Aerothon-2020/Reg2015Aircraft_Aerocats/Documents/Project Management/Design Requirements and Standards.docx

Operational Requirements

1. Take off time limit
  a. 180 seconds (3 min) to accomplish successful take off
  b. Multiple attempts allowed within time limit but aircraft must not become airborne during aborted attempt
2. Take off Zone
  a. Take off into wind
  b. Aircraft must remain on runway during takeoff roll
  c. Must become airborne within 200 ft
3. Competition circuit
  a. Aircraft must complete one 360 deg circuit of field
  b. Stay out of no-fly zones
  c. Fly past departure end of takeoff zone before turning 180 deg
  d. Fly past approach end of takeoff zone before turning 180 deg to begin landing
4. Landing
  a. Controlled return to ground inside landing zone
    i. Controlled rollout allowed
    ii. Controlled runoff allowed
  b. Must land and stop within 400ft

Design Requirements

1. No lighter than air or rotary wing aircraft
  a. Limited to fixed wing
  b. No lighter than air or rotary wing (helicopter/autogyro)
2. Aircraft Dimension Requirement
  a. In takeoff configuration, L+W+H ≤ 175
    i. Length – maximum distance from front to the aft of aircraft
    ii. Width – span or max distance from wingtip to wingtip
    iii. Height – max distance perpendicular to ground to highest part of aircraft (propeller not included)
  b. Gross weight ≤ 55 lbs with payload and fuel
3. Material restriction
  a. Use of fiber-reinforced plastic prohibited
  b. Use of lead is prohibited

System Requirements

1. Electric motor requirements
  a. No restrictions on make or model
  b. Only single motor configuration allowed (no multiple motors)
2. Gear boxes, drives, and shafts
  a. Allowed as long as propeller RPM:engine RPM = 1:1
  b. Prop must rotate at motor RPM
3. Aircraft batteries
  a. Must be commercially available LiPo
  b. Homemade battery not allowed
  c. 6 cell (22.2 volt) LiPo
  d. Must be at least 3000 mah
  e. Must be at least 25C
4. Power limiter
  a. Must use new 2015 1000 watt power limiter
5. Gyroscopic assist prohibited
6. Red arming plug
  a. Use red arming plug to arm and disarm system
  b. Must be in circuit between battery and ESC
  c. Must be physically located 40-60% of A/C length from propeller
  d. Must be located on top of fuselage
  e. Must be external of the A/C surface
7. Payload requirements
  a. Must consist of support assembly and payload plates
  b. All payload must be carried within payload bay
  c. Payload must be carried as homogeneous mass
  d. Payload must be secured to airframe
  e. Total payload consists of plates plus support assembly
  f. Payload bay must be a “closed” payload bay
    i. 4 sides, bottom, and top
    ii. Top can be hatch or wing once installed on A/C
  g. Bay must be fully enclosed within the fuselage
  h. A/C must be structurally airworthy with and without payload bay installed
  i. Payload bay must be removable
  j. “Closed” payload bay dimensions must be 4x4x10 in +1/8, -0
  k. Team must be able to load and secure payload in ≤ 1 min
  l. Team must be able to unload payload in ≤ 1 min
  m. Payload must not contribute to the structural integrity of airframe
  n. Bay must be secured to airframe within cargo bay to avoid shifting in flight
8. Ballast
  a. Ballast must not be located in payload bay
  b. Must be indicated on 2D drawings
  c. Ballast must be secured to avoid shifting in flight
9. General requirements
  a. Radio must be 2.4 GHz
  b. All aircraft must utilize either spinner or rounded safety nut (for prop)
  c. A/C control surfaces must not feature excessive slop
10. Servo sizing
  a. Analysis and/or testing of servos must be described in design report that demonstrates servos selected are adequately sized to handle expected aerodynamic loads during flight

Regular Class Scoring

FFS T Rn Bn Pp Pa | = = = = = = | Final Regular Class Flight Score Penalty Points Round Flight Score (Payload weight – lbs) Payload prediction bonus Payload prediction Actual payload carried

B_n =20-(P_p -P_a )^2

FFS=∑_1^n R_n -∑ T+B_(n (max))

Design Report Requirements

1. Must not exceed 30 pages
  a. Double-spaced
  b. Including appendices, cover page, table of contents, and payload prediction graph
  c. Does not include statement of compliance and 2D CAD drawings
2. Report Format
  a. Must be submitted electronically
  b. Font must be 12 pt proportional or a 10 character per inch non-proportional
  c. Margins must be 1” left, 0.5” right, top, and bottom
  d. All pages must be ANSI A (8.5”x11”) page format
  e. Design report must have cover page with team name, school, and team number (will be counted against 30 page limit)
  f. File must be in PDF format
3. Design Plans requirements (CAD)
  a. Must be ANSI B size (11”x17”)
  b. Must be PDF format
  c. Must be on one page
  d. Must have US-standard 3-view or 3rd order projection
    i. Right side view in lower left with nose pointing right
    ii. Top view above the right side view also with nose pointing right
    iii. Front view in lower right
  e. All A/C must have the required dimensions clearly marked and dimensioned on drawing
    i. Length
    ii. Width
    iii. Height
    iv. CG location
    v. Main wheel diameter
  f. All dimensions must be in inches and decimal inches to an appropriate level of precision (4 decimal places is too many)
  g. Plans must also include table with summary of pertinent A/C data
    i. Wingspan
    ii. Empty weight
    iii. Motor/engine make and model
  h. Plans must also include weight and balance table with a summary of pertinent A/C data
    i. Motor/engine
    ii. Battery
    iii. Payload
    iv. Ballast
    v. Location from datum in inches
    vi. Moment arm
    vii. Resultant moment of CG
  i. Must be marked on drawing
    i. A/C datum
    ii. Forward CG limit
    iii. Aft CG limit
    iv. Empty weight CG (weight and balance worksheet should correspond with static margins on 2D drawings)
  j. Plans must be marked with team name, school name, and team number
4. Payload prediction curve requirements
  a. Must be included with design report (counts against 30 page limit)
  b. One electronic copy of the payload prediction “EQUATION ONLY” must be provided on face of 2D drawing
  c. Page must be 8.5”x11” ANSI A in PDF format
  d. Must be marked with team name and school across top of the graph with team number marked in the bottom right corner
  e. Graph must include formula used to calculate the curve
  f. The curve must present the payload capacity of the A/C in pounds as a function of density altitude in feet

Technical Presentation

1. Each team must give 10 minute technical presentation of design (exceed 15 min = -5 points)
2. The presentation must be the same information provided in the design report in oral form
3. Must give detailed explanation of why A/C is best and how that conclusion was made
4. A/C must be present at the oral presentation
5. Must demonstrate capabilities to quickly load/secure and unload payload
6. Teams must provide a single sheet (8.5”x11”) marketing/promotion piece to further detail A/C feature, capabilities, and unique design attributes
