Aerothon-2020/Reg2015Aircraft_Aerocats/Controls/SnC_10-14-14.pptx

## Stability and Controls

10-14-14

## Aircraft Changes

- Wing moved back
- Htail NACA0012
- With S increased by 50 in²
  - Payload = 32 lbs
  - Ground roll < 200 ft
- CG within static margin

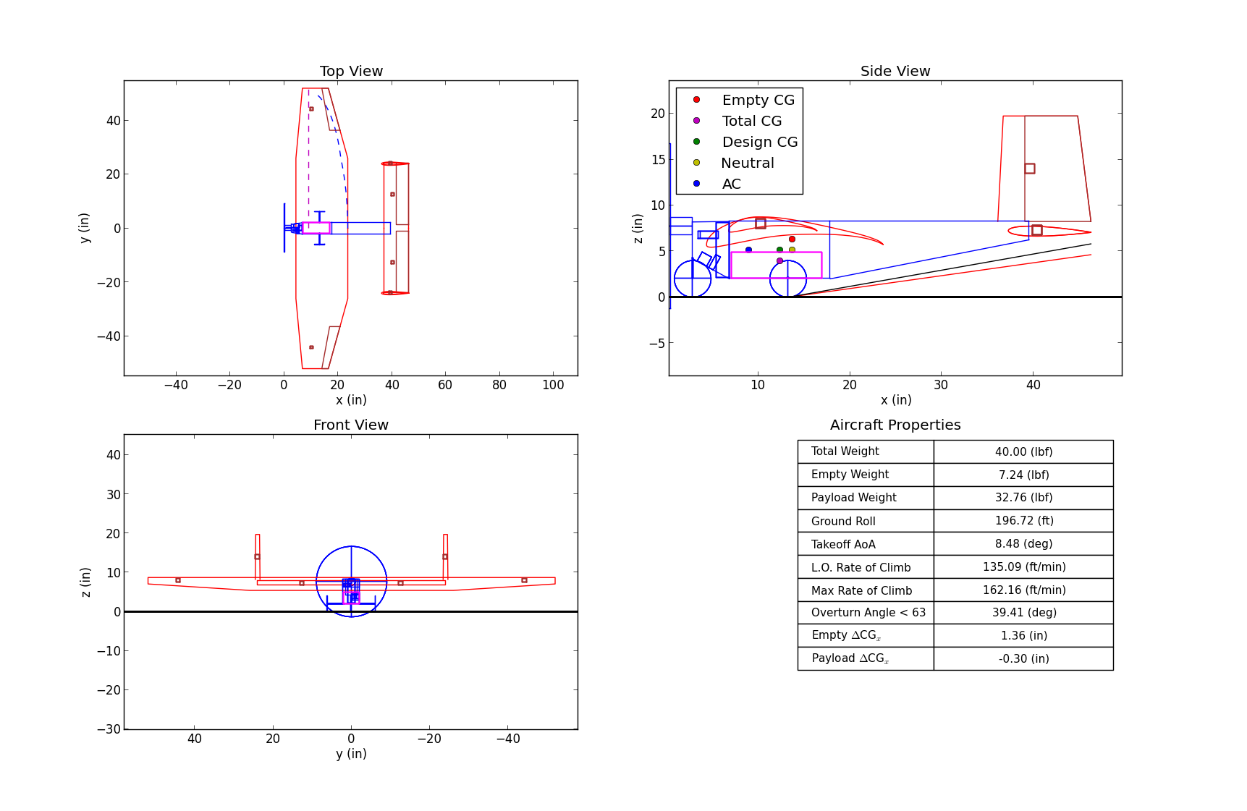
[picture p3: figure]

## Dynamic Derivatives

- All aerodynamic derivatives stable
- Except spiral mode
  - Calculated with 0 dihedral
  - Previous years estimated that there would be enough dihedral on wing to stabilize the spiral mode
- Reduced overall pitching moment

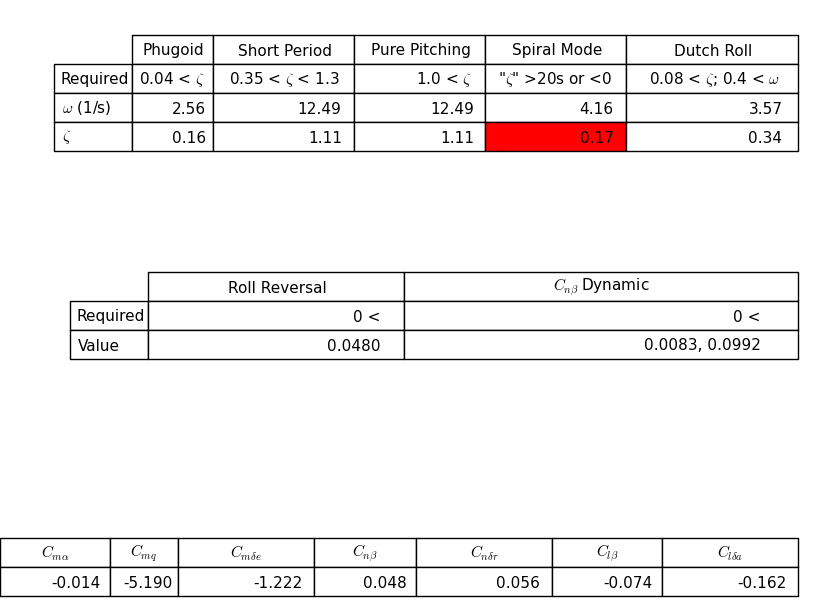
[picture p4: figure]

## Aileron and Rudder

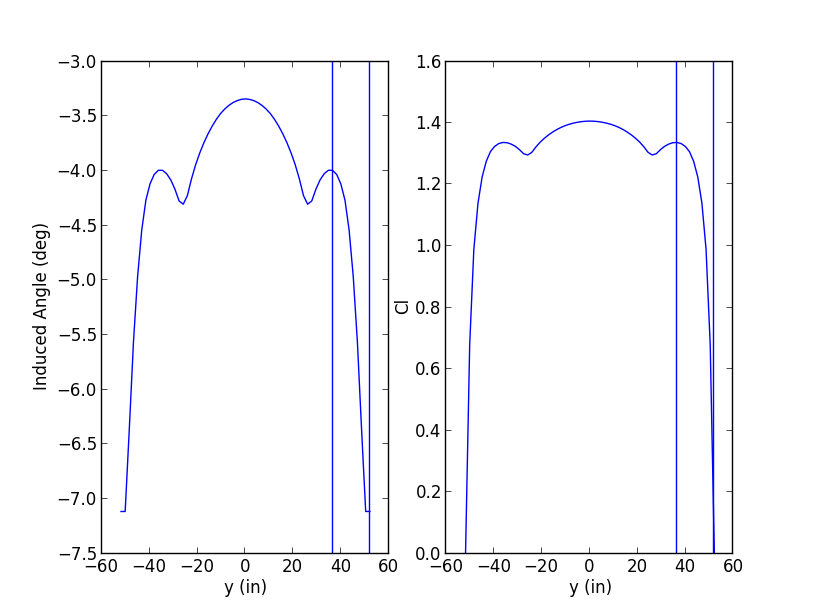
[picture p5: figure]
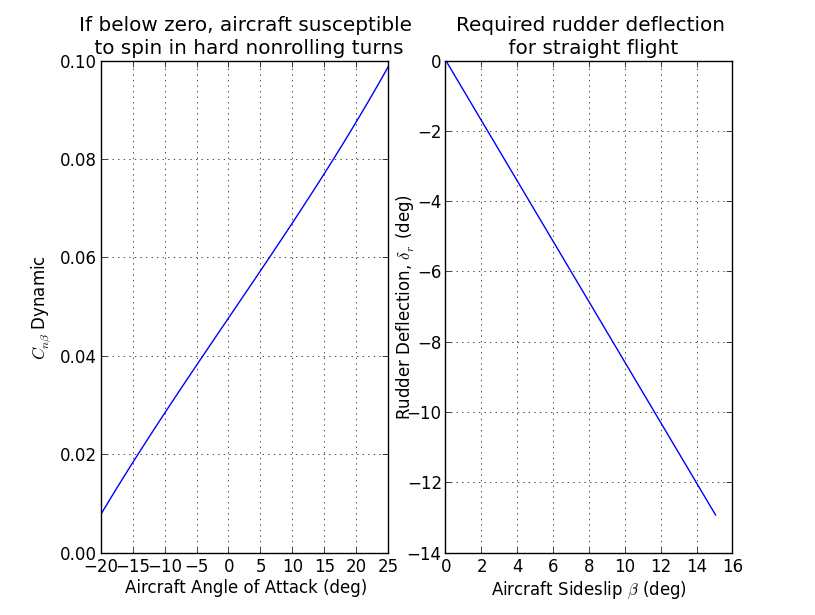
[picture p6: figure]

## Marshall Says…

- There is a way to change the main gear shape to a bent shape
  - MainGear.Theta
- Add height to the fuselage possibly instead of adding height with the gear
  - Might be more stable and the straight gear is easier to manufacture
