Aerothon-2020/Reg2015Aircraft_Aerocats/Controls/Stability_and_Controls_10-2-14.pptx

## Stability and Controls and Other Stuff

## Potential Changes to Aircraft

- Lower motor mount height
- Raise aircraft ground roll height
- Increase horizontal tail chord
- Increase elevator chord
- Lower wing into fuselage
- Move wing aft to move static margin
- Decrease static margin to 10% (to start)

## Slide 3

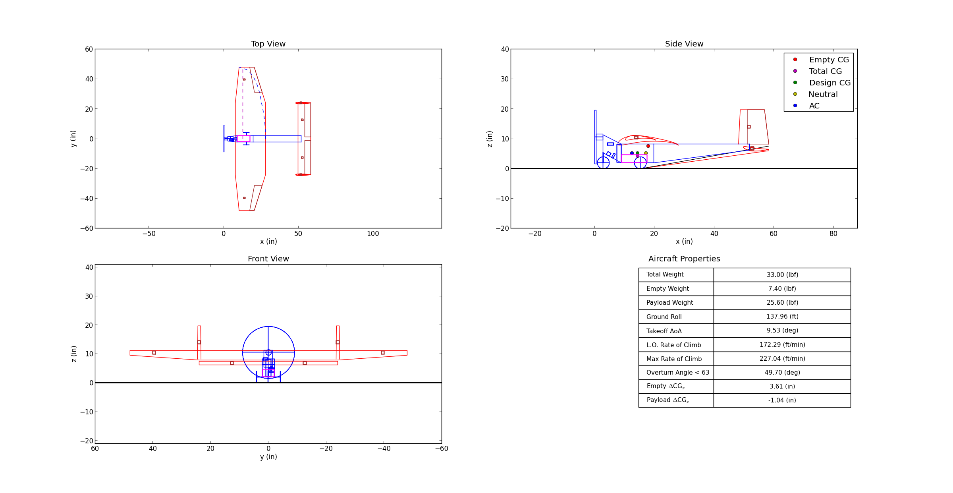
[picture p7: figure]
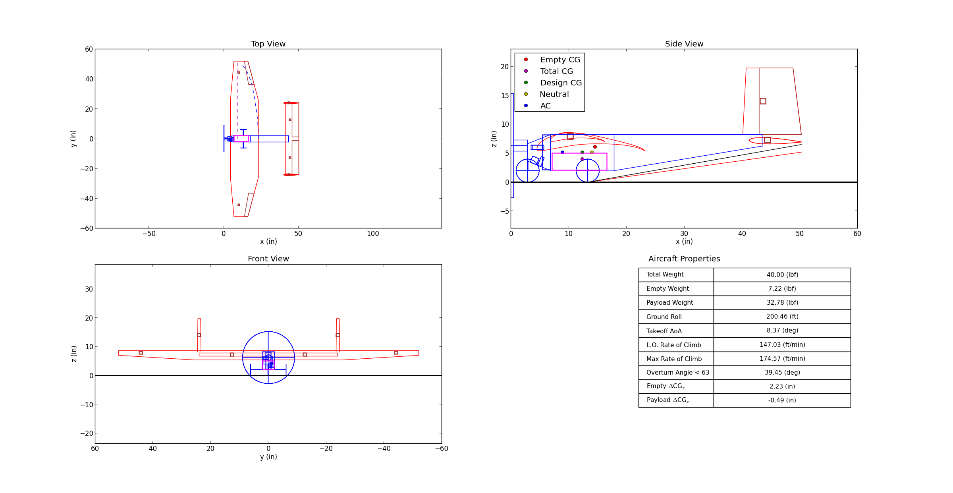
[picture p8: figure]

## Slide 4

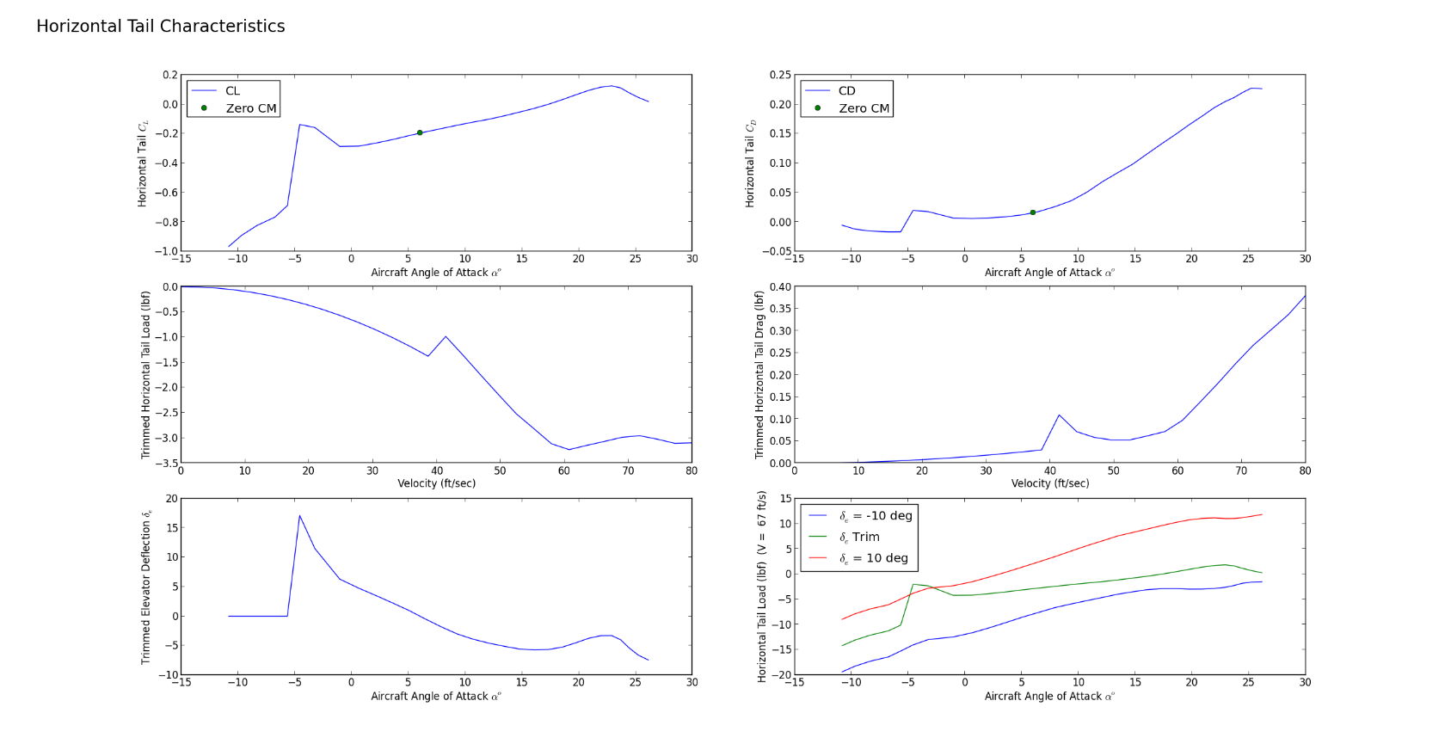
[picture p9: figure]
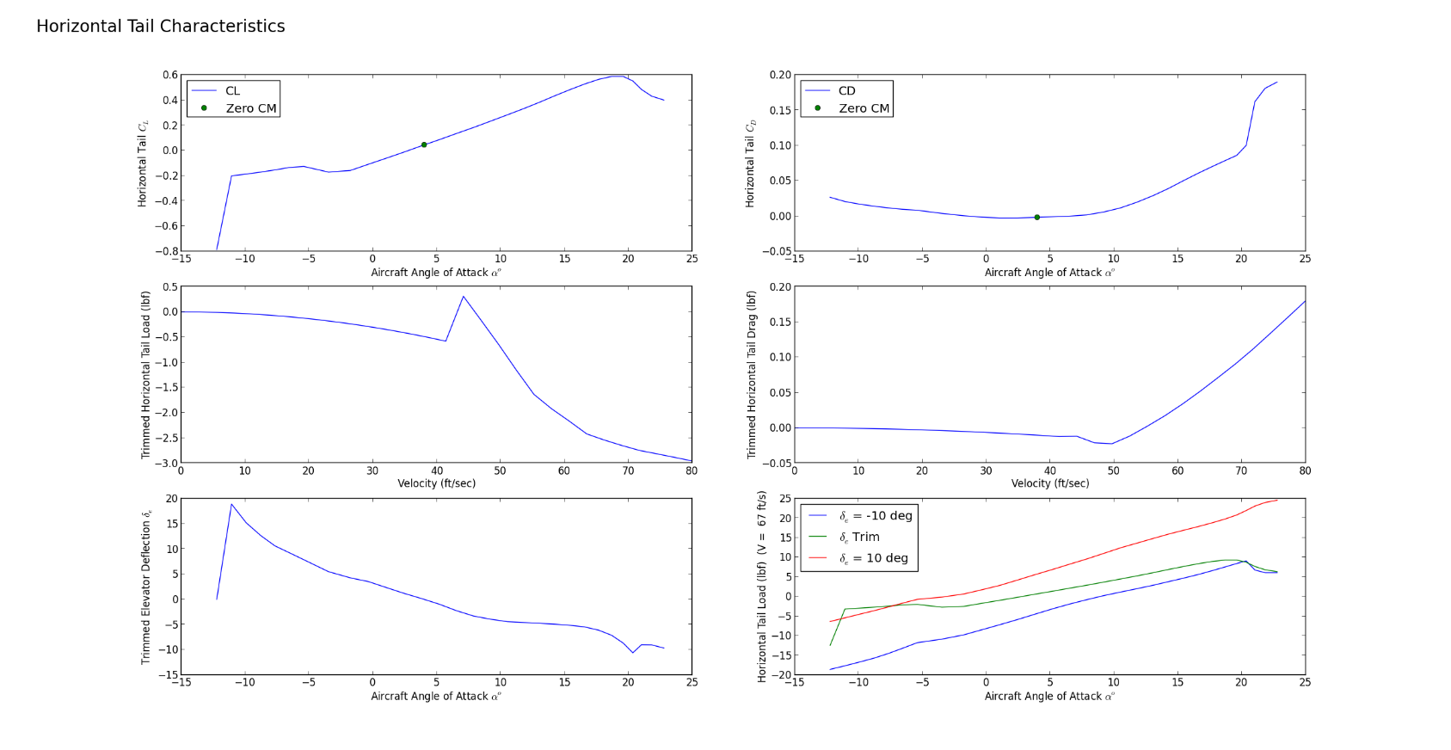
[picture p10: figure]

## Aerodynamic Derivatives

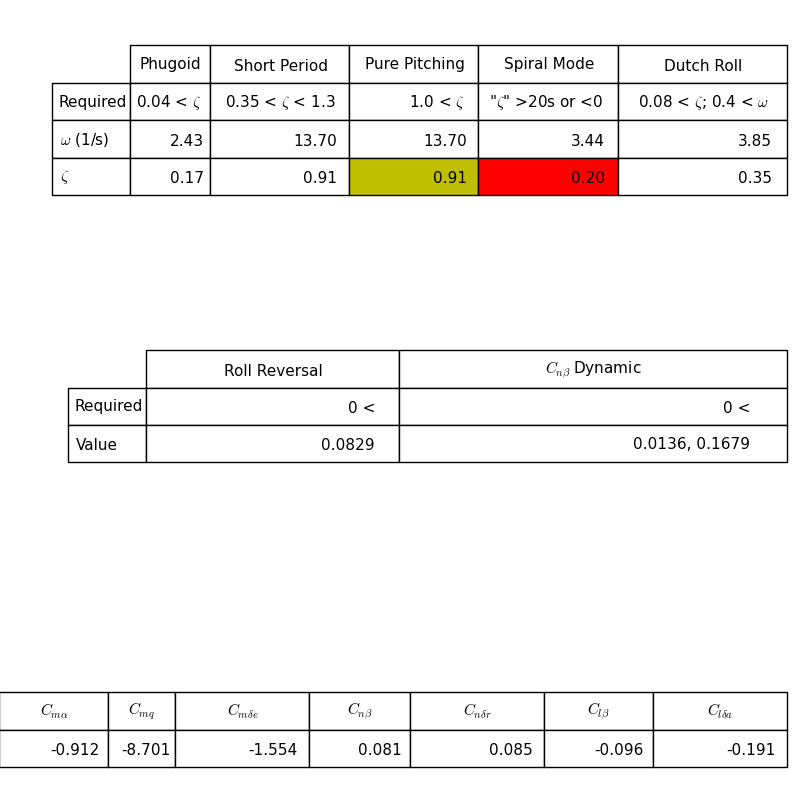
[picture p11: figure]
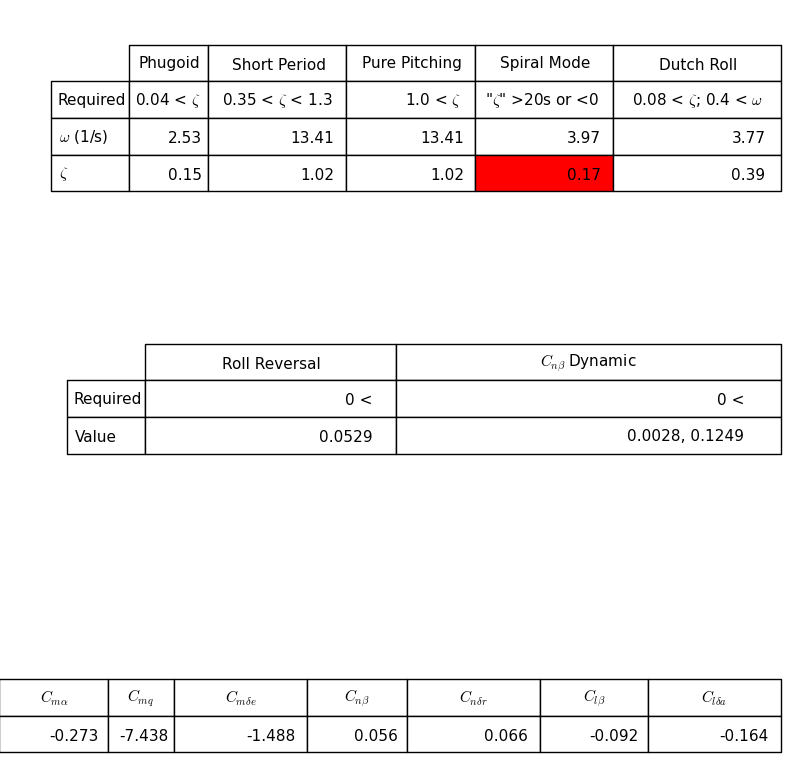
[picture p12: figure]

## What these changes require

- Structures and CAD groups incorporating into overall aircraft design
  - Spar through fuselage?
  - Landing gear raised?
- Aerodynamics group incorporating into wing design
  - Taper
  - Effect on CG
  - Main gear axle placement

## Next

- Control surface sizing
- Control surface placement
- Servo Sizing
