Aerothon-2020/Reg2015Aircraft_Aerocats/Propulsion/MotorComparison_w_Props/MotorComparison_18x8E_Prop.pptx

## Motor Comparison

APC 18 x 8E

## Slide 2

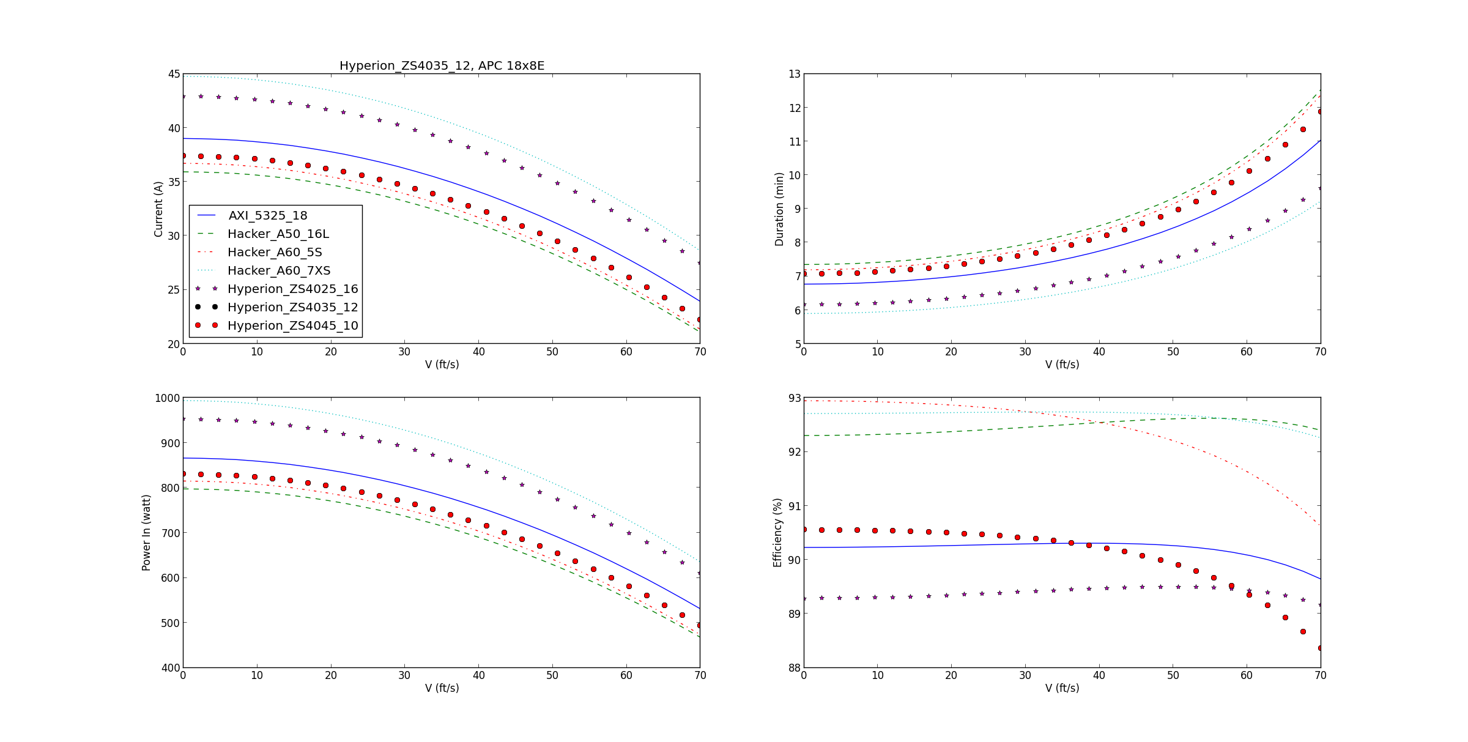
[picture p13: figure]

Engine Power Draw

4 min minimum requirement

Acceptable

Ideal Power Draw

Typical VLO Range

Notes: Where did the 4 minute minimum requirement come from? Past data? Santiago?

## Slide 3

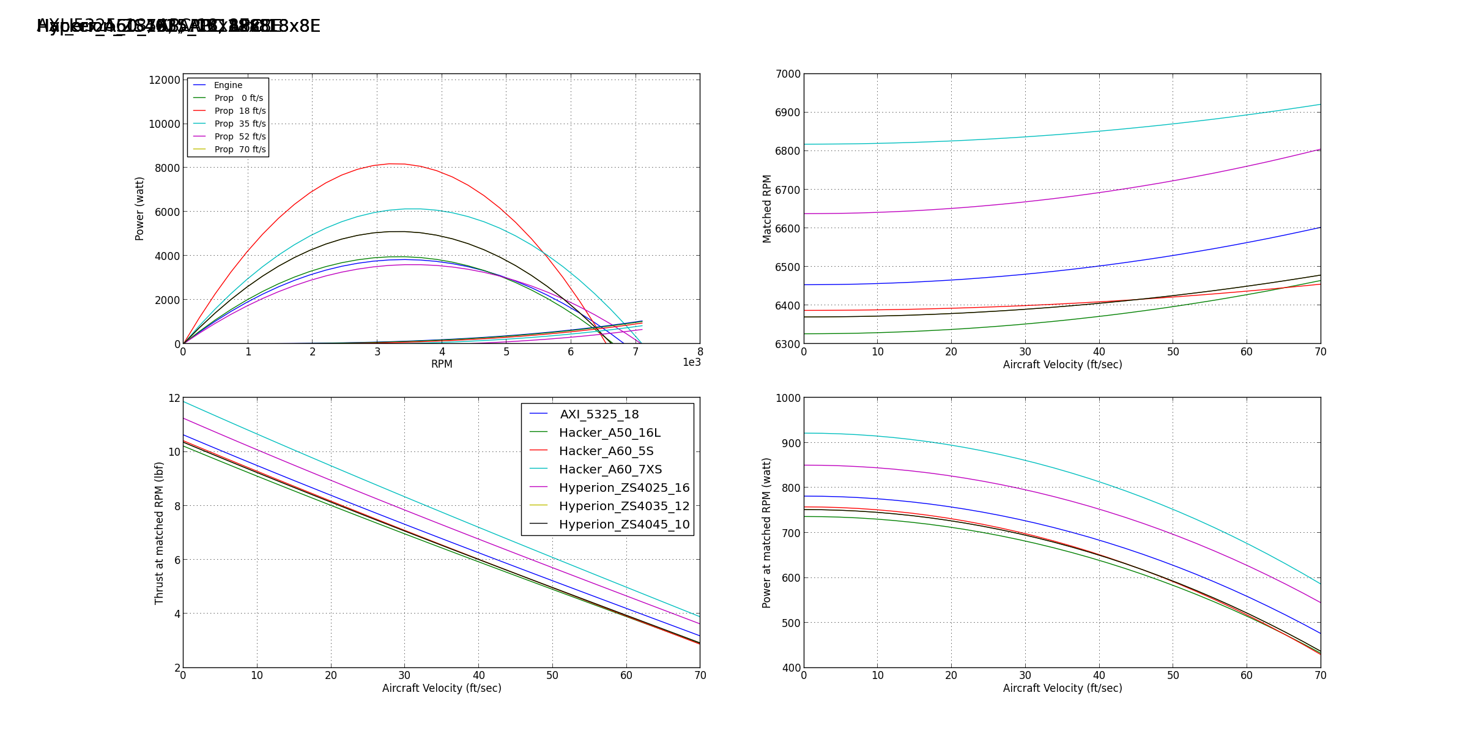
[picture p14: figure]

Relatively large split in thrust value between 7XS and 5S

Engine Thrust

Notes: How does this Hacker A60_7XS compare to last year’s selected motor and prop combination?

## Slide 4

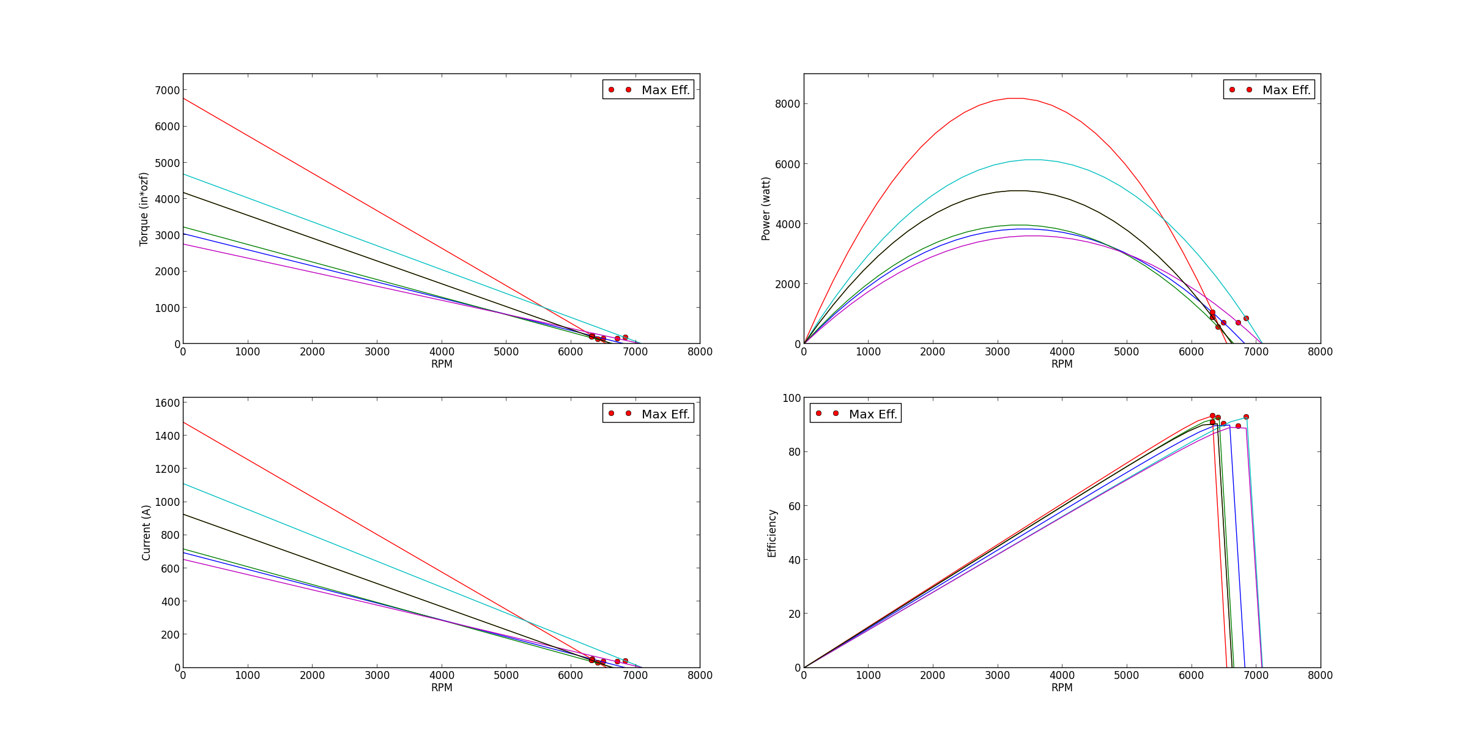
[picture p15: figure]

Torque and Efficiency

Hacker A60 5S

Hacker A60 7XS

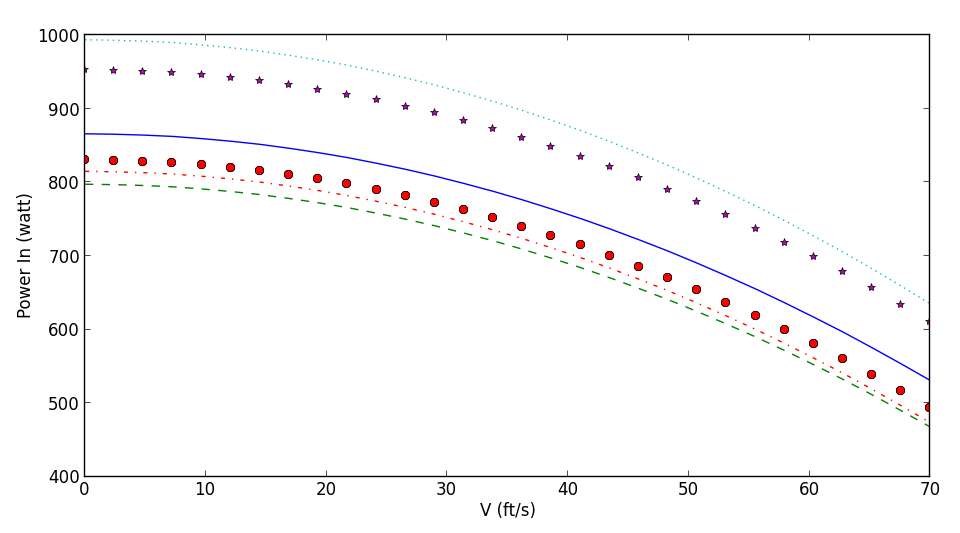
[picture p16: figure]

Hacker A60 5S

Hacker A60 7XS …..

From Slide 1

## Slide 5

- Hacker A60 7XS
  - Highest Thrust – 12 lbf
  - Lower Torque – 4700 in*ozf
  - Power draw near 1000 W
  - 480 grams
- Hacker A60 5S
  - Lower Thrust – 10 lbf
  - Higher Torque – 6900 in*ozf
  - Power draw near 825 W
  - 595 grams

18x8E Summary
