Aerothon-2020/Reg2015Aircraft_Aerocats/Aerodynamics/Presentations/AClemens_9_30_14.pptx

## Aerodynamics Trade Study Sweep, Taper Ratios, and Fb

Andrew Clemens
9/30/14

## Purpose

- Investigate effects of altering taper ratio, wing sweep, and the location where taper ratio begins.

## Slide 3

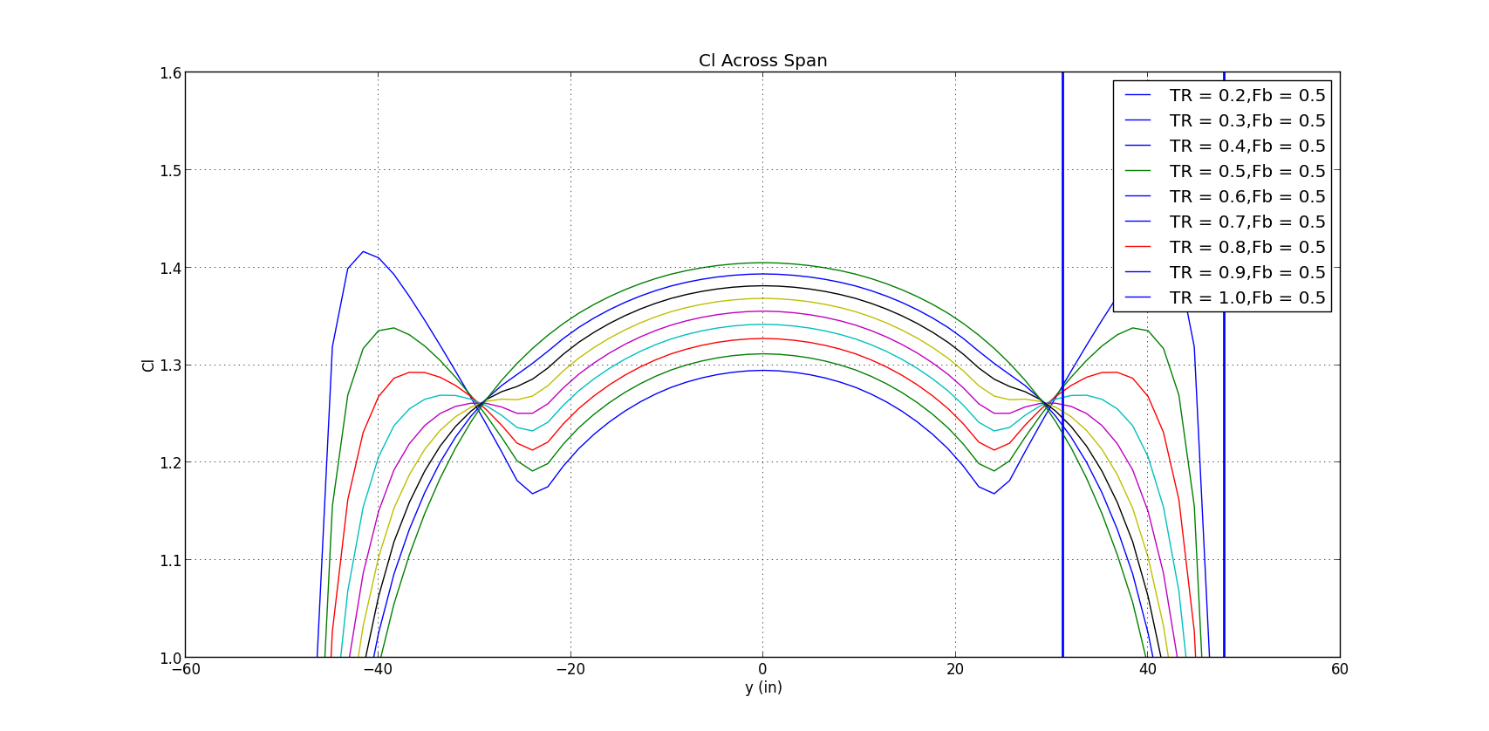
[picture p30: figure]

Taper Ratio Sweep
0.2 → 1.0 step size = 0.1
Outside peaks closest to center peak when taper ratio is 0.385

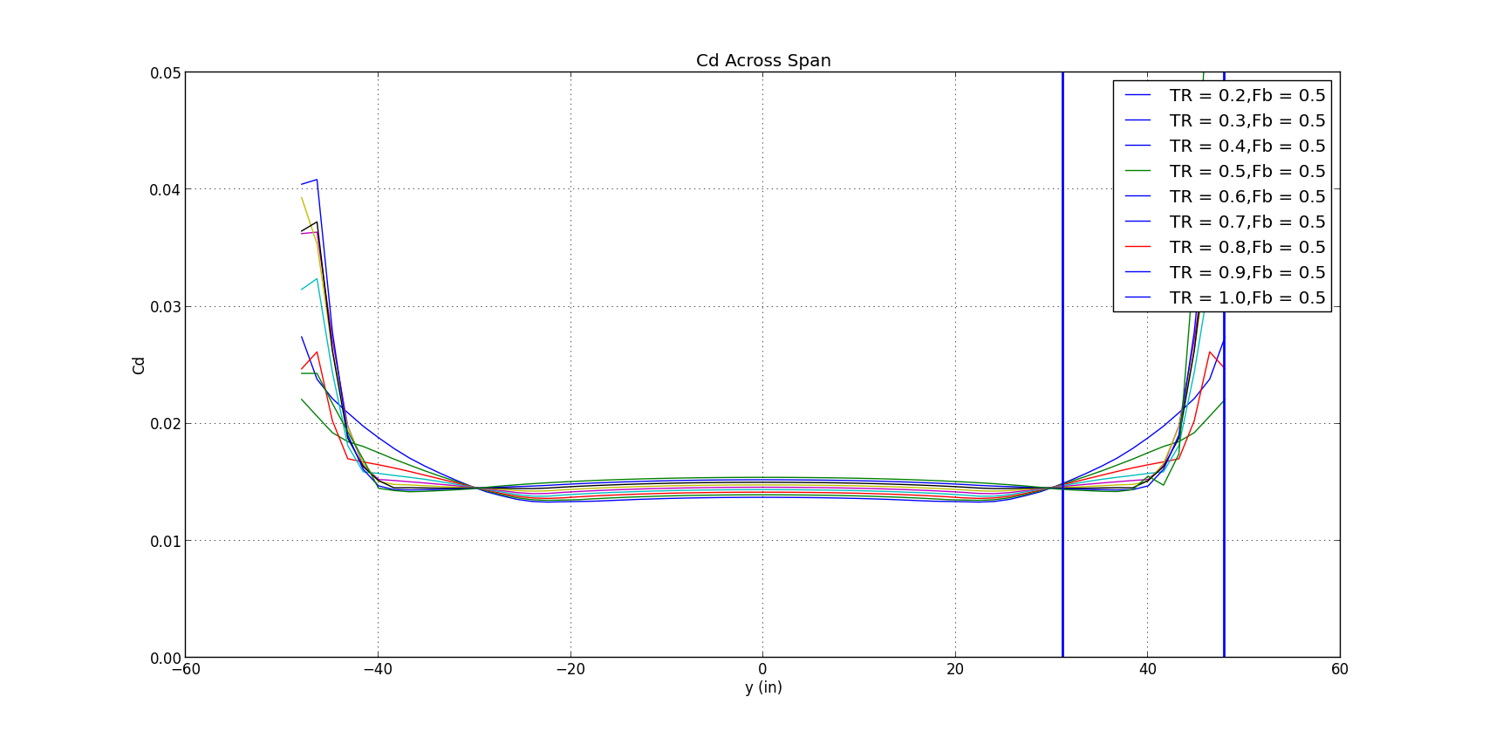
[picture p31: figure]

“Pinch” – due to change of rectangular to tapered

## Slide 4

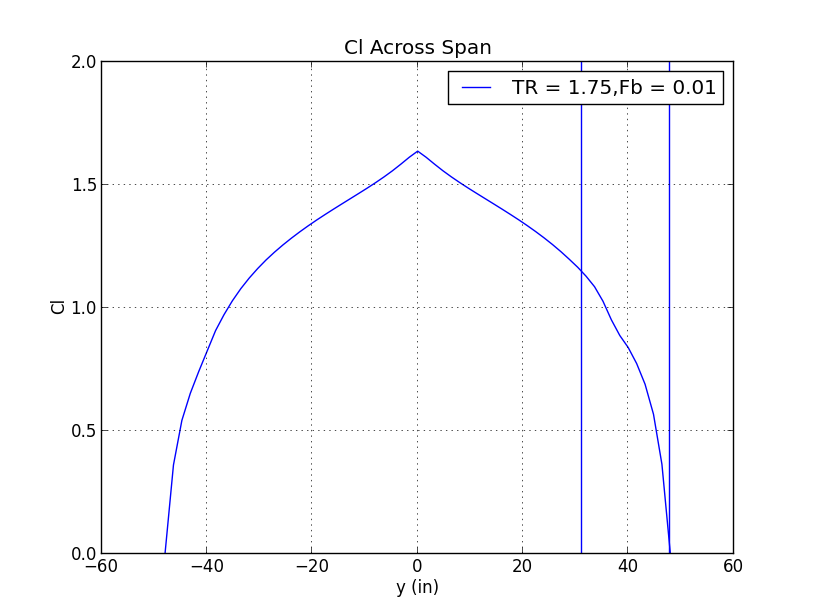
[picture p32: figure]

Not recommended

## Slide 5

Taper Ratio Starting Location Sweep
0.2 → 0.8 step size = 0.1
Outside peaks closest to center peak when taper ratio is 0.385

Obtain balance between wingtip and root lift

## Slide 6

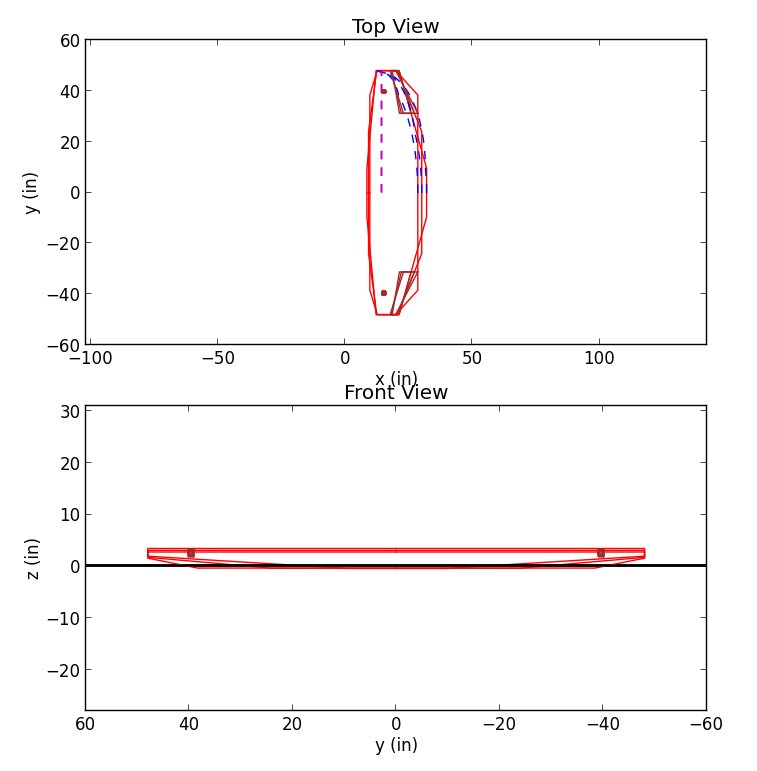
[picture p33: figure]

Code accounts for TR in X, Y, & Z

Taper Ratio Starting Location Sweep

## Slide 7

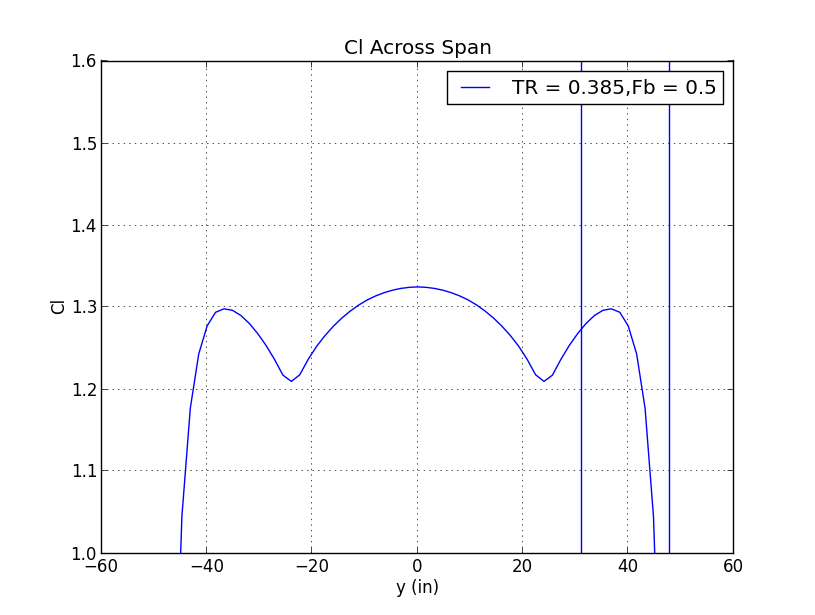
[picture p34: figure]

-15°, 0°, 15° Wing Sweep

Sweep does not affect Cl

## Slide 8

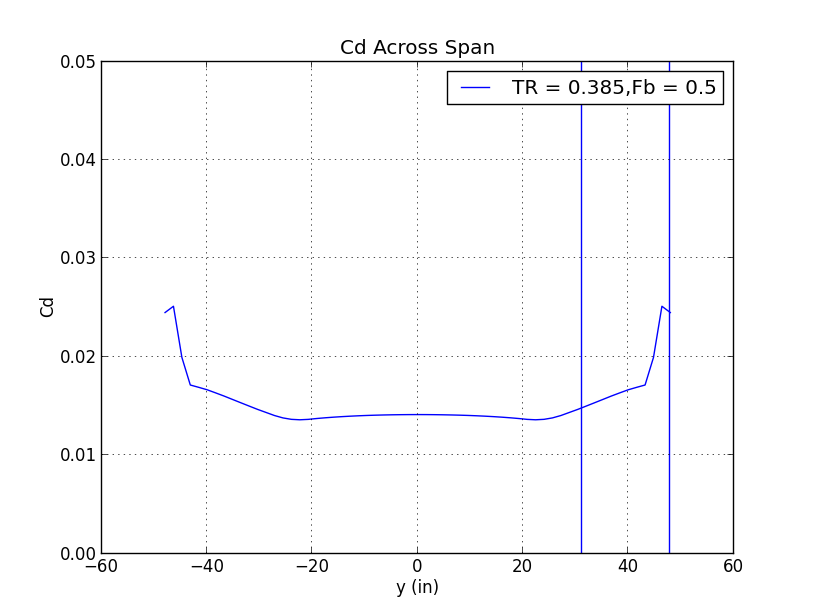
[picture p35: figure]

-15°, 0°, 15° Wing Sweep

Sweep does not affect Cd
