Aerothon-2020/Reg2015Aircraft_Aerocats/Aerodynamics/Presentations/AClemens_JKeller_9_30_14.pptx

## Design Approach for Aerodynamics and Overall Impact

Jacob Keller
9/30/14

## Purpose

- Develop design approach that estimates critical performance parameters that have been dictated by various requirements, such as, maximum weight, overall dimensions, available power, and ground roll.
  - Provides a starting point from which aerodynamics (and others) can begin a detailed analysis (optimization).
  - Big picture approach where the impact of design changes (estimates) can be investigated/examined.
- Design approach compliments the conceptual design phase, where aerodynamics, propulsion, and performance are the major drivers.

## Design Approach

1. Requirements

2. First Weight Estimate

3. Critical Performance Parameters
a. Maximum Lift Coefficient
b. Lift-to-Drag Ratio
c. Wing Loading
d. Thrust-to-Weight Ratio

4. Configuration Layout (overall shape)

Iterate

5. Better Weight Estimate

6. Performance Analysis
Does the design meet or exceed requirements?

7. Optimization – Achieve Best Design

No

Yes

## 1. Requirements

1. Maximum Weight ≤ 55 lbs
2. L+W+H ≤ 175 inches
3. Ground Roll ≤ 200 feet
4. Maximum Power ≤ 1000 W

## 2. First Weight Estimate

- Crude Estimate of GTOW:
  - W_0 =(W_(payload))/(1 − (W_(fuel))/(W_0) − (W_(empty))/(W_0))
- Plot (W_(fuel))/(W_0) and (W_(empty))/(W_0) vs W_(payload) or W_0 for past aircraft models to obtain reasonable estimate
  - What is our goal for W_(payload) ?

## Slide 6

- Initial Airfoil Shape: S1223
  - Used on high lift model airplanes
  - Will be optimized later, however, initially we will make an estimate for the maximum lift coefficient based on the unmodified S1223 airfoil
- First Approximation of ( C_L )_(max) :
  - ( C_L )_(max) = [((C_l )_(tip) +(C_l )_(root))/2+∆(C_l )_(flap) ]×F_(3D)
    - (C_l )_(tip) is two-dimensional lift coefficient at the wing tip
    - (C_l )_(root) is two-dimensional lift coefficient at the wring root
    - ∆(C_l )_(flap) is change in maximum lift coefficient due to flap deflection
    - F_(3D) is conversion from the two-dimensional lift coefficient to the three dimensional lift coefficient (between 0.9 and 1.0).
  - Note: It is advantageous to have the airfoil thickness at the tip be smaller than at the root to encourage root stall before tip stall (aileron control). Additionally, washout should be investigated for the same purpose ( α_(tip) >α_(root) ) .

## Slide 7

- Wing loading is usually determined by the stalling velocity, which we can approximate based on past aircraft models.
- First Approximation for Wing Loading:
  - W/S= 1/2ρ_(∞) (V_(stall) )^2 (C_L )_(max)
  - V_(stall) ≈ (V_(lift off))/1.1
- Plot V_(lift off) vs wing loading or GTOW for past aircraft models
  - Get an approximation for V_(lift off)
- Calculate the Planform Area, S:
  - S= W_0 (W/S)^(−1)

## Slide 8

- Thrust-to-Weight Ratio determines the take-off distance, rate of climb, and maximum velocity. Since we are restricted by the take-off distance, we can approximate the required Thrust-to-Weight Ratio by:
  - (T/W)_(0.7V_(lift off)) = (1.21(W/S))/(gρ_(∞) (C_L )_(max) (S_g ))
  - Note: This T/W is that at which the free-stream velocity is approximately equal to 0.7 ×V_(lift off) , as indicated in the equation above (thrust varies with velocity)
- Note: There are some assumptions built into this equation, more specifically, that the T is much larger than D+ μ_r (W−L) . The next slide ignores this assumption.

## Slide 9

- As mentioned on the previous slide, T/W determines the take-off distance, which the can be found with no assumptions by:
  - S_g = 1/(2gK_A)ln[1+(K_A)/(K_T)(V_(lift off) )^2 ]+NV_(lift off) where K_T and K_A are defined as follows:
  - K_T = T/W − μ_r
  - K_A =−(ρ_(∞))/(2(W/S))[C_(D,0) +∆C_(D,0) +(k_1 +G/(πeAR))(C_L )^2 −μ_r C_L ] where G is defined as follows:
    - G= (C_(Di) (in−ground effect))/(C_(Di) (out−of−ground effect))= ((16h/b)^2)/(1+(16h/b)^2)
    - k_1 is a proportionality constant associated with the increment in parasitic drag due to lift
    - C_(D,0) is the zero-lift drag coefficient ( ∆C_(D,0) is associated with extended landing gear: Assume C_(D,0) is one value)
    - μ_r is coefficient of rolling friction
    - N = 1 for small aircraft (model aircraft) (N V_(lift off) is associated with ground covered during rotation phase, i.e., this may be neglected)
- This forms a system of equations that can be solved for two important parameters, namely, the wing span and the T/W.
  - Different Aspect Ratios will provide different values for T/W (assuming all other parameters are constant)
  - This assumption may be valid for large aspect ratios (AR > 6), where the change in induced drag coefficient due to increasing AR may be considered negligible

## Slide 10

- The zero-lift drag coefficient can be estimated in XFLR5, however, that requires a geometric shape, which we have not developed yet. Thus, the following equation provides an estimate for the zero-lift drag coefficient (this will probably be an iterative process since the power required to take-off is not yet known):
  - C_(D,0) =C_D −C_(D,i) where C_D and C_(D,i) can be approximated by:
  - C_D = (550η(P))/(1/2ρ_0 [σS(1.47×V_(∞) )^3 ])
  - C_(D,i) = ((C_L )^2)/(πeAR)

## 4. Configuration Layout (Aerodynamics)

1. Wing:
  i. Geometric twist
  ii. Taper ratio
  iii. Variation in airfoil thickness
  iv. High-wing, mid-wing, low-wing
2. Fuselage:
  i. Smooth changes in cross-sectional areas

## 4. Configuration Layout (General)

1. Stability and Control:
  - Iterative process with aerodynamics group in determining if enough length is available for stability.
2. Structures:
  - Are the suggestions by aerodynamics achievable (structurally safe, possible to build, etc.)?

## 5. Better Weight Estimate

- Use all the above information to calculate the approximate GTOW (estimate weight of wings, motor, fuselage, landing gear, etc.)
- Use all the above information to estimate the center of gravity

## 6. Performance Analysis

- We’ve already insured two requirements were met, i.e., the maximum ground roll and L+W+H (dimensional limitations).
- Next is determining if we have the power available to take-off, which is given by:
  - P_(req) = (P_(take−off))/(η_(pr))= 1/(η_(pr))T/WW_0 V_(∞) ≤(1000 Watts)×P_(S.F.) where V_(∞) is:
  - V_(∞) ≈(0.7)(V_(lift off) )≈(0.7)(1.1)(V_(stall) )
  - P_(S.F.) is a safety factor to ensure that 1000 Watts is never reached
- If P_(req) is too low or too high, adjustments can be made to the following parameters:
  - Payload
  - (C_L )_(max)
  - Wing loading
  - η_(pr)

## 7. Optimization (Aerodynamics)

- Optimize Aerodynamics Performance
  - Wing, airfoil, and fuselage

## Aerodynamics Trade Study Sweep, Taper Ratios, and Fb

Andrew Clemens
9/30/14

## Purpose

- Investigate effects of altering taper ratio, wing sweep, and the location where taper ratio begins.

## Slide 18


Taper Ratio Sweep
0.2 → 1.0 step size = 0.1
Outside peaks closest to center peak when taper ratio is 0.385


“Pinch” – due to change of rectangular to tapered

## Slide 19


Not recommended

## Slide 20

Taper Ratio Starting Location Sweep
0.2 → 0.8 step size = 0.1
Outside peaks closest to center peak when taper ratio is 0.385

Obtain balance between wingtip and root lift

## Slide 21


Code accounts for TR in X, Y, & Z

Taper Ratio Starting Location Sweep

## Slide 22


-15°, 0°, 15° Wing Sweep

Sweep does not affect Cl

## Slide 23


-15°, 0°, 15° Wing Sweep

Sweep does not affect Cd

## Airfoil Selection

## Airfoil Requirements

- High lift (CL > 2)
- Intended for low Reynolds numbers
  - Competition Re ~405000

## Airfoil Comparison

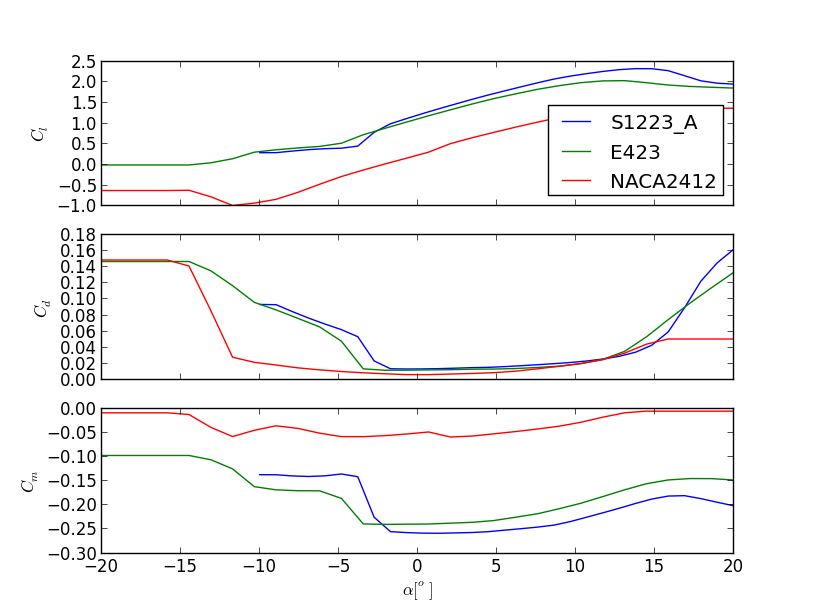
[picture p36: figure]
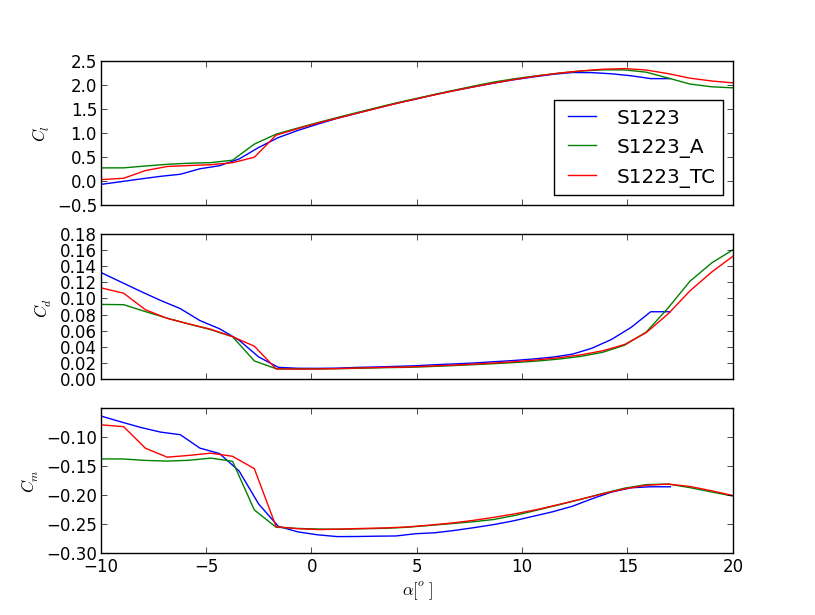
[picture p37: figure]

## Attemped Reoptimization

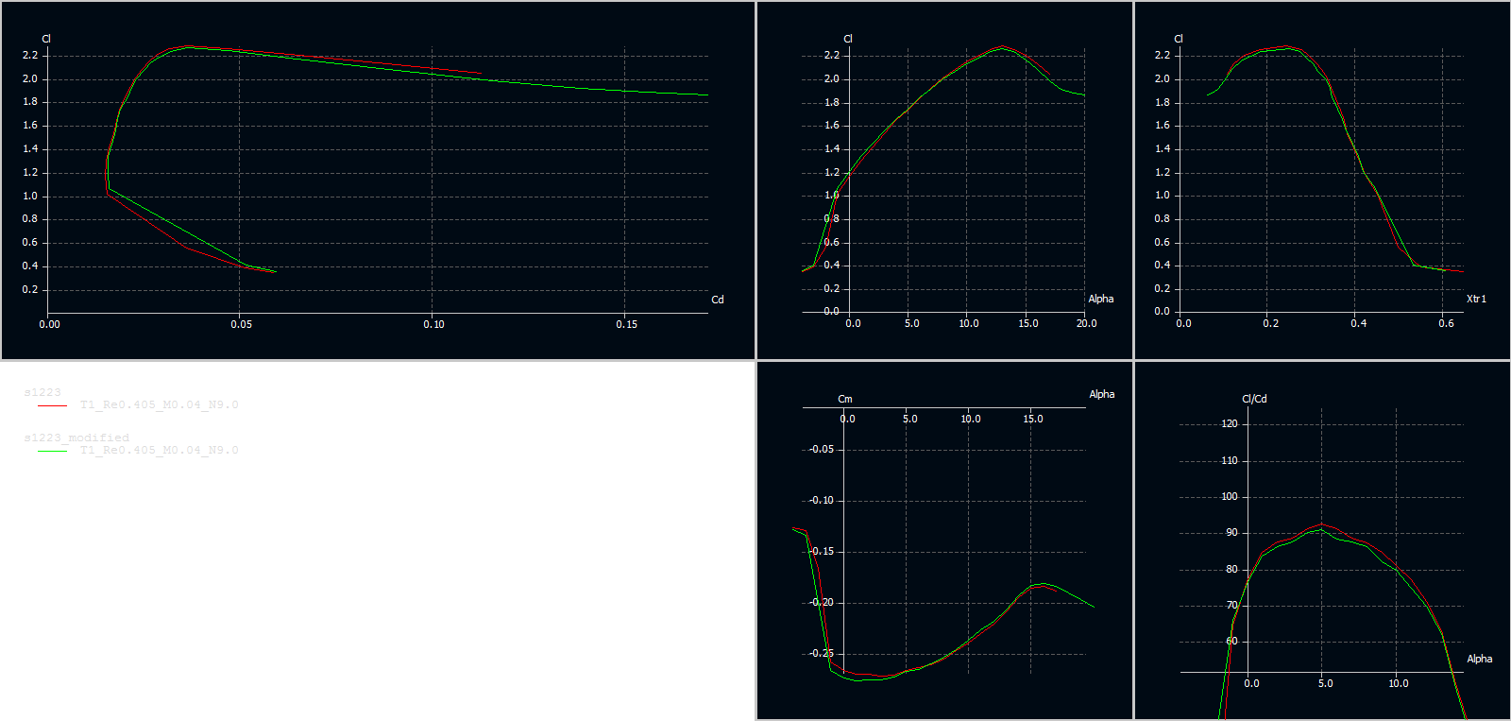
[picture p38: figure]

## Polars for Aircraft Redesign

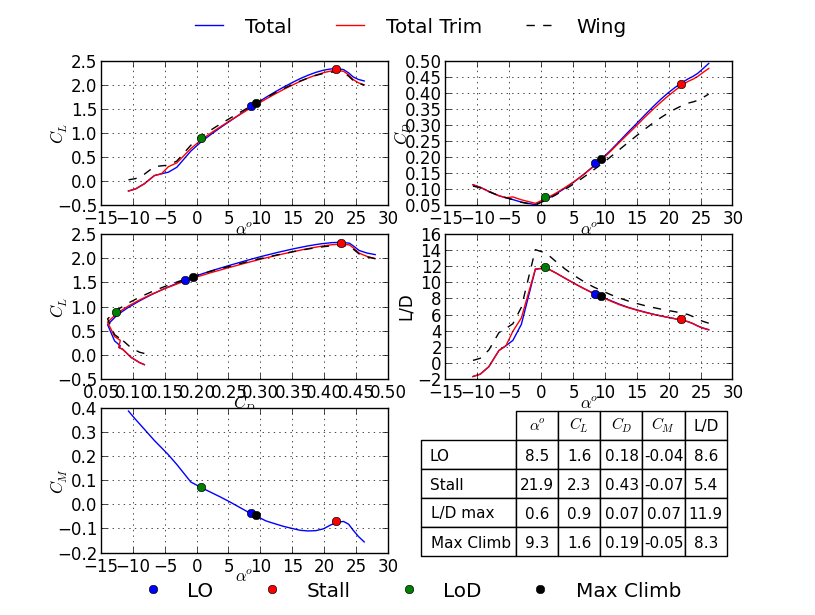
[picture p39: figure]
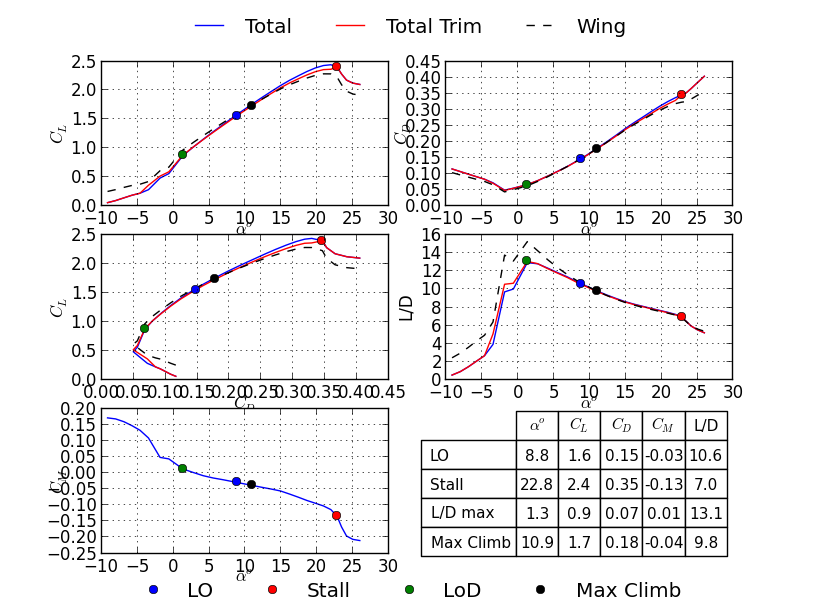
[picture p40: figure]
