Aerothon-2020/Reg2015Aircraft_Aerocats/Documents/Project Management/Design Project Plan.xlsx

AeroCats Design Schedule
 |  |  |  |  |  |  | Week Highlight: |  |  |  |  | 5 |  |  |  | Plan |  |  | Actual |  |  |  | % Complete |  |  |  |  | Actual (beyond plan) |  |  |  |  |  |  |  | % Complete (beyond plan)
 | PLAN | PLAN | ACTUAL | ACTUAL | PERCENT |  |  | Sept |  |  |  | Oct |  |  |  |  | Nov |  |  |  | Dec |  |  |  | Jan |  |  |  |  | Feb |  |  |  | Mar
ACTIVITY | START | DURATION | START | DURATION | COMPLETE
 |  |  |  |  |  | WEEK | 1 | 2 | 3 | 4 | 5 | 6 | 7 | 8 | 9 | 10 | 11 | 12 | 13 | 14 | 15 | 16 | 17 | 18 | 19 | 20 | 21 | 22 | 23 | 24 | 25 | 26 | 27 | 28 | 29 | 30 | 31 | 32
Division of Labor | 2 | 2 | 3 | 2 | 100%
Project Team Formation | 3 | 1 | 3 | 2 | 100%
Basic Design Overview | 3 | 2 | 3 | 1 | 75%
Init. Planning/Organization | 4 | 2 | 4 | 2 | 75%
Propulsion: Motor/Prop Modeling | 3 | 2 | 4 | 3 | 50%
Aerodynamics: Airfoil Selection | 4 | 2 | 5 | 2 | 10%
Aerodynamics: Wing Design | 4 | 3 | 5 | 3 | 10%
Aerodynamics: Tail Design | 5 | 2 | 5 | 2 | 10%
Performance: Wing Size Trade Study | 5 | 3 | 6 | 3 | 0%
Performance: Ground Roll Trade Study | 5 | 3 | 6 | 3 | 0%
Stab/Controls: Control Surface Design | 5 | 2 | 6 | 2 | 0%
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
