Aerothon-2020/Reg2015Aircraft_Aerocats/Report_PostSubmission/Payload_Prediction_FINAL_PostSubmission.pdf

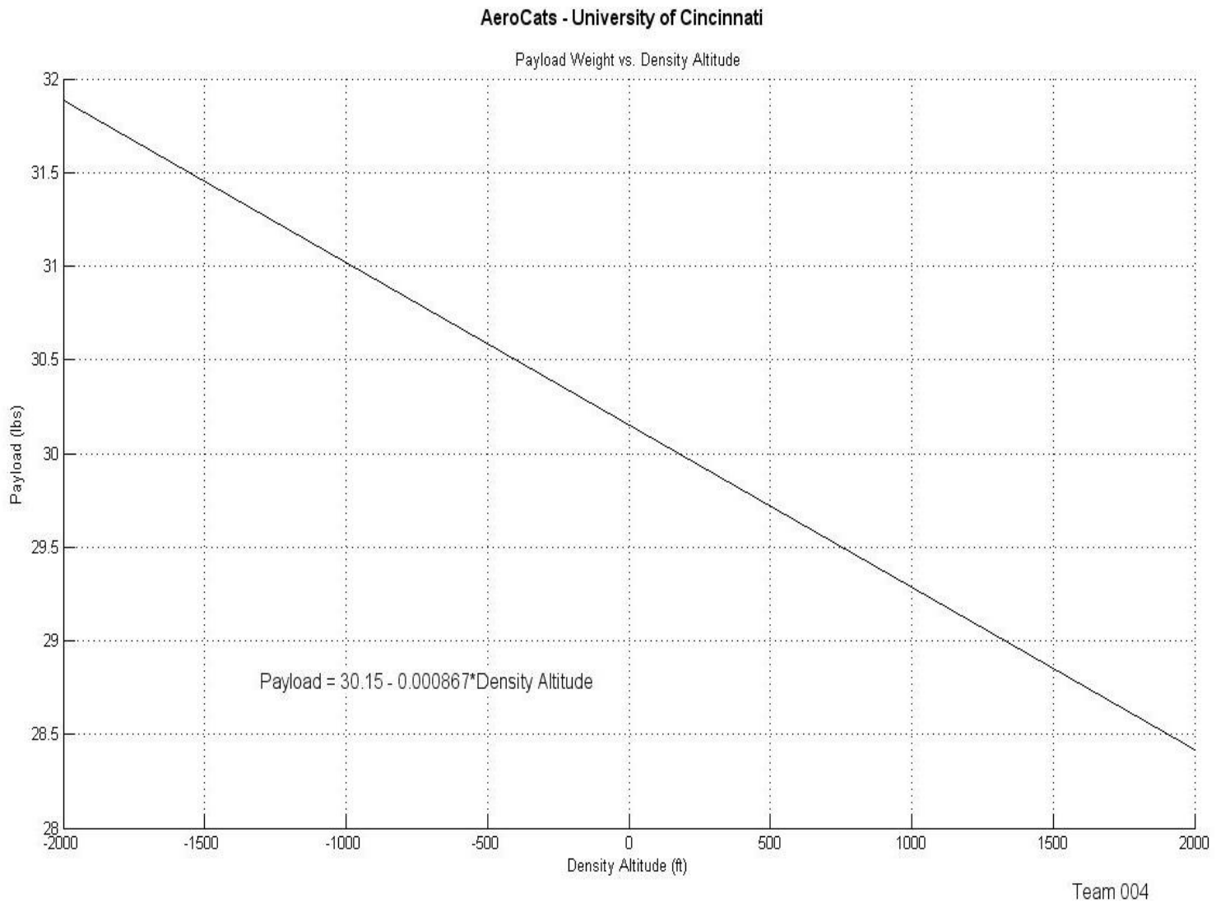
[picture p41: page 1]
