Aerothon-2020/Reg2015Aircraft_Aerocats/Report_PostSubmission/StatementOfCompliance_signed.compressed.pdf

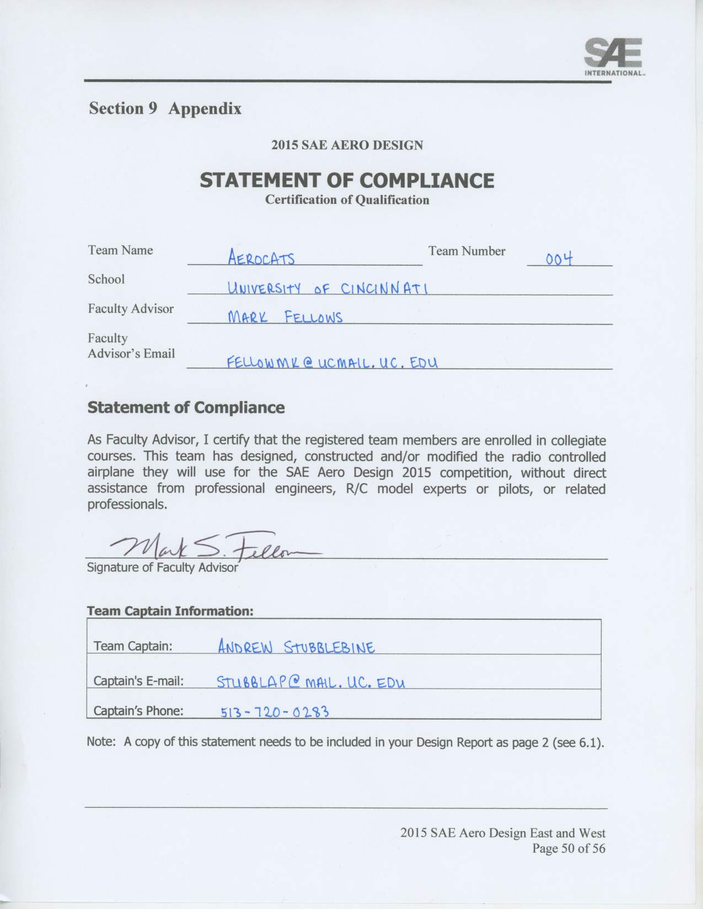
[picture p42: page 1]
