Aerothon-2020/Reg2015Aircraft_Aerocats/Treasurer Files/Sponsorship Documents/scan0001.pdf

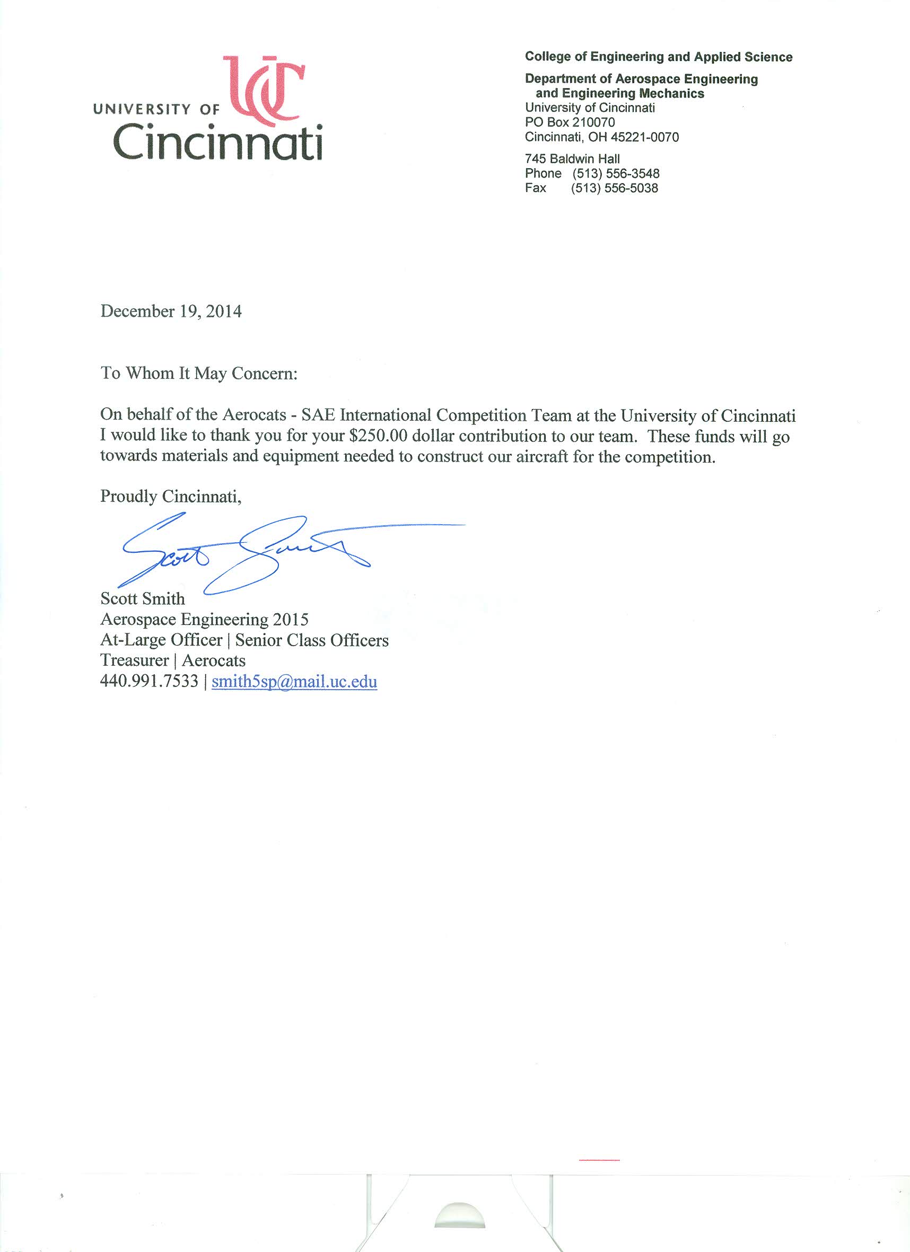
[picture p43: page 1]
