Aerothon-2020/Reg2015Aircraft_Aerocats/Treasurer Files/Sponsorship Documents/UCFormW-9.pdf

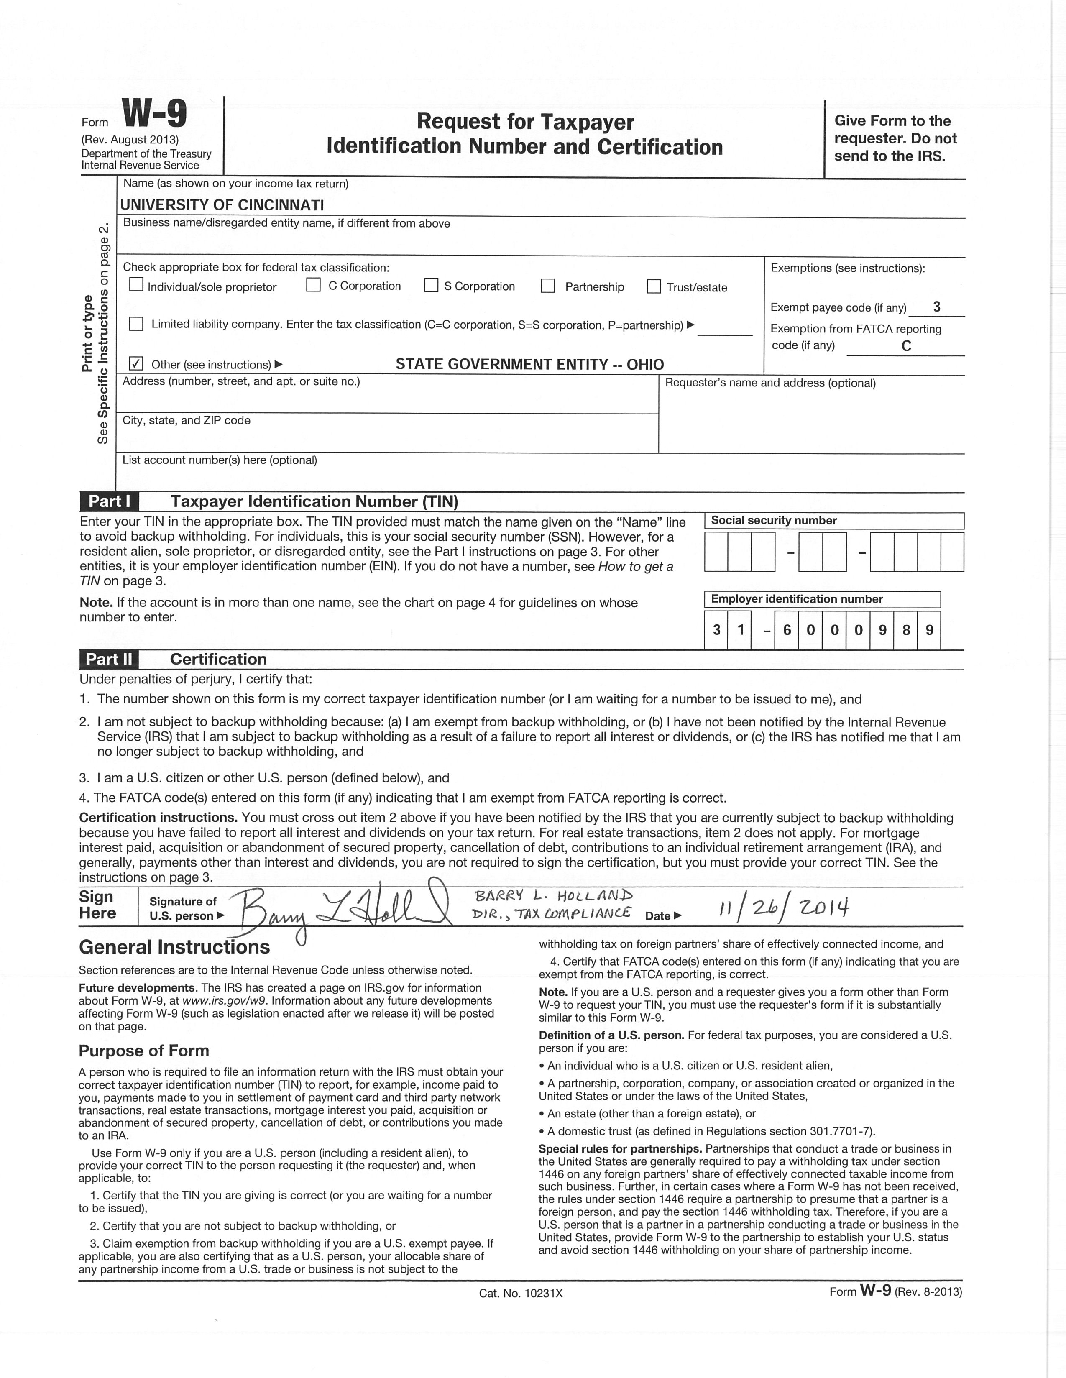
[picture p44: page 1]
