Aerothon-2020/Reg2015Aircraft_Aerocats/Treasurer Files/Swag/Aerocats Account Form.PDF

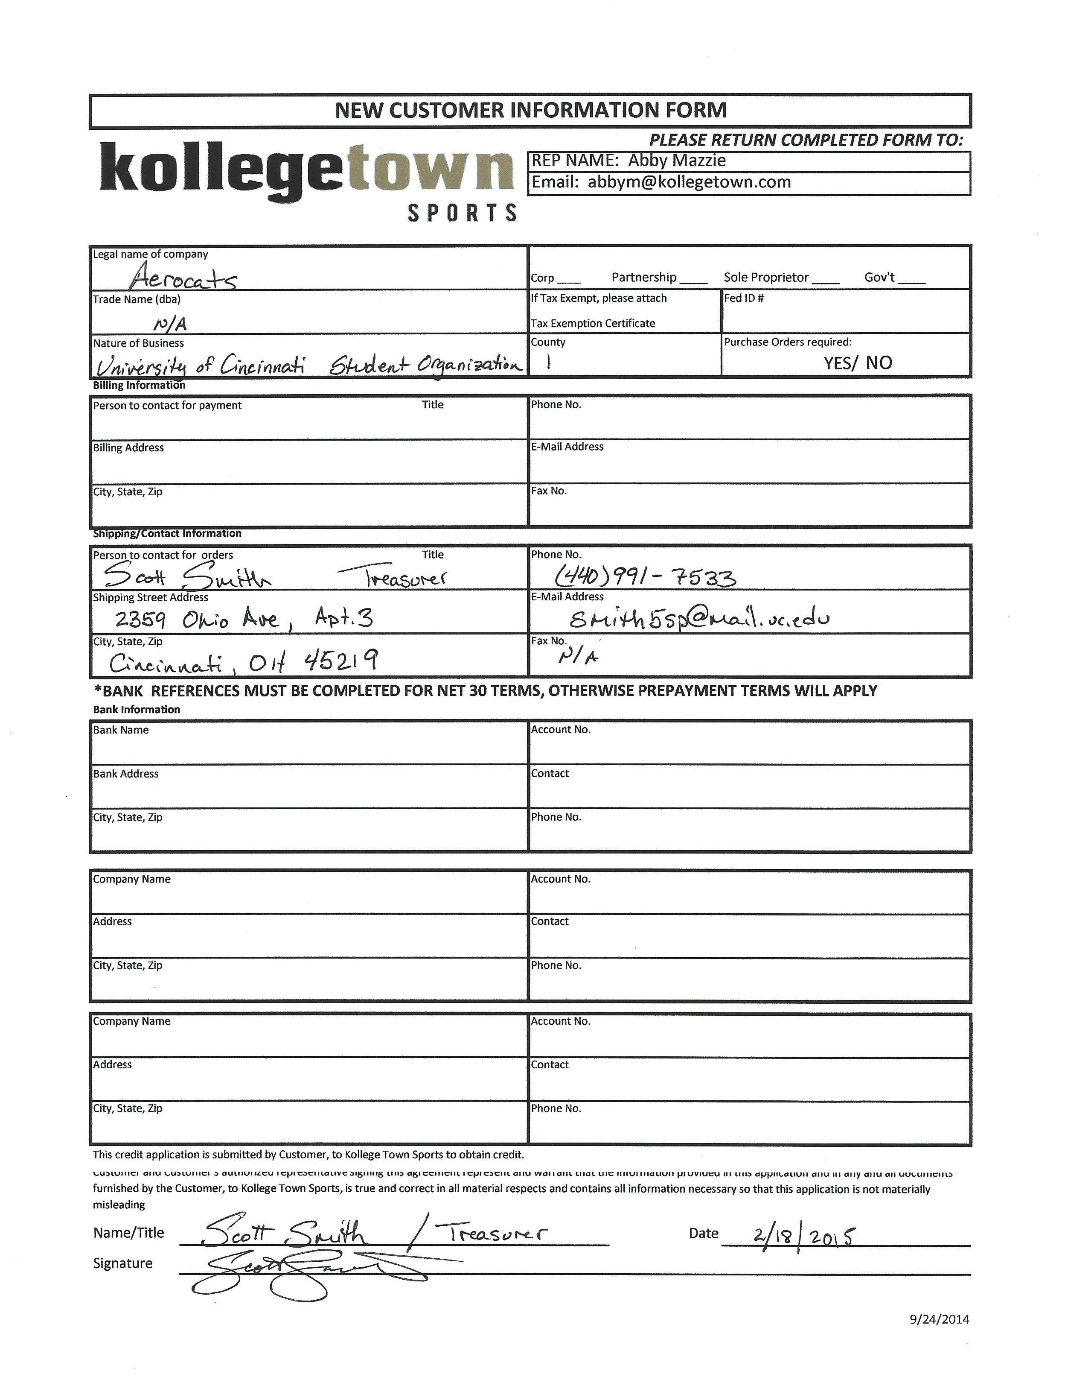
[picture p45: page 1]
