Aerothon-2020/Reg2015Aircraft_Aerocats/Treasurer Files/Swag/AerocatsGear_From_Invoice.PDF

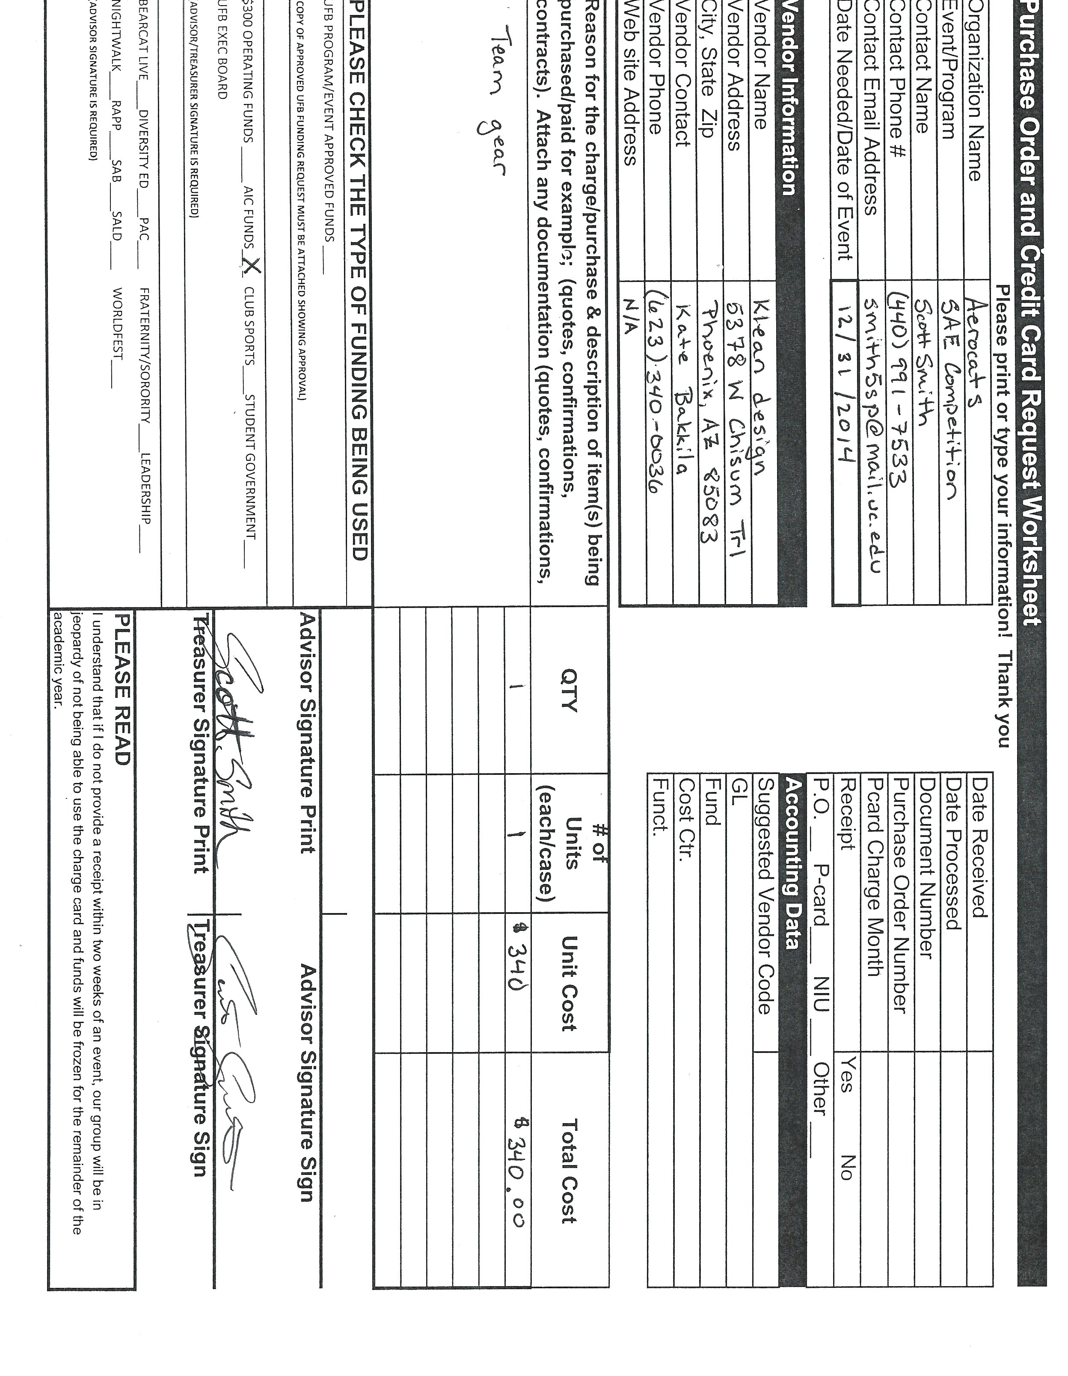
[picture p46: page 1]
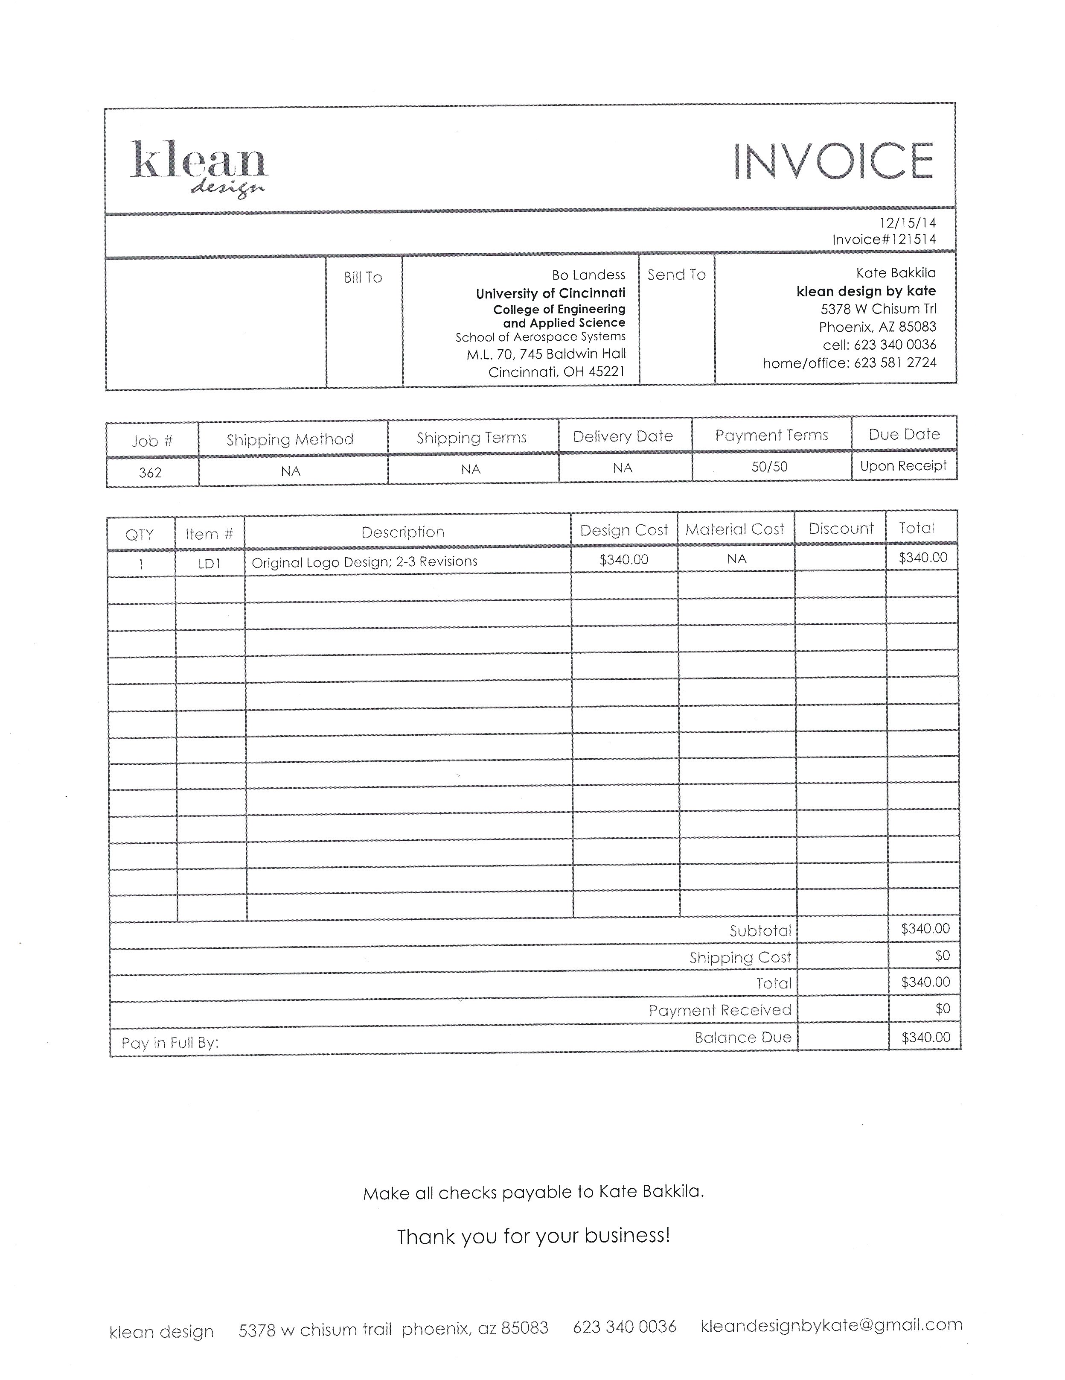
[picture p47: page 2]
