Aerothon-2020/Reg2015Aircraft_Aerocats/Treasurer Files/Swag/New Customer Information Form_signed.pdf

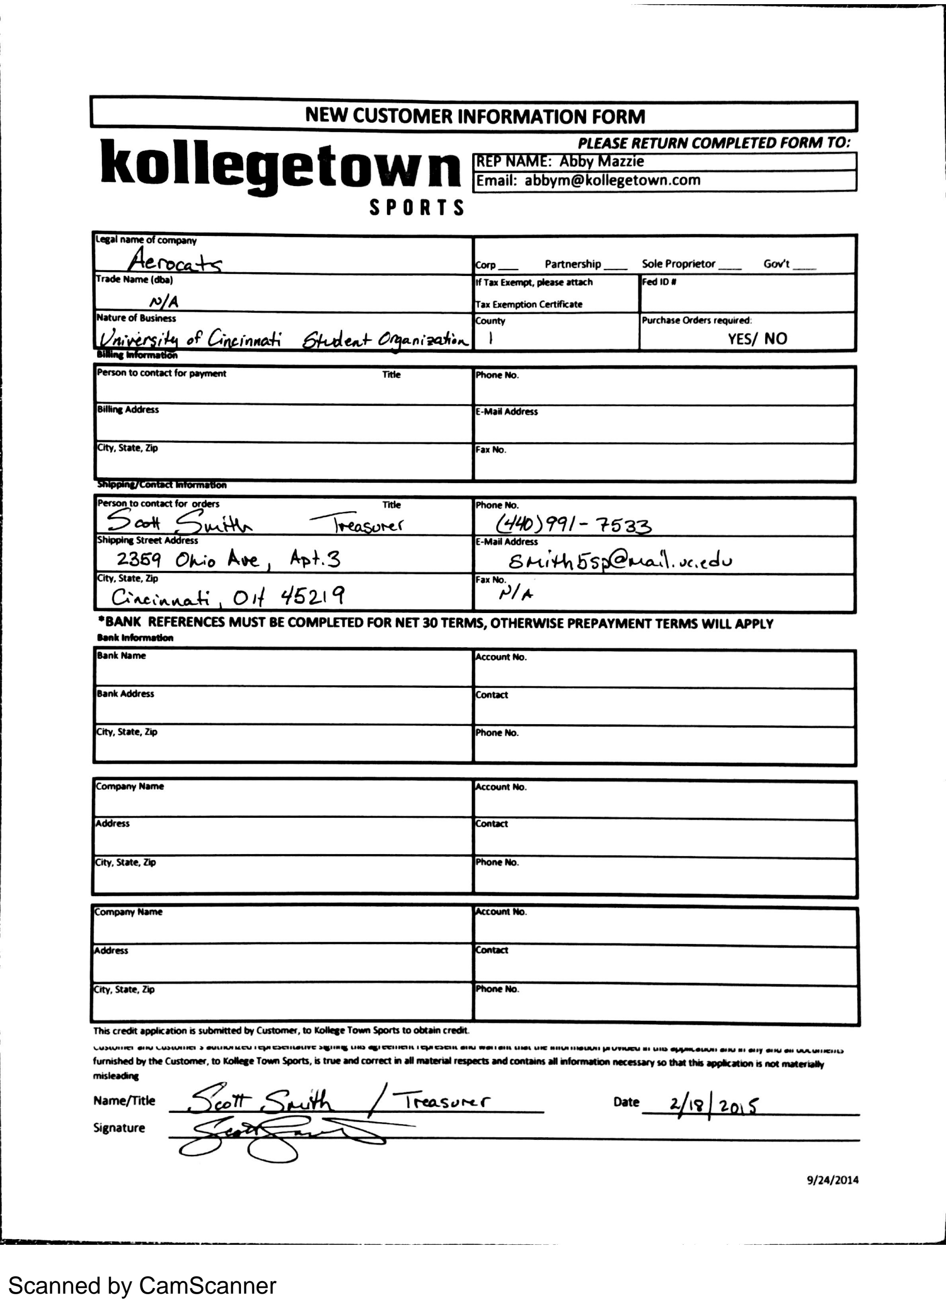
[picture p48: page 1]

Scanned by CamScanner
