Aerothon-2020/Reg2015Aircraft_Aerocats/Treasurer Files/Travel Documents/Airline Confirmations/Santiago Flight Confirmation.PDF

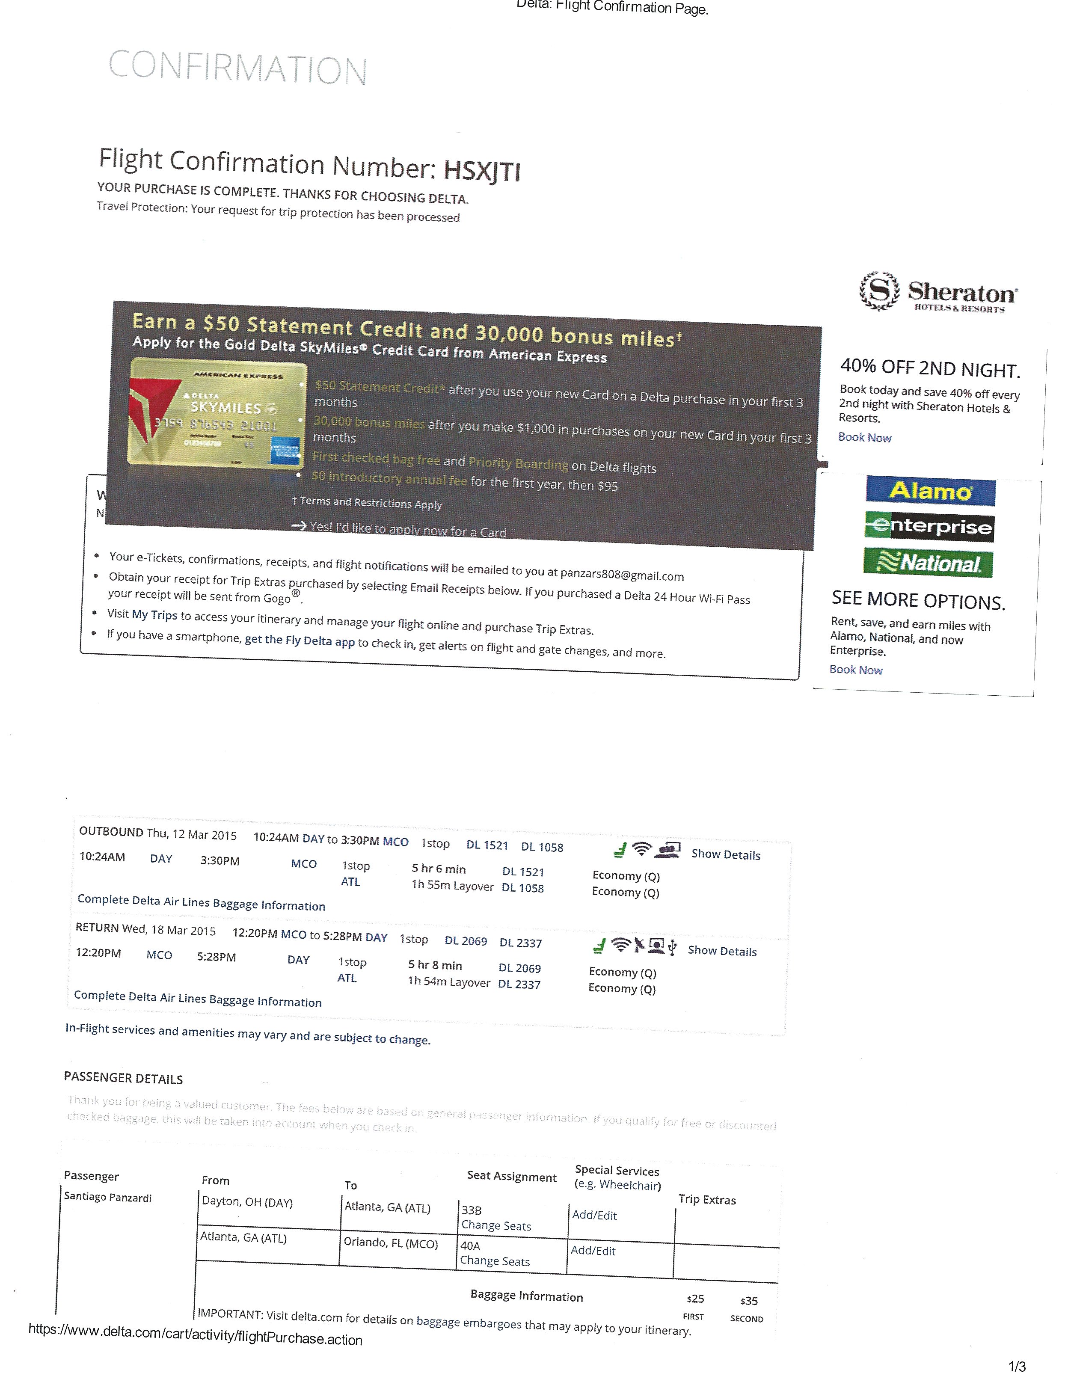
[picture p49: page 1]
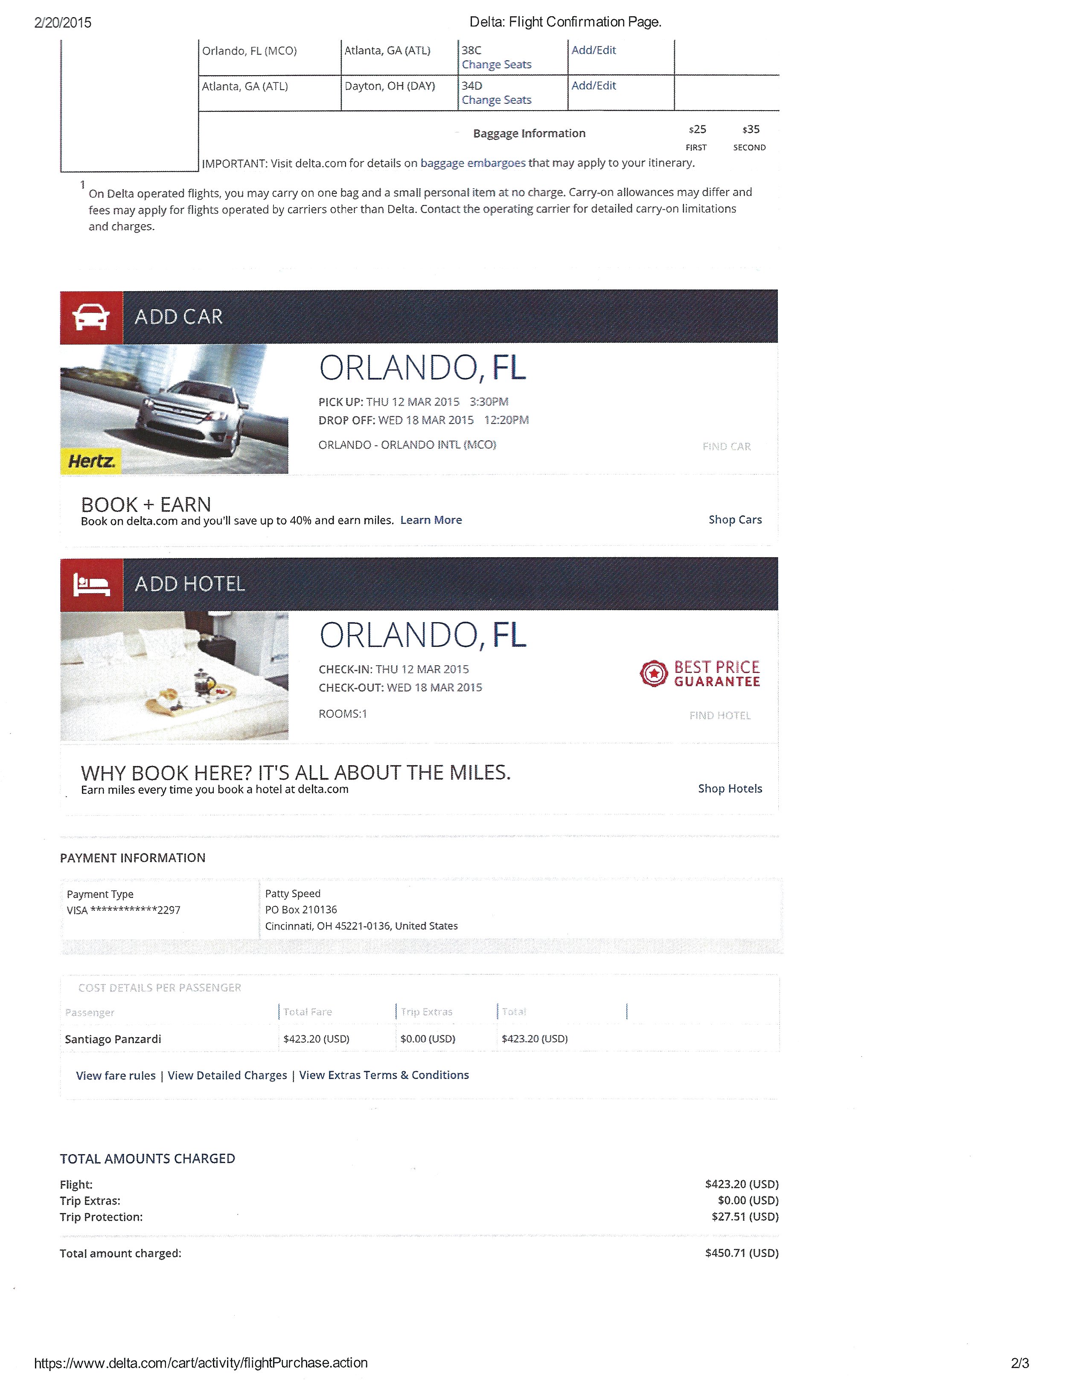
[picture p50: page 2]
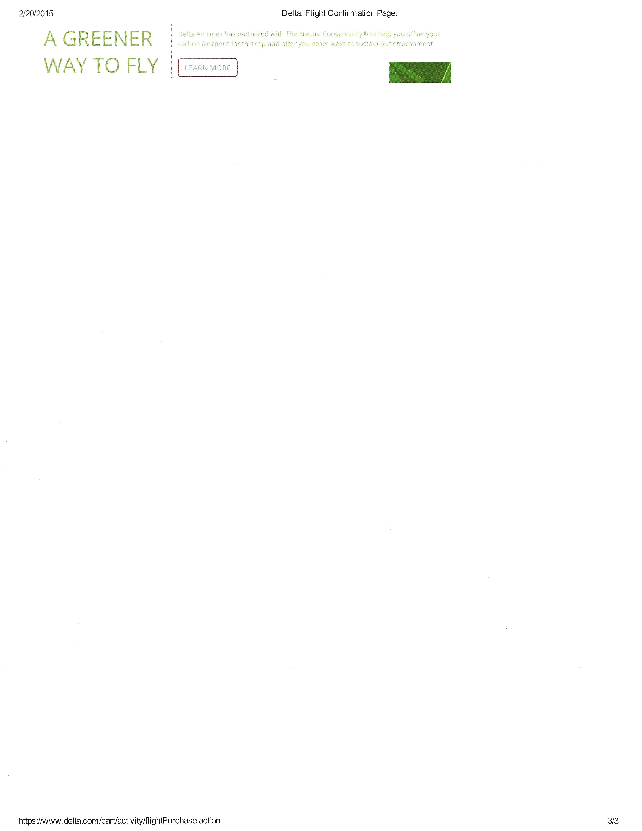
[picture p51: page 3]
