Aerothon-2020/Reg2015Aircraft_Aerocats/Treasurer Files/Travel Documents/Driving Certs and Rental Information/Certificate of Completion Clemens.pdf

1/20/2015 | Certificate of Completion

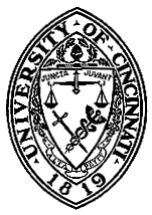
[picture p52: figure]

https://ehs.uc.edu/webtrain/certificate.asp | 1/1

# UNIVERSITY OF CINCINNATI

# UNIVERSITY HEALTH SERVICES Environmental Health and Safety

# Andrew James Clemens

## has successfully completed

## Defensive Driving

Course Date: 1/20/2015 | Expiration: 1/20/2016

This certificate is your proof of completion of this training program. Provide a copy of your certificate to your business office and keep a copy for your records.
