Aerothon-2020/Reg2015Aircraft_Aerocats/Treasurer Files/Travel Documents/Driving Certs and Rental Information/Certificate of Completion Defensive Driving Mayeux.pdf

1/23/2015 | Certificate of Completion


https://ehs.uc.edu/webtrain/certificate.asp | 1/1

# UNIVERSITY OF CINCINNATI

# UNIVERSITY HEALTH SERVICES Environmental Health and Safety

# Andrew Nathan Mayeux

## has successfully completed

## Defensive Driving

Course Date: 1/23/2015 | Expiration: 1/23/2016

This certificate is your proof of completion of this training program. Provide a copy of your certificate to your business office and keep a copy for your records.
