Aerothon-2020/Reg2015Aircraft_Aerocats/Treasurer Files/Travel Documents/Driving Certs and Rental Information/WyborskiM_Certificate_of_Completion.pdf

# UNIVERSITY OF CINCINNATI

# UNIVERSITY HEALTH SERVICES Environmental Health and Safety

# Matthew Edward Wyborski

## has successfully completed

## Defensive Driving

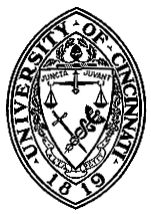
[picture p53: figure]

Course Date: 1/22/2015 | Expiration: 1/22/2016

This certificate is your proof of completion of this training program. Provide a copy of your certificate to your business office and keep a copy for your records.
