Aerothon-2020/Reg2015Aircraft_Aerocats/Treasurer Files/Travel Documents/Signed Forms/Student Travel Group Authorization and Contact Form_signed.pdf

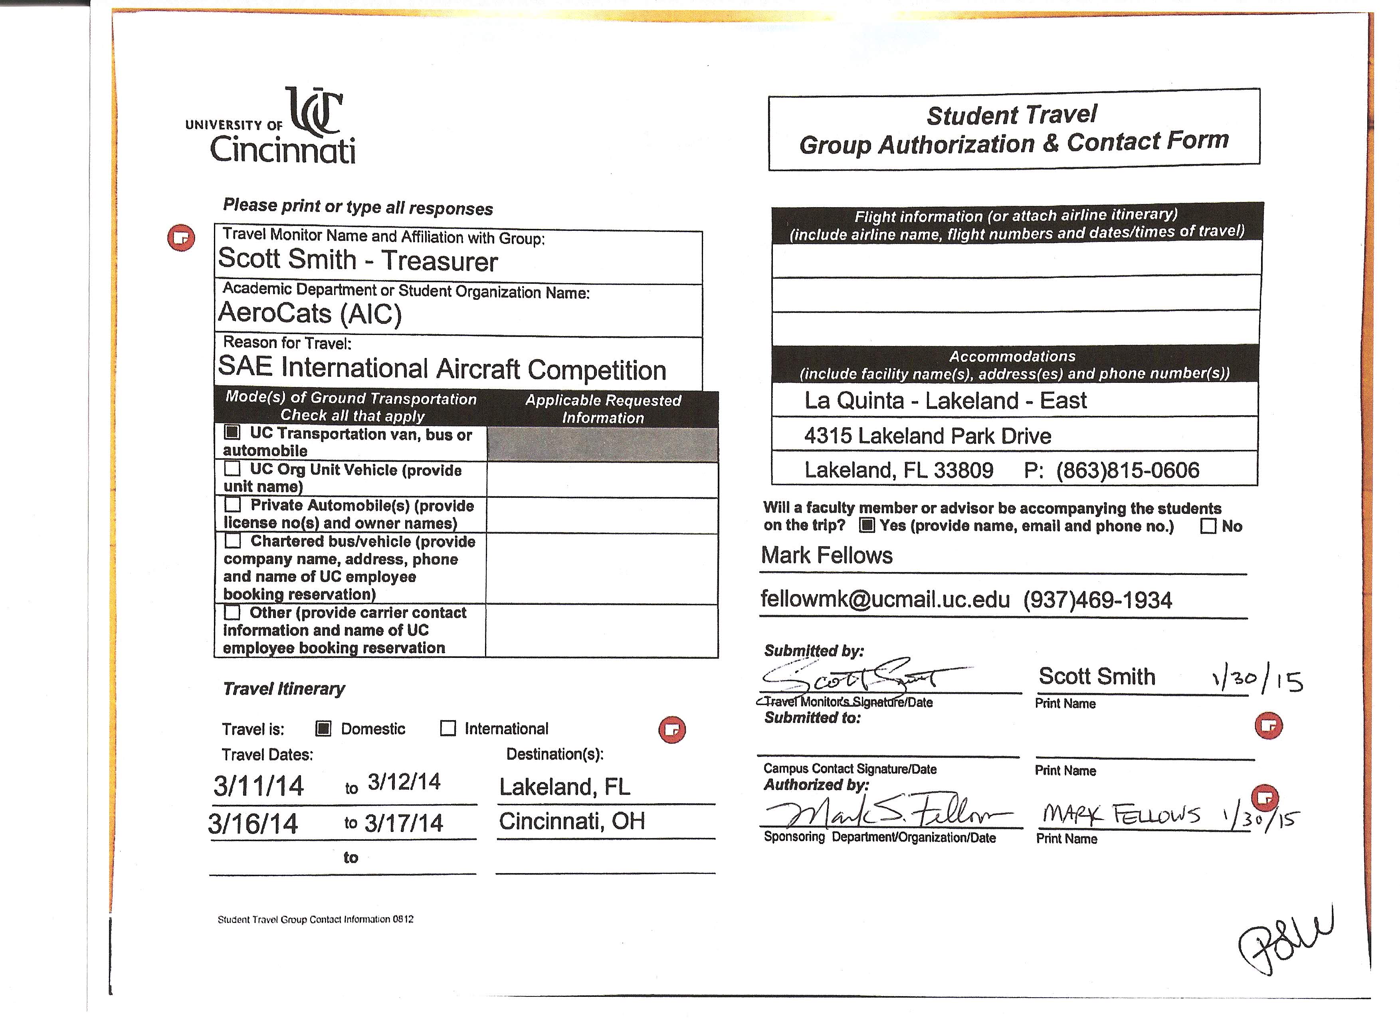
[picture p54: page 1]
