Aerothon-2020/Reg2015Aircraft_Aerocats/Treasurer Files/Travel Documents/Signed Forms/Travel_Roster_Group.pdf

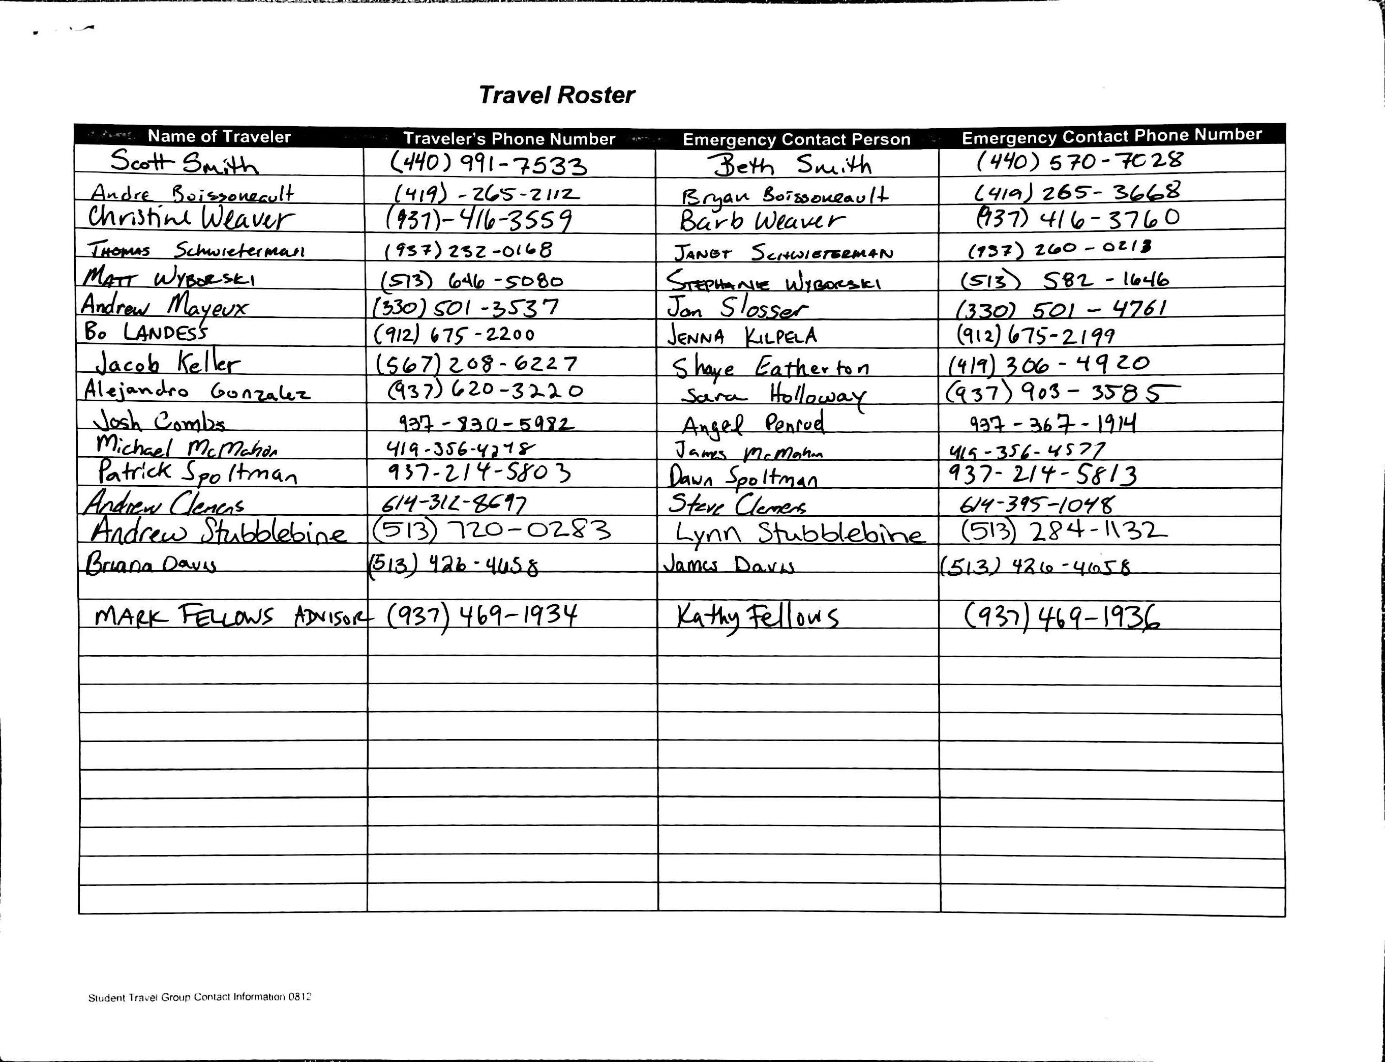
[picture p55: page 1]
