Aerothon-2020/Reg2015Aircraft_Aerocats/Treasurer Files/Travel Documents/Signed Forms/University_Transportation_Services_Rental_Form_signed.pdf

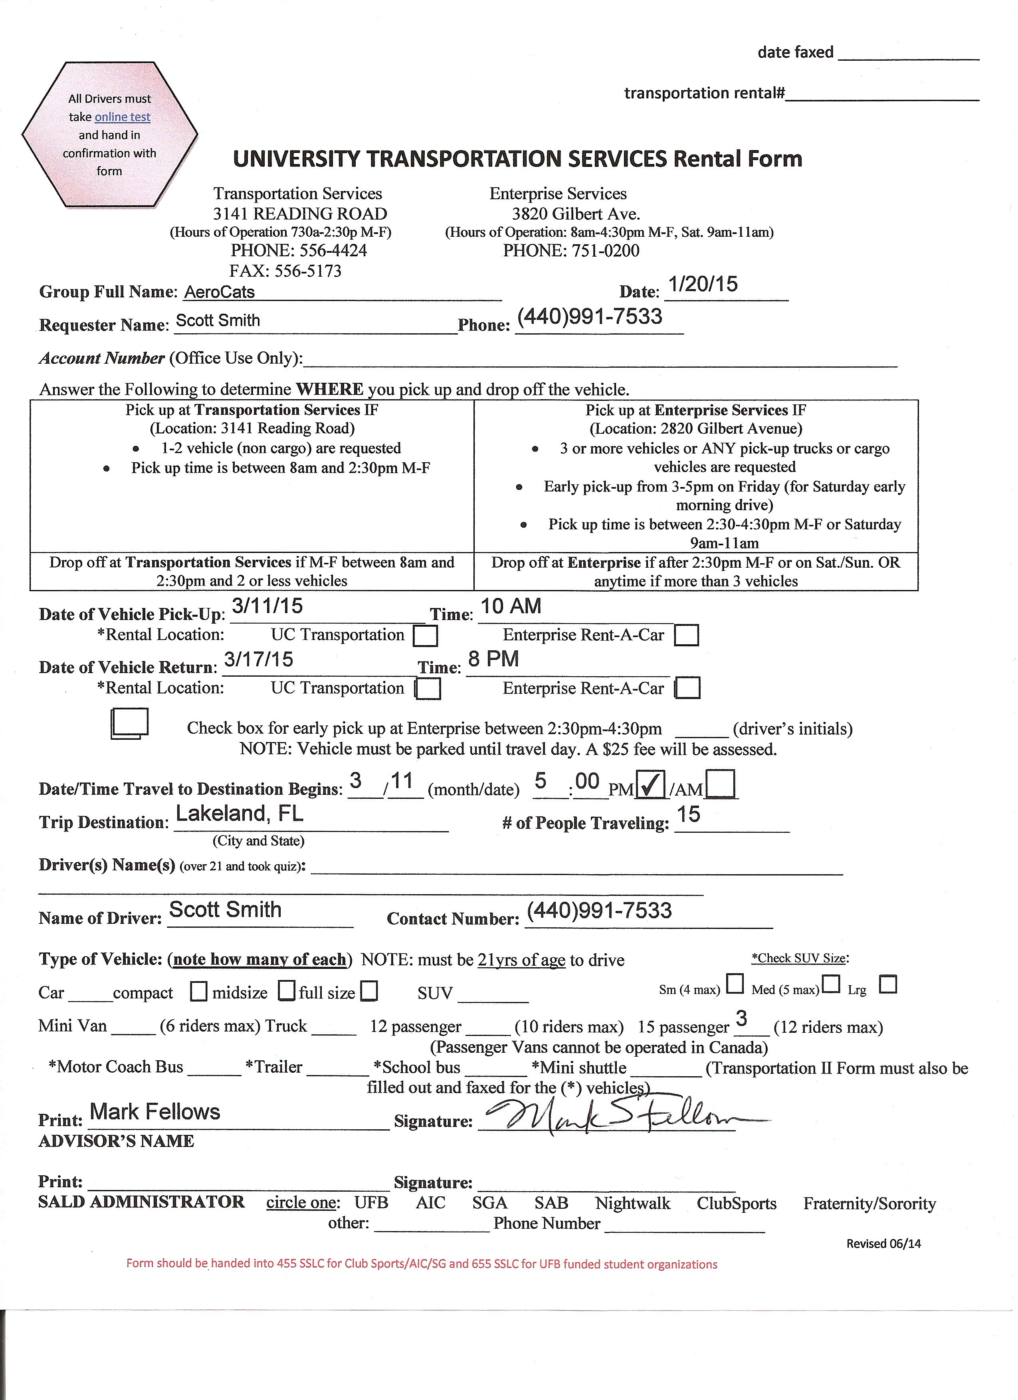
[picture p56: page 1]
