Aerothon-2020/Reg2015Aircraft_Aerocats/Aerodynamics/Pictures/Plots/span_area_to_lift_cl_liftandspanview.png

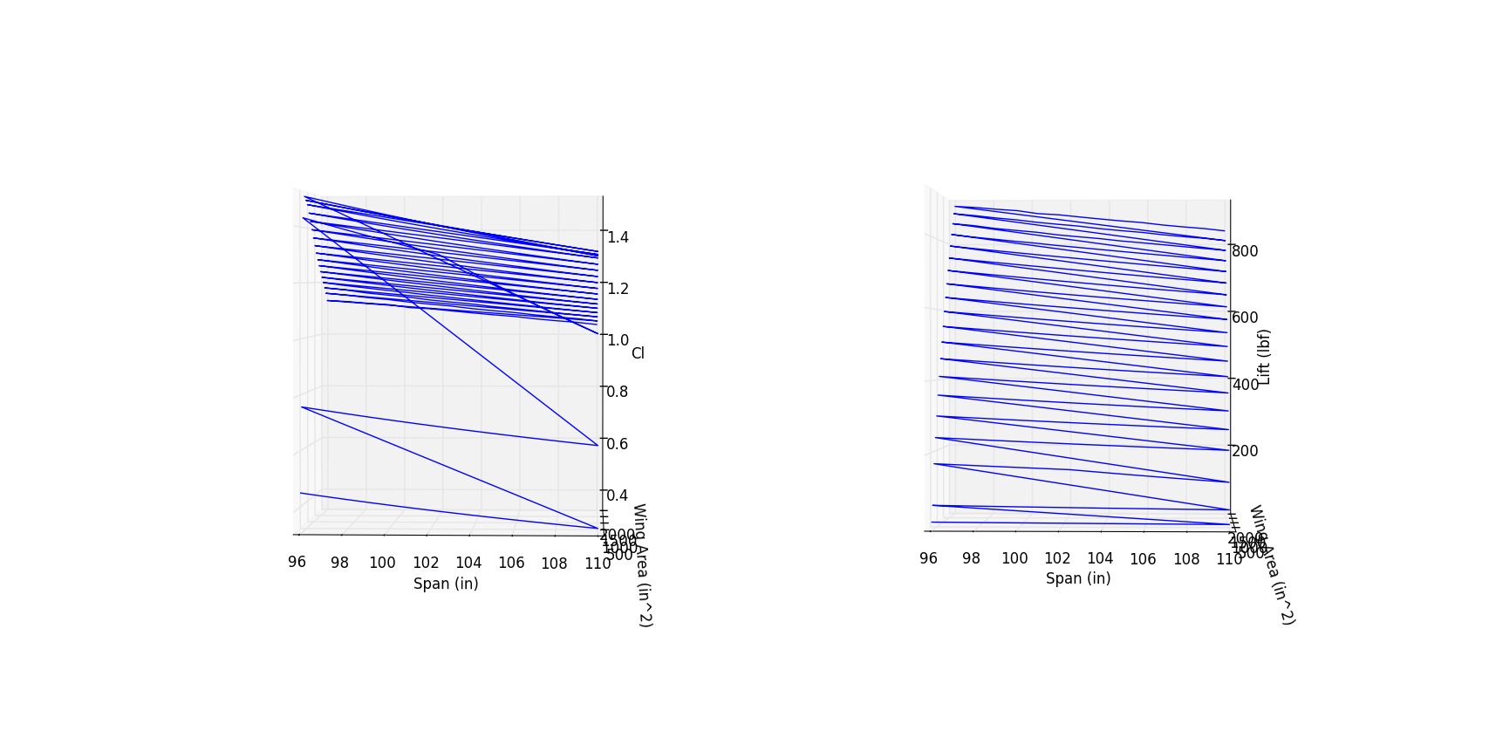
Aerodynamics/Pictures/Plots/span_area_to_lift_cl_liftandspanview.png
