Aerothon-2020/Reg2015Aircraft_Aerocats/Aerodynamics/Pictures/TR_0.2to1_Fb_005.png

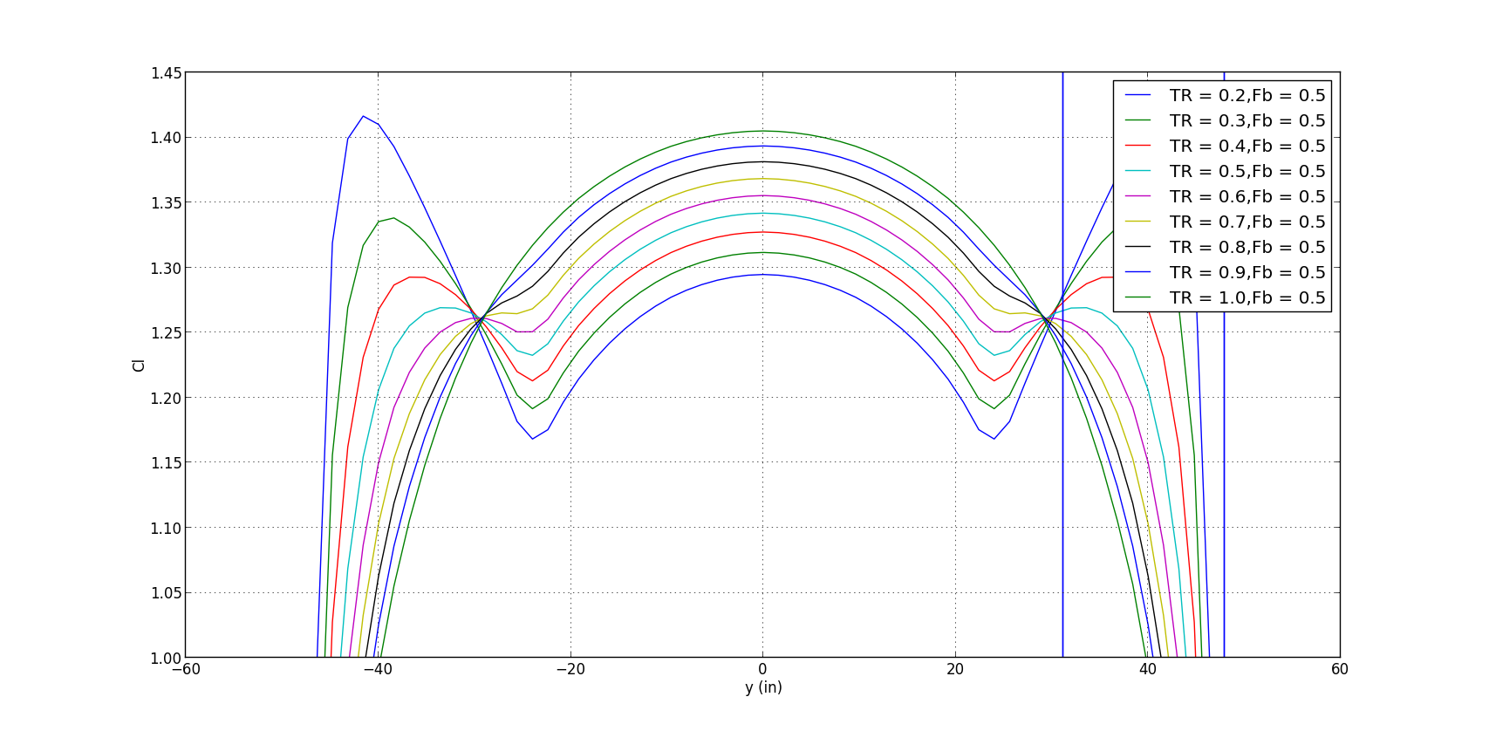
Aerodynamics/Pictures/TR_0.2to1_Fb_005.png
