Aerothon-2020/Reg2015Aircraft_Aerocats/Aerodynamics/Pictures/Trade Study Pic's/CD_TR0385_Fb_020to080.png

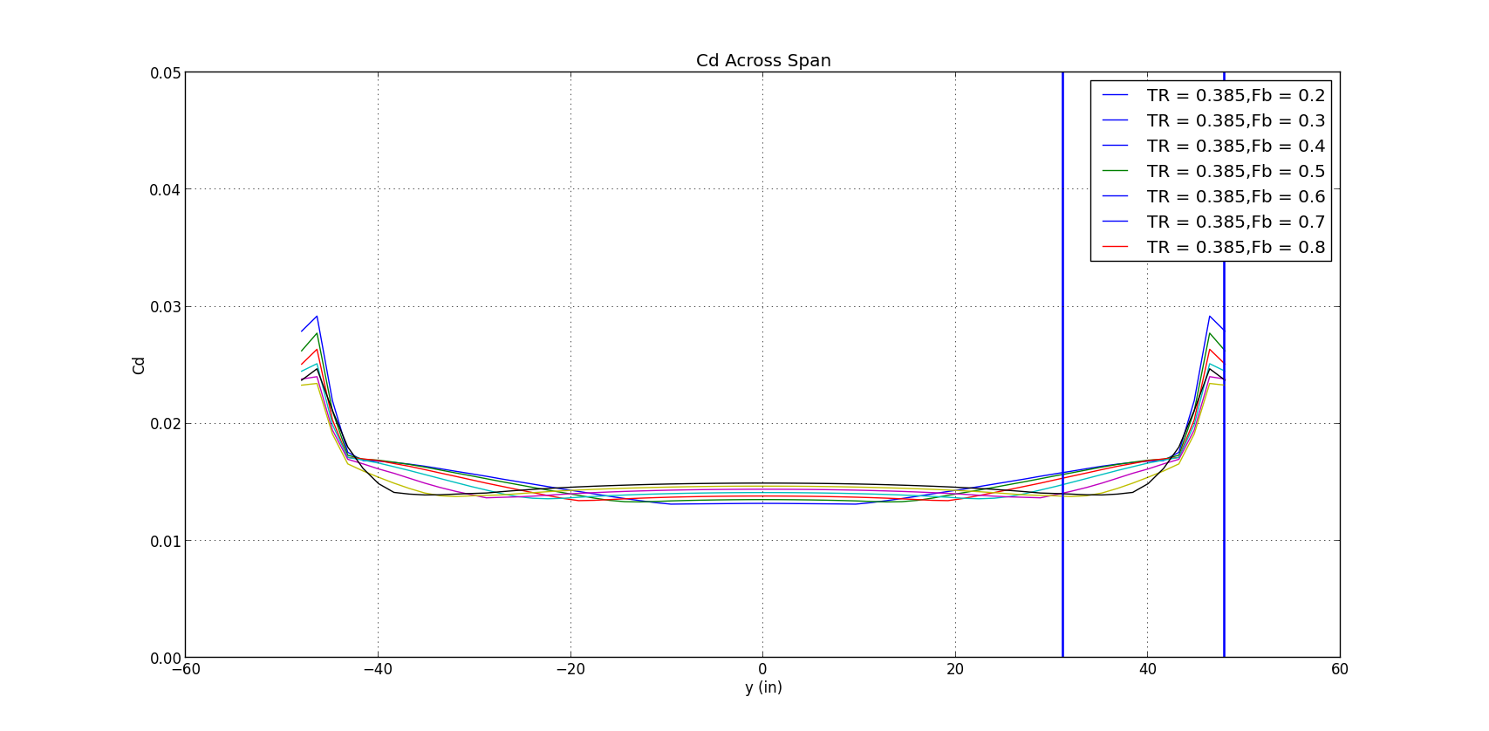
Aerodynamics/Pictures/Trade Study Pic's/CD_TR0385_Fb_020to080.png
