Aerothon-2020/Reg2015Aircraft_Aerocats/Aerodynamics/Pictures/Trade Study Pic's/Sweep/Planform_0Sweep.png

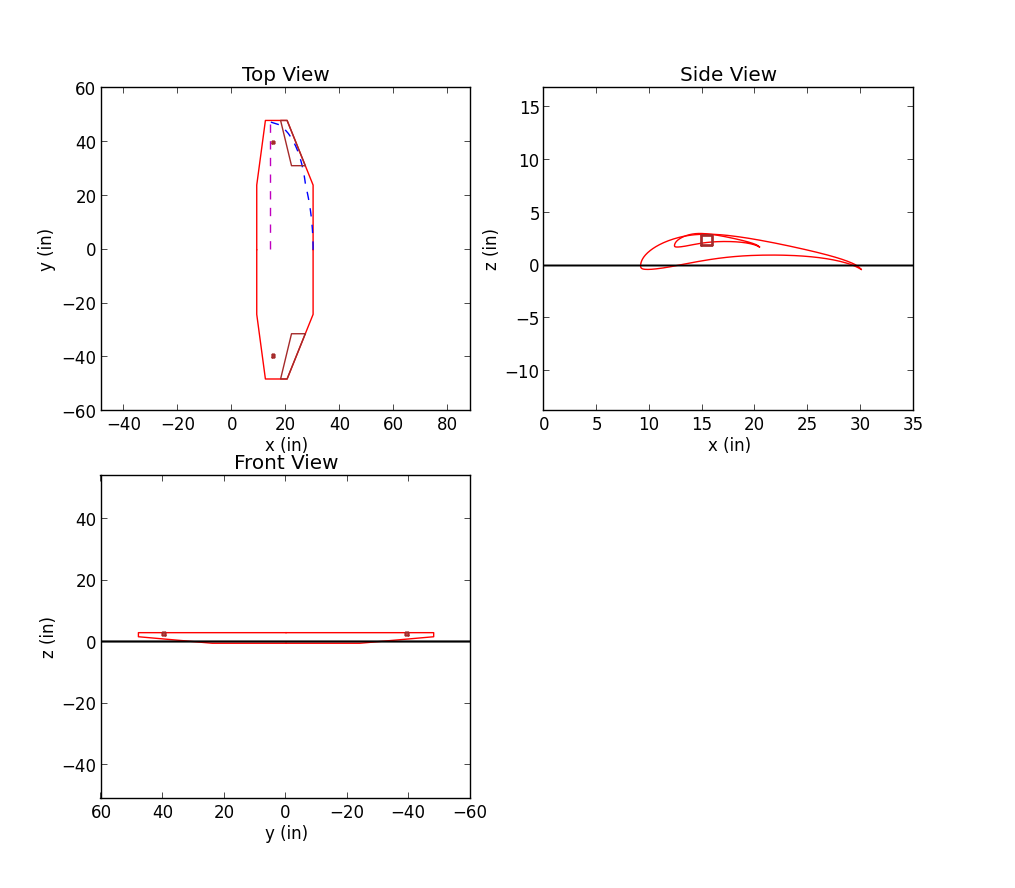
Aerodynamics/Pictures/Trade Study Pic's/Sweep/Planform_0Sweep.png
