Aerothon-2020/Reg2015Aircraft_Aerocats/Aerodynamics/Trade Study/Fb/Figure2_trade2.png

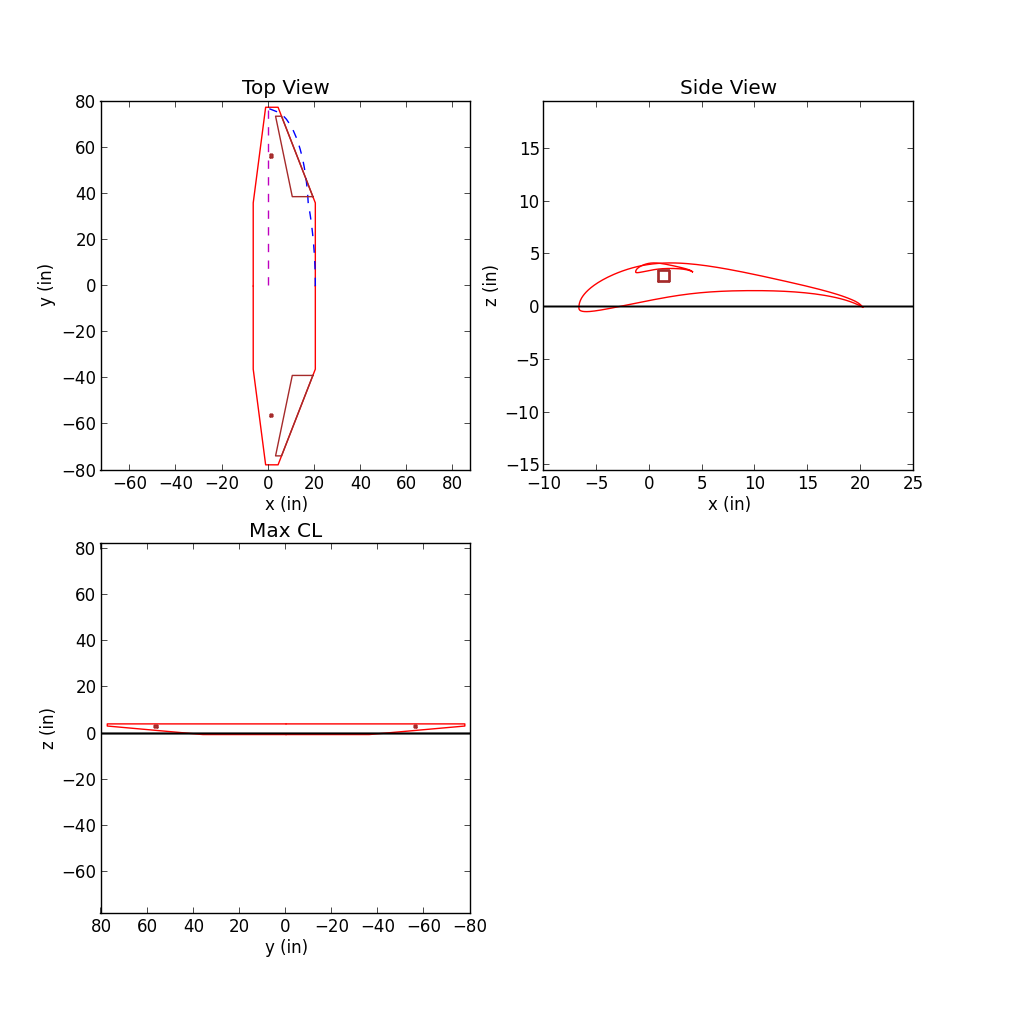
Aerodynamics/Trade Study/Fb/Figure2_trade2.png
