Aerothon-2020/Reg2015Aircraft_Aerocats/Aerodynamics/Trade Study/Fb/Figure3_trade1.png

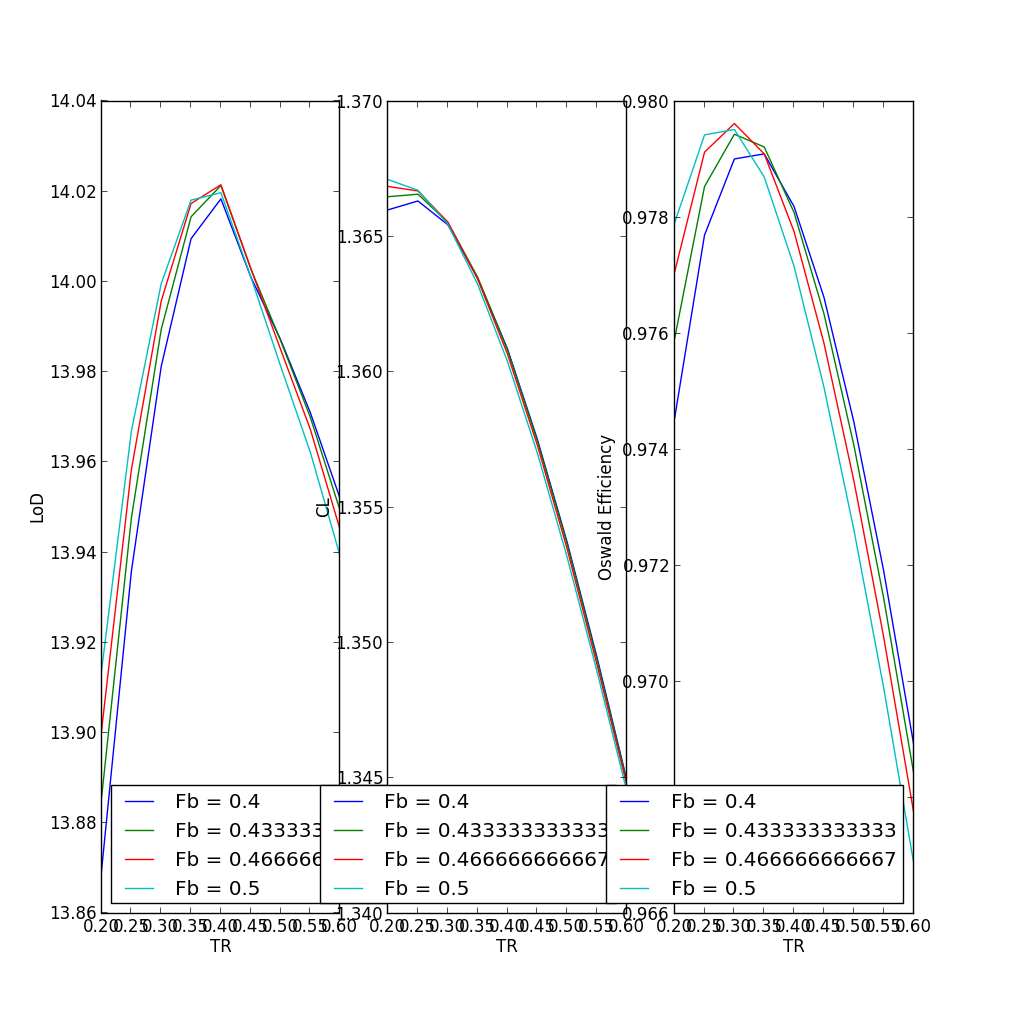
Aerodynamics/Trade Study/Fb/Figure3_trade1.png
