Aerothon-2020/Reg2015Aircraft_Aerocats/Aerodynamics/Trade Study/Fb/LLT_Cl_trade1.png

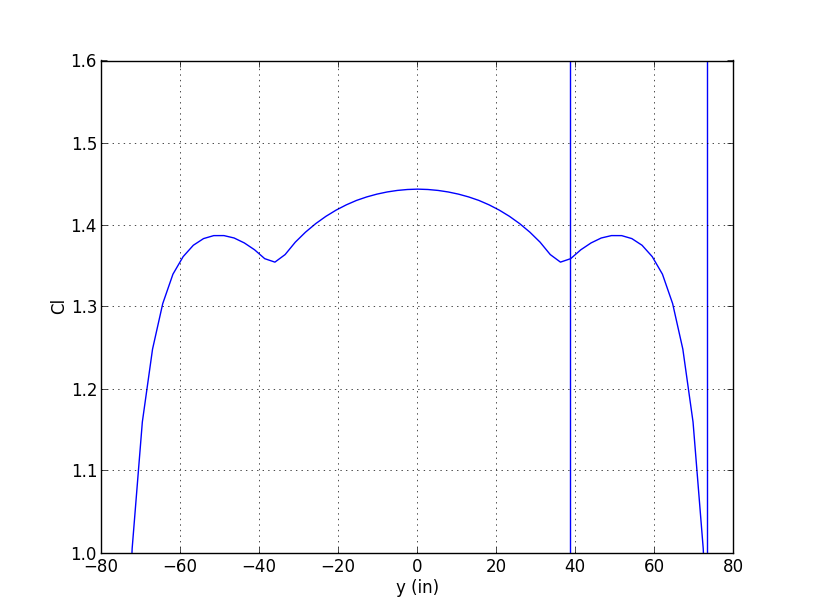
Aerodynamics/Trade Study/Fb/LLT_Cl_trade1.png
