Aerothon-2020/Reg2015Aircraft_Aerocats/Aerodynamics/Trade Study/TR/Figure4_trade1.png

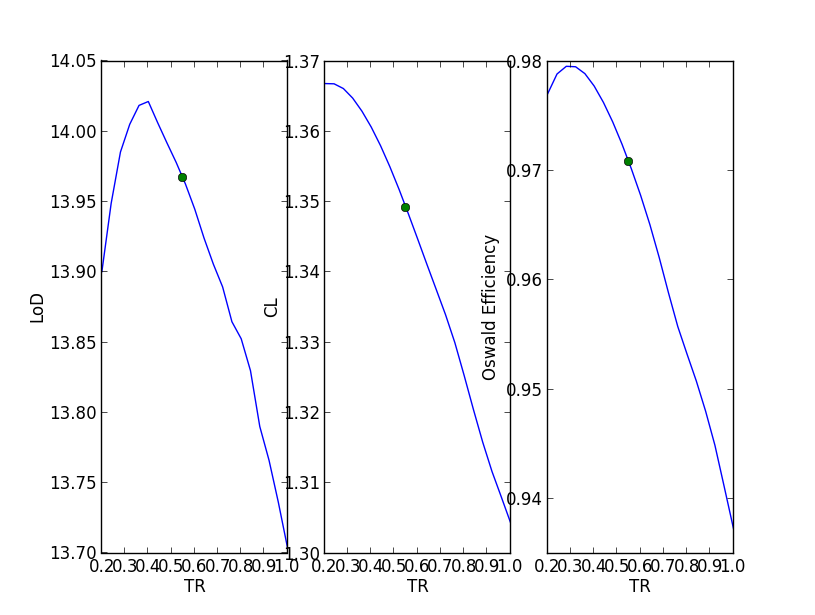
Aerodynamics/Trade Study/TR/Figure4_trade1.png
