Aerothon-2020/Reg2015Aircraft_Aerocats/Propulsion/MotorComparison_w_Props/AXI_18x8E/18x8E_w_AXI_Fig1.png

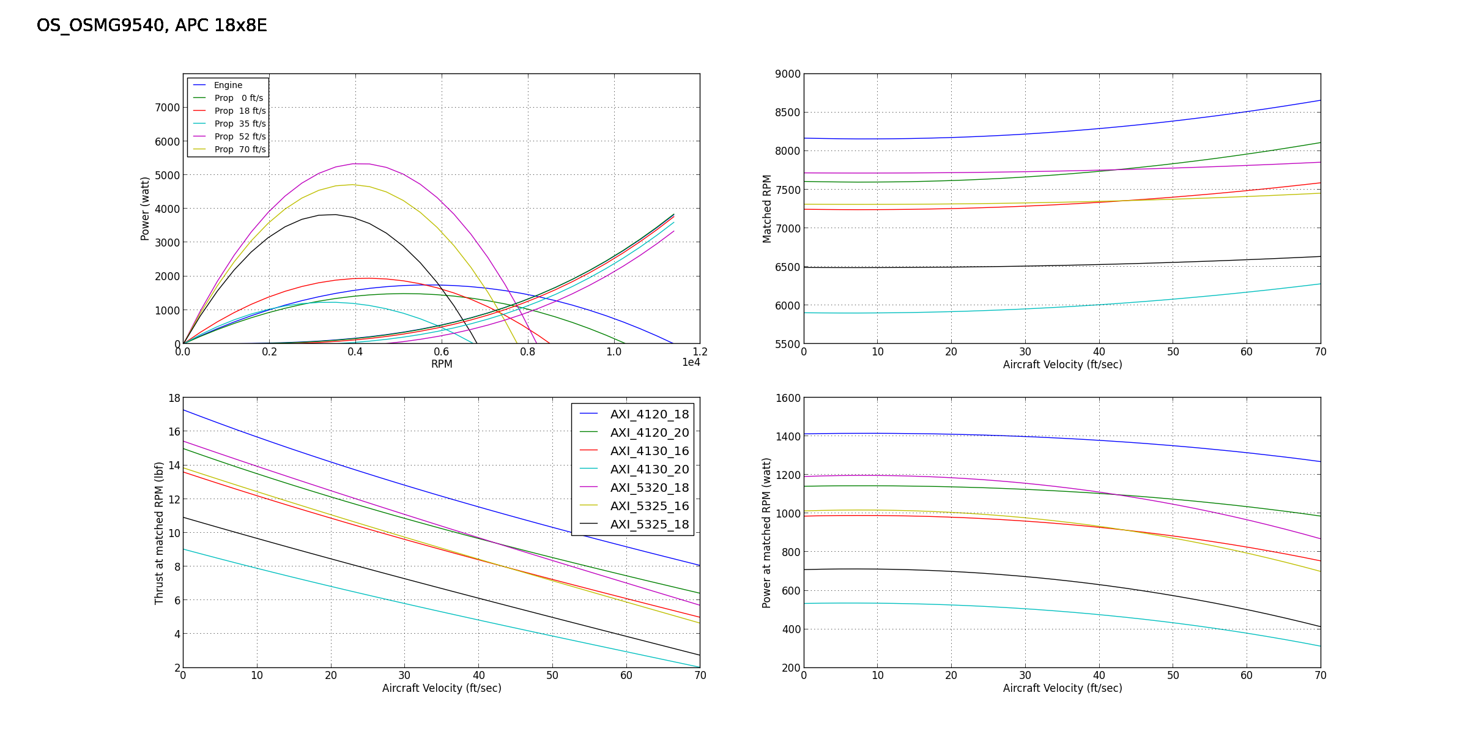
Propulsion/MotorComparison_w_Props/AXI_18x8E/18x8E_w_AXI_Fig1.png
