Aerothon-2020/Reg2015Aircraft_Aerocats/Propulsion/MotorComparison_w_Props/Hyperion_18x8E/18x8E_w_Hyperion_Fig3.png

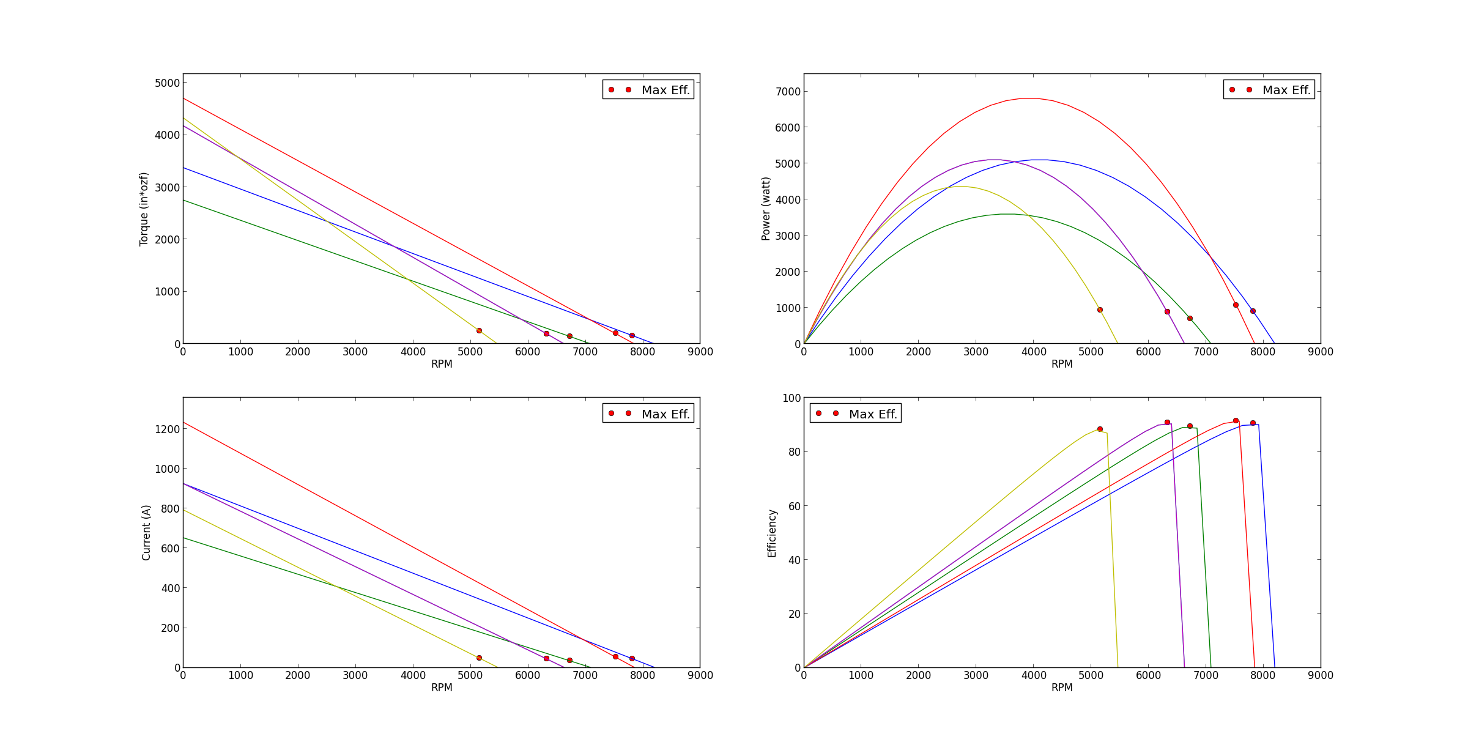
Propulsion/MotorComparison_w_Props/Hyperion_18x8E/18x8E_w_Hyperion_Fig3.png
