Aerothon-2020/Reg2015Aircraft_Aerocats/Report_PostSubmission/4_Loads and Environments Assumptions/spanwise_loadingcropped_new.png

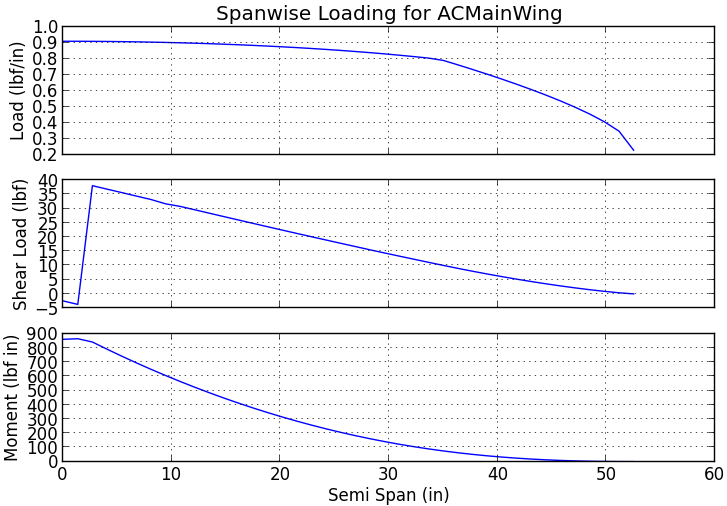
Report_PostSubmission/4_Loads and Environments Assumptions/spanwise_loadingcropped_new.png
