Aerothon-2020/Reg2015Aircraft_Aerocats/Report_PostSubmission/4_Loads and Environments Assumptions/Vn_Diagramcropped_new.png

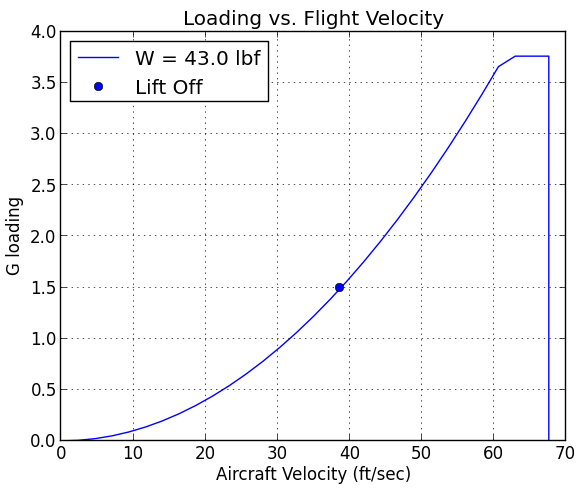
Report_PostSubmission/4_Loads and Environments Assumptions/Vn_Diagramcropped_new.png
