Aerothon-2020/Reg2015Aircraft_Aerocats/Report_PostSubmission/5_Design Layout and Trades/20b8Prop_w_A50A60Fig1_thrust_epwrconsptn.png

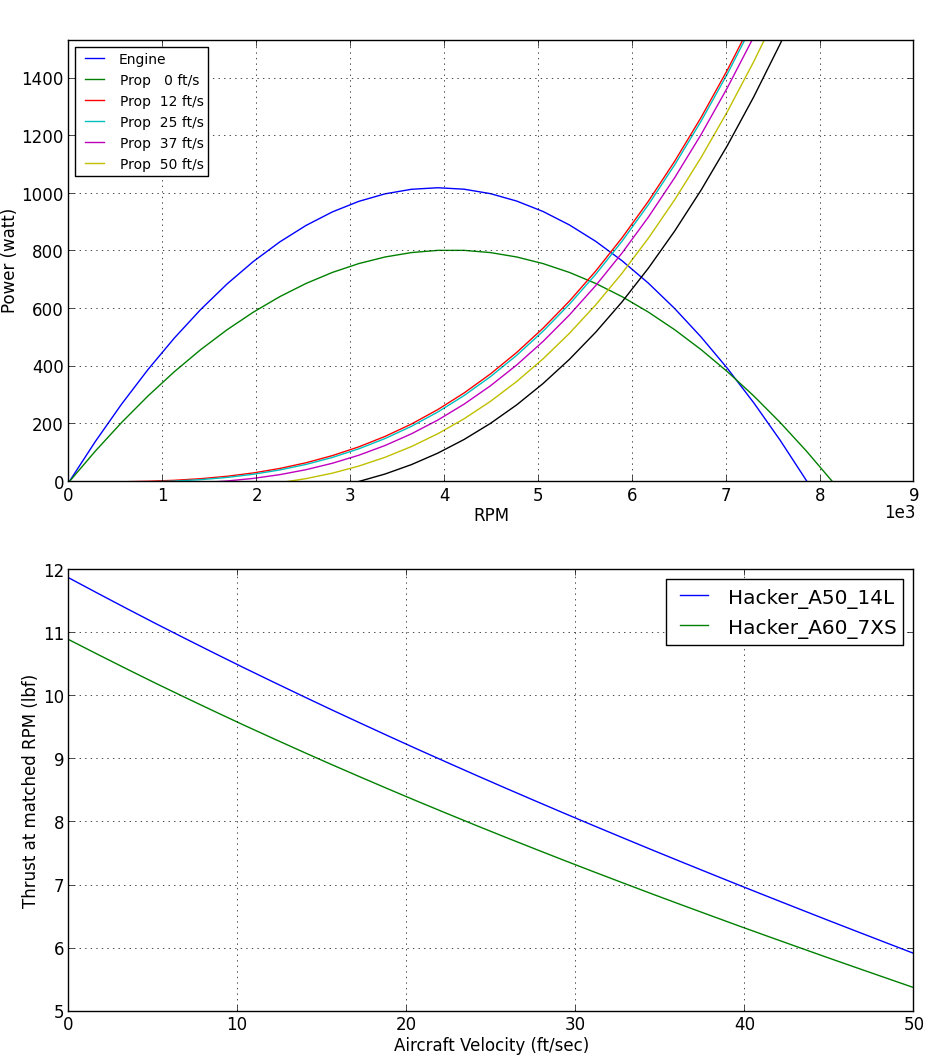
Report_PostSubmission/5_Design Layout and Trades/20b8Prop_w_A50A60Fig1_thrust_epwrconsptn.png
