Aerothon-2020/Reg2015Aircraft_Aerocats/Report_PostSubmission/5_Design Layout and Trades/gusset_picture_SECTION 5.4.PNG

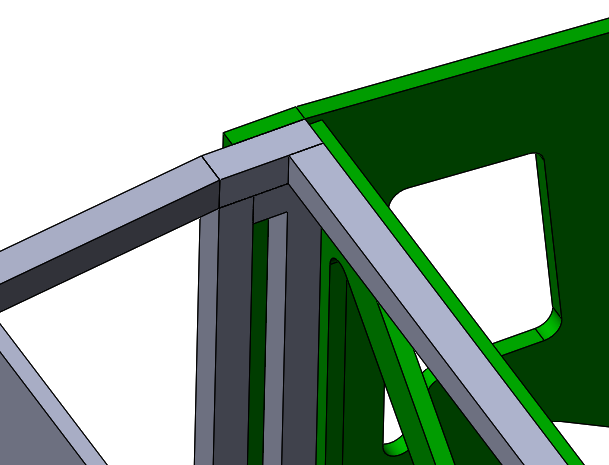
Report_PostSubmission/5_Design Layout and Trades/gusset_picture_SECTION 5.4.PNG
