Aerothon-2020/Reg2015Aircraft_Aerocats/Report_PostSubmission/5_Design Layout and Trades/spar-crosssection.png

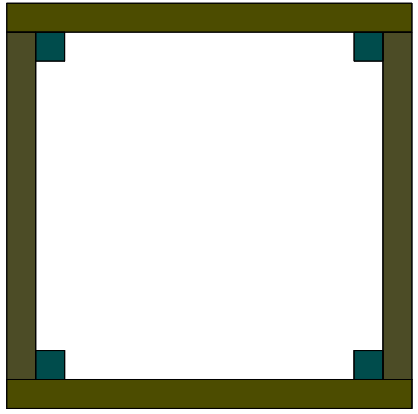
Report_PostSubmission/5_Design Layout and Trades/spar-crosssection.png
