Aerothon-2020/Reg2015Aircraft_Aerocats/Report_PostSubmission/6_Analysis/CMPolar_CGShift.png

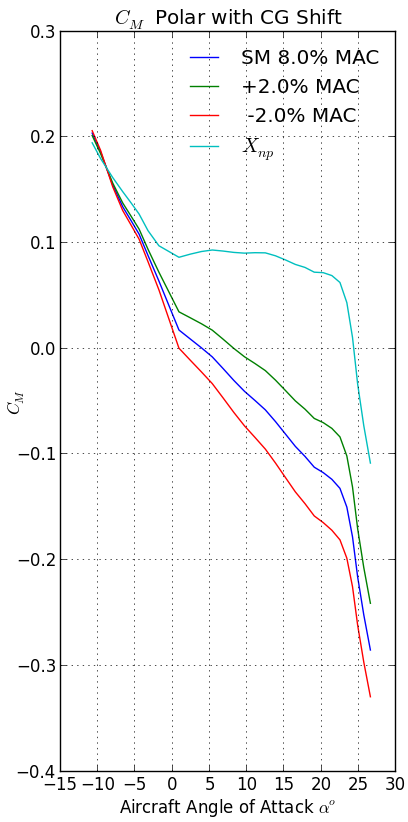
Report_PostSubmission/6_Analysis/CMPolar_CGShift.png
