Aerothon-2020/Reg2015Aircraft_Aerocats/Report_PostSubmission/6_Analysis/DWF.png

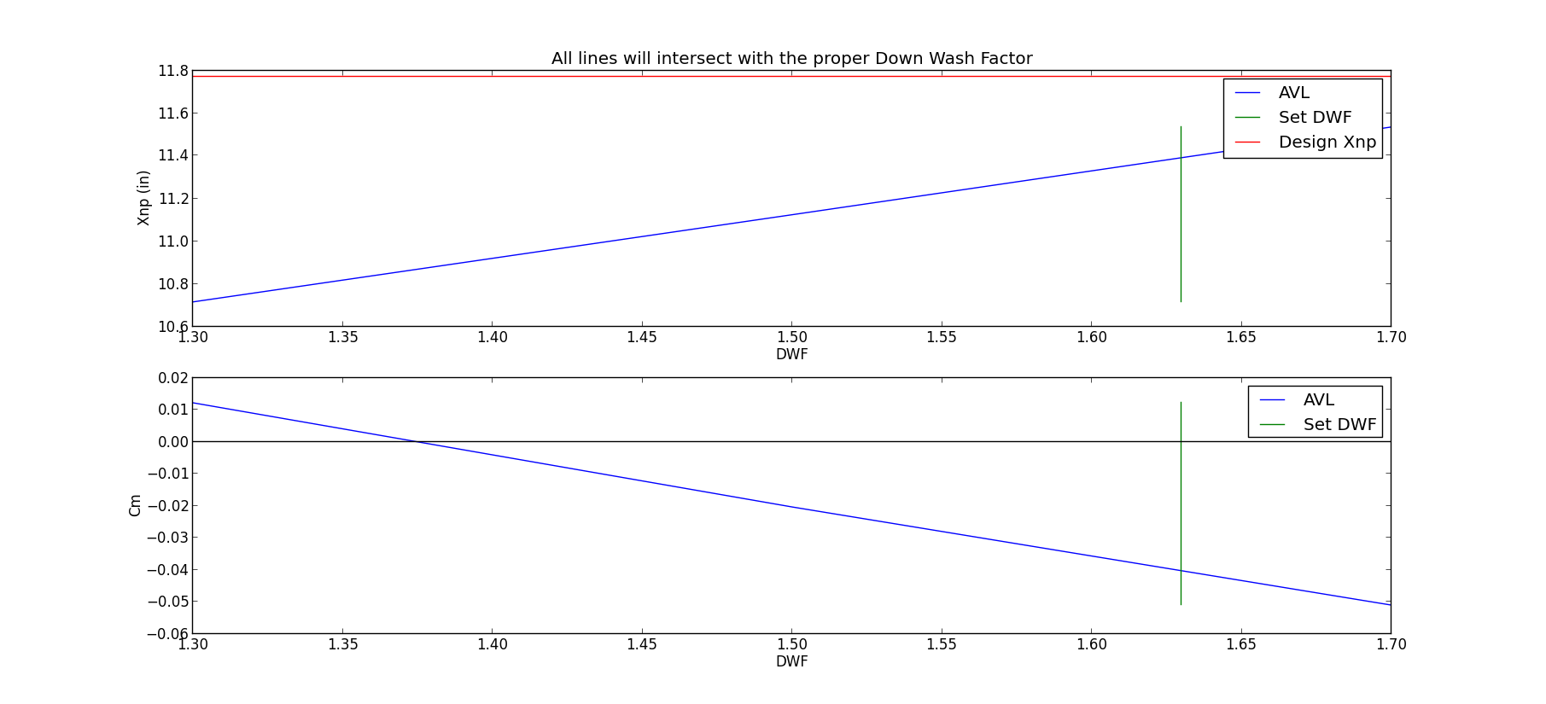
Report_PostSubmission/6_Analysis/DWF.png
