Aerothon-2020/Reg2015Aircraft_Aerocats/Report_PostSubmission/6_Analysis/Fuselage Displacement_Cropped Rev 1.PNG

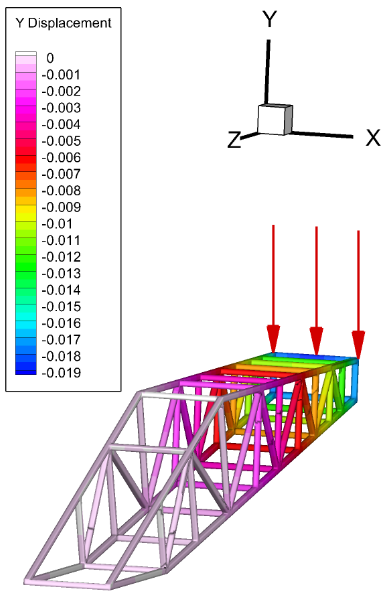
Report_PostSubmission/6_Analysis/Fuselage Displacement_Cropped Rev 1.PNG
