Aerothon-2020/Reg2015Aircraft_Aerocats/Report_PostSubmission/6_Analysis/GroundRoll_Report.JPG

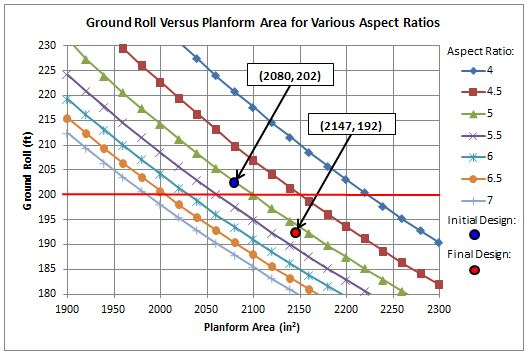
Report_PostSubmission/6_Analysis/GroundRoll_Report.JPG
