Aerothon-2020/Reg2015Aircraft_Aerocats/Report_PostSubmission/6_Analysis/motor_matching_example.png

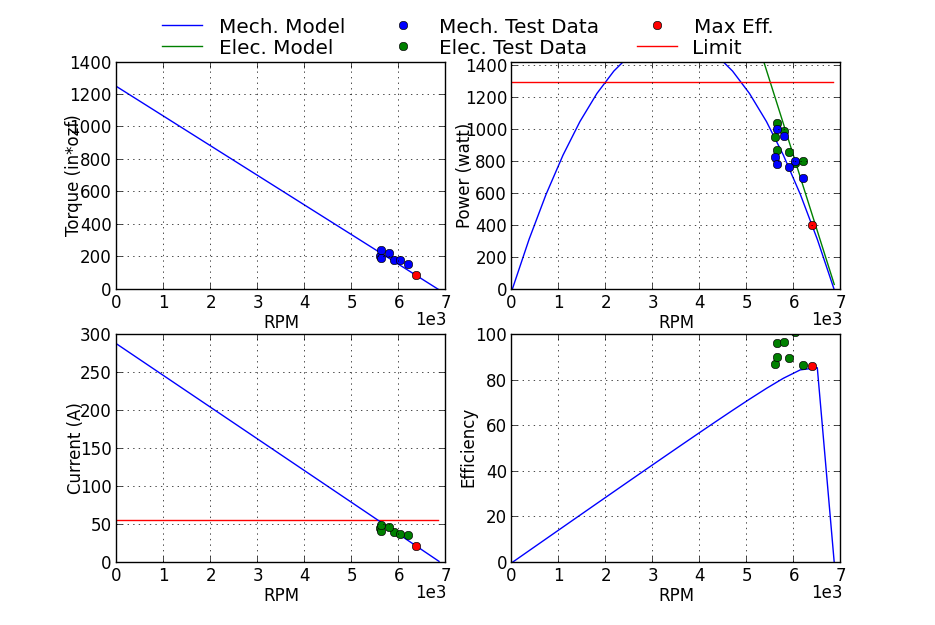
Report_PostSubmission/6_Analysis/motor_matching_example.png
