Aerothon-2020/Reg2015Aircraft_Aerocats/Report_PostSubmission/6_Analysis/payload vs density altitude.jpg

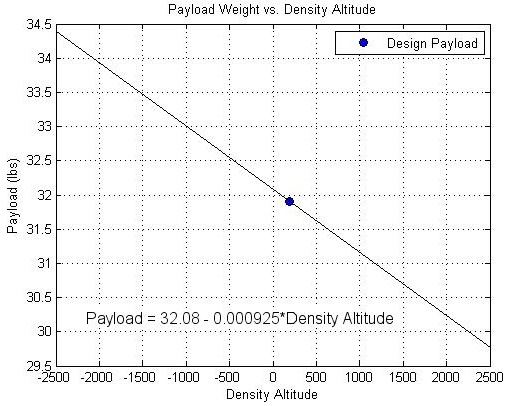
Report_PostSubmission/6_Analysis/payload vs density altitude.jpg
