Aerothon-2020/Reg2015Aircraft_Aerocats/Report_PostSubmission/6_Analysis/spar height_thicknesscropped.png

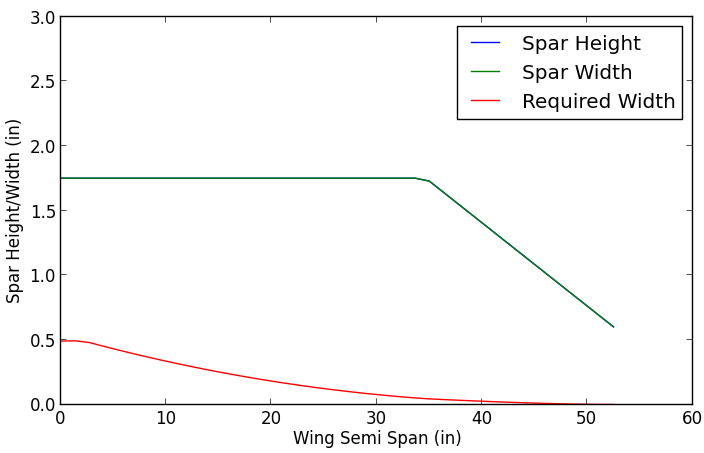
Report_PostSubmission/6_Analysis/spar height_thicknesscropped.png
