Aerothon-2020/Reg2015Aircraft_Aerocats/Report_PostSubmission/Aircraft_ISOview.JPG

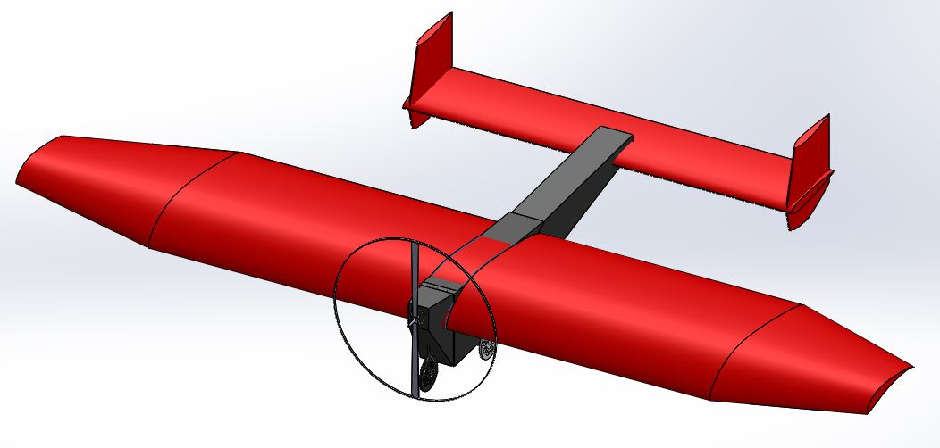
Report_PostSubmission/Aircraft_ISOview.JPG
