Aerothon-2020/Reg2015Aircraft_Aerocats/Structures/CAD/Abbas_CAD/Senior Design CAD/Landing Gear/Factor of saftey 150 lb bearing load edge fixed.JPG

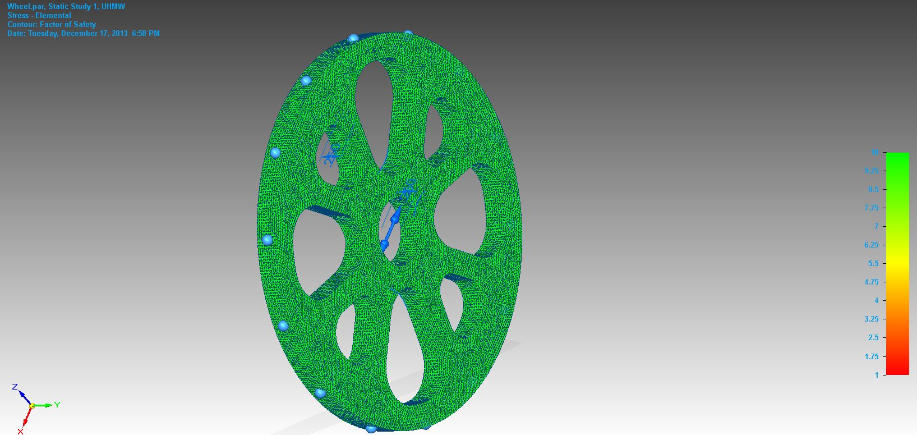
Structures/CAD/Abbas_CAD/Senior Design CAD/Landing Gear/Factor of saftey 150 lb bearing load edge fixed.JPG
