Aerothon-2020/Reg2015Aircraft_Aerocats/Structures/CAD/Abbas_CAD/Senior Design CAD/Landing Gear/Landing Gear.JPG

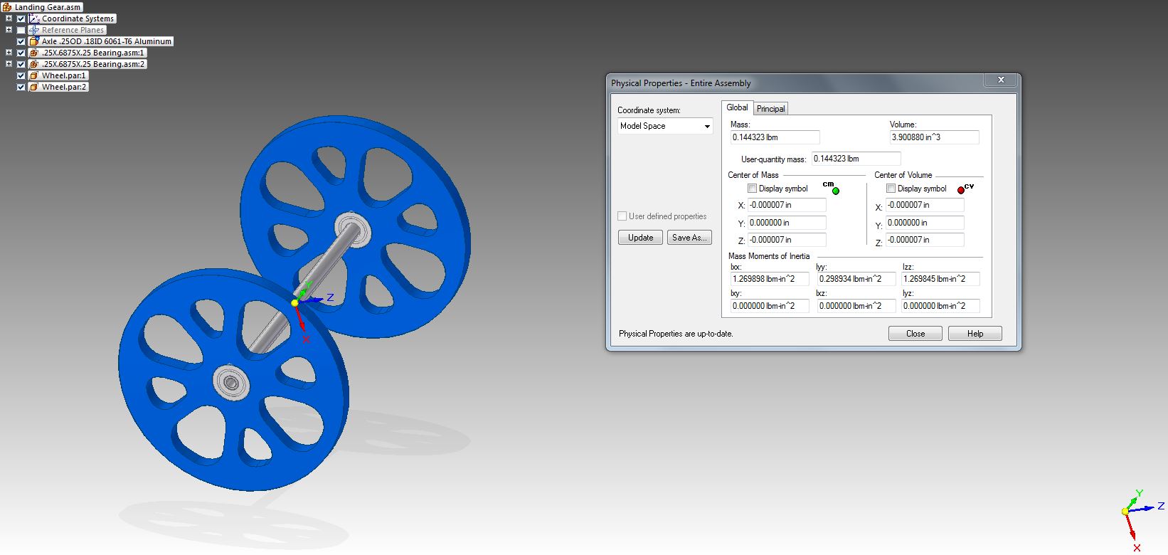
Structures/CAD/Abbas_CAD/Senior Design CAD/Landing Gear/Landing Gear.JPG
