Aerothon-2020/Reg2015Aircraft_Aerocats/Structures/CAD/Abbas_CAD/Senior Design CAD/Nose/Nose/Nose Design.JPG

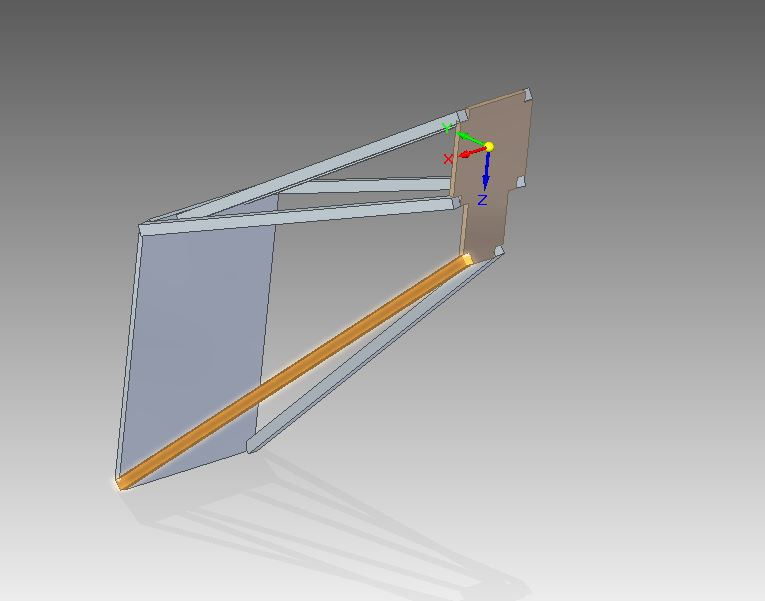
Structures/CAD/Abbas_CAD/Senior Design CAD/Nose/Nose/Nose Design.JPG
