Aerothon-2020/Reg2015Aircraft_Aerocats/Structures/CAD/Abbas_CAD/Senior Design CAD/Pictures/C_VT.jpg

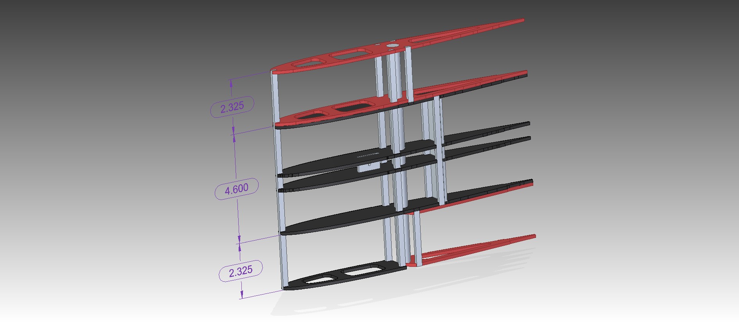
Structures/CAD/Abbas_CAD/Senior Design CAD/Pictures/C_VT.jpg
