Aerothon-2020/Reg2015Aircraft_Aerocats/Structures/CAD/Abbas_CAD/Senior Design CAD/Pictures/Center_Alone.jpg

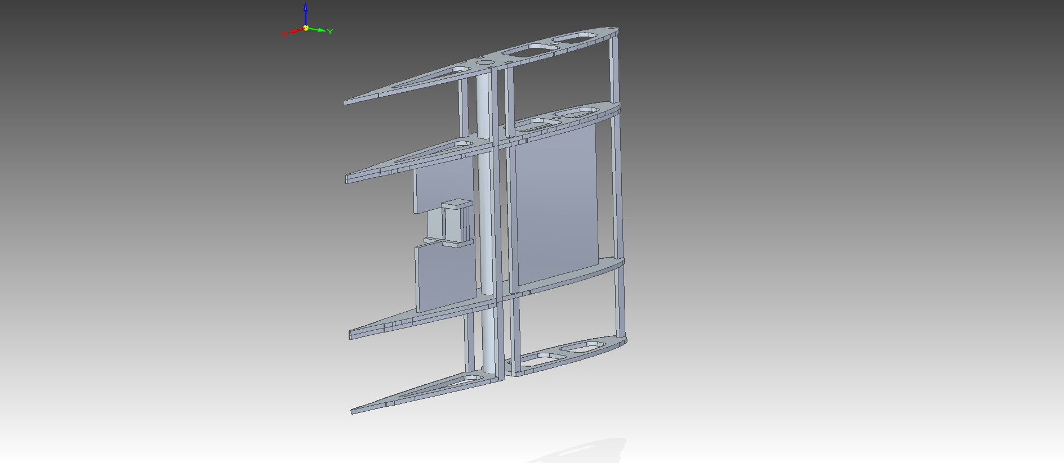
Structures/CAD/Abbas_CAD/Senior Design CAD/Pictures/Center_Alone.jpg
