Aerothon-2020/Reg2015Aircraft_Aerocats/Structures/CAD/Abbas_CAD/Senior Design CAD/Pictures/Side_Vertical_Tail_w.jpg

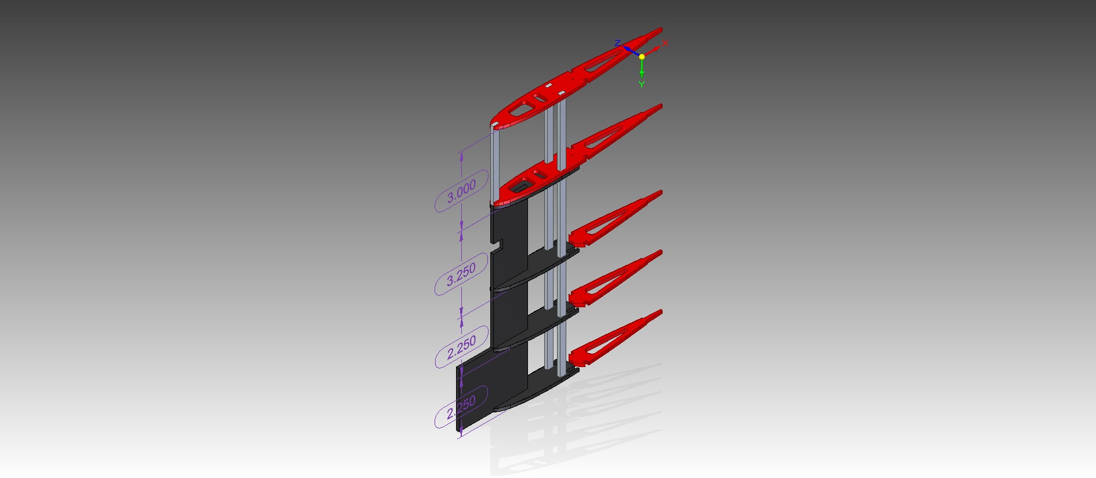
Structures/CAD/Abbas_CAD/Senior Design CAD/Pictures/Side_Vertical_Tail_w.jpg
