Aerothon-2020/Reg2015Aircraft_Aerocats/Structures/CAD/Abbas_CAD/Senior Design CAD/Pictures/VT_2.jpg

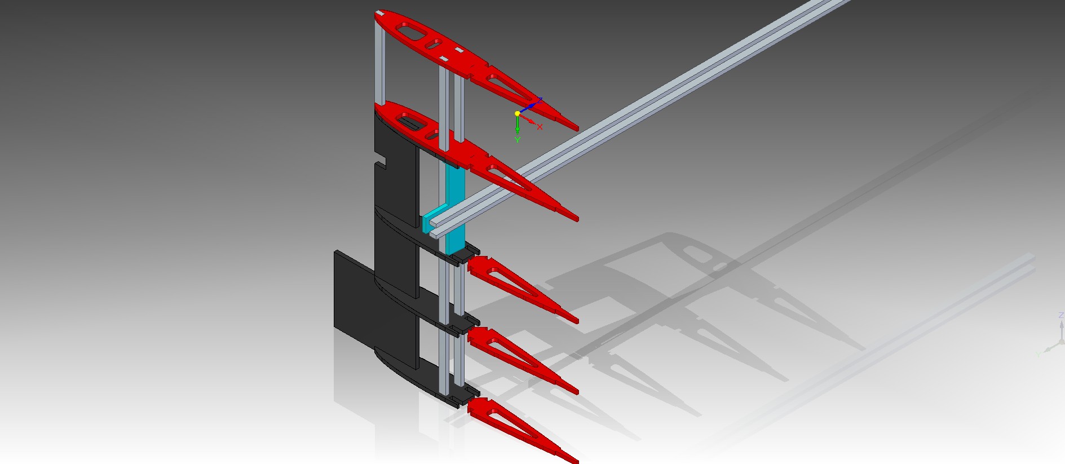
Structures/CAD/Abbas_CAD/Senior Design CAD/Pictures/VT_2.jpg
