Aerothon-2020/Reg2015Aircraft_Aerocats/Structures/CAD/Layouts/fuselage_L40_v1_layoutdraft_v1.jpg

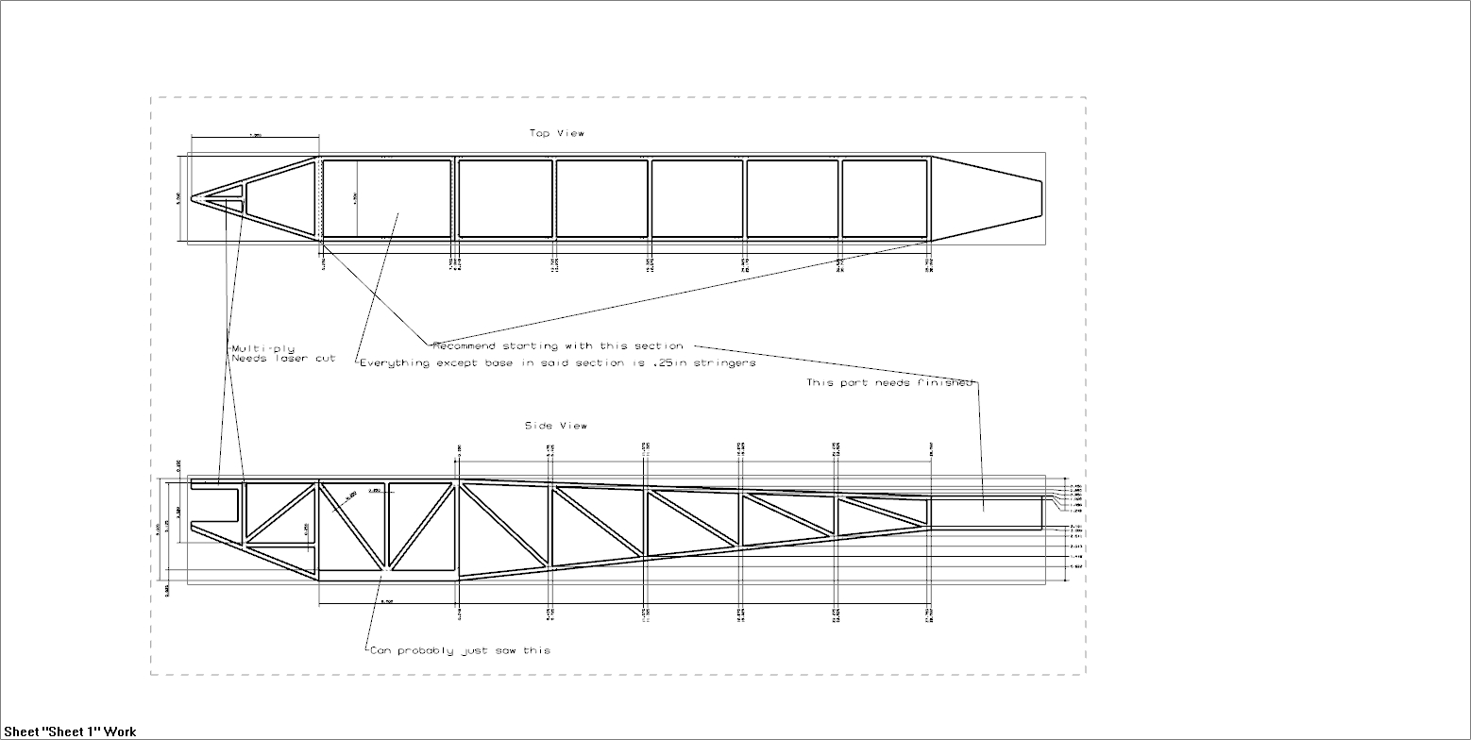
Structures/CAD/Layouts/fuselage_L40_v1_layoutdraft_v1.jpg
