Aerothon-2020/Reg2015Aircraft_Aerocats/Structures/Fuselage.PNG

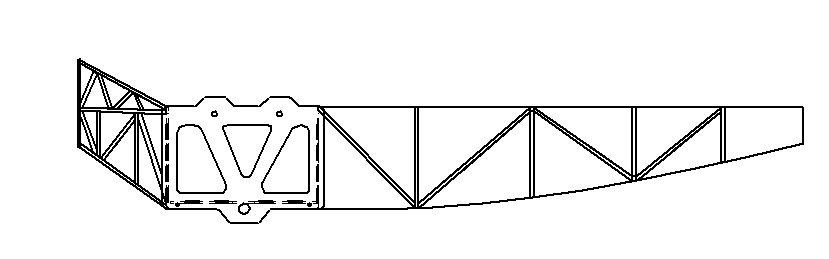
Structures/Fuselage.PNG
