Aerothon-2020/Reg2015Aircraft_Aerocats/Structures/Weights_Table.png

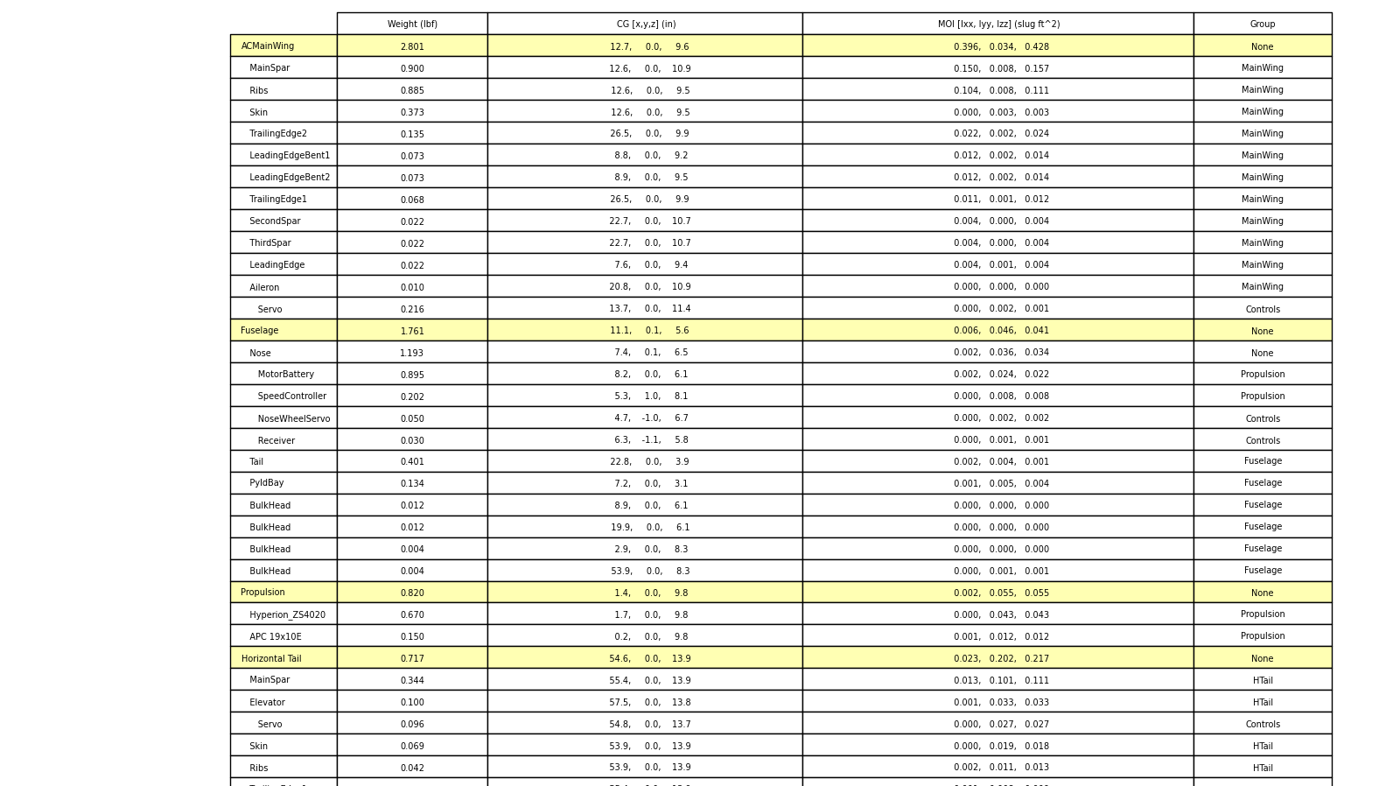
Structures/Weights_Table.png
