Aerothon-2020/Reg2015Aircraft_Aerocats/TradeStudies/Winglet_Study/Winglets_AC_Aero_No_DW.jpg

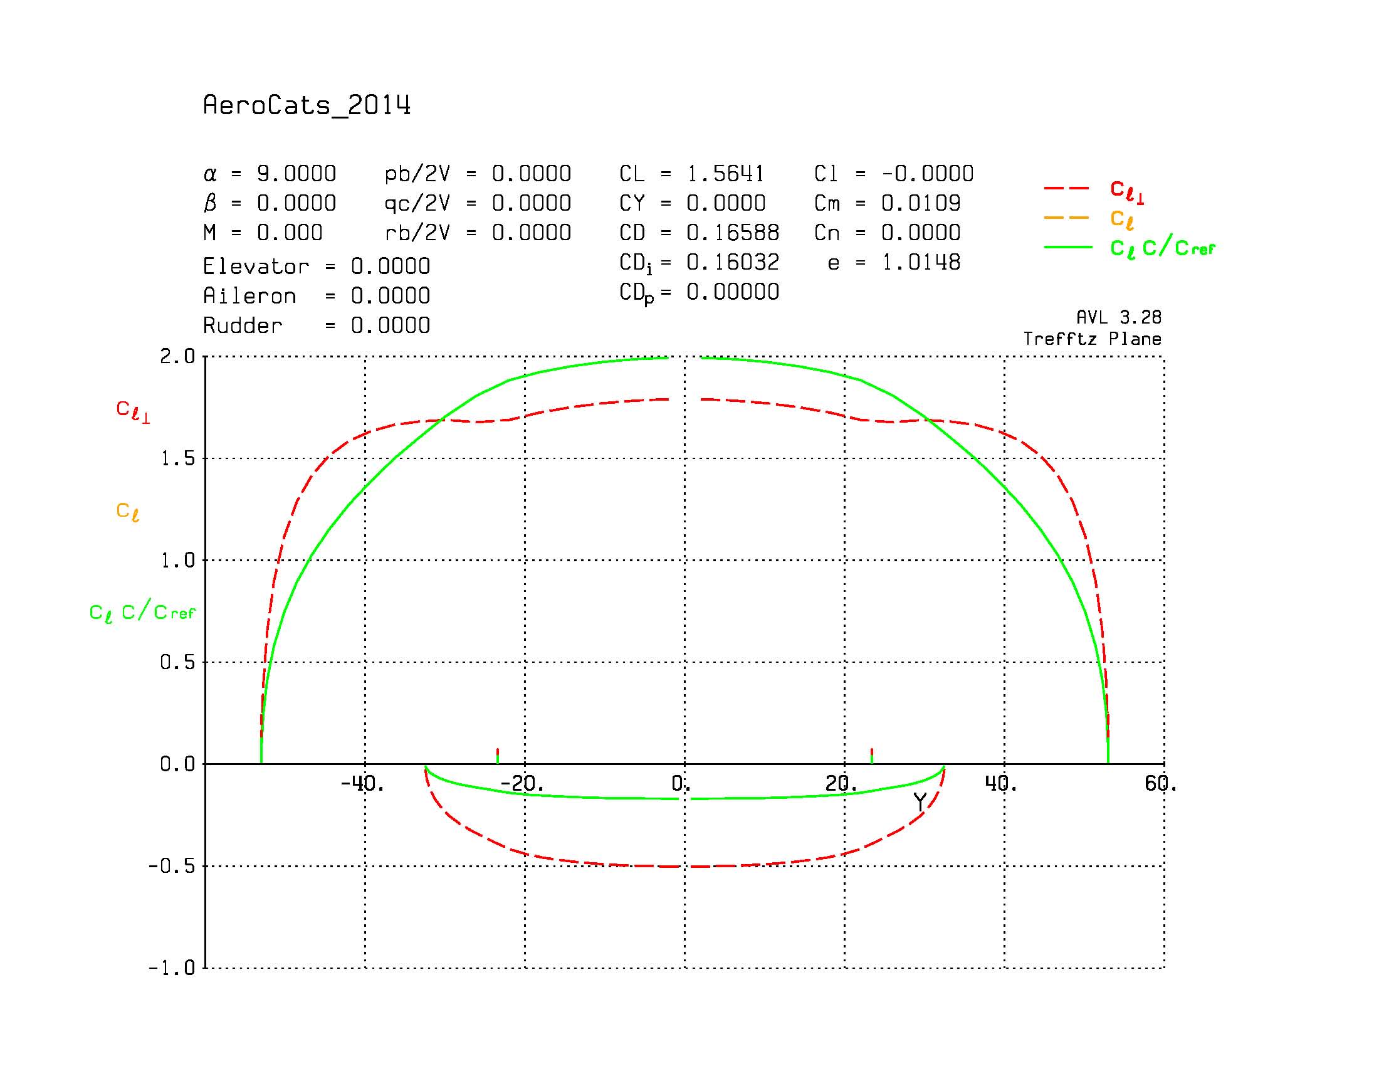
TradeStudies/Winglet_Study/Winglets_AC_Aero_No_DW.jpg
