Aerothon-2020/Reg2015Aircraft_Aerocats/Treasurer Files/Receipts and such/Screenshot (4).png

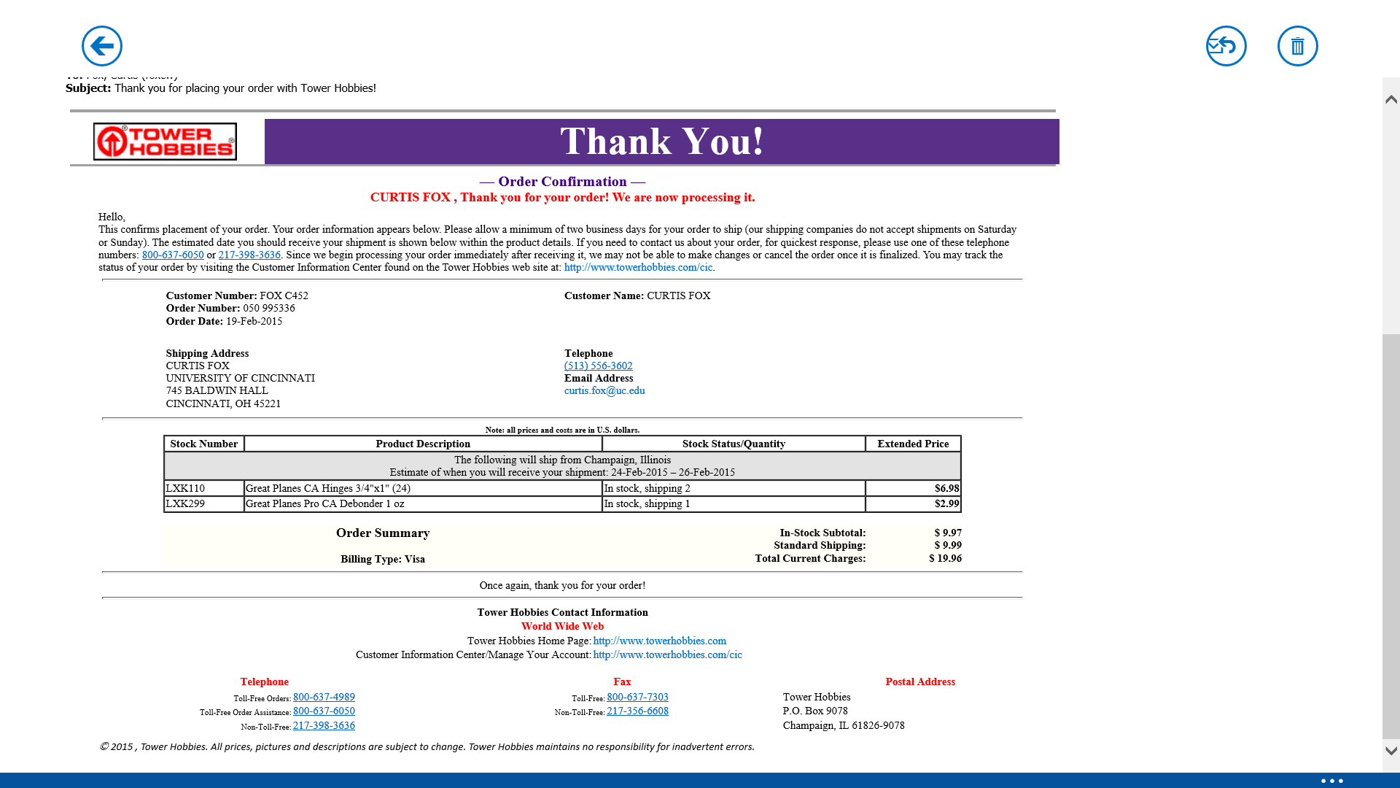
Treasurer Files/Receipts and such/Screenshot (4).png
