Aerothon-2020/Reg2015Aircraft_Aerocats/Treasurer Files/Swag/Cincinnati.png

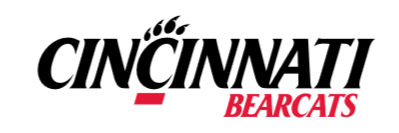
Treasurer Files/Swag/Cincinnati.png
