Aerothon-2020/Reg2015Aircraft_Aerocats/Treasurer Files/Swag/Screenshot (65).png

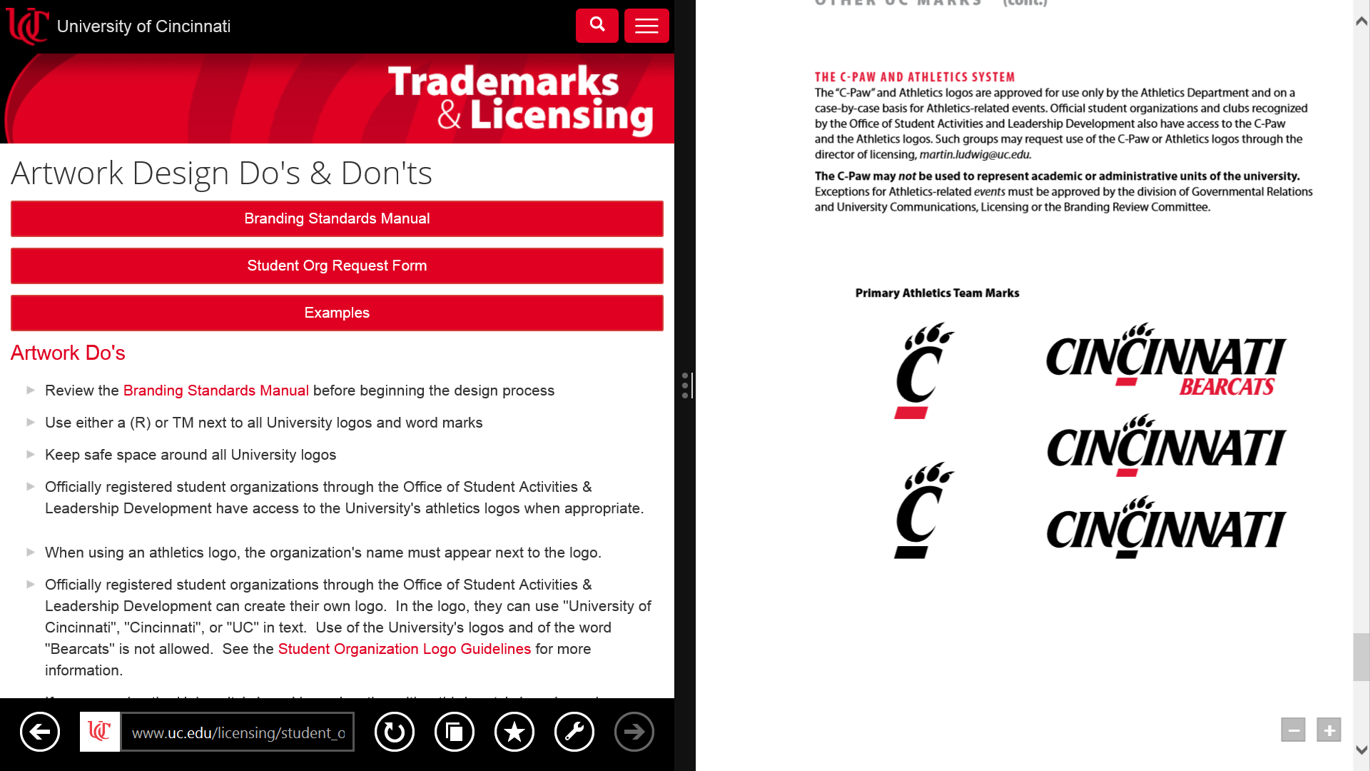
Treasurer Files/Swag/Screenshot (65).png
