Aerothon-2020/Reg2015Aircraft_Aerocats/Treasurer Files/Travel Documents/Driving Certs and Rental Information/Driving Certificate TJ.png

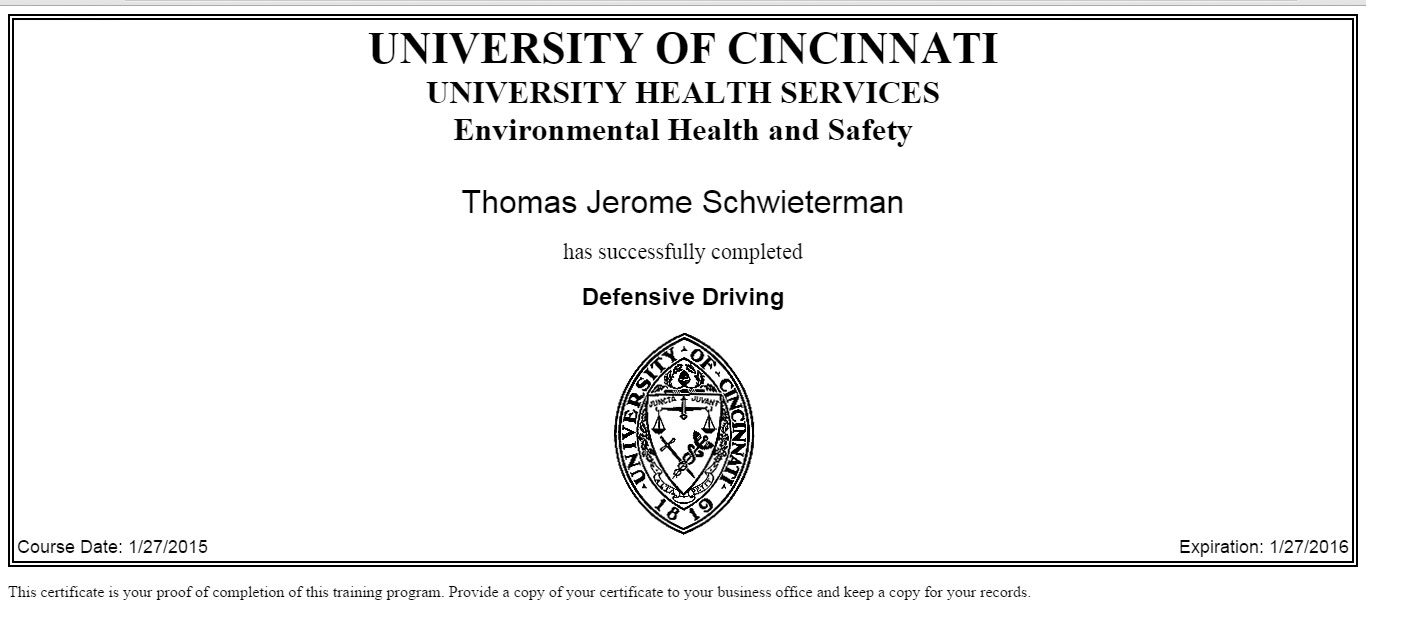
Treasurer Files/Travel Documents/Driving Certs and Rental Information/Driving Certificate TJ.png
