Aerothon-2020/Reg2015Aircraft_Aerocats/Treasurer Files/Travel Documents/Hotel Information/Hotel 01.jpg

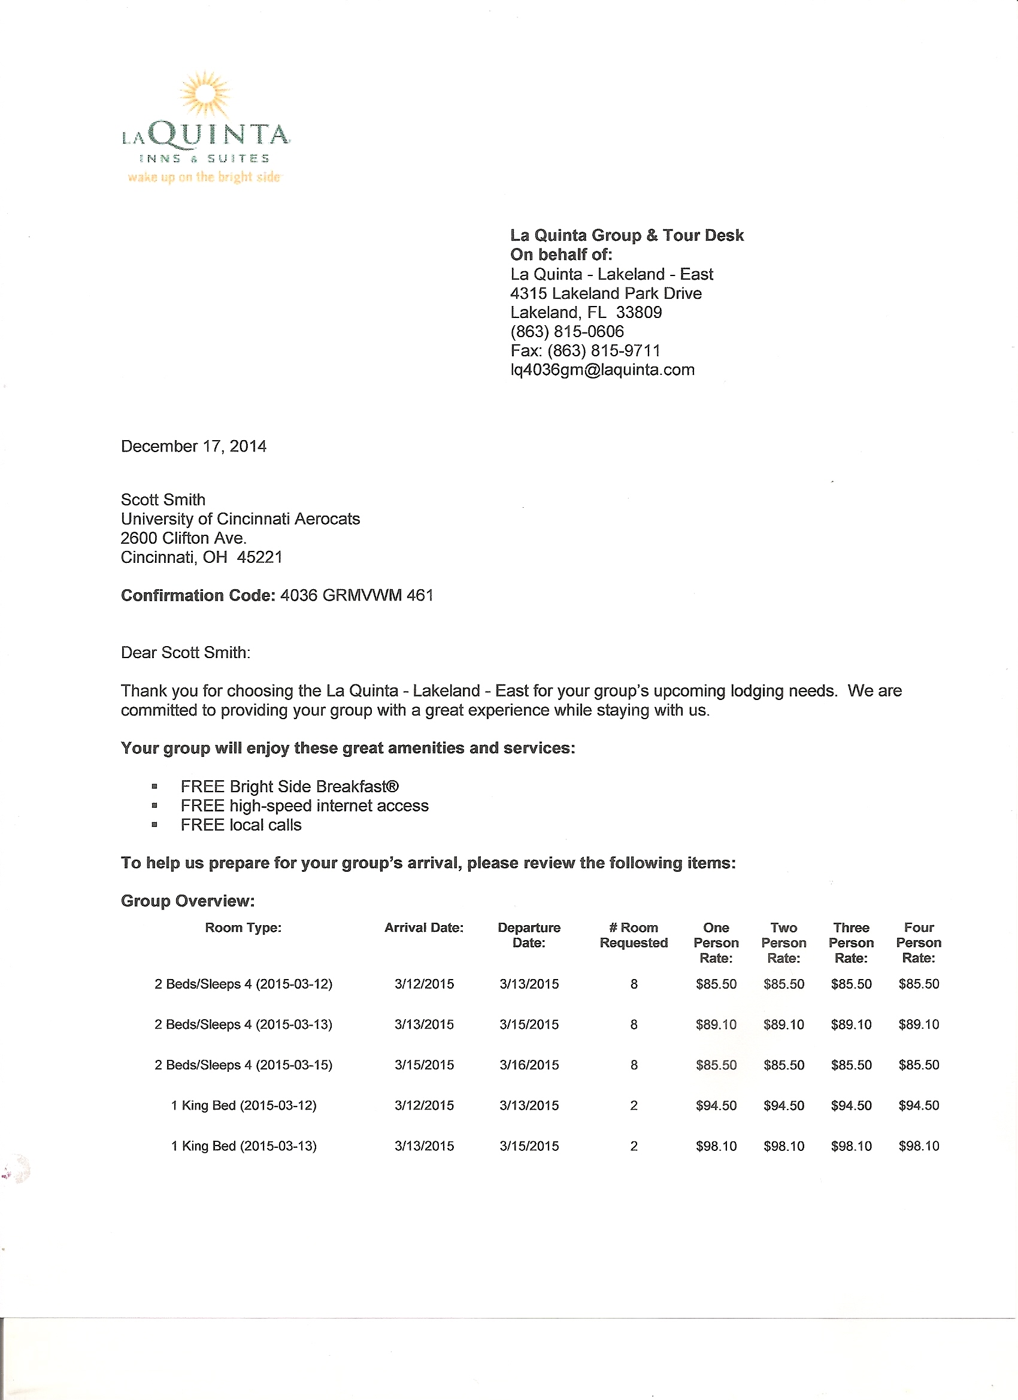
Treasurer Files/Travel Documents/Hotel Information/Hotel 01.jpg
