Aerothon-2020/Reg2015Aircraft_Aerocats/Treasurer Files/Travel Documents/Hotel Information/Hotel 02.jpg

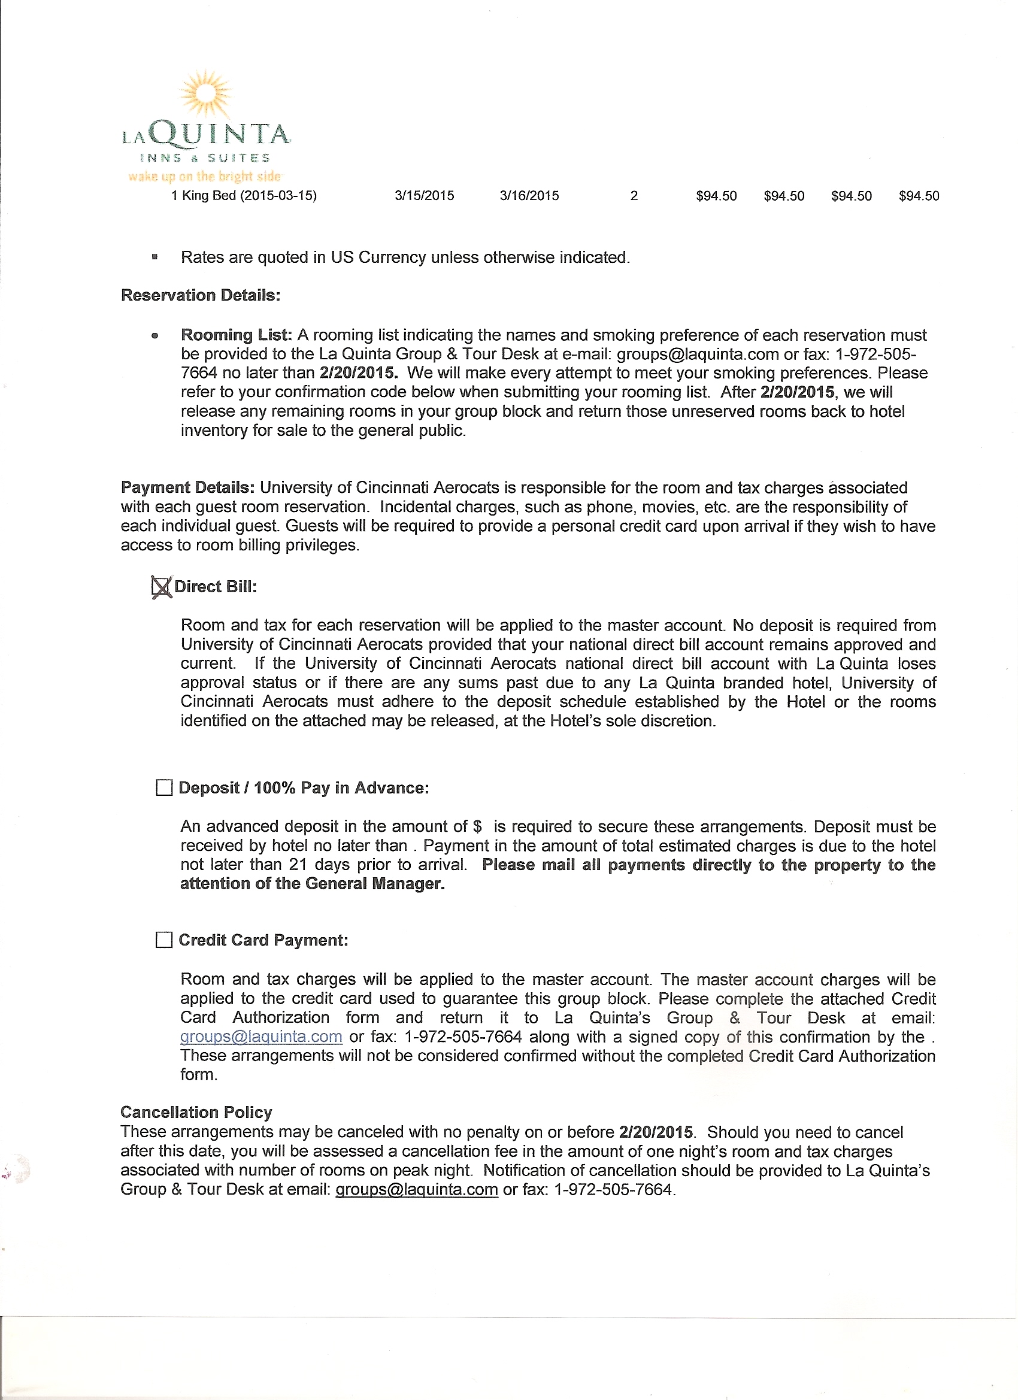
Treasurer Files/Travel Documents/Hotel Information/Hotel 02.jpg
