Aerothon-2020/Reg2015Aircraft_Aerocats/Report_PostSubmission/Nomenclature_FINAL_PostSubmission.pdf

A

## ronyms and Symbols

α | Angle of Atta
k
AVL | Athena Vortex Latti
e
β | Side Slip Angle

## CL,slope Coe

ient of Lift in Relation to Speed

CA | Cyanate A

## ryli

CD | Drag Coe
ient

CFD Computational Fluid Dynami s

CG | Center of Gravity
CL | Lift Coe
ient
Cl,β | Rolling Moment Due to Side Slip
Cn,β | Yawing Moment Due to Side Slip

## CL,max Maximum Lift Coe

ient

CM | Moment Coe
ient

## Cm,α Pit

hing Moment Due to Angle of Atta
k

## ESC Ele

troni

Speed Controller

ζ | Damping Ratio
FOS | Fa

tor of Safety

I0 | No- | Load Current
λ | Dynami
Mode Eigenvalue
KV | Motor Constant
LD | Lift to Drag Ratio

LDmax Maximum Lift to Drag Ratio

MAC Mean Aerodynami

## Chord

MPH Miles per Hour

1

P

R

R

In

ersonal

n

ns p

Resistan

Prote

## tiv

trolled

er M

e

e

nute

Equipment

adio Co

Ri | ternal

R

## PPE

C

RPM | evolutio | i

## UHMW Ultra High Mole

ular Weight

VN | Velo
ity - | Load Fa
tor
ω | Frequen
y

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
