Aerothon-2020/Reg2015Aircraft_Aerocats/Propulsion/Propulsion_Inventory.xlsx

Sheet: Propellers
APC Product Code | Size | Hub Diamter | Hub Thickness | Through Hole Diameter | Weight | Color | Short Description | Description | APC ID | Date Acquired | Competition Year | Additonal Comments
LP11030 | 11x3 | 1.00 in. | 0.52 in. | 1/4 in. | 1.38 oz. | GREY | Sport |  | 23 | unkown | 2014
LP16012E | 16x12E | 1.00 in. | 0.52 in. | 1/4 in. | 2.08 oz. | GREY | Thin Electric | Use LPAR06E adapter rings Includes one set of rings from LPAR06E | 24 | unkown | 2014 | Not marked as "E" on prop, verified with weight
LP16080E | 16x8E | 1.00 in. | 0.52 in. | 1/4 in. | 1.98 oz. | GREY | Thin Electric | Use LPAR06E adapter rings Includes one set of rings from LPAR06E | 24 | unkown | 2014
LP17010E | 17x10E | 1.00 in. | 0.50 in. | 1/4 in. | 2.36 oz. | GREY | Thin Electric | Use LPAR06E adapter rings Includes one set of rings from LPAR06E | 24 | unkown | 2014
LP17060E | 17x6E | 1.00 in. | 0.47 in. | 1/4 in. | 2.33 oz. | GREY | Thin Electric | Use LPAR06E adapter rings Includes one set of rings from LPAR06E | 24 | unkown | 2014 | Not marked as "E" on prop, verified with weight
LP17070E | 17x7E | 1.00 in. | 0.47 in. | 1/4 in. | 2.36 oz. | GREY | Thin Electric | Use LPAR06E adapter rings Includes one set of rings from LPAR06E | 24 | unkown | 2014 | Not marked as "E" on prop, verified with weight
LP17080E | 17x8E | 1.00 in. | 0.48 in. | 1/4 in. | 2.40 oz. | GREY | Thin Electric | Use LPAR06E adapter rings Includes one set of rings from LPAR06E | 24 | unkown | 2014
LP18010E | 18x10E | 1.25 in. | 0.51 in. | 1/4 in. | 3.03 oz. | GREY | Thin Electric | Use LPAR06E adapter rings Includes one set of rings from LPAR06E | 24 | unkown | 2014 | Not marked as "E" on prop, verified with weight
LP18012E | 18x12E | 1.25 in. | 0.53 in. | 1/4 in. | 3.07 oz. | GREY | Thin Electric | Use LPAR06E adapter rings Includes one set of rings from LPAR06E | 24 | unkown | 2014 | Not marked as "E" on prop, verified with weight
LP18012WE | 18x12WE | TBD | TBD | 1/4 in. | TBD | GREY | Thin Electric Wide | Use LPAR06E adapter rings Includes one set of rings from LPAR06E | 24 | unkown | 2014
LP18080E | 18x8E | 1.25 in. | 0.51 in. | 1/4 in. | 3.03 oz. | GREY | Thin Electric | Use LPAR06E adapter rings Includes one set of rings from LPAR06E | 24 | unkown | 2014
LP18080E | 18x8E | 1.25 in. | 0.51 in. | 1/4 in. | 3.03 oz. | GREY | Thin Electric | Use LPAR06E adapter rings Includes one set of rings from LPAR06E | 24 | unkown | 2014 | Not marked as "E" on prop, verified with weight
LP19010E | 19x10E | 1.25 in. | 0.53 in. | 1/4 in. | 3.46 oz. | GREY | Thin Electric | Use LPAR06E adapter rings Includes one set of rings from LPAR06E | 24 | unkown | 2014 | Not marked as "E" on prop, verified with weight
LP19012E | 19x12E | 1.25 in. | 0.54 in. | 1/4 in. | 3.46 oz. | GREY | Thin Electric | Use LPAR06E adapter rings Includes one set of rings from LPAR06E | 24 | unkown | 2014 | Can't verify with weight
LP19012WE | 19x12WE | 1.25 in. | 0.55 in. | 1/4 in. | 3.95 oz. | GREY | Thin Electric Wide Blade | Use LPAR06E adapter rings Includes one set of rings from LPAR06E | 24 | unkown | 2014
LP19012WE | 19x12WE | 1.25 in. | 0.55 in. | 1/4 in. | 3.95 oz. | GREY | Thin Electric Wide Blade | Use LPAR06E adapter rings Includes one set of rings from LPAR06E | 24 | unkown | 2014 | Not marked as "E" on prop, verified with weight
LP19080E | 19x8E | 1.25 in. | 0.50 in. | 1/4 in. | 3.46 oz. | GREY | Thin Electric | Use LPAR06E adapter rings Includes one set of rings from LPAR06E | 24 | unkown | 2014 | Can't verify with weight

Sheet: Motors
Manufacturer | Model | Weight [g] | Winding | Magnet Count | Resistance | IO (@ 10V) [A] | KV [rpm/V] | Typical Current | Max Current [A] | Typical Power [W] | LiPo Range | Dimensions
Hyperion | HP-ZS4020-12 | 304 | 12T | 14 | 0.016 Ohm | 1.4 | 543 | 45A~75A | 90 | 1800 | 3S~7S (4/5) | http://media.hyperion.hk/dn/zs/ZS40-DIM.pdf
Hyperion | HP-ZS4020-12 | 304 | 12T | 14 | 0.016 Ohm | 1.4 | 543 | 45A~75A | 90 | 1800 | 3S~7S (4/5)
Hacker | A40-10L (V2) | 272 |  |  |  |  | 500 | 45A | 55
O.S. Motor | QMA-5020-490 | 350 |  |  |  |  | 490 | 45-75A | 90 | 1100
Axi | 4120/18 | 320 |  |  |  |  | 515 |  | 52

Sheet: Misc Tools
Item | Storage Location
Propeller Reamer | Prop boxes in black cabinet
LiPo Explosion Bag | With batteries, black cabinet
