Aerothon-2020/Reg2015Aircraft_Aerocats/Treasurer Files/Copy of CC Request Form.xls

Purchase Order and Credit Card Request Worksheet
 | Please print or type your information! Thank you
Organization Name | Aerocats |  | Date Received
Event/Program | SAE Aero Design Competition |  | Date Processed
Contact Name | Scott Smith |  | Document Number
Contact Phone # | 440.991.7533 |  | Purchase Order Number
Contact Email Address | smith5sp@mail.uc.edu |  | Pcard Charge Month
Date Needed/Date of Event | 3/12/2015 |  | Receipt |  | Yes No
 |  |  | P.O. __ P-card___ NIU ___ Other ___
Vendor Information |  |  | Accounting Data
Vendor Name | LaQuinta - Lakeland - East |  | Suggested Vendor Code
Vendor Address | 4315 Lakeland Park Drive |  | GL
City, State Zip | Lakeland, FL 33809 |  | Fund
Vendor Contact | Courtney Smith |  | Cost Ctr.
Vendor Phone | 1-800-642-4239 option 2 |  | Funct.
Web site Address | courtney.smith@laquinta.com
Reason for the charge/purchase & description of item(s) being purchased/paid for example; (quotes, confirmations, contracts). Attach any documentation (quotes, confirmations, contracts etc.) |  | QTY | # of Units (each/case) | Unit Cost | Total Cost
Hotel Rooms for our competition weekend! |  | 2 bed hotel room (8) | 2 | 85.50 | 1368
 |  | 2 bed hotel room (8) | 2 | 89.10 | 1425.6
 |  | 1 bed hotel room (2) | 2 | 94.50 | 378
 |  | 1 bed hotel room (2) | 2 | 98.10 | 392.4
PLEASE CHECK THE TYPE OF FUNDING BEING USED
UFB PROGRAM/EVENT APPROVED FUNDS ____
(COPY OF APPROVED UFB FUNDING REQUEST MUST BE ATTACHED SHOWING APPROVAL) |  | Advisor Signature Print Advisor Signature Sign
$300 OPERATING FUNDS _____ AIC FUNDS____ | CLUB SPORTS____STUDENT GOVERNMENT____
UFB EXEC BOARD
(ADVISOR/TREASURER SIGNATURE IS REQUIRED) |  | Treasurer Signature Print |  | Treasurer Signature Sign
BEARCAT LIVE____DIVERSITY ED____PAC____ | FRATERNITY/SORORITY____LEADERSHIP____
NIGHTWALK____RAPP____SAB____SALD____ | WORLDFEST____ | PLEASE READ
(ADVISOR SIGNATURE IS REQUIRED) |  | I understand that if I do not provide a receipt within two weeks of an event, our group will be in
 |  | jeopardy of not being able to use the charge card and funds will be frozen for the remainder of the
 |  | academic year.
