Aerothon-2020/Reg2015Aircraft_Aerocats/Treasurer Files/Budget Sheets/Budget_2015.xlsx

Sheet: Budget Overview
Projected Expenses
Registration Cost |  | Competition Costs |  | Equipment & Material Cost |  | Total Proposed Expenses
 |  |  |  |  |  | Net | $16550.00
Regular Team | $750.00 | Other Travel | $1875.00 | Controls Equipment | $650.00 |  |  |  |  | 0
Individual | $375.00 | Compeition Travel | $1000.00 | Propulsion Equipment | $1600.00
 |  | Lodging | $4000.00 | Building Materials | $2100.00 | Total: | $16550.00
Total | $1125.00 |  |  | Miscellaneous | $4200.00
 |  | Total | $6875.00
 |  |  |  | Total | $8550.00
Available Funds |  | Net Balance |  |  |  |  |  | Twitter | smith5sp@mail.uc.edu
UFB | $9000.00 | $1950.00 |  |  |  |  |  |  | UCAerocats
Aerocats '14 | $3000.00 |  |  |  |  |  |  |  | Aerocat$2015
Belcan | $5000.00
ATK | $250.00
Kinetic Vision | $250.00
Award Money | $1000.00
Total: | $18500.00

Sheet: Registration and Competition
Registration and Competition Costs
Total Budgeted: | $8000.00
Item (Qty) | Cost | Paid/Reserved/Needs Attention | Date | Company or Website Link | Fund
SAE 2015 Team Registration | $750.00 | Paid | 2014-10-01 | SAE International | UFB
LaQuinta Hotel | $3911.40 | Paid | 2015-03-16 | LaQuinta | UFB
Gas for Vans (Drew) | $115.58 | Processing | 2015-03-16 | Gas Stations | UFB
Gas for Vans (Andre) | $462.60 | Processing | 2015-03-16 | Gas Stations | UFB
Advisor Plane Ticket | $290.20 | Processing | 2014-11-06 | Delta | UFB
Pilot Plane Ticket | $450.71 | Paid | 2015-02-20 | Delta | UFB
Advisor/Pilot Rental Car | $395.14 | Processing | 2015-03-16 | Rental Car Company | UFB
Cargo Van Rental | $370.00 | Turned in | 2015-03-17 | UC | UFB
Passenger Van #1 Rental | $523.00 | Turned in | 2015-03-17 | UC | UFB
Passenger Van #2 Rental | $523.00 | Turned in | 2015-03-17 | UC | UFB
Gas for Vans (Scott) | $153.55 | Processing | 2015-03-16 | Gas Station | UFB
Total Expenses: | $7945.18
Net Balance: | $54.82

Sheet: Controls Equipment
Controls Equipment
Total Budgeted: | $650.00
Item (Qty) | Cost (shipping included) | Received | Date | Company | Notes | Fund
Electrical Parts | $34.28 | Y |  | Hobby King |  | Aero
Wire / Servos | $100.47 | Y |  | Tower Hobbies |  | Aero
Servos | $344.30 | Y |  | Hobby King |  | Aero
Deans Connectors | $28.90 | Y |  | Tower Hobbies |  | Aero
Servo Arms | $0.00 |  | 2015-02-26 | Tower Hobbies | http://www3.towerhobbies.com/cgi-bin/wti0001p?&I=LXD668&P=ML | Aero
Servo Arms | $0.00 |  | 2015-02-26 | Tower Hobbies | http://www3.towerhobbies.com/cgi-bin/wti0001p?&I=LXD671&P=ML | Aero
Control Horns (4) | $94.11 |  | 2015-02-26 | Tower Hobbies | http://www3.towerhobbies.com/cgi-bin/wti0001p?&I=LXD934&P=7 | Aero
Control Horns (4) | $0.00 |  | 2015-02-26 | Tower Hobbies | http://www3.towerhobbies.com/cgi-bin/wti0001p?&I=LXK108&P=M | Aero
Wires (6) | $0.00 |  | 2015-02-26 | Tower Hobbies | http://www3.towerhobbies.com/cgi-bin/wti0001p?&I=LXDAXL&P=7 | Aero
Clevises | $0.00 |  | 2015-02-26 | Tower Hobbies | http://www3.towerhobbies.com/cgi-bin/wti0001p?&I=LXK081&P=ML | Aero
Total Expenses: | $602.06
Net Balance: | $47.94

Sheet: Building Materials
Building Materials
Total Budgeted: | $2100.00
Item (Qty) | Cost (shipping included) | Date | Company | Fund | Notes
Basswood sheet (60) | $78.27 | 2014-10-20 | National Balsa | Aero
Glue | $18.73 |  | Bob Smith Industries | Aero
Basswood | $415.80 |  | National Balsa | Aero
Glue | $27.29 |  | Heads Up Supply | Aero
Plastic / cotter pins / lubricant | $49.20 |  | McMaster | Aero
Aluminum Tube | $12.87 |  | McMaster | Aero
Parts | $129.75 |  | Hobby City | Aero
Monokote / Servo Arms | $107.22 |  | Tower Hobbies | Aero
Table Saw | $148.33 |  | Home Depot | Aero
Monokote / Servo Arms | $139.00 |  | Tower Hobbies | Aero
Basswood Sheets (30) | $47.96 | 2015-02-19 | National Balsa | Aero | http://www.nationalbalsa.com/basswood_sheet_p/18224bsh.htm
UtraCote Black (2) | $31.98 | 2015-02-19 | Horizon Hobby | Aero | http://www.horizonhobby.com/ProductDisplay?product_identifier_token=product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
UltraCote Red (6) | $101.94 | 2015-02-19 | Horizon Hobby | Aero | http://www.horizonhobby.com/ProductDisplay?product_identifier_token=product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
24 CA Hinges (2) | $11.98 | 2015-02-19 | Tower Hobbies | Aero | http://www.horizonhobby.com/ProductDisplay?product_identifier_token=product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
1-oz Bottle of CA Debonder | $7.98 | 2015-02-19 | Tower Hobbies | Aero | http://www.horizonhobby.com/ProductDisplay?product_identifier_token=product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
UHMW Sheet (4) | $52.70 | 2015-02-24 | Amazon | Aero | http://www.amazon.com/gp/product/B000ILJZE8/ref=oh_aui_detailpage_o03_s00?ie=UTF8&psc=1
1/8" x 1/4" x 48" Balsa (30) | $37.10 | 2015-02-26 | National Balsa | Aero | http://www.nationalbalsa.com/balsa_wood_p/181448.htm
1/8" x 1/8" x 48" Balsa (10) | $0.00 | 2015-02-26 | National Balsa | Aero | http://www.nationalbalsa.com/balsa_wood_p/181848.htm
1/32" x 4" x 24" Balsa (4) | $0.00 | 2015-02-26 | National Balsa | Aero | http://www.nationalbalsa.com/balsa_wood_p/132424.htm
1/32" x 6" x 24" Balsa (4) | $0.00 | 2015-02-26 | National Balsa | Aero | http://www.nationalbalsa.com/balsa_wood_p/132624.htm
1" x 1" x 24" Balsa | $0.00 | 2015-02-26 | National Balsa | Aero | http://www.nationalbalsa.com/Balsa_Planks_p/1124.htm
Aileron Stock (4) | $0.00 | 2015-02-26 | National Balsa | Aero | http://www.nationalbalsa.com/Aileron_p/14136as.htm
UltraCote Lite, Transparent Red (12) | $237.86 | 2015-03-03 | Hobby Express | Aero | http://www.horizonhobby.com/ProductDisplay?product_identifier_token=product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
UltraCote, Black (4) | $0.00 | 2015-03-03 | Hobby Express | Aero | http://www.horizonhobby.com/ProductDisplay?product_identifier_token=product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
Hobby Lobby Supplies [Drew] | $34.07 | 2015-03-05 | Hobby Lobby | Aero | Processing
Ace Hardware Supplies [Drew] | $13.03 | 2015-03-12 | ACE Hardware | Aero | Processing
UHMW Sheet (1) [Wybo] | $11.54 | 2015-02-05 | Amazon | Aero | Processing
UHMW Sheet (3) [Wybo] | $47.64 | 2015-01-21 | Amazon | Aero | Processing
Bearings (2) [Wybo] | $16.65 | 2014-12-19 | Applied Industiral Technologies | Aero | Processing
Bearings (6) [Wybo] | $50.73 | 2015-01-28 | Applied Industiral Technologies | Aero | Processing
Various items, including Birch [Wybo] | $84.39 | 2014-12-18 | ACE Hardware | Aero | Processing
Fasteners (2) [Patrick] | $2.82 | 2014-10-09 | ACE Hardware | Aero | Processing
Fasteners, Dowel, Threaded Rod [Patrick] | $9.59 | 2015-03-04 | ACE Hardware | Aero | Processing
Threaded Rod (3) [Patrick] | $16.76 | 2015-03-10 | Grainger | Aero | Processing
Various items [Mike] | $117.63 | 2015-04-16 | Various | Aero | Processing
Total Expenses: | $2060.81
Net Balance: | $39.19

Sheet: Propulsion
Propulsion Equipment
Total Budgeted: | $1600.00
Item (Qty) | Cost (including shipping) | Received | Date | Company | Notes | Fund
Scale | $120.66 | Y | 2014-09-22 | Old Will Knot Scales |  | Aero
18x8 Wooden Prop | $20.98 | Y | 2014-09-22 | Tower Hobbies |  | Aero
20x8E Prop | $23.12 | Y | 2014-09-22 | APC Prop |  | Aero
Battery (2) | $80.74 | Y | 2014-09-22 | Hobby King |  | Aero
RPM Gauge | $41.85 | Y | 2014-09-22 | Hobby King |  | Aero
Hacker A60 7XS | $217.47 | Y | 2014-10-02 | Aero-Model, Inc. |  | Aero
Hacker A50-14L-V3 | $197.23 | Y | 2014-10-03 | Amazon |  | Aero
Xoar 22x6 Wood | $30.50 | Y | 2014-10-09 | Valley View RC |  | Aero
APC 19x8E | $21.32 | Y | 2014-10-13 | APC Prop |  | Aero
Battery (x2) | $94.47 | Y | 2015-12-15 | Hobby King |  | Aero
Propellors | $79.16 | Y | 2015-12-16 | Hobby King |  | Aero
Battery | $68.05 | Y | 2015-12-17 | Tonzof |  | Aero
Propellors | $63.40 | Y | 2015-12-18 | APC Prop |  | Aero
SAE Limiter | $260.00 | Y | 2015-02-10 | Neutronics |  | Aero
18x10 Propellor | $24.54 | Y | 2014-02-10 | E Spirit Model |  | Aero
Beechwood Propellors | $36.97 | Y | 2015-02-10 | Tower Hobbies |  | Aero
Deans Connectors (2) | $0.00 | Y | 2014-02-26 | Tower Hobbies | http://www3.towerhobbies.com/cgi-bin/wti0001p?&I=LXKX39&P=ML | Aero
20x8E Propellers (3) | $56.71 | Y | 2015-02-26 | APC Prop | http://www.apcprop.com/ProductDetails.asp?ProductCode=LP20080E | Aero
Switch harness/charge cord [Wybo] | $11.99 | Y | 2015-03-12 | HobbyTown USA | Processing | Aero
Charger Lead w/ RX Connector [Wybo] | $2.99 | Y | 2015-03-12 | HobbyTown USA | Processing | Aero
ELECTRIFLYAC / DCTRITONEQCHR [Wybo] | $99.99 | Y | 2015-03-12 | HobbyTown USA | Processing | Aero
CHRG LEAD BANANA/DNS MALE [Wybo] | $7.99 | Y | 2015-03-12 | HobbyTown USA | Processing | Aero
Purchas Tax [Wybo] | $8.61 | Y | 2015-03-12 | HobbyTown USA | Processing | Aero
Total Expenses: | $1568.74
Net Balance: | $31.26

Sheet: Miscellaneous
Miscellaneous Expenses
Item (Qty) | Cost (shipping included) | Received | Date | Company | Fund
Original Logo Design, w/ 2-3 Revisions | $340.00 | Paid | 2014-12-15 | klean Design | UFB
Gear (UFB Funded) | $297.00 | Paid |  |  | UFB
Gear (Aero Dept Funded) | $540.00 | Paid |  |  | Aero
Santiago Travel | $142.60 | Processing | 2015-03-16 |  | Aero
Per Diem Alejandro | $74.95 | Processing | 2015-03-16 |  | Aero
Per Diem Andre | $123.19 | Processing | 2015-03-16 |  | Aero
Per Diem Andy | $94.64 | Processing | 2015-03-16 |  | Aero
Per Diem Bo | $176.99 | Processing | 2015-03-16 |  | Aero
Per Diem Briana | $127.06 | Processing | 2015-03-16 |  | Aero
Per Diem Christine | $83.57 | Processing | 2015-03-16 |  | Aero
Per Diem Drew | $106.75 | Processing | 2015-03-16 |  | Aero
Per Diem Jake | $74.95 | Processing | 2015-03-16 |  | Aero
Per Diem Josh | $152.37 | Processing | 2015-03-16 |  | Aero
Per Diem Wybo | $153.73 | Processing | 2015-03-16 |  | Aero
Per Diem Mike | $51.68 | Processing | 2015-03-16 |  | Aero
Per Diem Patrick | $150.15 | Processing | 2015-03-16 |  | Aero
Per Diem Scott | $92.43 | Processing | 2015-03-16 |  | Aero
Per Diem TJ | $97.64 | Processing | 2015-03-16 |  | Aero
Per Diem Santiago | $150.00 | Processing | 2015-03-16 |  | Aero
Scott Smith | $30.00 | Processing | 2015-03-16 |  | UFB
Christine Weaver | $48.70 | Processing | 2015-03-16 |  | Aero
Plaques (28) [Mark] | $458.79 | Processing | 2015-04-21 |  | Aero
Kontronik Jive for Santiago | $606.85 | Paid | 2015-04-22 |  | Aero
Total Expenses: | $4174.04

Sheet: Financial Report
Current Financial Report |  | Sponsor's Information
 |  | Sponsor | Year | Amount | Other Contributions | Point of Contact
Total Funds Acquired: | $18500.00 | OSGC | 2014 | $5000.00
Total Expenses Made: | $16350.83 | Gulfstream | 2014 | $3000.00
 |  | Kinetic Vision | 2014 | $250.00
 |  | TECT | 2014 | $5650.00
Total Net Balance: | $2149.17 | Foxlite | 2015 | $0.00 | Free Laser Cut
 |  | GE Aviation | 2015 | $0.00 | Materials and | Mike McMahon
Expenses Made By Group: |  | ATK | 2015 | $250.00 | n/a | Josh
Competition: | $7945.18 | Kinetic Vision | 2015 | $250.00 | N/a | AJ Boissoneault
Controls: | $602.06
Building Materials: | $2060.81
Propulsion: | $1568.74
Miscellaneous: | $4174.04
Remaining Budget by Source
Amount from UFB: | $9000.00
UFB funds spent: | $8582.18
UFB remaining: | $417.82
Amount from CEAS: | $9500.00
CEAS funds spent: | $7768.65
CEAS remaining: | $1731.35

Sheet: Checklist
Aerocats Treasurer Checklist
 | Familiarize yourself with the UFB page on uc.edu - ALL FORMS YOU NEED ARE ON THERE
 | Go to the UFB / AIC Training Session with Advisor and President
 | Always have Request for Payment and Travel Expense Forms on hand (A113 and A114 forms)
 | Fill out Group Travel Authorization and Roster Form - keep copies of this handy
 | Fill out proper forms whenever the team spends money and record it
 | Register Teams on OPENING DAY
 | Pay Registration Fees - A114 in UFB Office
 |  | We did not cover individual registration fees
 | Find a hotel and reserve rooms
 | Van Rental as early as possible - just ask for cargo vans
 | Fill out all UFB semester expense reports
 | Get the team swag
 | KEEP RECEIPTS FOR EVERYTHING - AND GET CC STATEMENTS AS PROOF OF PURCHASE ASAP
 | Things UFB will NOT pay for:
 |  | Advisor travel if it is different from team
 |  | Food
 |  | Team Gear over $300
 |  | Personal vehcile gas reimbursement
 | Things UFB WILL pay for:
 |  | Registration
 |  | Lodging
 |  | Rental Vehicles
 |  | Gas for rental vehicles
 |  | Miscellaneous, but neccesary costs
