Aerothon-2020/Reg2015Aircraft_Aerocats/Treasurer Files/Swag/CC Request Form_QuarterZips.xls

Purchase Order and Credit Card Request Worksheet
 | Please print or type your information! Thank you
Organization Name | Aerocats |  | Date Received
Event/Program | SAE Aircraft Design East |  | Date Processed
Contact Name | Scott Smith |  | Document Number
Contact Phone # | (440) 991-7533 |  | Purchase Order Number
Contact Email Address | smith5sp@mail.uc.edu |  | Pcard Charge Month
Date Needed/Date of Event | ASAP |  | Receipt |  | Yes No
 |  |  | P.O. __ P-card___ NIU ___ Other ___
Vendor Information |  |  | Accounting Data
Vendor Name | kollegetown Sports |  | Suggested Vendor Code
Vendor Address | 6111 Pepsi Way |  | GL
City, State Zip | Windsor, WI 53598 |  | Fund
Vendor Contact | Abby Mazzie |  | Cost Ctr.
Vendor Phone | (267) 844-2850 |  | Funct.
Web site Address | www.kollegetown.com
Reason for the charge/purchase & description of item(s) being purchased/paid for example; (quotes, confirmations, contracts). Attach any documentation (quotes, confirmations, contracts etc.) |  | QTY | # of Units (each/case) | Unit Cost | Total Cost
Aerocats team is purchasing quarter zips with our school approved logo to wear at competition. The 1 time set up fee is included as the QTY 1 to the right. The quarter zips are the QTY 17. |  | 17 | 1 | $45 | $765
 |  | 1 | 1 | $50 | $50
PLEASE CHECK THE TYPE OF FUNDING BEING USED
UFB PROGRAM/EVENT APPROVED FUNDS ____
(COPY OF APPROVED UFB FUNDING REQUEST MUST BE ATTACHED SHOWING APPROVAL) |  | Advisor Signature Print Advisor Signature Sign
$300 OPERATING FUNDS _____ AIC FUNDS_X__ | CLUB SPORTS____STUDENT GOVERNMENT____
UFB EXEC BOARD
(ADVISOR/TREASURER SIGNATURE IS REQUIRED) |  | Treasurer Signature Print |  | Treasurer Signature Sign
BEARCAT LIVE____DIVERSITY ED____PAC____ | FRATERNITY/SORORITY____LEADERSHIP____
NIGHTWALK____RAPP____SAB____SALD____ | WORLDFEST____ | PLEASE READ
(ADVISOR SIGNATURE IS REQUIRED) |  | I understand that if I do not provide a receipt within two weeks of an event, our group will be in
 |  | jeopardy of not being able to use the charge card and funds will be frozen for the remainder of the
 |  | academic year.
