Aerothon-2020/Reg2015Aircraft_Aerocats/Treasurer Files/UFB Funding Request/AIC_Request_Form_Aerocats_2015.xls

Sheet: Directions
Academic Intercollegiate Competition Organizations Budget Allocation Process Directions
 | The following sheets are to assist in the planning of your budgetary activity for the following year and assist in the allocation process.
ALL AIC Organizations should complete the following:
 | Overview of Costs
 | Equipment Inventory Sheet
 | Travel Expenses
 | Materials Inventory

Sheet: Overview of Costs
Academic Intercollegiate Competition Organization: Aerocats
Amount Allocated 14-15 |  | $9000.00
Revenue/Other Funding Sources
 | Amount for Current Fiscal Year (14-15) | Anticipated Amount for Next Fiscal Year (15-16) | Difference
SACUB Funding | $9000.00 | $10000.00 | $1000.00
Membership Dues |  |  | $0.00
Fines |  |  | $0.00
Alumni Donations |  |  | $0.00
Corporate Donations | $8500.00 | $8500.00 | $0.00
Fundraising Projects |  |  | $0.00
Total Revenue | $17500.00 | $18500.00 | $1000.00
Expenditures
Administrative | Amount for Current Fiscal Year | Anticipated Amount for Next Fiscal Year | Difference
Association Fees (local, regional, national, etc.) | $375.00 | $375.00 | $0.00
Printing | $50.00 | $50.00 | $0.00
Postage |  |  | $0.00
Advertising |  |  | $0.00
Costs for drivers/pilots ect. |  |  | $0.00
 |  |  | $0.00
 |  |  | $0.00
 | $425.00 | $425.00 | $0.00
Travel | Amount for Current Fiscal Year | Anticipated Amount for Next Fiscal Year | Difference
Registration Fees | $750.00 | $1500.00 | $750.00
Transportation Services (University Vehicles) | $1692.00 | $1692.00 | $0.00
Other Vehicle Rental (Charter buses) | $400.00 | $400.00 | $0.00
Airline Tickets | $740.91 | $740.91 | $0.00
Gas associated with University Vehicles | $1000.00 | $1000.00 | $0.00
Other Gas | $200.00 | $200.00 | $0.00
Lodging | $3850.00 | $3850.00 | $0.00
Miscellaneous Travel Costs | $2500.00 | $2500.00 | $0.00
 | $11132.91 | $11882.91 | $750.00
Equipment | Amount for Current Fiscal Year | Anticipated Amount for Next Fiscal Year | Difference
Uniforms | $1180.00 | $800.00 | -$380.00
Other clothing or apparrel(safety googles, gloves, ect.) |  |  | $0.00
Facilities rental |  |  | $0.00
Equipment | $150.00 | $0.00 | -$150.00
non-reusable equipment or materials | $3545.19 | $3500.00 | -$45.19
Equipment Rental/Lease |  |  | $0.00
 | $4875.19 | $4300.00 | -$575.19
Total Expend. | $16433.10 | $16607.91 | $174.81

Sheet: Travel Costs
PROJECTED TRAVEL 2014-15 |  |  |  |  |  |  |  |  |  | Gas Cost
DATE | TOURNAMENT | LOCATION | DISTANCE | VEHICLES |  |  |  |  | Gas Cost |  |  |  | HOTELS |  |  |  |  |  | TOTAL TRIP COST
 |  |  | MILES | TYPE | # Days | # | Cost per day per Vehicle | TOTAL | MPG | GAS | #of vehicles | TOTAL | NIGHTS | ROOMS | PRICE | TOTAL | REGISTRATION | OFFICIALS | ESTIMATE
2015-03-12 | SAE Aero Design - EAST | Lakeland, FL | 1900 | 15 Pass | 6 | 3 | $94.00 | $1692.00 | 13 | $3.40 | 3.00 | $1490.77 | 2 | 8 | $95.76 | $1532.16 | $750.00 | $0.00 | $5464.93
 |  |  |  |  |  |  |  | $0.00 |  |  |  |  | 2 | 8 | $99.80 | $1596.80 |  |  | $1596.80
 |  |  |  |  |  |  |  | $0.00 |  |  |  |  | 2 | 2 | $105.84 | $423.36 |  |  | $423.36
 |  |  |  |  |  |  |  | $0.00 |  |  |  |  | 2 | 2 | $109.88 | $439.52 |  |  | $439.52
 |  |  |  |  |  |  |  | $0.00
 |  |  |  |  |  |  |  | $0.00
 |  |  |  |  |  |  |  | $0.00
 |  |  |  |  |  |  |  | $0.00
 |  |  |  |  |  |  |  | $0.00
 |  |  |  |  |  |  |  |  |  |  |  |  |  |  |  |  |  |  | $7924.61
PAST TRAVEL 2013-14
 |  |  |  |  |  |  |  |  |  |  |  |  |  |  |  |  |  |  | $4536.62
 | Key - Transportation Cost
 | Car | Cost per day | Per Gallon Mileage Avg
 | Compact | $36.00 | 31mpg
 | Midsize | $38.00 | 28mpg
 | Full size | $41.00 | 25mpg
 | Mini Van | $59.00 | 17mpg
 | 12/15 passenger van | $94.00 | 13mpg
 | Large SUV | $95.00 | 17mpg

Sheet: Planned Expenditures
EXPENSES 2014-15 FOR NON-TRAVEL
# | EXPENSE | UNIT COST | QUANTITY | TOTAL | CSB FUND | OFF CAMPUS | NOTES | Is this a 2013-14 expense? | Any Notes for 2013-14
EX. | Competition Fees | $650.00 |  | $650.00 | $650.00 |  |  | Yes | Increase to $675
EX. | Team Shirts | $25.00 | 12 | $300.00 |  | $300.00
1 | SAE Team Registration | $750.00 | 1 | $750.00 |  |  | Must Pay | Yes
2 | Electrical Wiring | $34.28 | 1 | $34.28
3 | Wires and Servos | $100.47 | 1 | $100.47
4 | Servo and Servo Arms | $344.30 | 1 | $344.30
5 | Deans Connectors | $28.90 | 1 | $28.90
6 | Control Horns | $94.11 | 1 | $94.11
7 | 60 Basswood Sheets | $78.27 | 1 | $78.27
8 | Wood Glue | $18.73 | 1 | $18.73
9 | Basswood Order | $415.80 | 1 | $415.80
10 | Wood Glue | $27.29 | 1 | $27.29
11 | Plastic / pins / lubricant | $49.20 | 1 | $49.20
12 | Monokote & Servo Arms | $107.22 | 1 | $107.22
13 | Electrical Parts | $129.75 | 1 | $129.75
14 | Table Saw | $148.33 | 1 | $148.33
15 | Monokote & Servo Arms | $139.00 | 1 | $139.00
16 | 30 Basswood Sheets | $47.96 | 1 | $47.96
17 | 2 rolls of black Ultracote | $31.98 | 1 | $31.98
18 | 6 rolls of red Ultracote | $101.94 | 1 | $101.94
19 | 4 packs of CA Hinges | $11.98 | 1 | $11.98
20 | 1-oz Bottle of CA Debonder | $7.98 | 1 | $7.98
21 | 4 UHMW Sheet | $52.70 | 1 | $52.70
22 | Various Balsa Sheets | $37.10 | 1 | $37.10
23 | 16 rols of red and black Ultracote | $237.86 | 1 | $237.86
24 | Scale | $120.66 | 1 | $120.66
25 | 18x8 Wooden Prop | $20.98 | 1 | $20.98
26 | 20x8E Prop | $23.12 | 1 | $23.12
27 | 2 Batteries | $80.74 | 1 | $80.74
28 | RPM Gauge | $41.85 | 1 | $41.85
29 | Hacker A60 7XS | $217.47 | 1 | $217.47
30 | Hacker A50-14L-V3 | $197.23 | 1 | $197.23
31 | 22x6 Wood Prop | $30.50 | 1 | $30.50
32 | APC 19x8E Prop | $21.32 | 1 | $21.32
33 | 2 Batteries | $94.47 | 1 | $94.47
34 | Various Propellers | $79.16 | 1 | $79.16
35 | Battery | $68.05 | 1 | $68.05
36 | Various Propellers | $63.40 | 1 | $63.40
37 | SAE Limiter | $260.00 | 1 | $260.00
38 | 18x10 Propellers | $24.54 | 1 | $24.54
39 | Beechwood Propellers | $36.97 | 1 | $36.97
40 | 20x8E Prop | $56.71 | 1 | $56.71
41 | Team Gear | $1177.00 | 1 | $1177.00
TOTAL |  |  |  | $5609.32 | 0 | 0

Sheet: Materials Inventory)
CURRENT MATERIALS INVENTORY - LIST ALL PURCHASED MATERIALS IN POSSESSION FOR YOUR AIC Organization
# | ITEM DESCRIPTION (INCLUDE QUANTITY) | PURCHASED VALUE | PURCHASE DATE | VENDOR | CONDITION | NOTES OR COLOR, SERIAL #, AND OR DISTINGUISHABLE FEATURES, JERSEY # (IF APPLICABLE) | STORAGE LOCATION
example | 20 Air Filters | $700.00 | 2009-03-01 | NAPA | New | Use for practice only | Organization Storage
1 | 3 Heat Guns | N/A | N/A | N/A | Used | Used for Monokoting | Organization Storage
2 | 4 Heat Irons | N/A | N/A | N/A | Used | Used for Monokoting | Organization Storage
3 | 2 Small Heat Iron | N/A | N/A | N/A | Used | Used for Monokoting | Organization Storage
4 | 10 Exacto Knives | N/A | N/A | N/A | Used |  | Organization Storage
5 | 2 yard sticks | N/A | N/A | N/A | Used |  | Organization Storage
6 | 5 rulers | N/A | N/A | N/A | Used |  | Organization Storage
7 | 1 Electronic Calipers | N/A | N/A | N/A | Used |  | Organization Storage
8 | Assorted Wood Glue | $7 per bottle | Fall 2014 | N/A | Used |  | Organization Storage
9 | Various Clamps | N/A | N/A | N/A | Used |  | Organization Storage
10 | Extension Cord | N/A | N/A | N/A | Used |  | Organization Storage
11 | Table Saw | $148.33 | Fall 2014 | Home Depot | New |  | Organization Storage
12 | Styrafoam Blocks | N/A | N/A | N/A | Used |  | Organization Storage
13 | T-Pins | $3 a pack | Fall 2014 | McMaster | New |  | Organization Storage
14 | Various Wood Pieces | N/A | 2014-2015 | National Balsa | New |  | Organization Storage
15 | Various Sanding Blocks | N/A | N/A | N/A | Used |  | Organization Storage
16
17
18
19
20
21
22
23
24
25
26
27
28
