Aerothon-2020/Reg2015Aircraft_Aerocats/Treasurer Files/UFB Funding Request/Copy of 2014_2015_AeroCats_AIC_Request_Form.xls

Sheet: Directions
Academic Intercollegiate Competition Organizations Budget Allocation Process Directions
 | The following sheets are to assist in the planning of your budgetary activity for the following year and assist in the allocation process.
ALL AIC Organizations should complete the following:
 | Overview of Costs
 | Equipment Inventory Sheet
 | Travel Expenses
 | Materials Inventory

Sheet: Overview of Costs
Academic Intercollegiate Competition Organization: _____________________________
Amount Allocated 13-14 |  | 8000
Revenue/Other Funding Sources
 | Amount for Current Fiscal Year (13-14) | Anticipated Amount for Next Fiscal Year (14-15) | Difference
SACUB Funding | $8000.00 | $10000.00 | $2000.00
Membership Dues |  |  | $0.00
Fines |  |  | $0.00
Alumni Donations |  |  | $0.00
Corporate Donations | $13250.00 | $8000.00 | $5250.00
Fundraising Projects |  |  | $0.00
Total Revenue | $21250.00 | $18000.00 | $3250.00
Expenditures
Administrative | Amount for Current Fiscal Year | Anticipated Amount for Next Fiscal Year | Difference
Association Fees (local, regional, national, etc.) |  | $400.00 | $0.00
Printing |  |  | $0.00
Postage |  |  | $0.00
Advertising |  |  | $0.00
Costs for drivers/pilots ect. |  |  | $0.00
 |  |  | $0.00
 |  |  | $0.00
 | $0.00 | $400.00 | $400.00
Travel | Amount for Current Fiscal Year | Anticipated Amount for Next Fiscal Year | Difference
Registration Fees | $1400.00 | $1500.00 | $0.00
Transportation Services (University Vehicles) | $752.00 | $752.00 | $0.00
Other Vehicle Rental (Charter buses) |  |  | $0.00
Airline Tickets |  |  | $0.00
Gas associated with University Vehicles | $584.62 | $584.62 | $0.00
Other Gas |  |  | $0.00
Lodging | $1800.00 | $1800.00 | $0.00
Miscellaneous Travel Costs |  | $1000.00 | $0.00
 | $4536.62 | $5636.62 | $1100.00
Equipment | Amount for Current Fiscal Year | Anticipated Amount for Next Fiscal Year | Difference
Uniforms | $625.00 | $625.00 | $0.00
Other clothing or apparrel(safety googles, gloves, ect.) |  |  | $0.00
Facilities rental |  |  | $0.00
Equipment | $500.00 | $500.00 | $0.00
non-reusable equipment or materials | $2400.00 | $3000.00 | $600.00
Equipment Rental/Lease |  |  | $0.00
 | $3525.00 | $4125.00 | $600.00
Total Expend. | $8061.62 | $10161.62 | $2100.00

Sheet: Travel Costs
PROJECTED TRAVEL 2014-15 |  |  |  |  |  |  |  |  |  | Gas Cost
DATE | TOURNAMENT | LOCATION | DISTANCE | VEHICLES |  |  |  |  | Gas Cost |  |  |  | HOTELS |  |  |  |  |  | TOTAL TRIP COST
 |  |  | MILES | TYPE | # Days | # | Cost per day per Vehicle | TOTAL | MPG | GAS | #of vehicles | TOTAL | NIGHTS | ROOMS | PRICE | TOTAL | REGISTRATION | OFFICIALS | ESTIMATE
2014-04-11 | SAE AERO East | Marietta, GA | 1000 | 15 Pass | 4 | 2 | $94.00 | $752.00 | 13 | $3.80 | 2.00 | $584.62 | 3 | 6 | $100.00 | $1800.00 | $1500.00 | $0.00 | $4536.62
 |  |  |  |  |  |  |  | $0.00
 |  |  |  |  |  |  |  | $0.00
 |  |  |  |  |  |  |  | $0.00
 |  |  |  |  |  |  |  | $0.00
 |  |  |  |  |  |  |  | $0.00
 |  |  |  |  |  |  |  | $0.00
 |  |  |  |  |  |  |  | $0.00
 |  |  |  |  |  |  |  | $0.00
 |  |  |  |  |  |  |  |  |  |  |  |  |  |  |  |  |  |  | $4536.62
PAST TRAVEL 2013-14
 |  |  |  |  |  |  |  |  |  |  |  |  |  |  |  |  |  |  | $0.00
 | Key - Transportation Cost
 | Car | Cost per day | Per Gallon Mileage Avg
 | Compact | $36.00 | 31mpg
 | Midsize | $38.00 | 28mpg
 | Full size | $41.00 | 25mpg
 | Mini Van | $59.00 | 17mpg
 | 12/15 passenger van | $94.00 | 13mpg
 | Large SUV | $95.00 | 17mpg

Sheet: Planned Expenditures
EXPENSES 2014-15 FOR NON-TRAVEL
# | EXPENSE | UNIT COST | QUANTITY | TOTAL | CSB FUND | OFF CAMPUS | NOTES | Is this a 2013-14 expense? | Any Notes for 2013-14
EX. | Competition Fees | $650.00 |  | $650.00 | $650.00 |  |  | Yes | Increase to $675
EX. | Team Shirts | $25.00 | 12.00 | $300.00 |  | $300.00
1 | Servos | 50 | 20.00 | $1000.00
2 | Receivers | 60 | 2.00 | $120.00
3 | Cables | 50 | 1.00 | $50.00
4 | Radio Controller | 400 | 1.00 | $400.00
5 | Monokote | 250 | 2.00 | $500.00 |  |  | For regular and advanced class
6 | Balsa Wood | 360 | 2.00 | $720.00 |  |  | Unit cost for bulk buy
7 | Other Wood | 300 | 2.00 | $600.00
8 | Trainer Aircraft | 350 | 1.00 | $350.00
9 | Propellers | 20 | 15.00 | $300.00 |  |  | Optimization requirements
10 | Engines | 300 | 4.00 | $1200.00 |  |  | Optimization requirements
11 | Batteries | 25 | 20.00 | $500.00 |  |  | Due to wide variety of sensors
12 | Sensors | 500 | 1.00 | $500.00 |  |  | Covers variety of required sensors
13 | Video/OSD kits | 190 | 1.00 | $190.00
14 | Aircraft Stabilization | 75 | 1.00 | $75.00
15 | Auto Pilot (full set) | 200 | 1.00 | $200.00
16 | On Screen Display | 90 | 1.00 | $90.00
17 | Airspeed Sensor | 43 | 1.00 | $43.00
18 | GPS Module | 80 | 1.00 | $80.00
19 | Ground Station | 100 | 1.00 | $100.00 |  |  | Required for avionics collection
20 | Magnetic Compass | 30 | 1.00 | $30.00
21 | Goggles | 300 | 1.00 | $300.00 |  |  | Specialized for HUD control of sensors
23 |  |  |  | $0.00
24 |  |  |  | $0.00
25 |  |  |  | $0.00
26 |  |  |  | $0.00
27 |  |  |  | $0.00
28 |  |  |  | $0.00
TOTAL |  |  |  | $7348.00 | 0 | 0
Sponsor Total |  |  |  | $3290.00
UFB Total |  |  |  | $4058.00

Sheet: Materials Inventory)
CURRENT MATERIALS INVENTORY - LIST ALL PURCHASED MATERIALS IN POSSESSION FOR YOUR AIC Organization
# | ITEM DESCRIPTION (INCLUDE QUANTITY) | PURCHASED VALUE | PURCHASE DATE | VENDOR | CONDITION | NOTES OR COLOR, SERIAL #, AND OR DISTINGUISHABLE FEATURES, JERSEY # (IF APPLICABLE) | STORAGE LOCATION
example | 20 Air Filters | $700.00 | 2009-03-01 | NAPA | New | Use for practice only | Organization Storage
1
2
3
4
5
6
7
8
9
10
11
12
13
14
15
16
17
18
19
20
21
22
23
24
25
26
27
28
