Aerothon-2020/Reg2015Aircraft_Aerocats/Treasurer Files/Swag/CC Purchase Request_QuarterZips_Signed.pdf

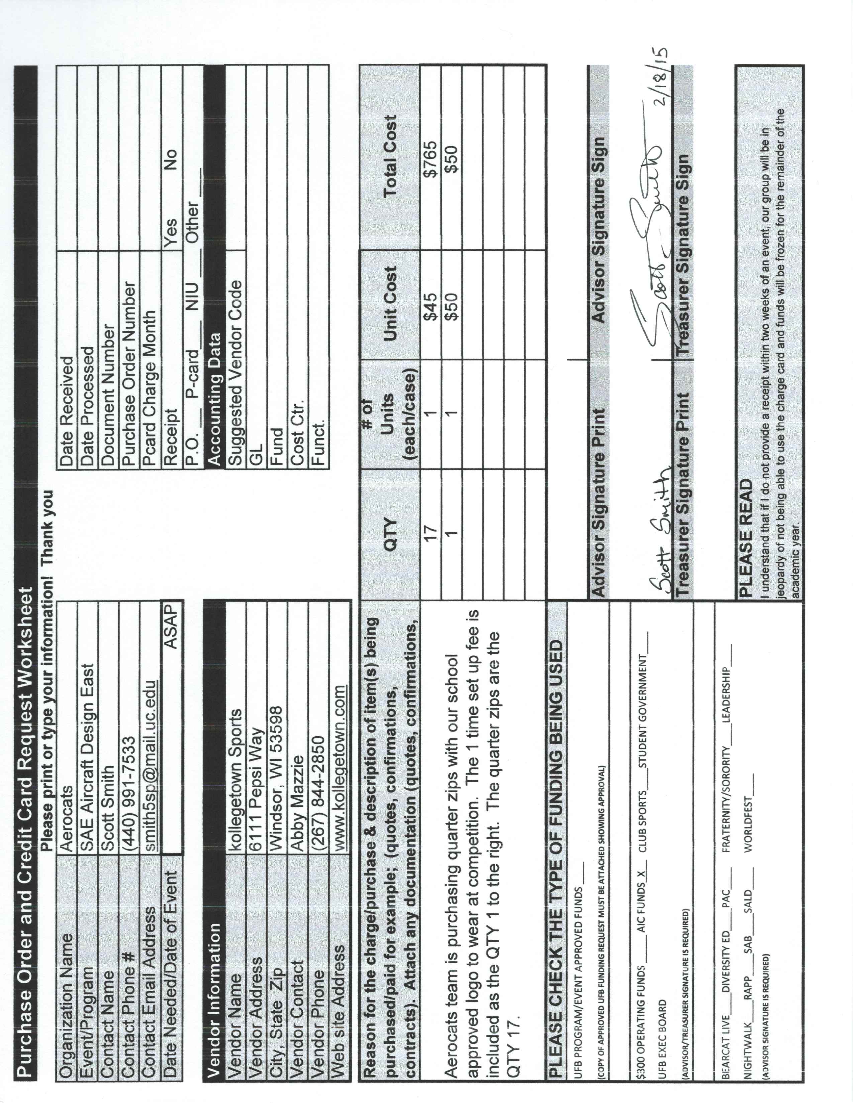
[picture p146: page 1]
