Aerothon-2020/Reg2015Aircraft_Aerocats/Treasurer Files/Swag/Purchase_Order_and_CC_Request_WS_Signed_Logo.pdf

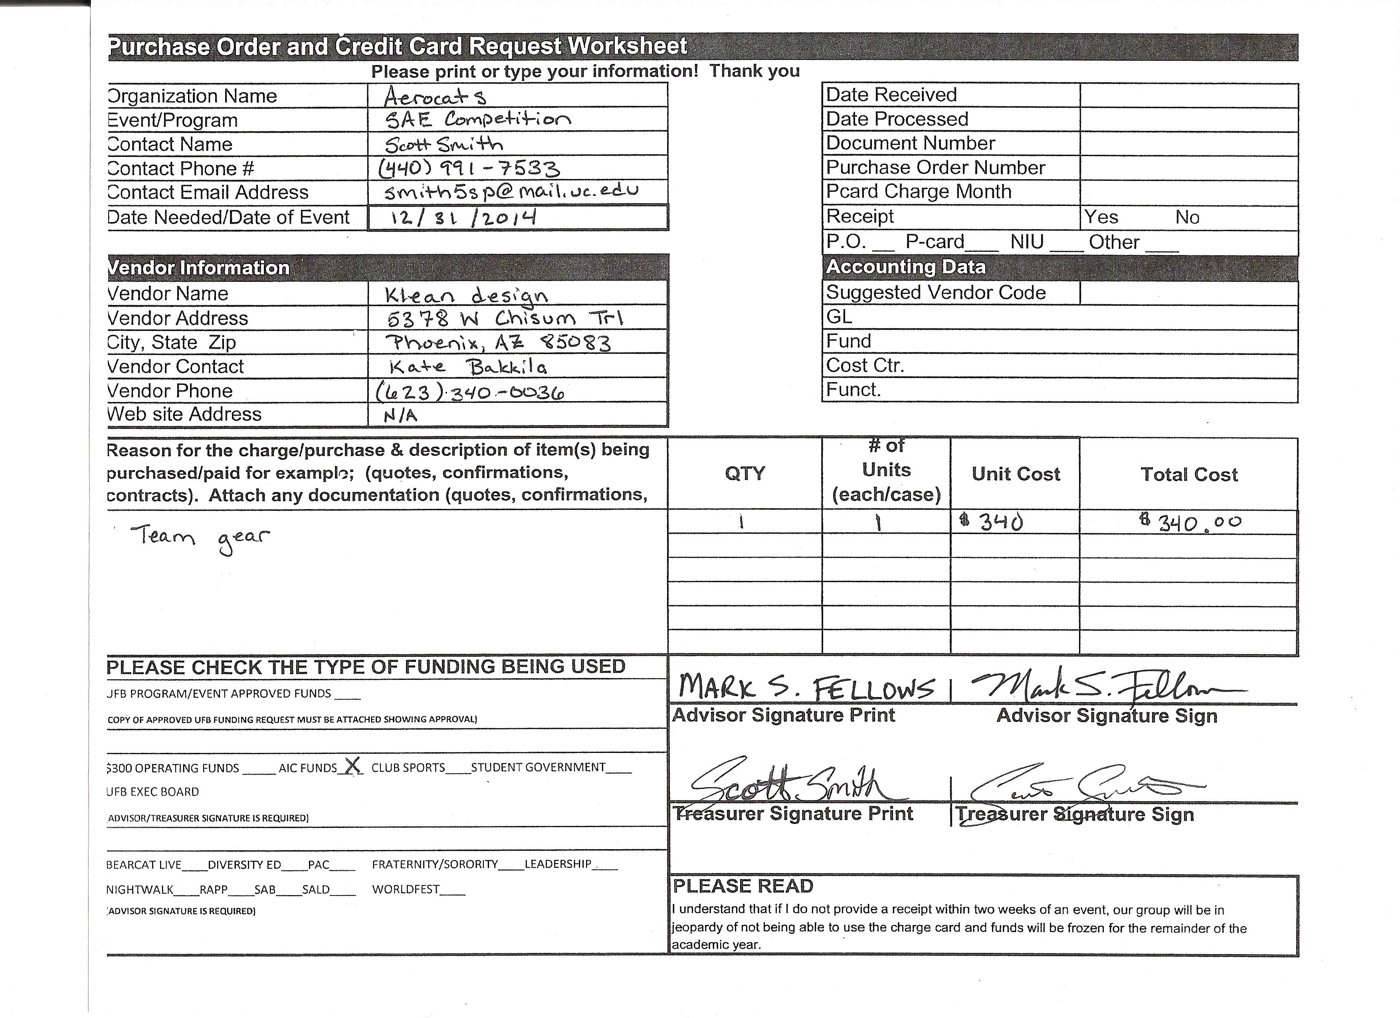
[picture p147: page 1]
