Aerothon-2020/Reg2015Aircraft_Aerocats/Structures/CAD/Abbas_CAD/Senior Design CAD/Plane_Assembly/TailSectionANSI.sldasm

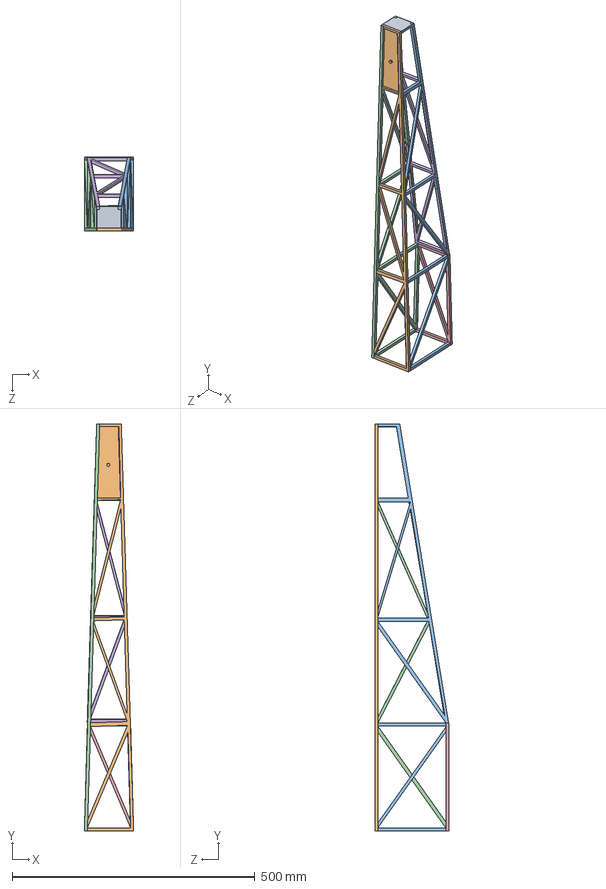
[picture p148: CAD file, 2019-09-23]
Structures/CAD/Abbas_CAD/Senior Design CAD/Plane_Assembly/TailSectionANSI.sldasm
101.6 x 838.0 x 153.0 mm
TailEndSection
TailTopANSI
TailSide1ANSI
TailSide2ANSI
TailBot11Ansi
TailBotAnsi2
