Aerothon-2020/Reg2015Aircraft_Aerocats/Structures/CAD/Payload_Box/625 inch payload box assy.igs

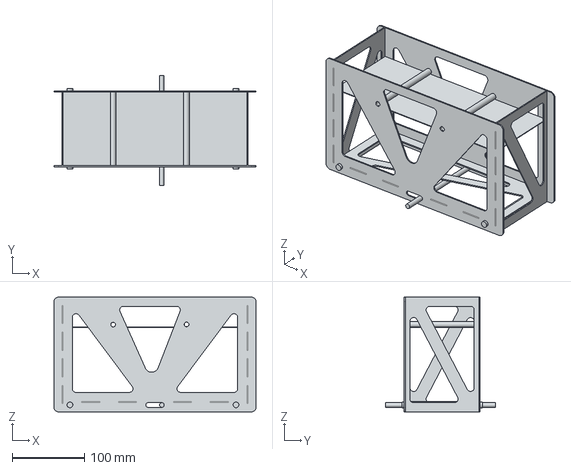
[picture p149: CAD file, 2019-09-23]
Structures/CAD/Payload_Box/625 inch payload box assy.igs
279.4 x 152.4 x 158.8 mm
