Aerothon-2020/Reg2015Aircraft_Aerocats/Structures/CAD/Abbas_CAD/Senior Design CAD/Plane_Assembly/Center_VT.sldasm

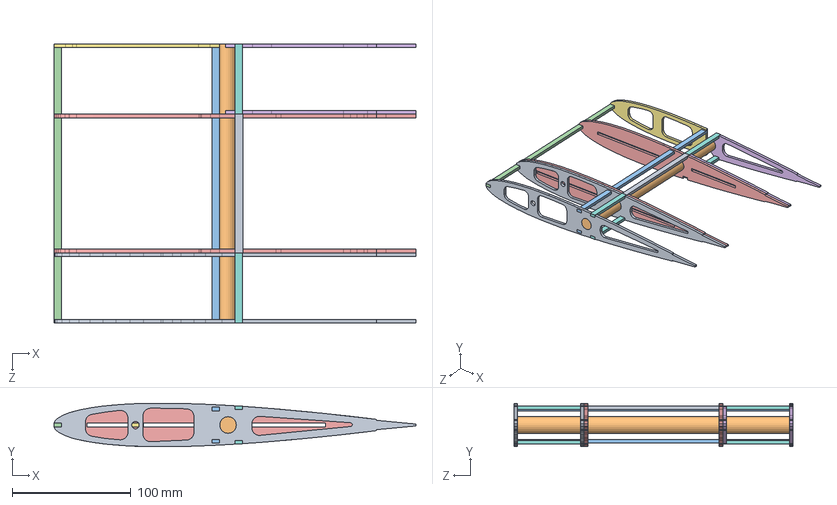
[picture p150: CAD file, 2019-09-23]
Structures/CAD/Abbas_CAD/Senior Design CAD/Plane_Assembly/Center_VT.sldasm
304.5 x 36.6 x 235.0 mm
CENTER_VT_Full x 2
Center_VT_strips_tube
Center_VT_strips_Spar x 2
Center_VT_strips_Front
CENTER_VT_WithSlot x 2
CENTER_VT_MovingHalf x 2
CENTER_VT_FrontHalf
Center_VT_strips_Spar_top x 4
Center_VT_strips_Spar_middle
