Aerothon-2020/Reg2015Aircraft_Aerocats/Structures/CAD/Abbas_CAD/Senior Design CAD/3D tapered wing and ceter vt/CENTER_VT_Full.sldprt

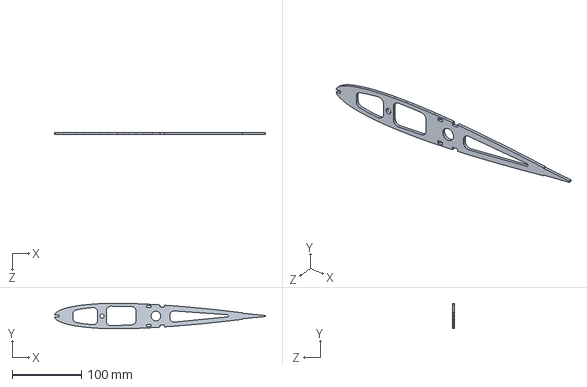
[picture p151: CAD file, 2019-09-23]
Structures/CAD/Abbas_CAD/Senior Design CAD/3D tapered wing and ceter vt/CENTER_VT_Full.sldprt
304.5 x 36.5 x 3.17 mm
