Aerothon-2020/Reg2015Aircraft_Aerocats/Structures/CAD/Abbas_CAD/Senior Design CAD/Plane_Assembly/Nose.sldasm

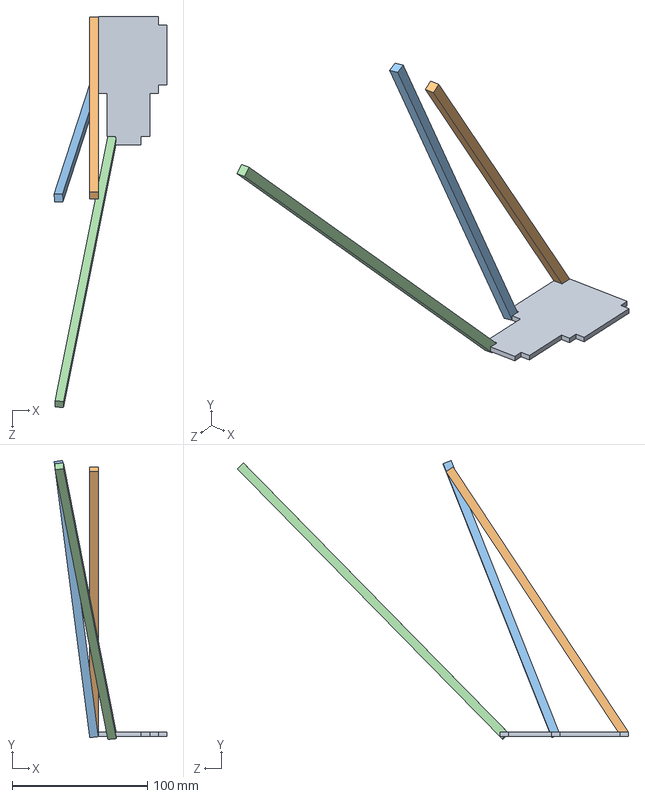
[picture p152: CAD file, 2019-09-23]
Structures/CAD/Abbas_CAD/Senior Design CAD/Plane_Assembly/Nose.sldasm
83.5 x 206.6 x 289.8 mm
Motor landing gear Bulk Head
Upper Stringer
Mid Stringer
Lower Stringer
