Aerothon-2020/Reg2015Aircraft_Aerocats/Structures/CAD/Abbas_CAD/Senior Design CAD/Plane_Assembly/Rectangular Wing.sldasm

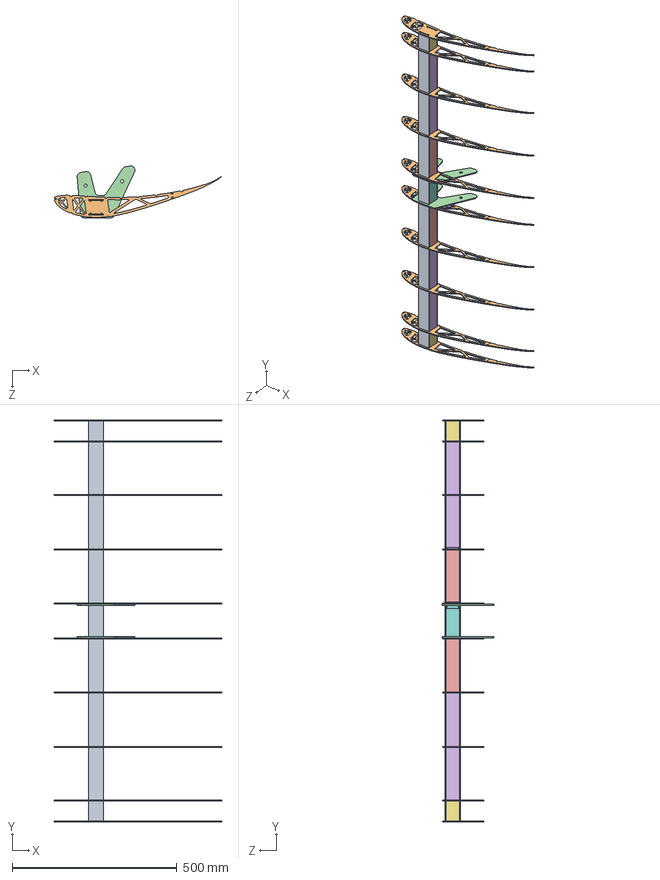
[picture p153: CAD file, 2019-09-23]
Structures/CAD/Abbas_CAD/Senior Design CAD/Plane_Assembly/Rectangular Wing.sldasm
508.1 x 1219.2 x 157.7 mm
Cap x 2
3D_Rect_Rib x 10
Stringer x 4
Payload Connection x 2
Shear Web x 4
Shear Web 6.25 x 8
Shear Web 2.375 x 4
Shear Web CENTER x 2
