Aerothon-2020/Reg2015Aircraft_Aerocats/Structures/CAD/Abbas_CAD/Senior Design CAD/Plane_Assembly/Landing Gear final.sldasm

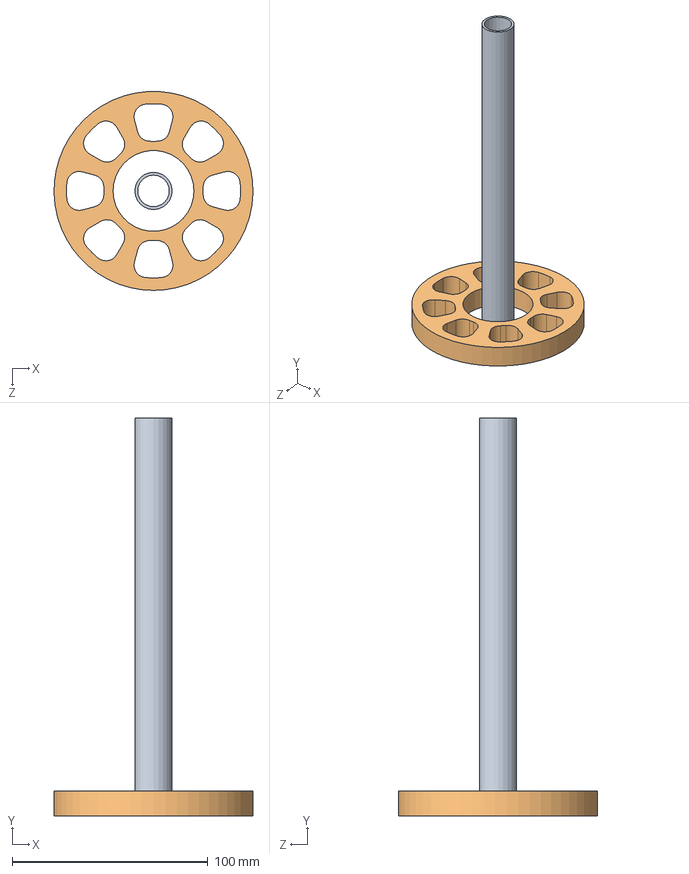
[picture p154: CAD file, 2019-09-23]
Structures/CAD/Abbas_CAD/Senior Design CAD/Plane_Assembly/Landing Gear final.sldasm
101.6 x 203.2 x 101.5 mm
Axle .75OD .634ID 6061-T6 Aluminum
wheel 4OD 1.625ID
