Aerothon-2020/Reg2015Aircraft_Aerocats/Structures/CAD/Abbas_CAD/Senior Design CAD/2nd_Gen/Fuselage/Front_Side.SLDPRT

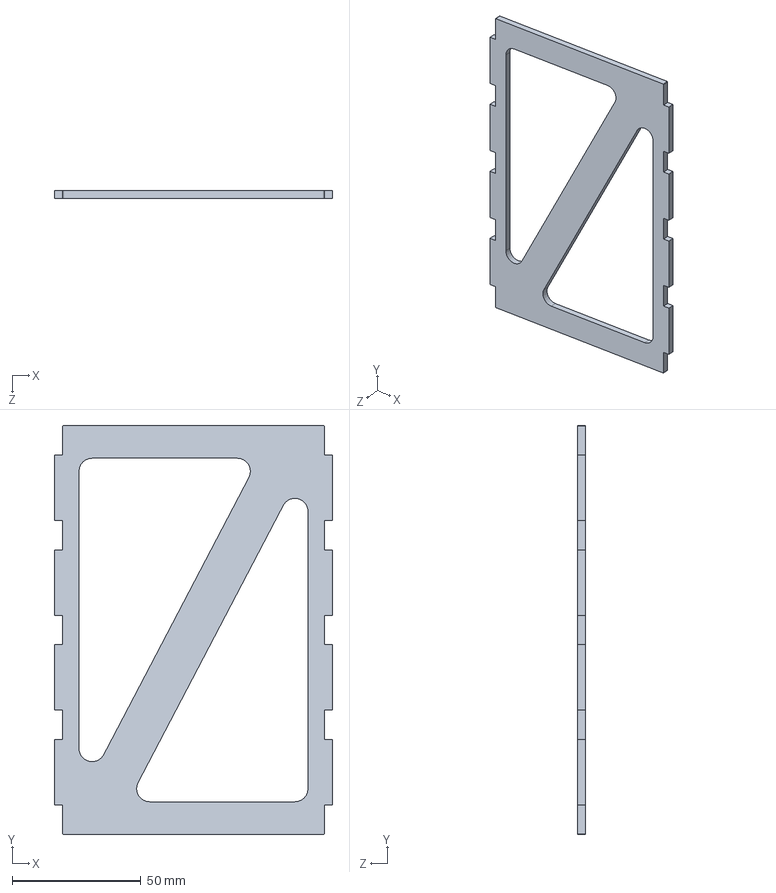
[picture p155: CAD file, 2019-09-23]
Structures/CAD/Abbas_CAD/Senior Design CAD/2nd_Gen/Fuselage/Front_Side.SLDPRT
108.0 x 158.8 x 3.17 mm
