Aerothon-2020/Reg2015Aircraft_Aerocats/Structures/CAD/Abbas_CAD/Senior Design CAD/2nd_Gen/Nose/Front_Bulkhead.dxf

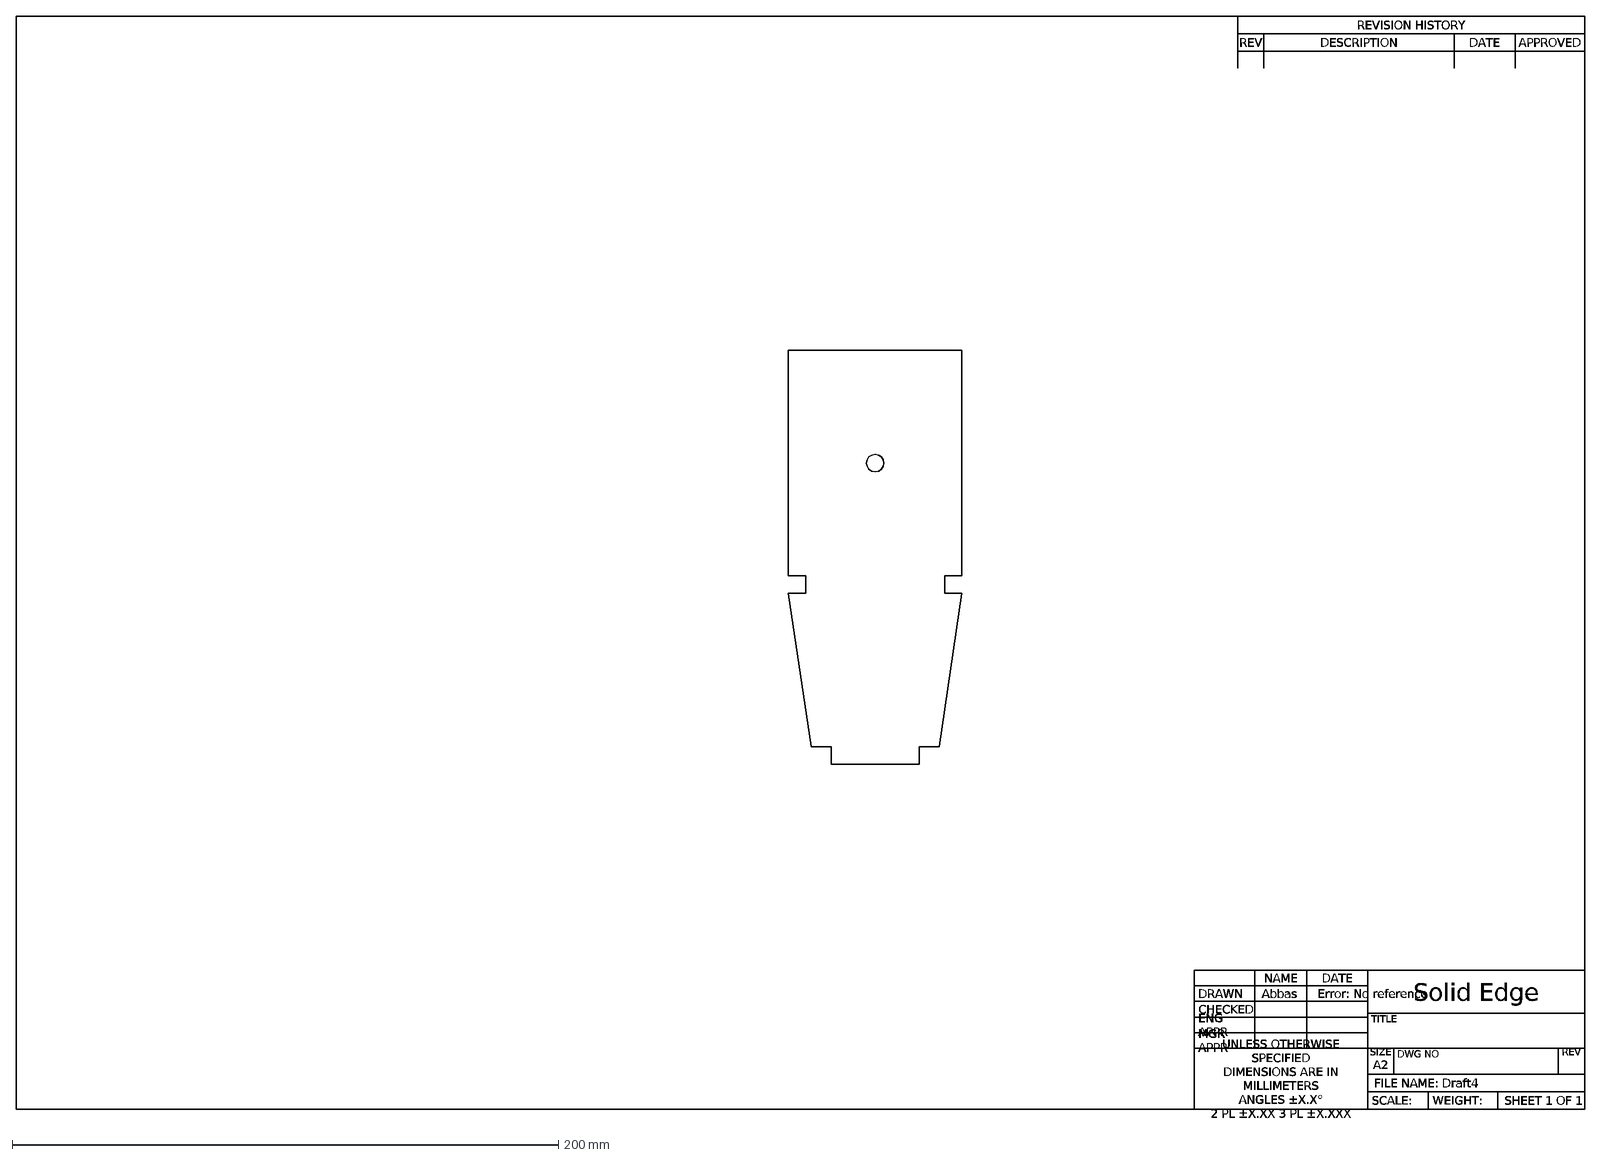
[picture p156: CAD file, 2019-09-23]
Structures/CAD/Abbas_CAD/Senior Design CAD/2nd_Gen/Nose/Front_Bulkhead.dxf
DRAWN
CHECKED
ENG APPR
MGR APPR
UNLESS OTHERWISE SPECIFIED DIMENSIONS ARE IN MILLIMETERS ANGLES ±X.X° 2 PL ±X.XX 3 PL ±X.XXX
NAME
Abbas
DATE
Error: No reference
Solid Edge
TITLE
SIZE
A2
DWG NO
REV
FILE NAME: Draft4
SCALE:
WEIGHT:
SHEET 1 OF 1
REVISION HISTORY
DESCRIPTION
APPROVED
