Aerothon-2020/Reg2015Aircraft_Aerocats/Structures/CAD/Abbas_CAD/Senior Design CAD/3D tapered wing and ceter vt/Center_VT_strips_Spar_top.sldprt

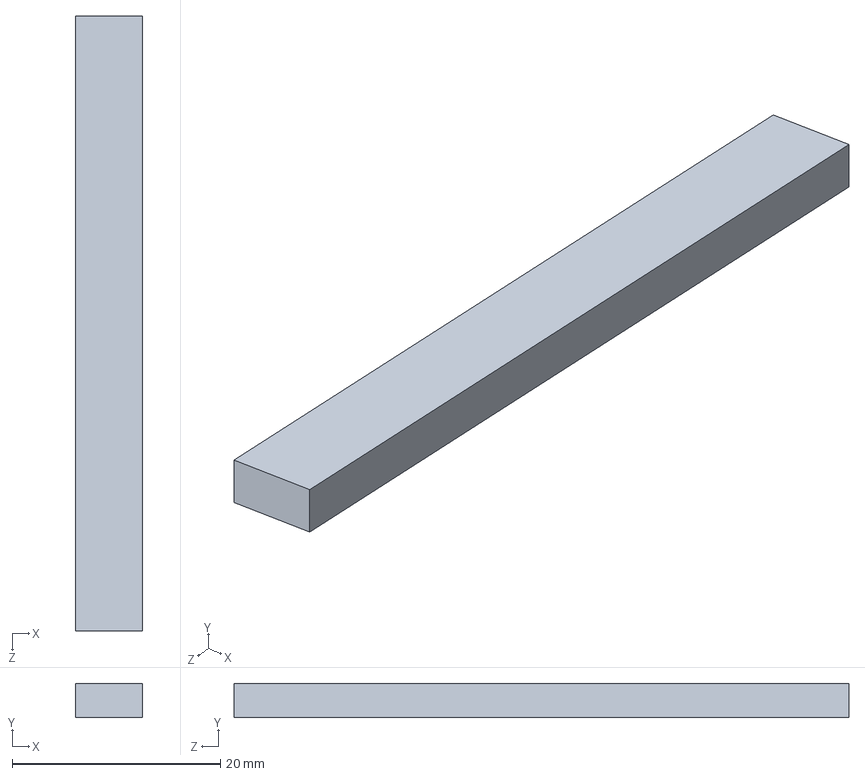
[picture p159: CAD file, 2019-09-23]
Structures/CAD/Abbas_CAD/Senior Design CAD/3D tapered wing and ceter vt/Center_VT_strips_Spar_top.sldprt
6.48 x 3.30 x 59.1 mm
