Aerothon-2020/Reg2015Aircraft_Aerocats/Structures/CAD/Abbas_CAD/Senior Design CAD/Landing Gear/.75x1.625x.5 Bearing.IGS

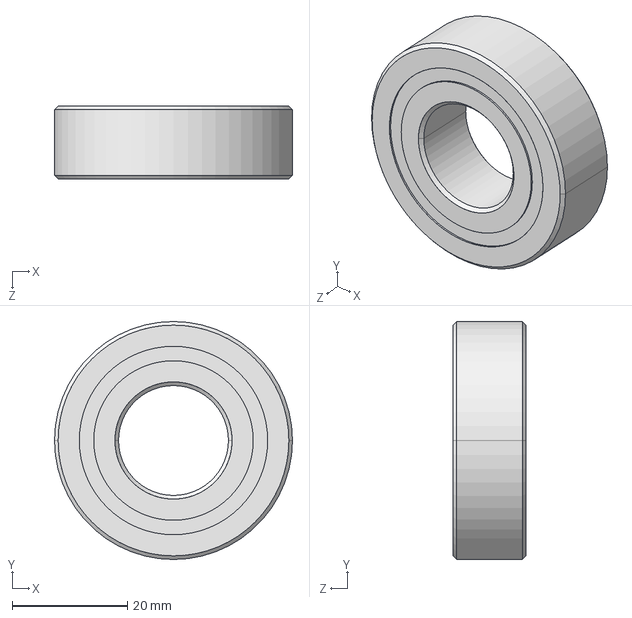
[picture p160: CAD file, 2019-09-23]
Structures/CAD/Abbas_CAD/Senior Design CAD/Landing Gear/.75x1.625x.5 Bearing.IGS
41.3 x 41.3 x 12.7 mm
