Aerothon-2020/Reg2015Aircraft_Aerocats/Structures/CAD/Abbas_CAD/Senior Design CAD/Nose/Nose/Lower Stringer.IGS

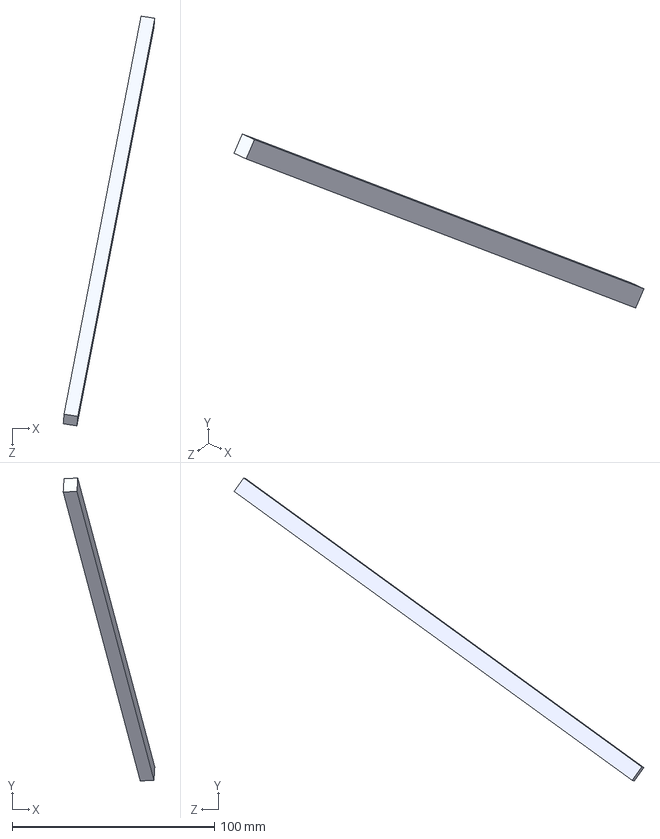
[picture p161: CAD file, 2019-09-23]
Structures/CAD/Abbas_CAD/Senior Design CAD/Nose/Nose/Lower Stringer.IGS
45.3 x 149.8 x 202.6 mm
