Aerothon-2020/Reg2015Aircraft_Aerocats/Structures/CAD/Abbas_CAD/Senior Design CAD/Payload_Bay/Bottom_Part.SLDPRT

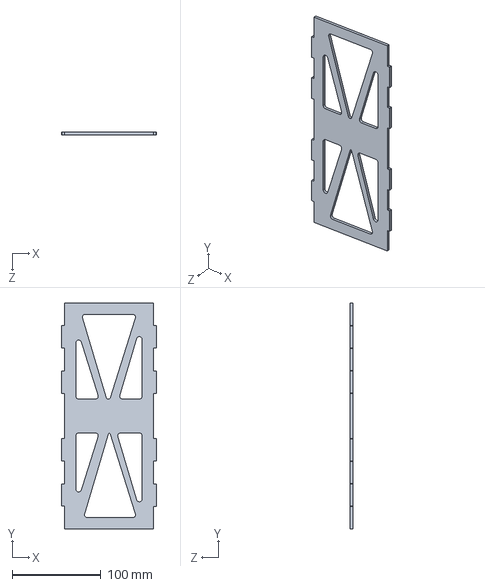
[picture p162: CAD file, 2019-09-23]
Structures/CAD/Abbas_CAD/Senior Design CAD/Payload_Bay/Bottom_Part.SLDPRT
106.4 x 254.0 x 3.17 mm
