Aerothon-2020/Reg2015Aircraft_Aerocats/Structures/CAD/Abbas_CAD/Senior Design CAD/Plane_Assembly/Motor landing gear Bulk Head.sldprt

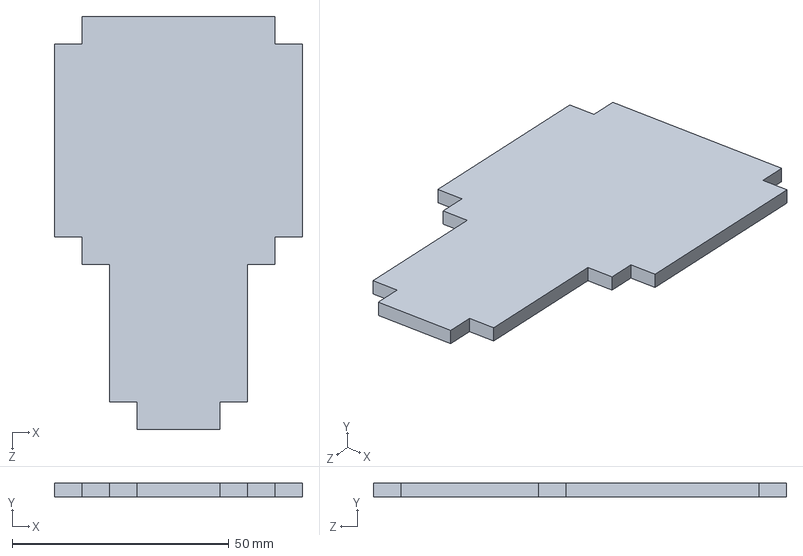
[picture p163: CAD file, 2019-09-23]
Structures/CAD/Abbas_CAD/Senior Design CAD/Plane_Assembly/Motor landing gear Bulk Head.sldprt
57.1 x 3.17 x 95.2 mm
