Aerothon-2020/Reg2015Aircraft_Aerocats/Structures/CAD/Abbas_CAD/Senior Design CAD/Rectangular_Wing_Ribs/3D_Rect_Rib.SLDPRT

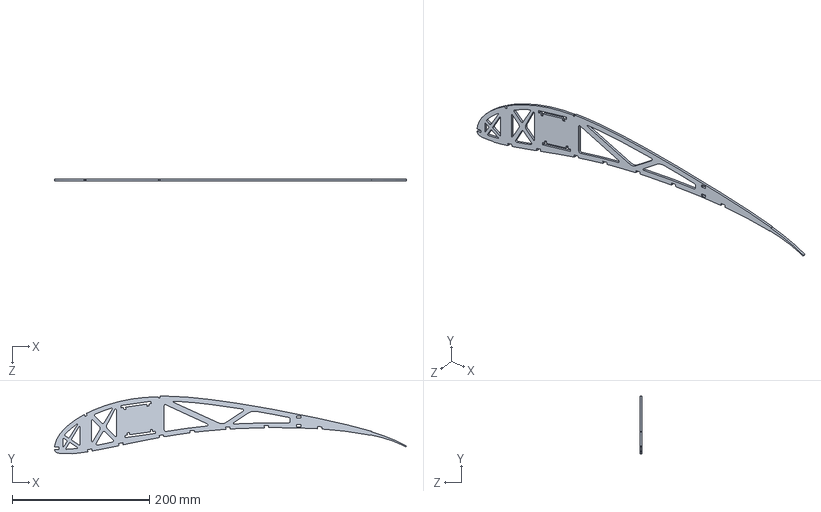
[picture p164: CAD file, 2019-09-23]
Structures/CAD/Abbas_CAD/Senior Design CAD/Rectangular_Wing_Ribs/3D_Rect_Rib.SLDPRT
512.4 x 83.9 x 3.17 mm
