Aerothon-2020/Reg2015Aircraft_Aerocats/Structures/CAD/Payload_Box/6 inch axle.igs

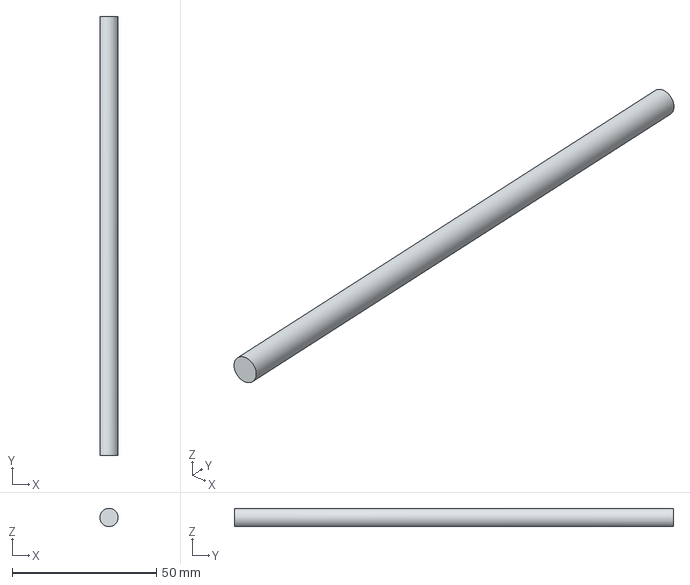
[picture p165: CAD file, 2019-09-23]
Structures/CAD/Payload_Box/6 inch axle.igs
6.34 x 152.4 x 6.35 mm
