Aerothon-2020/Reg2015Aircraft_Aerocats/Structures/CAD/Abbas_CAD/Senior Design CAD/Landing Gear/wheel 4OD 1.625ID.IGS

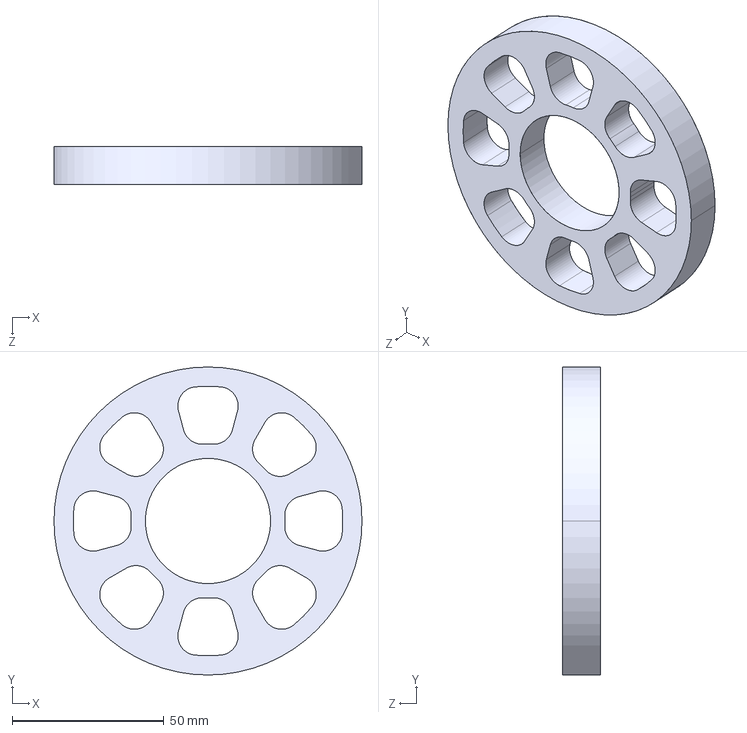
[picture p168: CAD file, 2019-09-23]
Structures/CAD/Abbas_CAD/Senior Design CAD/Landing Gear/wheel 4OD 1.625ID.IGS
101.6 x 101.6 x 12.7 mm
