Aerothon-2020/Reg2015Aircraft_Aerocats/Structures/CAD/Abbas_CAD/Senior Design CAD/Payload_Bay/Side_Part.SLDPRT

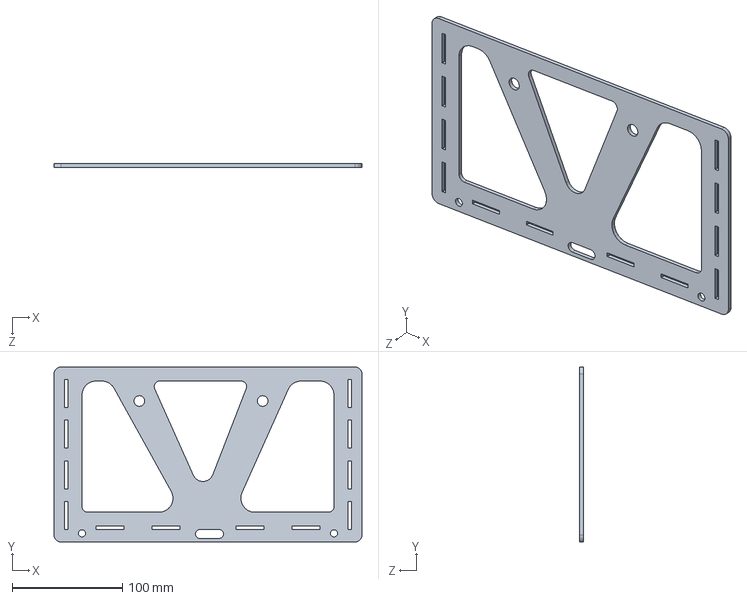
[picture p169: CAD file, 2019-09-23]
Structures/CAD/Abbas_CAD/Senior Design CAD/Payload_Bay/Side_Part.SLDPRT
279.4 x 158.8 x 3.17 mm
