Aerothon-2020/Reg2015Aircraft_Aerocats/Structures/CAD/Abbas_CAD/Senior Design CAD/Plane_Assembly/Center_VT_strips_Spar.sldprt

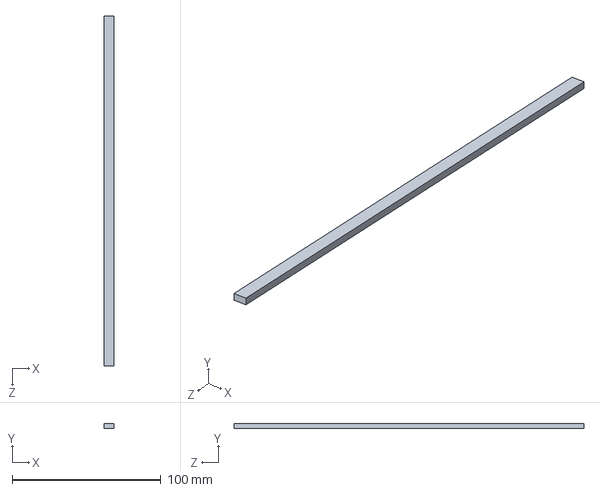
[picture p170: CAD file, 2019-09-23]
Structures/CAD/Abbas_CAD/Senior Design CAD/Plane_Assembly/Center_VT_strips_Spar.sldprt
6.48 x 3.30 x 235.0 mm
