Aerothon-2020/Reg2015Aircraft_Aerocats/Structures/CAD/Payload_Box/front and back wall payload bay.igs

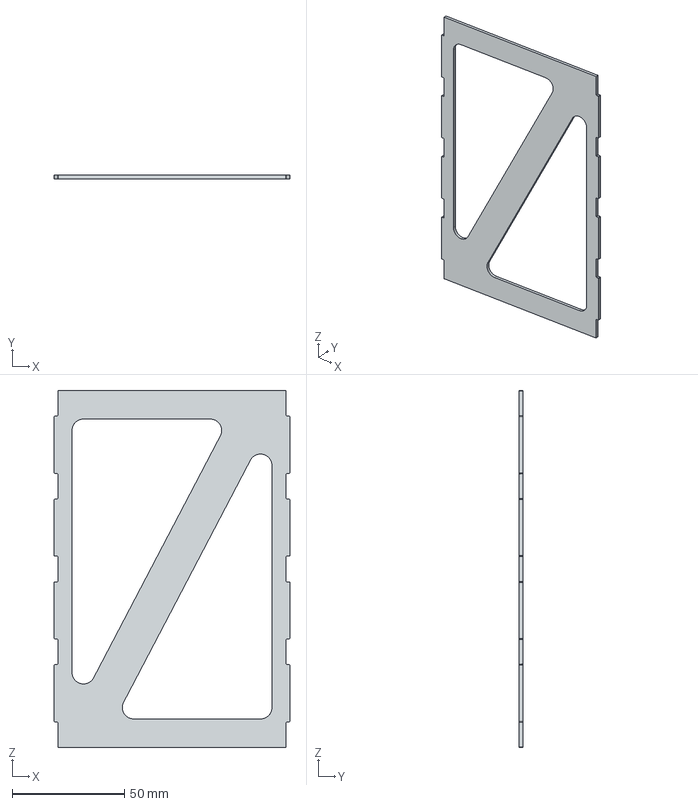
[picture p171: CAD file, 2019-09-23]
Structures/CAD/Payload_Box/front and back wall payload bay.igs
104.8 x 1.59 x 158.8 mm
