Aerothon-2020/Reg2015Aircraft_Aerocats/Structures/CAD/Abbas_CAD/Senior Design CAD/3D tapered wing and ceter vt/Center_VT_strips_tube.sldprt

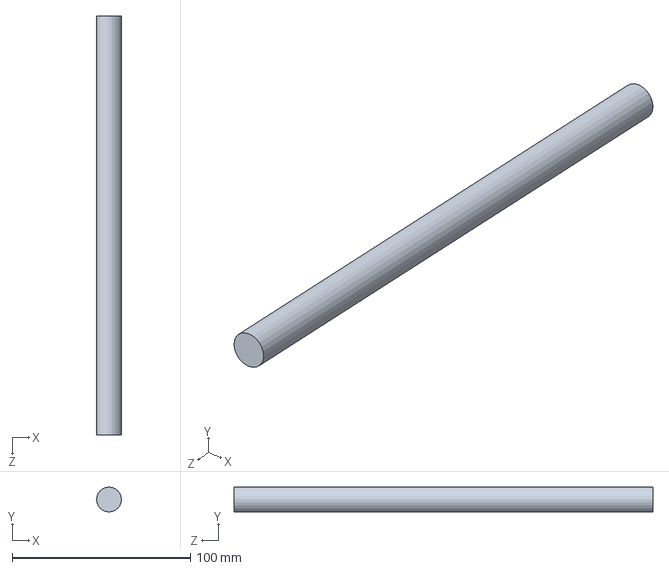
[picture p172: CAD file, 2019-09-23]
Structures/CAD/Abbas_CAD/Senior Design CAD/3D tapered wing and ceter vt/Center_VT_strips_tube.sldprt
14.0 x 14.0 x 235.0 mm
