Aerothon-2020/Reg2015Aircraft_Aerocats/Structures/CAD/Abbas_CAD/Senior Design CAD/Payload_Bay/Payload_Box_Bottom_Part.dxf

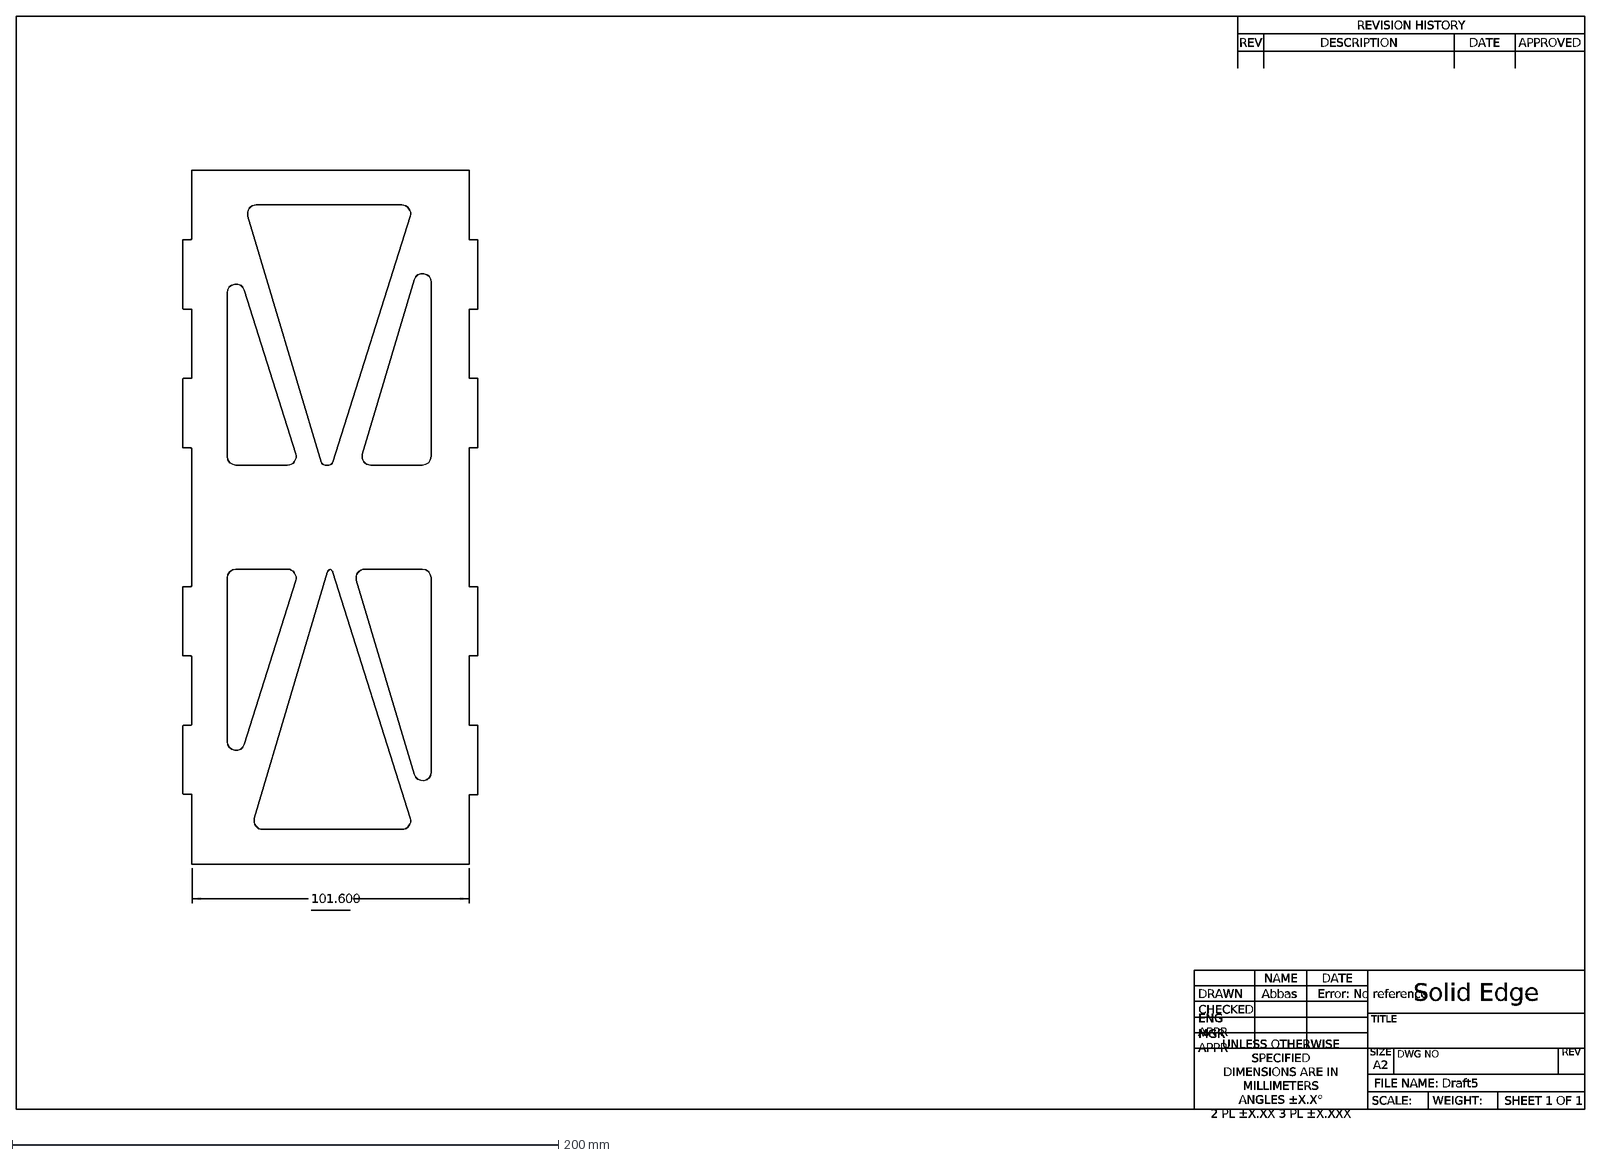
[picture p173: CAD file, 2019-09-23]
Structures/CAD/Abbas_CAD/Senior Design CAD/Payload_Bay/Payload_Box_Bottom_Part.dxf
101.600
DRAWN
CHECKED
ENG APPR
MGR APPR
UNLESS OTHERWISE SPECIFIED DIMENSIONS ARE IN MILLIMETERS ANGLES ±X.X° 2 PL ±X.XX 3 PL ±X.XXX
NAME
Abbas
DATE
Error: No reference
Solid Edge
TITLE
SIZE
A2
DWG NO
REV
FILE NAME: Draft5
SCALE:
WEIGHT:
SHEET 1 OF 1
REVISION HISTORY
DESCRIPTION
APPROVED
