Aerothon-2020/Reg2015Aircraft_Aerocats/Structures/CAD/Abbas_CAD/Senior Design CAD/3D tapered wing and ceter vt/CENTER_VT_MovingHalf.sldprt

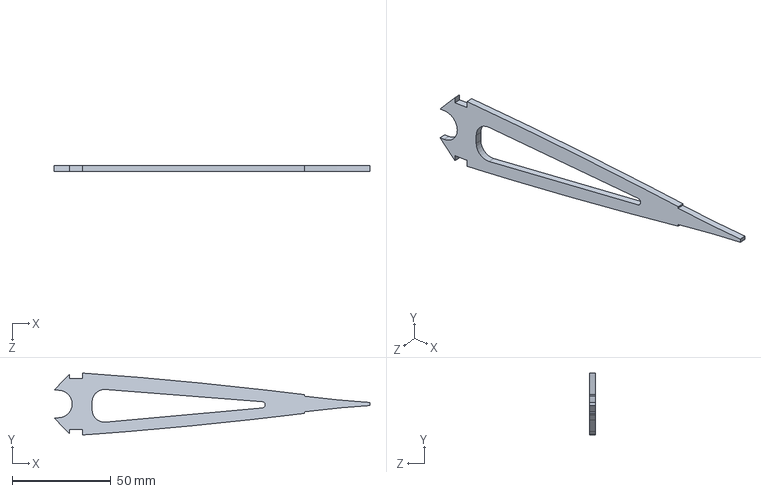
[picture p174: CAD file, 2019-09-23]
Structures/CAD/Abbas_CAD/Senior Design CAD/3D tapered wing and ceter vt/CENTER_VT_MovingHalf.sldprt
160.4 x 31.4 x 3.17 mm
