Aerothon-2020/Reg2015Aircraft_Aerocats/Structures/CAD/Abbas_CAD/Senior Design CAD/Plane_Assembly/Shear Web CENTER.sldprt

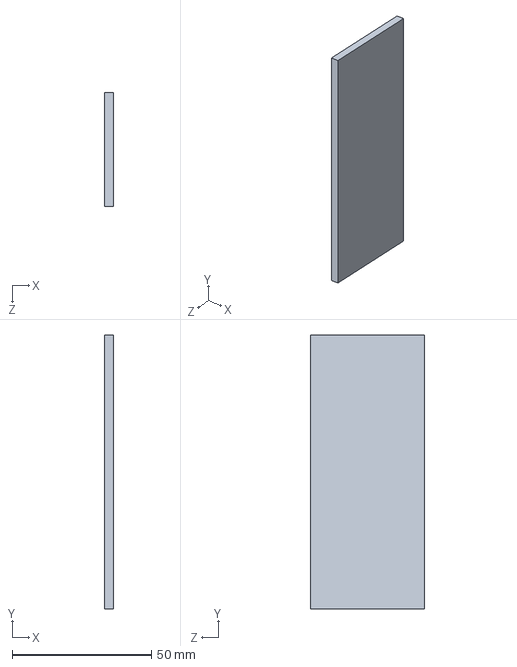
[picture p175: CAD file, 2019-09-23]
Structures/CAD/Abbas_CAD/Senior Design CAD/Plane_Assembly/Shear Web CENTER.sldprt
3.17 x 98.4 x 40.9 mm
