Aerothon-2020/Reg2015Aircraft_Aerocats/Structures/CAD/Payload_Box/top sheet payload bay 625.igs

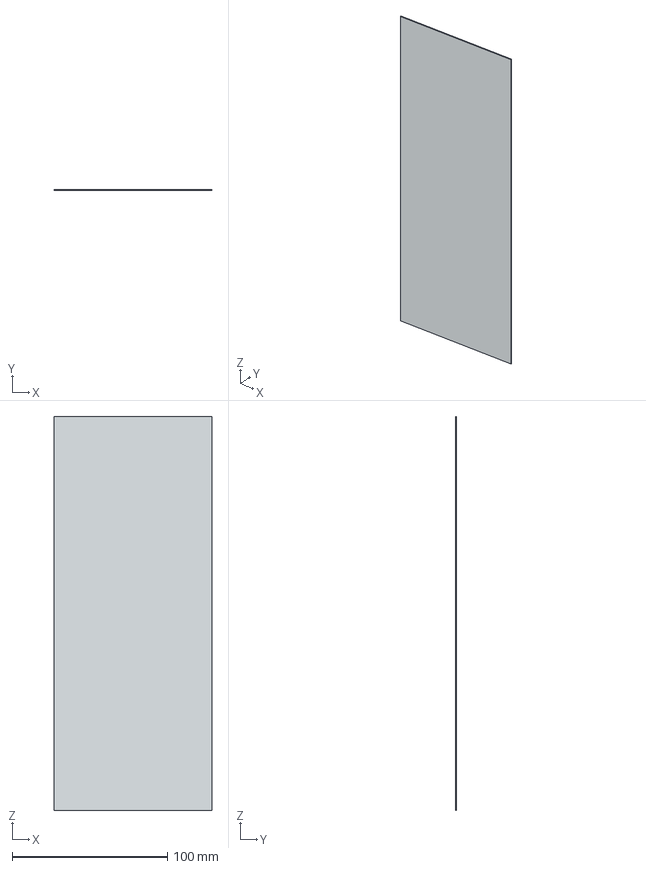
[picture p176: CAD file, 2019-09-23]
Structures/CAD/Payload_Box/top sheet payload bay 625.igs
101.6 x 0.794 x 254.0 mm
