Aerothon-2020/Reg2015Aircraft_Aerocats/Structures/CAD/Abbas_CAD/Senior Design CAD/3D tapered wing and ceter vt/Center_VT_strips_Spar_middle.sldprt

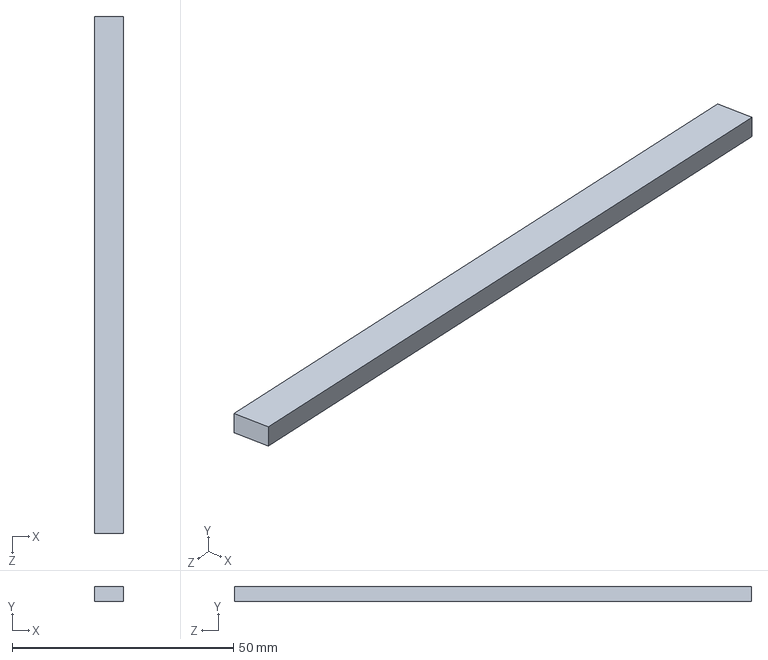
[picture p178: CAD file, 2019-09-23]
Structures/CAD/Abbas_CAD/Senior Design CAD/3D tapered wing and ceter vt/Center_VT_strips_Spar_middle.sldprt
6.48 x 3.30 x 116.8 mm
