Aerothon-2020/Reg2015Aircraft_Aerocats/Structures/CAD/Payload_Box/625 inch payload box.igs

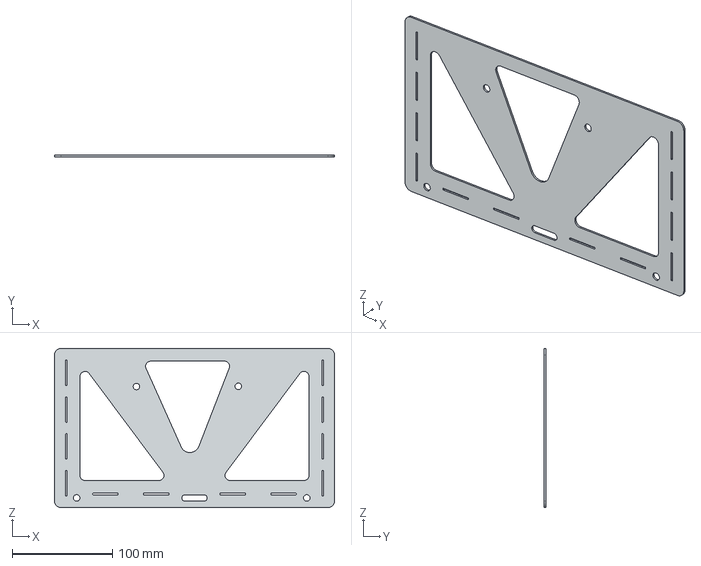
[picture p179: CAD file, 2019-09-23]
Structures/CAD/Payload_Box/625 inch payload box.igs
279.4 x 1.59 x 158.8 mm
