Aerothon-2020/Reg2015Aircraft_Aerocats/Structures/CAD/Abbas_CAD/Senior Design CAD/3D tapered wing and ceter vt/CENTER_VT_FrontHalf.sldprt

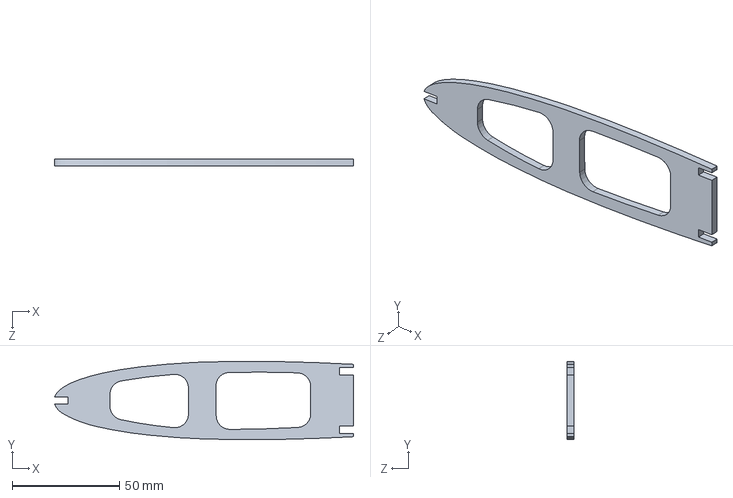
[picture p180: CAD file, 2019-09-23]
Structures/CAD/Abbas_CAD/Senior Design CAD/3D tapered wing and ceter vt/CENTER_VT_FrontHalf.sldprt
139.4 x 36.6 x 3.17 mm
