Aerothon-2020/Reg2015Aircraft_Aerocats/Structures/CAD/Payload_Box/base pins payload bay box.igs

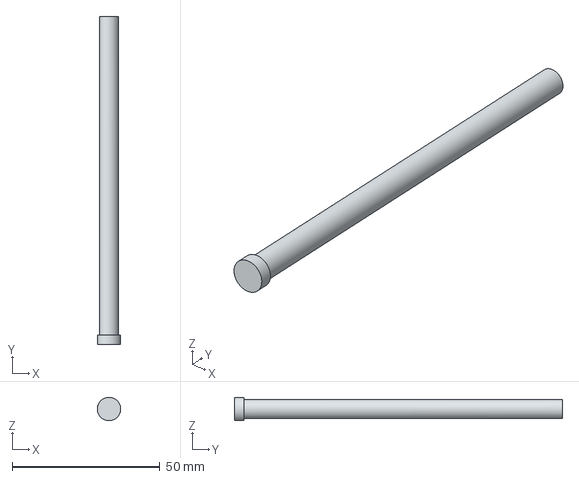
[picture p182: CAD file, 2019-09-23]
Structures/CAD/Payload_Box/base pins payload bay box.igs
7.93 x 111.1 x 7.94 mm
