Aerothon-2020/Reg2015Aircraft_Aerocats/Structures/CAD/Payload_Box/blind hole bars.igs

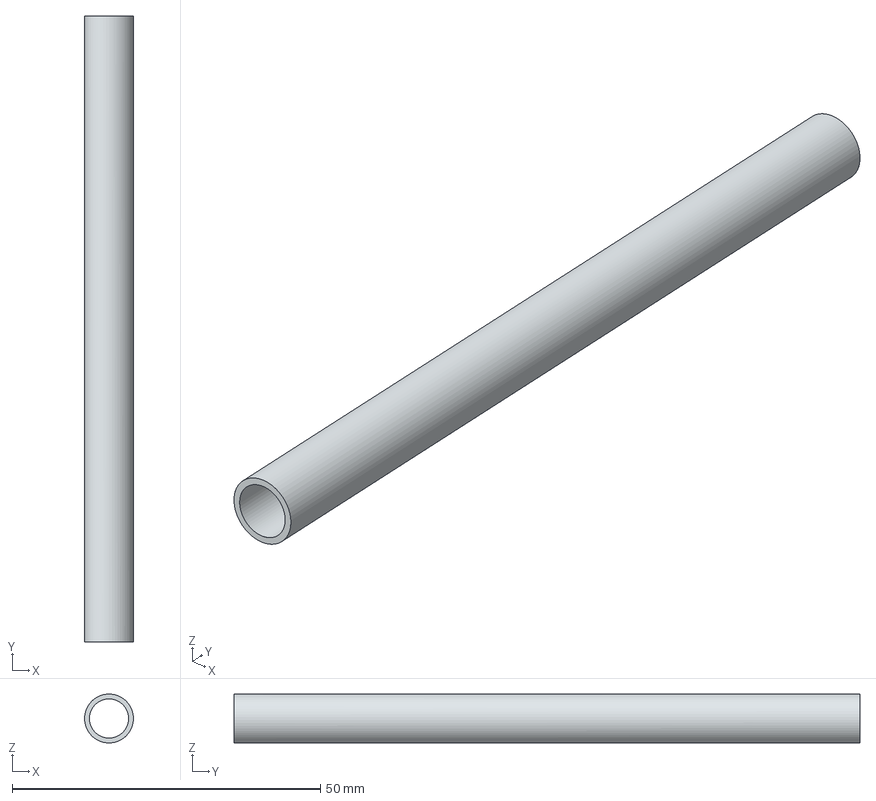
[picture p183: CAD file, 2019-09-23]
Structures/CAD/Payload_Box/blind hole bars.igs
7.93 x 101.6 x 7.94 mm
