Aerothon-2020/Reg2015Aircraft_Aerocats/Structures/CAD/Abbas_CAD/Senior Design CAD/3D tapered wing and ceter vt/Center_VT_strips_Front.sldprt

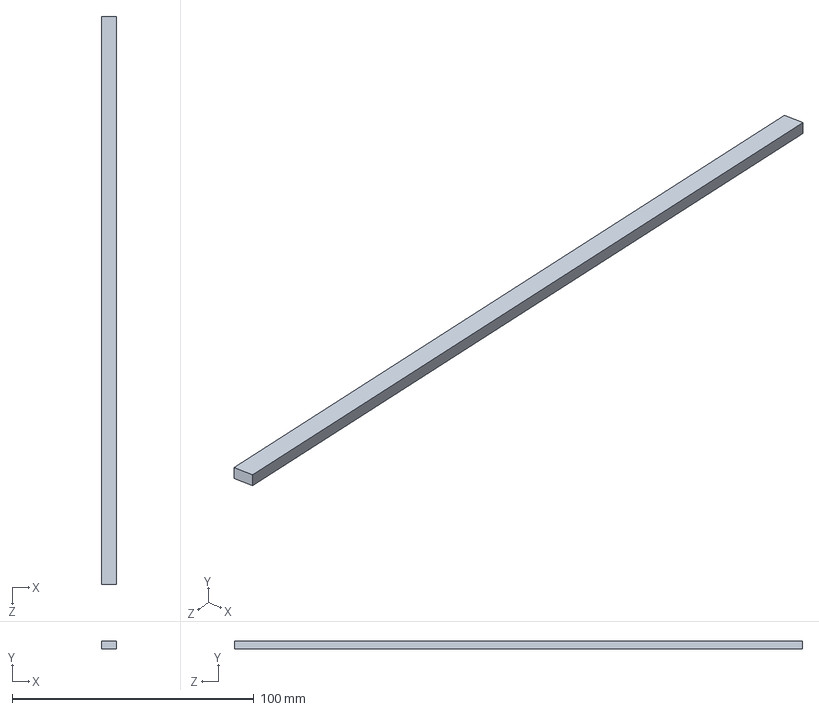
[picture p184: CAD file, 2019-09-23]
Structures/CAD/Abbas_CAD/Senior Design CAD/3D tapered wing and ceter vt/Center_VT_strips_Front.sldprt
6.20 x 3.30 x 235.0 mm
