Aerothon-2020/Reg2015Aircraft_Aerocats/Structures/CAD/Payload_Box/bottom of payload bay 625.igs

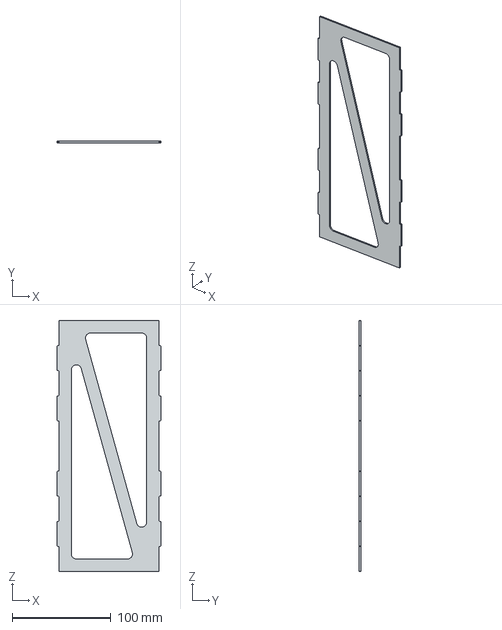
[picture p185: CAD file, 2019-09-23]
Structures/CAD/Payload_Box/bottom of payload bay 625.igs
104.8 x 1.59 x 254.0 mm
