Aerothon-2020/Reg2015Aircraft_Aerocats/Structures/CAD/Abbas_CAD/Senior Design CAD/Plane_Assembly/Shear Web 6.25.sldprt

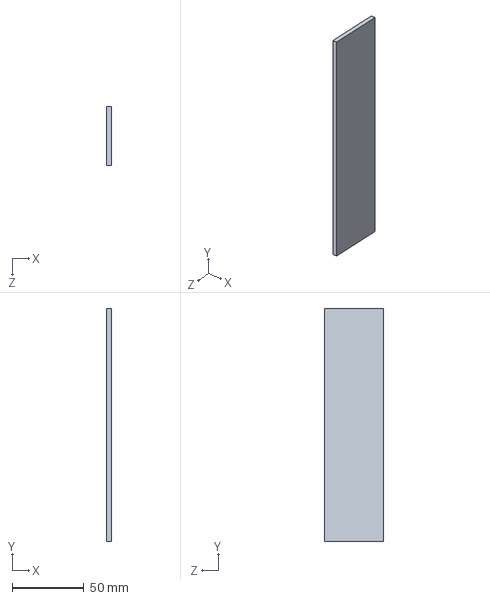
[picture p186: CAD file, 2019-09-23]
Structures/CAD/Abbas_CAD/Senior Design CAD/Plane_Assembly/Shear Web 6.25.sldprt
3.17 x 161.9 x 40.9 mm
