Aerothon-2020/Reg2015Aircraft_Aerocats/Structures/CAD/Abbas_CAD/Senior Design CAD/Plane_Assembly/Shear Web 2.375.sldprt

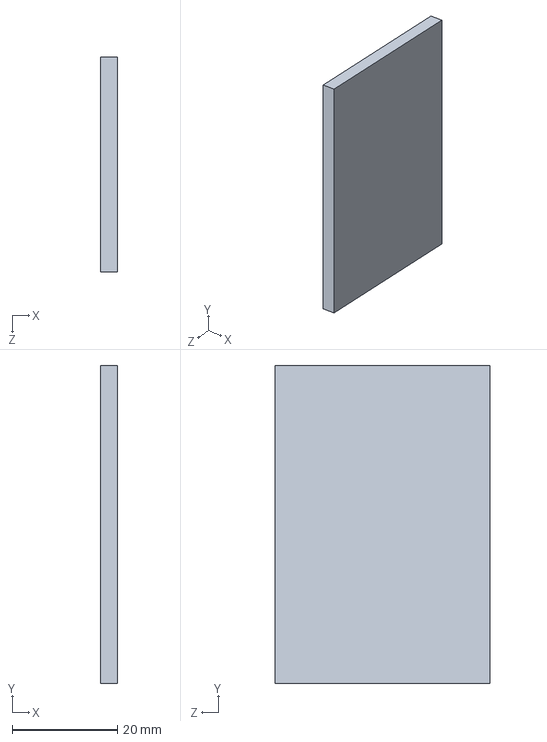
[picture p188: CAD file, 2019-09-23]
Structures/CAD/Abbas_CAD/Senior Design CAD/Plane_Assembly/Shear Web 2.375.sldprt
3.17 x 60.3 x 40.9 mm
