Aerothon-2020/Reg2015Aircraft_Aerocats/Structures/CAD/Abbas_CAD/Senior Design CAD/Plane_Assembly/TailSide2ANSI.sldprt

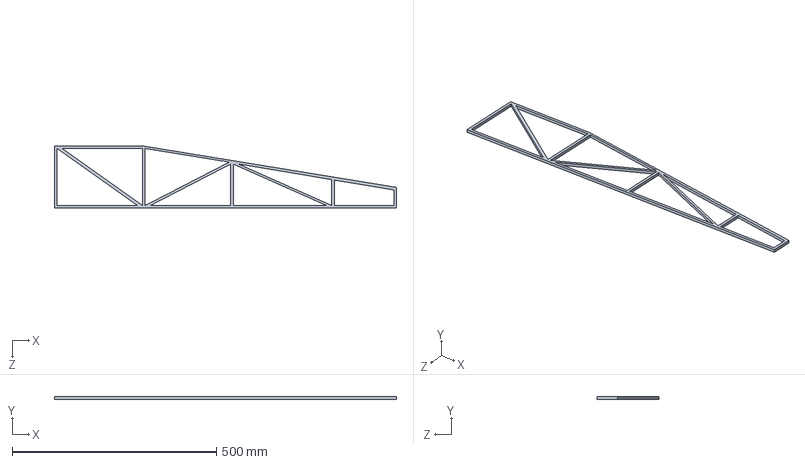
[picture p189: CAD file, 2019-09-23]
Structures/CAD/Abbas_CAD/Senior Design CAD/Plane_Assembly/TailSide2ANSI.sldprt
838.2 x 6.35 x 152.4 mm
