Aerothon-2020/Reg2015Aircraft_Aerocats/Structures/CAD/Abbas_CAD/Senior Design CAD/Plane_Assembly/TailTopANSI.sldprt

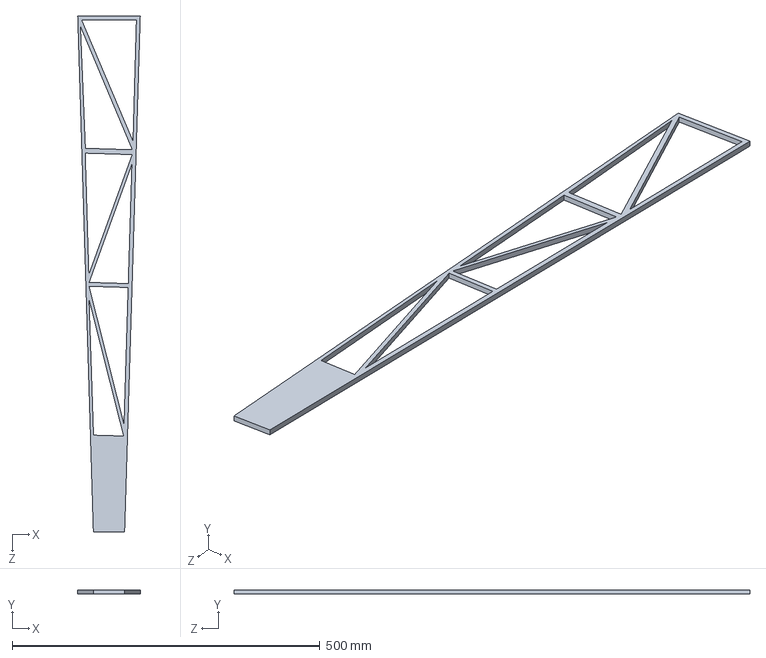
[picture p190: CAD file, 2019-09-23]
Structures/CAD/Abbas_CAD/Senior Design CAD/Plane_Assembly/TailTopANSI.sldprt
101.6 x 6.35 x 837.8 mm
