Aerothon-2020/Reg2015Aircraft_Aerocats/Structures/CAD/Abbas_CAD/Senior Design CAD/Plane_Assembly/TailEndSection.sldprt

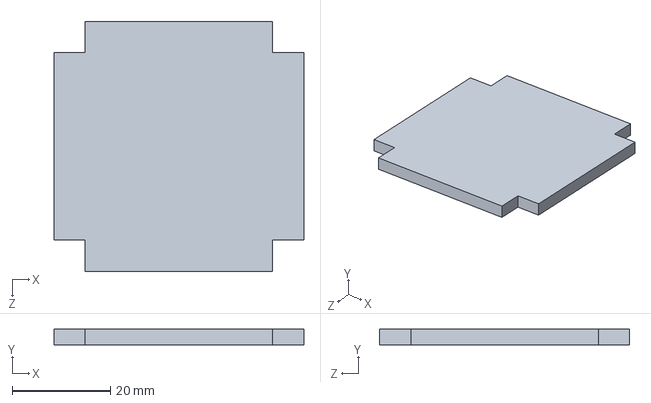
[picture p191: CAD file, 2019-09-23]
Structures/CAD/Abbas_CAD/Senior Design CAD/Plane_Assembly/TailEndSection.sldprt
50.8 x 3.17 x 50.8 mm
