Aerothon-2020/Reg2015Aircraft_Aerocats/Structures/CAD/Abbas_CAD/Senior Design CAD/Plane_Assembly/TailBotAnsi2.sldprt

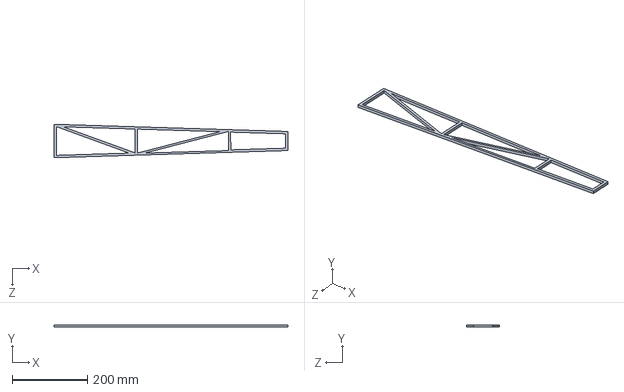
[picture p194: CAD file, 2019-09-23]
Structures/CAD/Abbas_CAD/Senior Design CAD/Plane_Assembly/TailBotAnsi2.sldprt
622.0 x 6.35 x 88.9 mm
