Aerothon-2020/Reg2015Aircraft_Aerocats/Structures/CAD/Abbas_CAD/Senior Design CAD/Plane_Assembly/TailBot11Ansi.sldprt

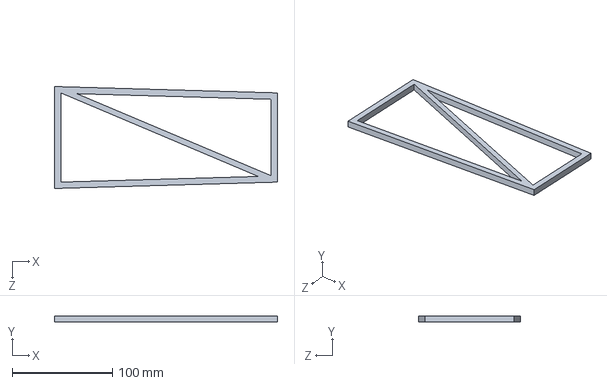
[picture p195: CAD file, 2019-09-23]
Structures/CAD/Abbas_CAD/Senior Design CAD/Plane_Assembly/TailBot11Ansi.sldprt
222.2 x 6.35 x 101.6 mm
