Aerothon-2020/Reg2015Aircraft_Aerocats/Structures/CAD/Abbas_CAD/Senior Design CAD/Plane_Assembly/Upper Stringer.sldprt

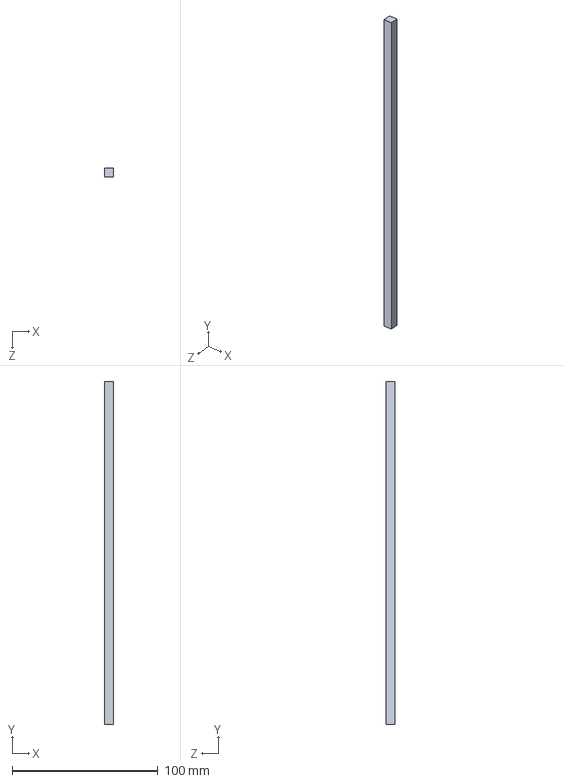
[picture p196: CAD file, 2019-09-23]
Structures/CAD/Abbas_CAD/Senior Design CAD/Plane_Assembly/Upper Stringer.sldprt
6.35 x 235.0 x 6.35 mm
