Aerothon-2020/Reg2015Aircraft_Aerocats/Structures/CAD/Abbas_CAD/Senior Design CAD/Plane_Assembly/Mid Stringer.sldprt

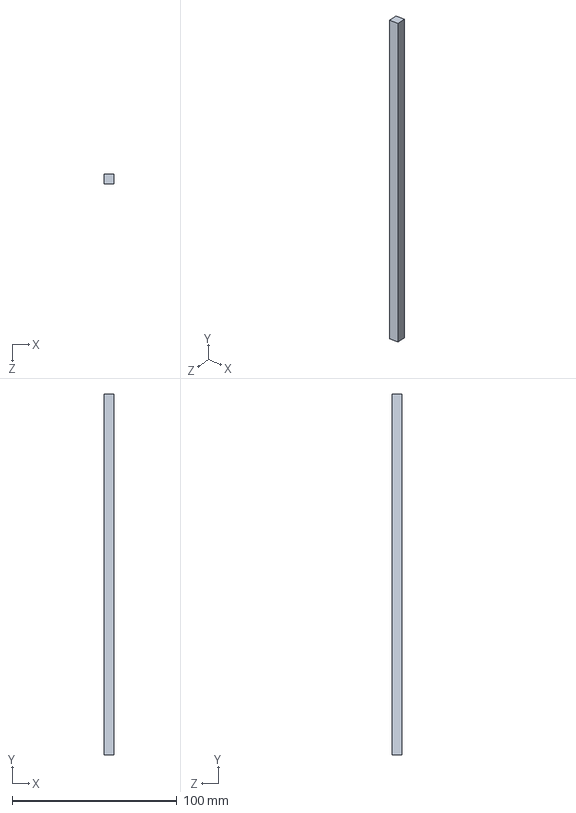
[picture p197: CAD file, 2019-09-23]
Structures/CAD/Abbas_CAD/Senior Design CAD/Plane_Assembly/Mid Stringer.sldprt
6.35 x 219.1 x 6.35 mm
