Aerothon-2020/Reg2015Aircraft_Aerocats/Structures/CAD/Abbas_CAD/Senior Design CAD/Plane_Assembly/Axle .75OD .634ID 6061-T6 Aluminum.sldprt

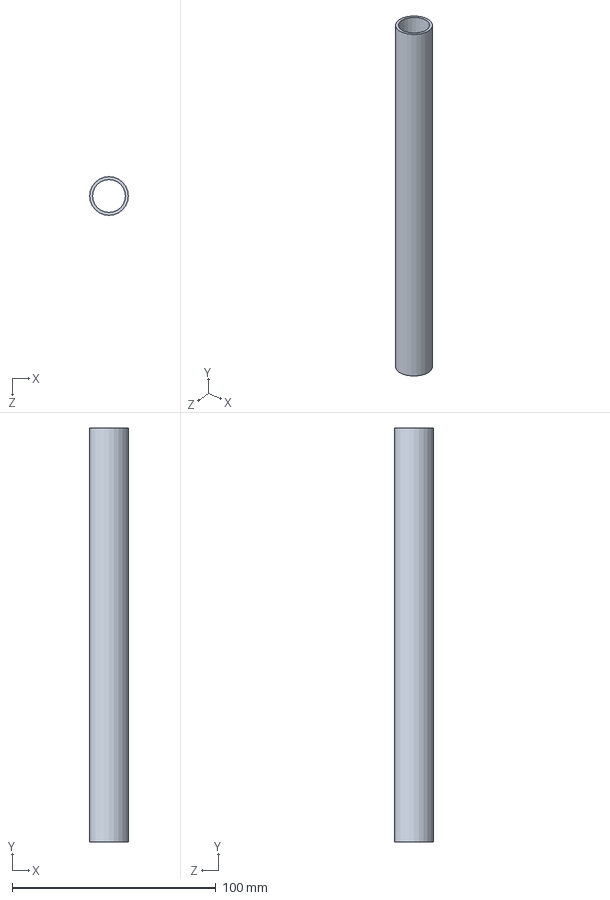
[picture p199: CAD file, 2019-09-23]
Structures/CAD/Abbas_CAD/Senior Design CAD/Plane_Assembly/Axle .75OD .634ID 6061-T6 Aluminum.sldprt
19.1 x 203.2 x 19.1 mm
