Aerothon-2020/Reg2015Aircraft_Aerocats/Structures/CAD/Abbas_CAD/Senior Design CAD/Plane_Assembly/Lower Stringer.sldprt

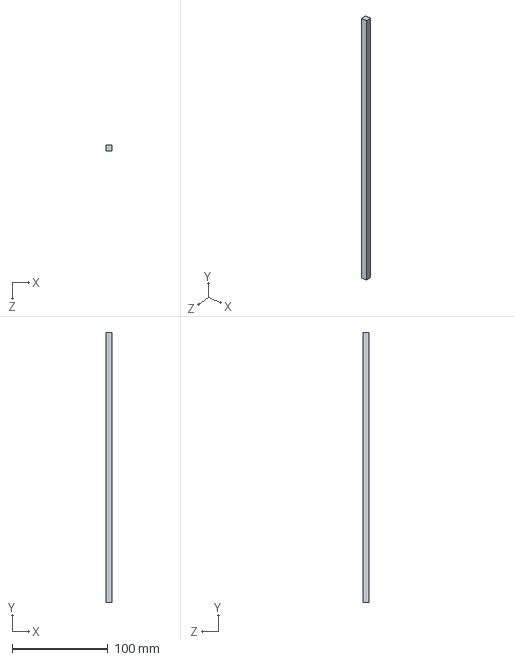
[picture p200: CAD file, 2019-09-23]
Structures/CAD/Abbas_CAD/Senior Design CAD/Plane_Assembly/Lower Stringer.sldprt
6.35 x 282.6 x 6.35 mm
