Aerothon-2020/Reg2015Aircraft_Aerocats/(list of files, cad)

Other CAD files:
Structures/CAD/Abbas_CAD/Senior Design CAD/2nd_Gen/Payload_Bay/AssemblyPAYLOAD DRAFT WITH DIMS.dxf
Structures/CAD/Abbas_CAD/Senior Design CAD/3- payload bay/625 inch payload sides.sldasm
Structures/CAD/Abbas_CAD/Senior Design CAD/Plane_Assembly/CENTER_VT_Full.sldprt
Structures/CAD/Abbas_CAD/Senior Design CAD/Plane_Assembly/horiztail2.sldasm
Structures/CAD/Abbas_CAD/Senior Design CAD/1- rectangular wing/rect ribs no cutout.dwg
Structures/CAD/Abbas_CAD/Senior Design CAD/1.5 - rectangular spar/rectangular spar top and bottom 24 inches need 4 per spar out of bass.dwg
Structures/CAD/Abbas_CAD/Senior Design CAD/2- tapered wing/tapered ribs 1 of 2 .dwg
Structures/CAD/Abbas_CAD/Senior Design CAD/2nd_Gen/HT/HTail_Ribs.dwg
Structures/CAD/Abbas_CAD/Senior Design CAD/2nd_Gen/Nick.dxf
Structures/CAD/Abbas_CAD/Senior Design CAD/2nd_Gen/VT/Side_VTs.dwg
Structures/CAD/Abbas_CAD/Senior Design CAD/3- payload bay/SEANNOT_GROUP3.sldprt
Structures/CAD/Abbas_CAD/Senior Design CAD/5- horizontal tail/htail regular ribs edited.dwg
Structures/CAD/Abbas_CAD/Senior Design CAD/6- center vt's/vertical tail center al moving.dwg
Structures/CAD/Abbas_CAD/Senior Design CAD/7- side vt's/side vertical tails ribs all moving.dwg
Structures/CAD/Abbas_CAD/Senior Design CAD/Spar_Wing_Assembly/Rectangular_connection_FOXLITE.dwg
Structures/CAD/Abbas_CAD/Senior Design CAD/Tapered_Ribs_Foxlitev2.dwg
Structures/CAD/Layouts/rect spar caps balsa need 8 for 1 spar.dwg
Structures/CAD/Abbas_CAD/Senior Design CAD/1.5 - rectangular spar/rib simulator.dwg
Structures/CAD/Abbas_CAD/Senior Design CAD/2- tapered wing/tapered ribs 2 of 2.dwg
Structures/CAD/Abbas_CAD/Senior Design CAD/3- payload bay/bottom of payload bay 625.dwg
Structures/CAD/Abbas_CAD/Senior Design CAD/5- horizontal tail/htail vert connecting ribs.dwg
Structures/CAD/Abbas_CAD/Senior Design CAD/6- center vt's/vertical tail center half moving.dwg
Structures/CAD/Abbas_CAD/Senior Design CAD/7- side vt's/side vertical tails ribs.dwg
Structures/CAD/Abbas_CAD/Senior Design CAD/Nick.dxf
Structures/CAD/Abbas_CAD/Senior Design CAD/Rectangular_Wing_Ribs/Rectangular_Ribs_Foxlite.dwg
Structures/CAD/Abbas_CAD/Senior Design CAD/Spar/Payload_Connection_FOXLITE.dwg
Structures/CAD/Abbas_CAD/Senior Design CAD/Spar_Wing_Assembly/Payload_Connection_FOXLITE.dwg
Structures/CAD/Layouts/front and back wall payload bay.dwg
Structures/CAD/Abbas_CAD/Senior Design CAD/1.5 - rectangular spar/spar cap 15 to 21 range.dwg
Structures/CAD/Abbas_CAD/Senior Design CAD/3- payload bay/SEANNOT_GROUP2.sldprt
Structures/CAD/Abbas_CAD/Senior Design CAD/5- horizontal tail/30 deg angled ht airfoil.dwg
Structures/CAD/Abbas_CAD/Senior Design CAD/Spar/Rectangular_connection_FOXLITE.dwg
Structures/CAD/Layouts/625 inch payload box DRG.dwg
Structures/CAD/Abbas_CAD/Senior Design CAD/1.5 - rectangular spar/last rect section spar caps need 4 balsa up and down grain.dwg
Structures/CAD/Abbas_CAD/Senior Design CAD/2nd_Gen/Payload_Bay/PAYLOAD DRAFT WITHOUT DIMS.dxf
Structures/CAD/Abbas_CAD/Senior Design CAD/3- payload bay/SEANNOT_GROUP4.sldprt
Structures/CAD/Layouts/rectangular spar top and bottom 24 inches need 4 per spar out of bass.dwg
Structures/CAD/Abbas_CAD/Senior Design CAD/1.5 - rectangular spar/spar cap center make from eigth liteply need qty 2.dwg
Structures/CAD/Abbas_CAD/Senior Design CAD/3- payload bay/SE.sldprt
Structures/CAD/Layouts/WEIGHT HANGAR FINAL.dwg
Structures/CAD/Abbas_CAD/Senior Design CAD/1.5 - rectangular spar/rect spar caps balsa need 8 for 1 spar.dwg
Structures/CAD/Abbas_CAD/Senior Design CAD/3- payload bay/front and back wall payload bay.dwg
Structures/CAD/Layouts/spar cap center make from eigth liteply need qty 2.dwg
Structures/CAD/Abbas_CAD/Senior Design CAD/3- payload bay/SEANNOT_GROUP1.sldprt
Structures/CAD/Abbas_CAD/Senior Design CAD/Plane_Assembly/CENTER_VT_WithSlot.sldprt
Structures/CAD/Layouts/bottom of payload bay 625.dwg
Structures/CAD/Abbas_CAD/Senior Design CAD/3D tapered wing and ceter vt/Center_VT_strips_Spar.sldprt
Structures/CAD/Abbas_CAD/Senior Design CAD/Plane_Assembly/CENTER_VT_MovingHalf.sldprt
Structures/CAD/Layouts/last rect section spar caps need 4 balsa up and down grain.dwg
Structures/CAD/Layouts/spar cap 15 to 21 range.dwg
Structures/CAD/Abbas_CAD/Senior Design CAD/Plane_Assembly/Center_VT_strips_Front.sldprt
Structures/CAD/Abbas_CAD/Senior Design CAD/Plane_Assembly/CENTER_VT_FrontHalf.sldprt
Structures/CAD/Abbas_CAD/Senior Design CAD/Plane_Assembly/Center_VT_strips_Spar_middle.sldprt
Structures/CAD/Abbas_CAD/Senior Design CAD/Plane_Assembly/Center_VT_strips_Spar_top.sldprt
Structures/CAD/Abbas_CAD/Senior Design CAD/Plane_Assembly/wheel 4OD 1.625ID.sldprt
Structures/CAD/Abbas_CAD/Senior Design CAD/Plane_Assembly/3D_Rect_Rib.sldprt
Structures/CAD/Abbas_CAD/Senior Design CAD/Plane_Assembly/Center_VT_strips_tube.sldprt
Structures/CAD/Abbas_CAD/Senior Design CAD/Plane_Assembly/Bottom_Part.sldprt
Structures/CAD/Abbas_CAD/Senior Design CAD/Plane_Assembly/TailSide1ANSI.sldprt
Structures/CAD/Abbas_CAD/Senior Design CAD/Plane_Assembly/Shear Web.sldprt
Structures/CAD/Abbas_CAD/Senior Design CAD/2nd_Gen/Rect_Wing/Para.x_t
Structures/CAD/Abbas_CAD/Senior Design CAD/3- payload bay/625 inch payload sides.dwg
Structures/CAD/Abbas_CAD/Senior Design CAD/3- payload bay/625 inch payload sides.sldprt
Structures/CAD/Abbas_CAD/Senior Design CAD/Landing Gear/.75X1.625X.5 Bearing (2).IGS
Structures/CAD/Abbas_CAD/Senior Design CAD/Landing Gear/_75X1.625X.5 Bearing (2).IGS
Structures/CAD/Payload_Box/base pin washers payload bay.igs
