Aerothon-2020/Reg2015Aircraft_Aerocats/Treasurer Files/Travel Documents/Driving Certs and Rental Information/How to Get Your Defensive Driving Certificate.docx

How to Get Your Defensive Driving Certificate

1. Go to: http://ehs.uc.edu/itc/

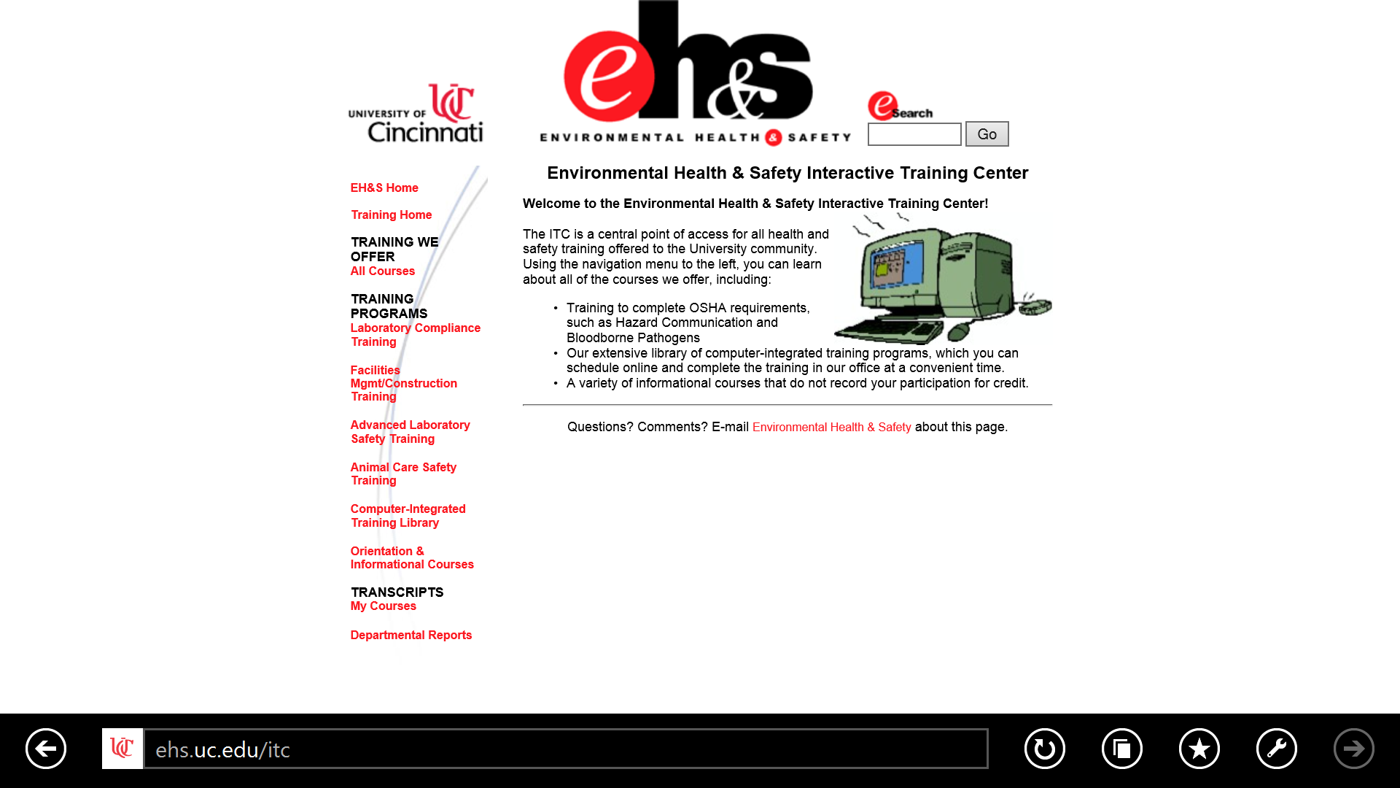
[picture p201: figure]

2. Click “All Courses”

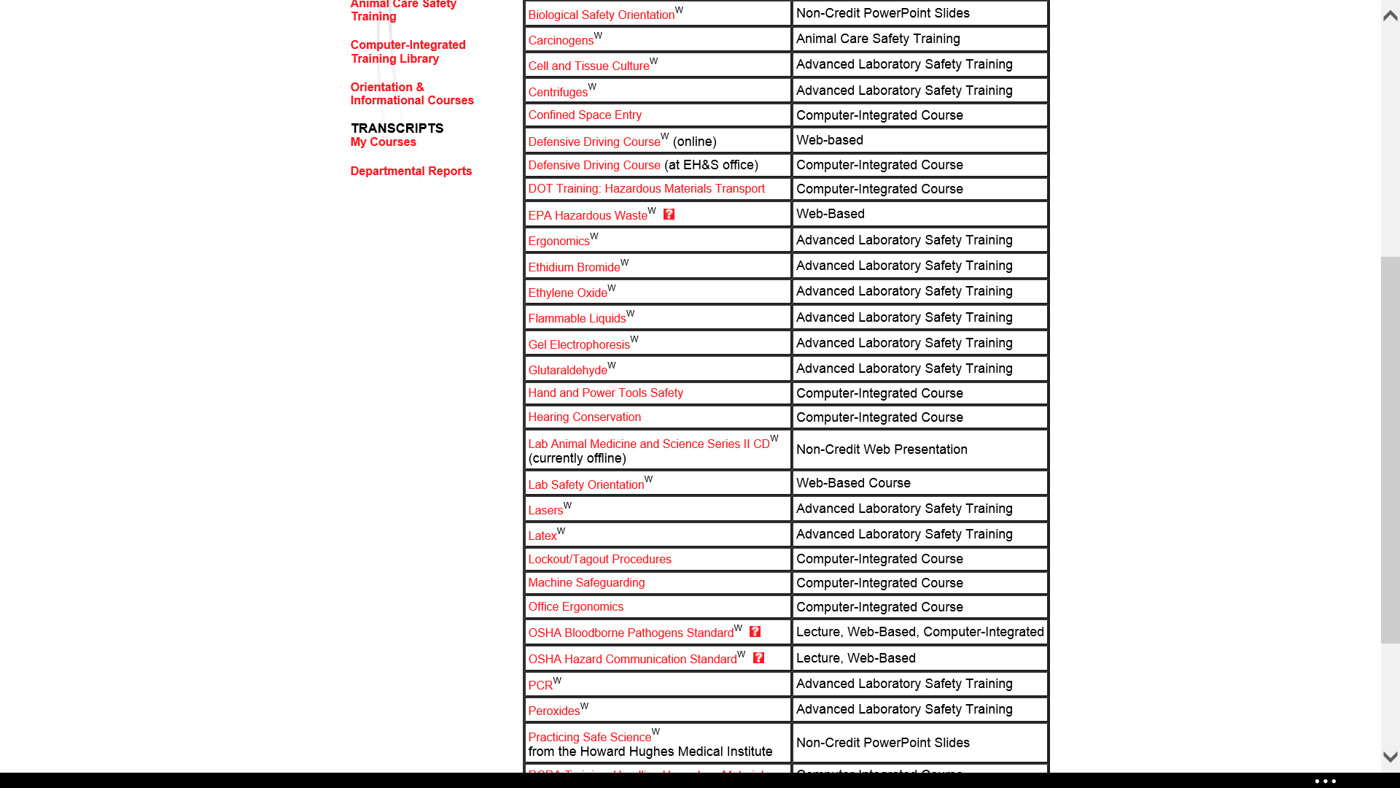
[picture p202: figure]

3. Click “Defensive Driving”

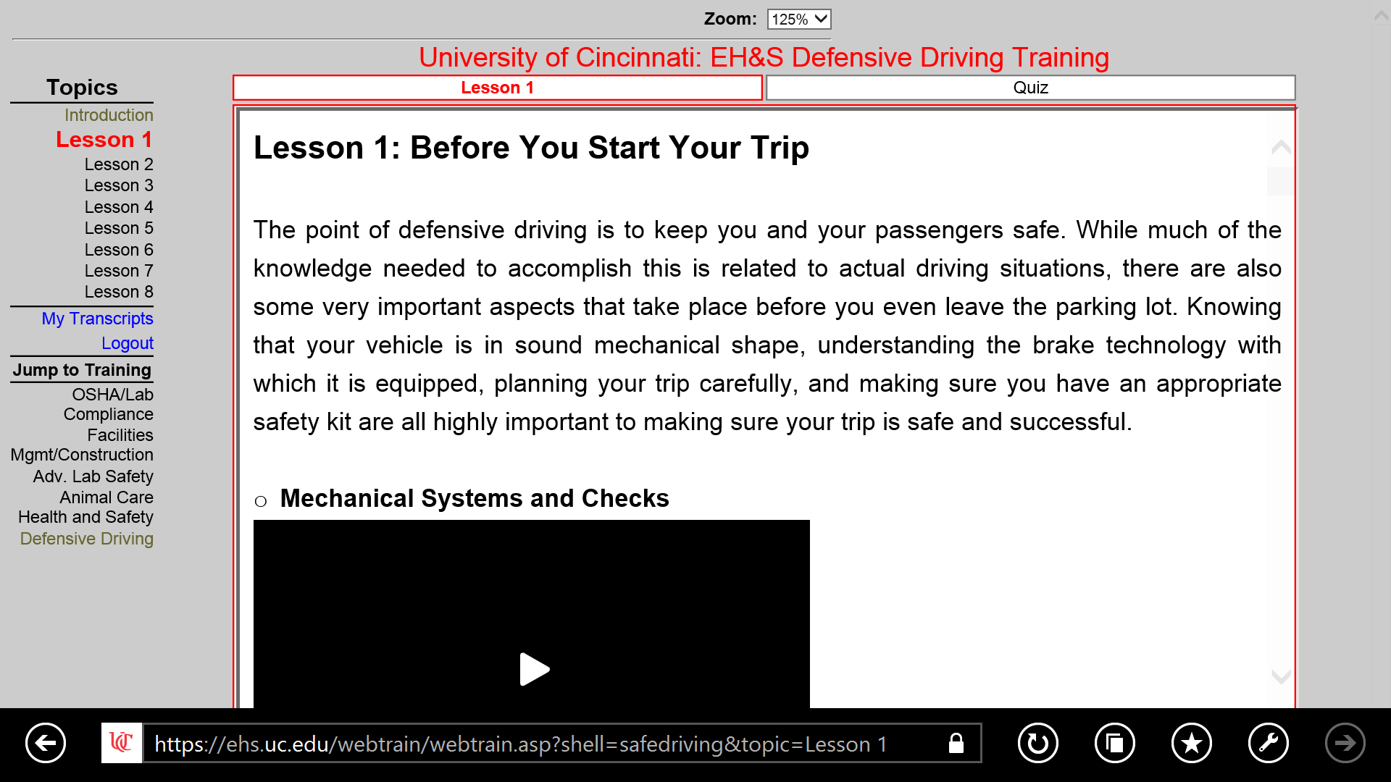
[picture p203: figure]

4. You will have to log in and then be directed to a screen like this. Click the “Defensive Driving” Button and complete the information on screen. Then, complete all lessons and quizzes.

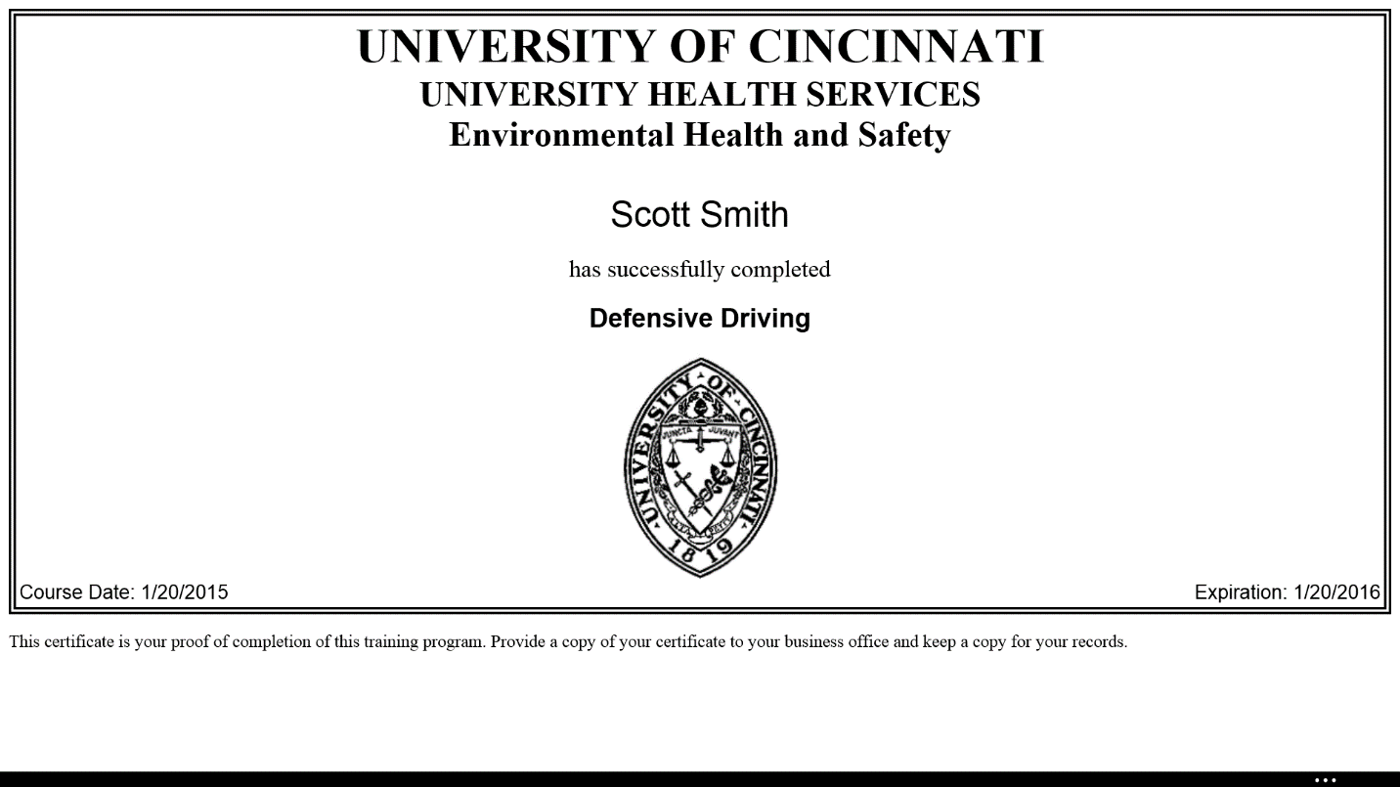
[picture p204: figure]

5. Once completed, Print 2 copies of your certificate. Keep one in safe place and give the other to the Treasurer. This is required if you plan on being a driver!
