Aerothon-2020/Reg2015Aircraft_Aerocats/Treasurer Files/Swag/_solid_assembly.pdf

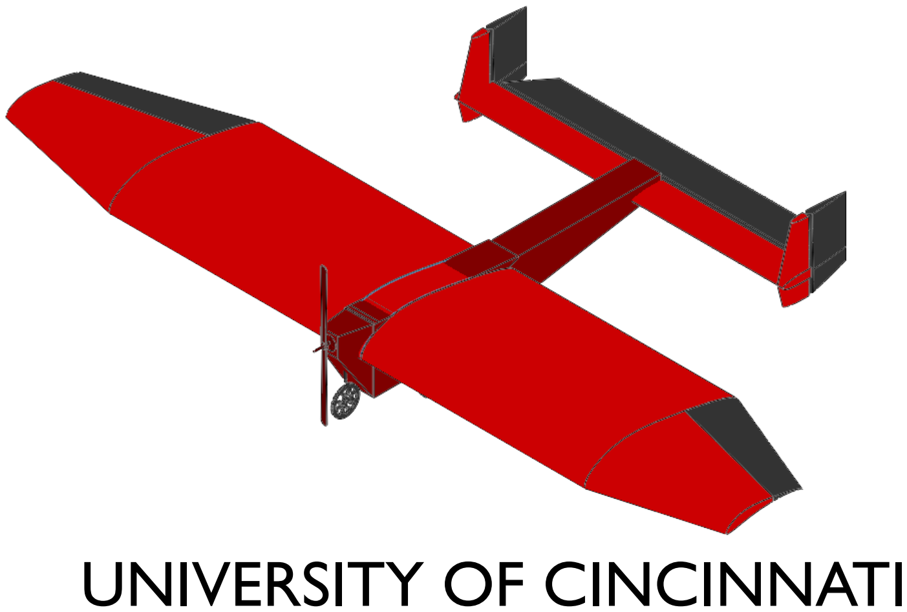
[picture p205: page 1]

UNIVERSITY OF CINCINNATI
