Aerothon-2020/Reg2015Aircraft_Aerocats/Report_PostSubmission/7_Assembly and Subassembly Test and Integration/4_subassemblies_SECTION 7.PNG

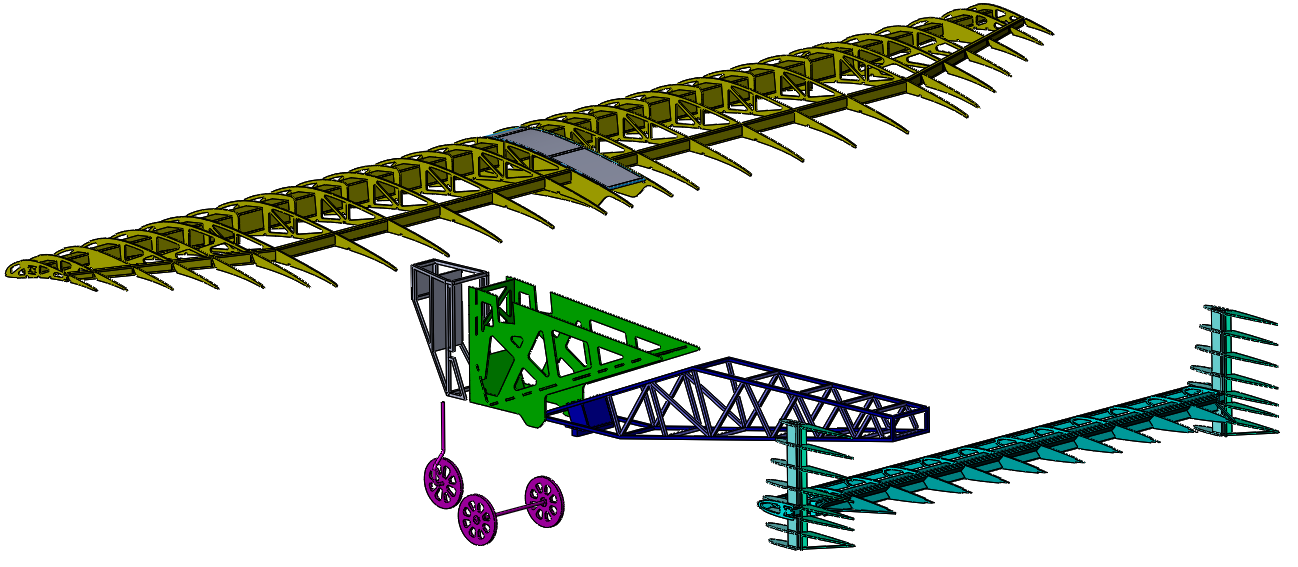
Report_PostSubmission/7_Assembly and Subassembly Test and Integration/4_subassemblies_SECTION 7.PNG
