Aerothon-2020/Reg2015Aircraft_Aerocats/Report_PostSubmission/8_Manufacturing/Aft-Fuselage.jpg

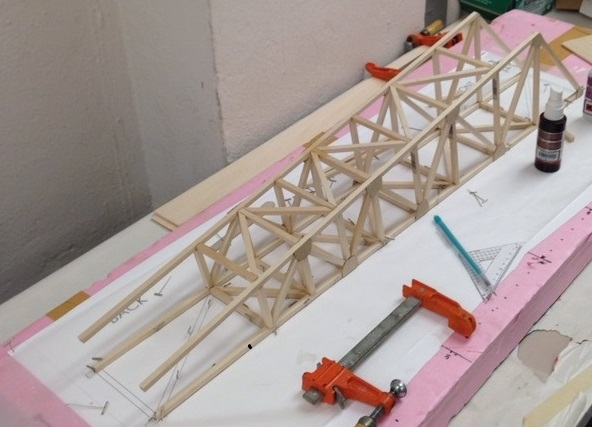
Report_PostSubmission/8_Manufacturing/Aft-Fuselage.jpg
