Aerothon-2020/Reg2015Aircraft_Aerocats/Report_PostSubmission/8_Manufacturing/Scarf Joint.PNG

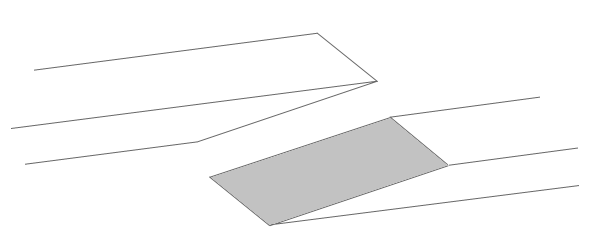
Report_PostSubmission/8_Manufacturing/Scarf Joint.PNG
