Aerothon-2020/Reg2015Aircraft_Aerocats/Report_PostSubmission/8_Manufacturing/Wheel.JPG

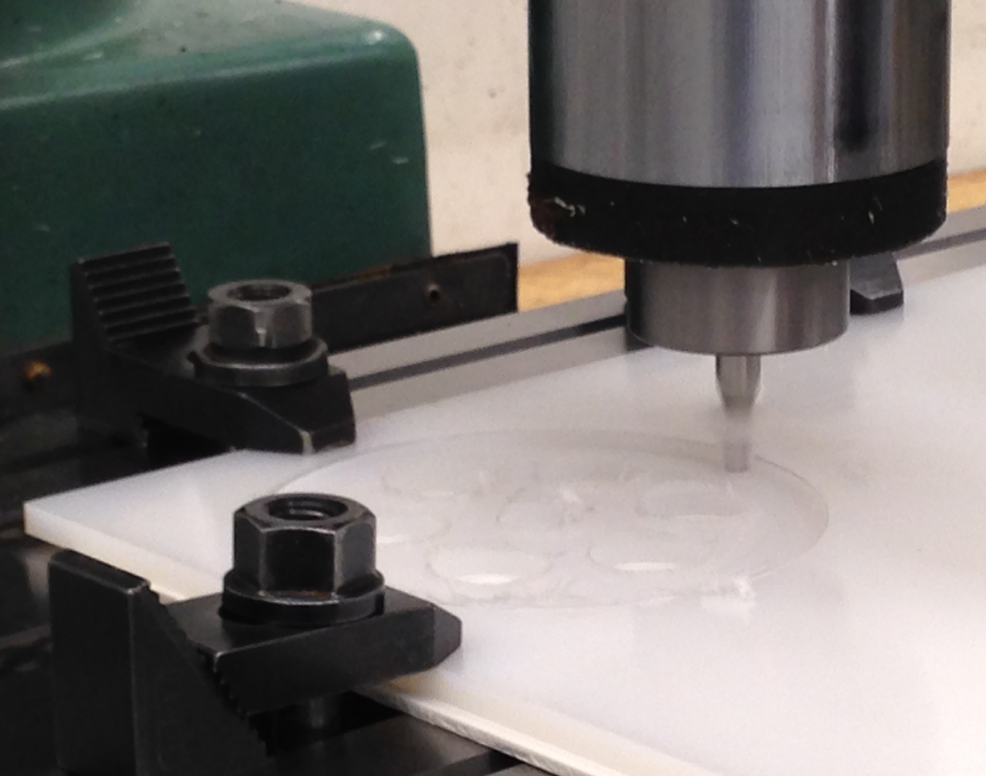
Report_PostSubmission/8_Manufacturing/Wheel.JPG
