Aerothon-2020/Reg2015Aircraft_Aerocats/Propulsion/Class Updates/2014-09-17_Propulsion_Initial_Test_Plans.pptx

## Propulsion Initial Test Plans

Results of Team Meeting on 9/15/2014

## Overall Direction

- Thrust over RPM range is ultimate metric
- Find our initially sized best prop
  - Leverage last years sizing to develop matrix
- Match a motor through testing – most thrust
- Sizing constraints:
  - Length
  - Power Draw

## Propeller Testing

- APC – “E” & Carbon Fiber (only a few Composite)
- Goals
  - Find max thrust
  - Develop relationships
    - Thrust vs. Pitch & Length
    - Power vs. Pitch & Length

Lengths | Pitch
17 | 8 | 10 | 12
18 | 8 | 10 | 12
20 | 6 | 8 | 10
22 | | | 10

## Motor Testing

- Take Propeller from testing, find max thrust with propeller for motor
  - Assumes that best prop will remain best prop on motor
  - Restriction is power required to drive

## Limiter Testing

- Temperature functionality of limiter
  - Limiter on test bench; heat gun and freezer testing
- Understand functionality of limiter
  - Hard cut or true limiter?

## Purchase List

Item | Count | Total Cost
Plastic Prop | ~10 | $120
Composite Prop | 3 | $140
Motors | 4 | $600
Limiters | 4 | $200
Speed Controller | ? | ?
Batteries | ? | ?
| | $1,060

## Go-Forward Activities

- PENDING: Purchasing upon receiving funding
- ACTIVE:
  - Get test bench running and ready for when parts come in
    - Need someone who knows how to run it to teach us
