Aerothon-2020/Reg2015Aircraft_Aerocats/Propulsion/ThrustScaleCalibration.xlsx

Ohaus CS Series [oz] | Fish Scale [oz]
99.8 | 100
120.5 | 120
123 | 123
77.3 | 77
