Aerothon-2020/Reg2015Aircraft_Aerocats/Report_PostSubmission/6_Analysis/Wing Deflection Test Rev 1.png

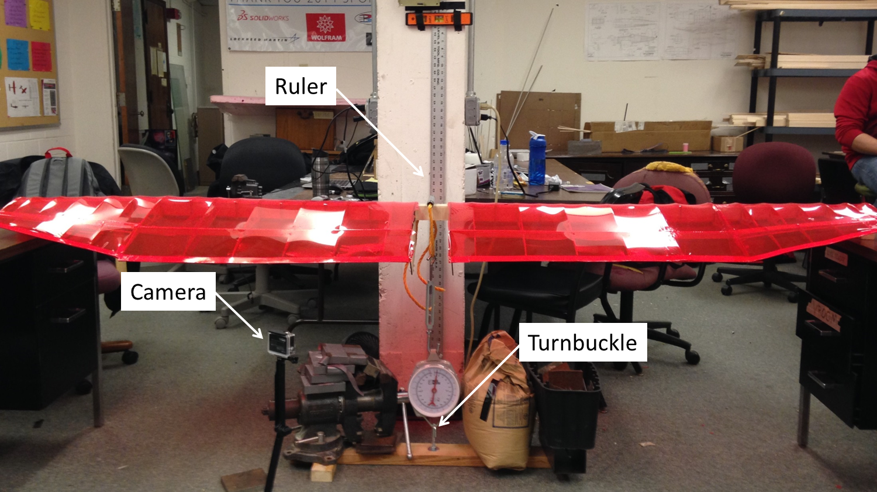
Report_PostSubmission/6_Analysis/Wing Deflection Test Rev 1.png
