Aerothon-2020/Reg2015Aircraft_Aerocats/Documents/Aerocats 2014 Lessons Learned.pptx

## Aerocats 2014 Lessons Learned

## General Advice from Abbas

- Test propulsion system ASAP with advice on the proper ESC from Santiago
- Talk to each other
- Fly the plane (2014’s) as soon as possible to familiarize ourselves with how things plug in and operate
- Nathaniel Richards helped out with building a lot. Use him.
- Set and use a schedule for Design and Building hours and stick to it.
- Andre - go to Foxlite and pick their brain about CAD things. They help to simplify designs
- Integrate CAD and structures since they interact a lot
- Practice monokoting on one of their airplanes since we’ll end up breaking things eventually

## Design Improvements from Abbas

- Connection plate between wing and payload bay
- Improve motor bulkhead and nose structure
- Under-design structures during prototypes to see if we can get away with lighter woods
- Inspection – go last. Inspectors will be tired
- One piece wing
- Receiver battery switch

## Advice from Nick Schwartz

- Do propulsion testing
- KISS
- Ailerons were too big
- Stability since scoring is a summation of rounds. Talk to Santiago about how the airplane handles (i.e., removing an inch from tail may make a HUGE difference for SnC but quite a bit less for lift if that inch were added to span).
- Read the final report. It has lots of insight. They didn’t do this last year prior to designing things

## Slide 5

- Andy? Anything additional that I missed that was not in the emails?
- Find Nathaniel
- Need help figuring out how to do an engine run
