Aerothon-2020/Reg2015Aircraft_Aerocats/Structures/CAD/Abbas_CAD/Senior Design CAD/Surfacing/2D_Surfacing.pdf

# University of Cincinnati

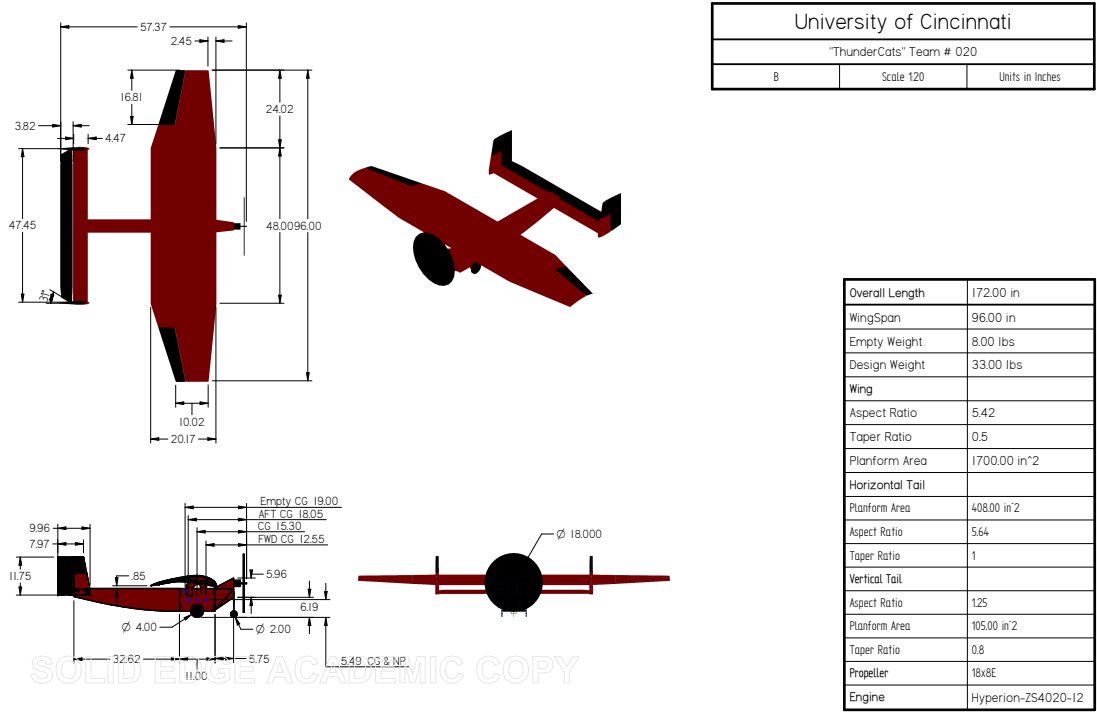
[picture p213: page 1]
"ThunderCats" Team # 020; Scale 1:20; Units in Inches; Aspect Ratio; FWD CG 12.55; AFT CG 18.05; Empty CG 19.00

Overall Length | 172.00 in
WingSpan | 96.00 in
Empty Weight | 8.00 lbs
Design Weight | 33.00 lbs
Wing
Aspect Ratio | 5.42
Taper Ratio | 0.5
Planform Area | 1700.00 in^2
Horizontal Tail
Planform Area | 408.00 in^2

Taper Ratio | 1
Vertical Tail
Aspect Ratio | 1.25
Planform Area | 105.00 in^2
Taper Ratio | 0.8
Propeller | 18x8E
Engine | Hyperion-ZS4020-12
