Aerothon-2020/Reg2015Aircraft_Aerocats/Treasurer Files/Swag/Aerocats LOGO_onBlack_FINAL PRINT_012515.pdf

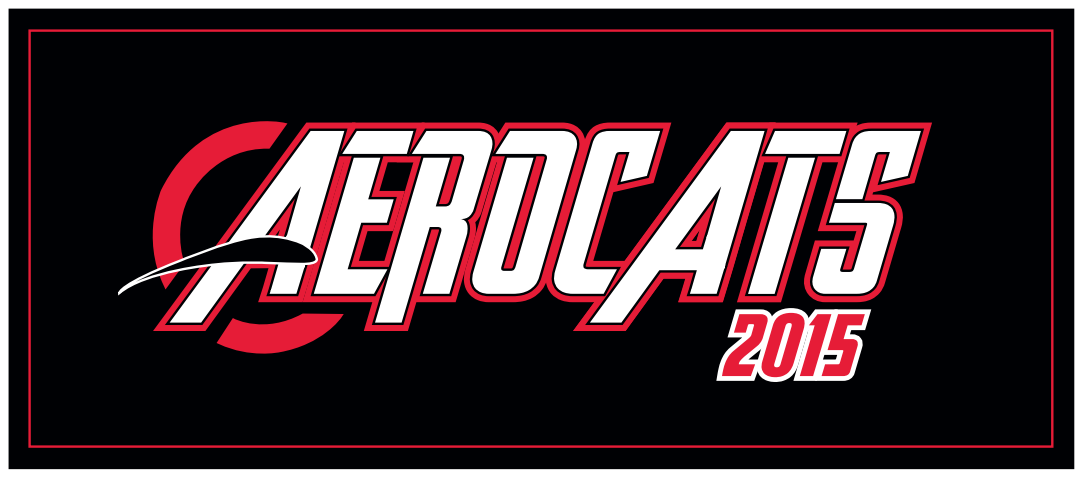
[picture p214: page 1]
