Aerothon-2020/Reg2015Aircraft_Aerocats/MonoWing/plot.pdf

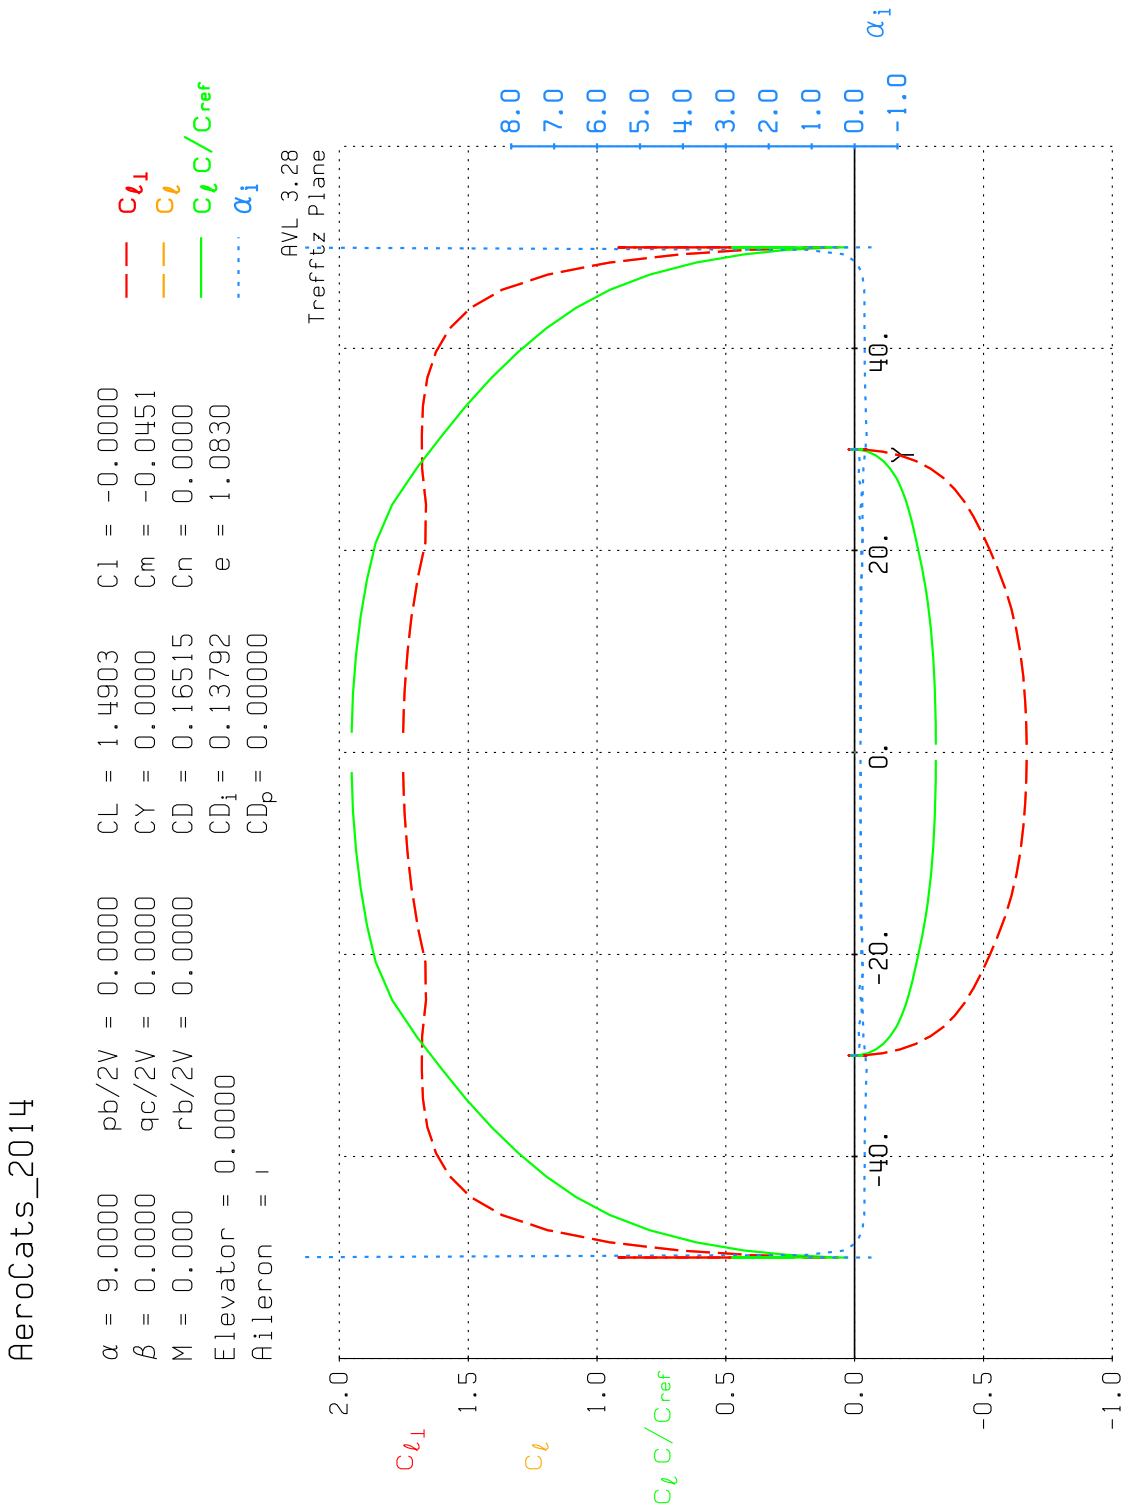
[picture p215: page 1]
