Aerothon-2020/Reg2015Aircraft_Aerocats/TradeStudies/Winglet_Study/No_Winglets_AC_Aero.pdf

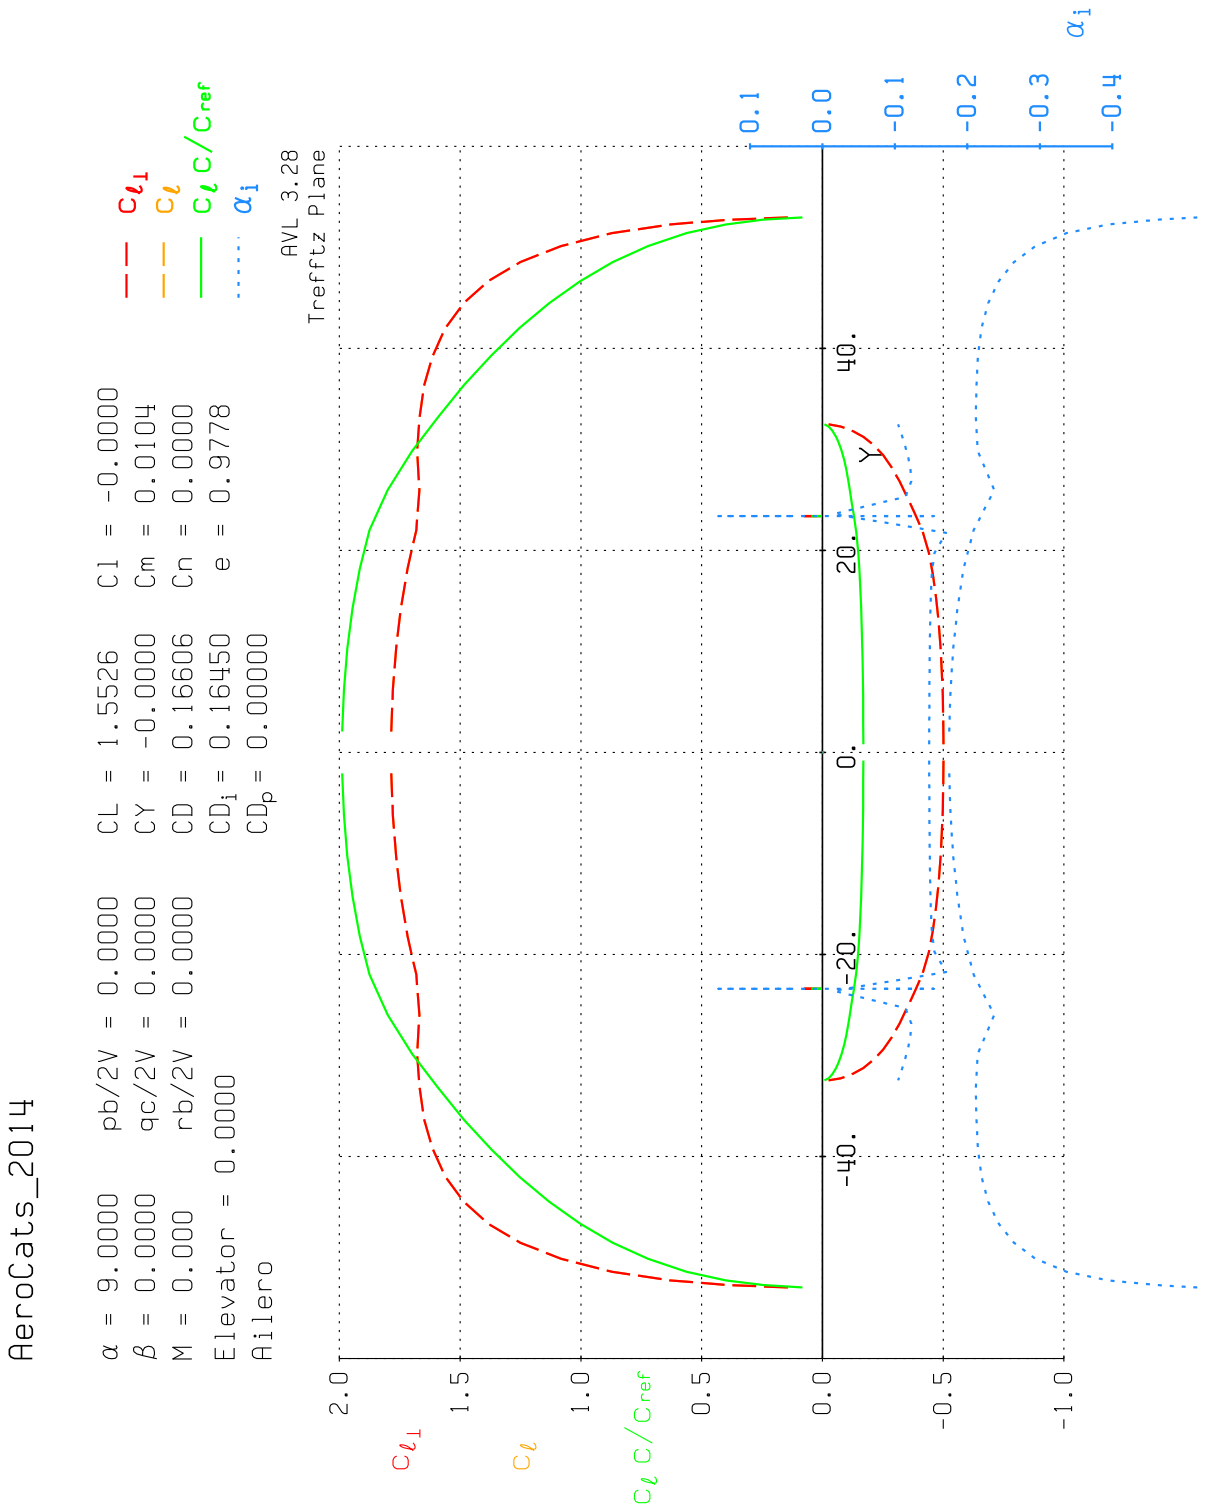
[picture p216: page 1]
