Aerothon-2020/Reg2015Aircraft_Aerocats/TradeStudies/Winglet_Study/No_Winglets_AC_Plot.pdf

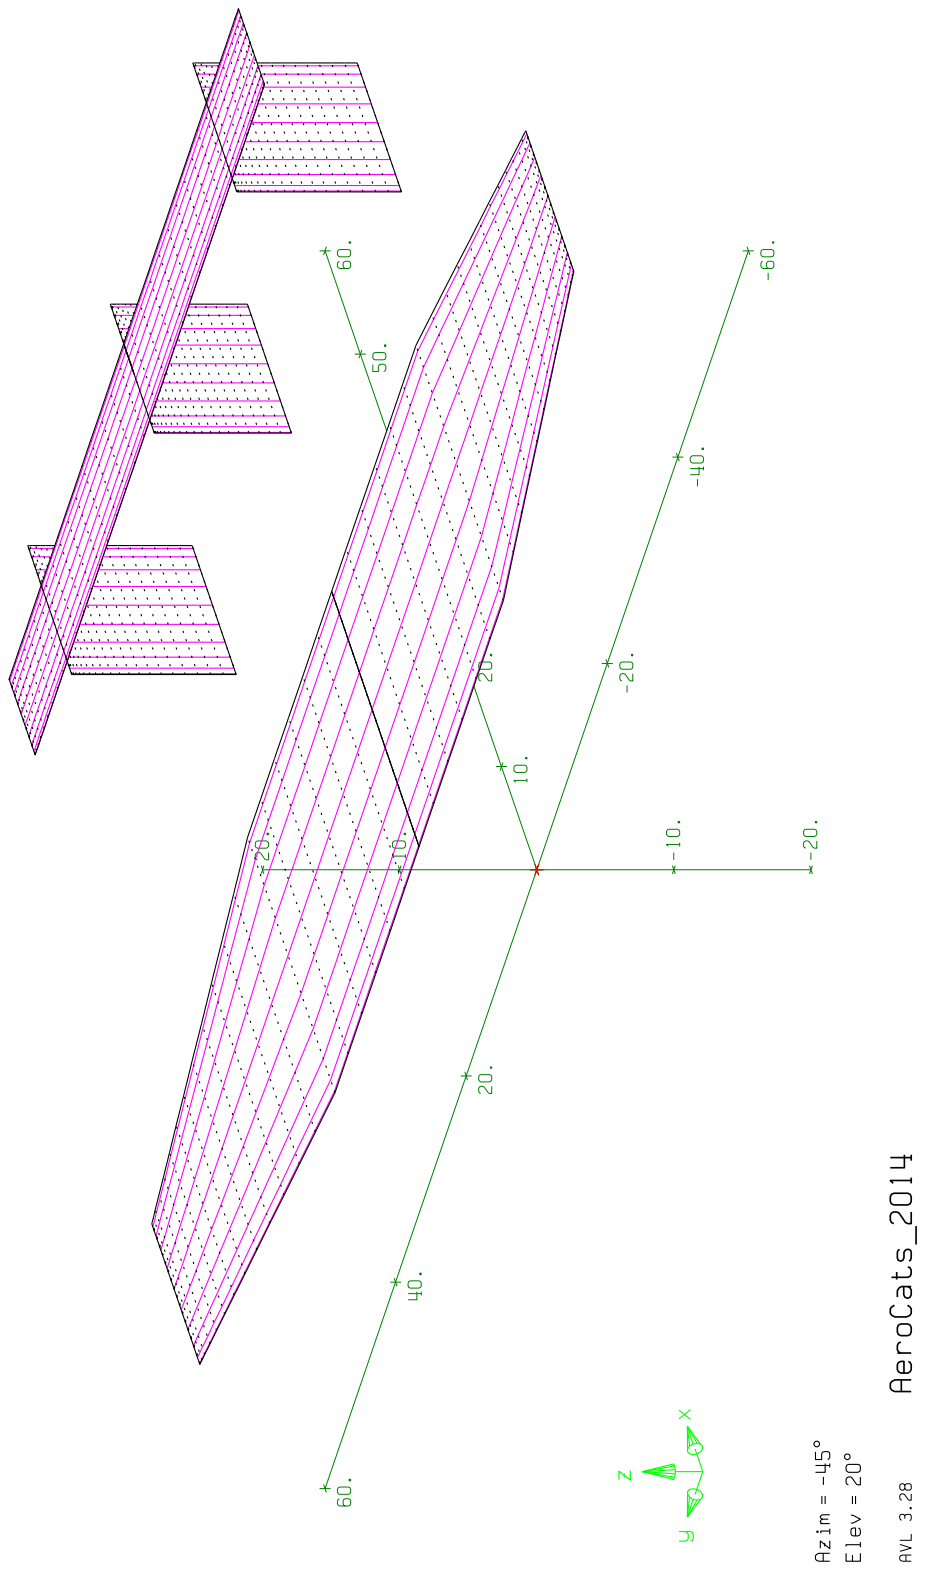
[picture p217: page 1]
