Aerothon-2020/Reg2015Aircraft_Aerocats/TradeStudies/Winglet_Study/Winglets_AC_Aero.pdf

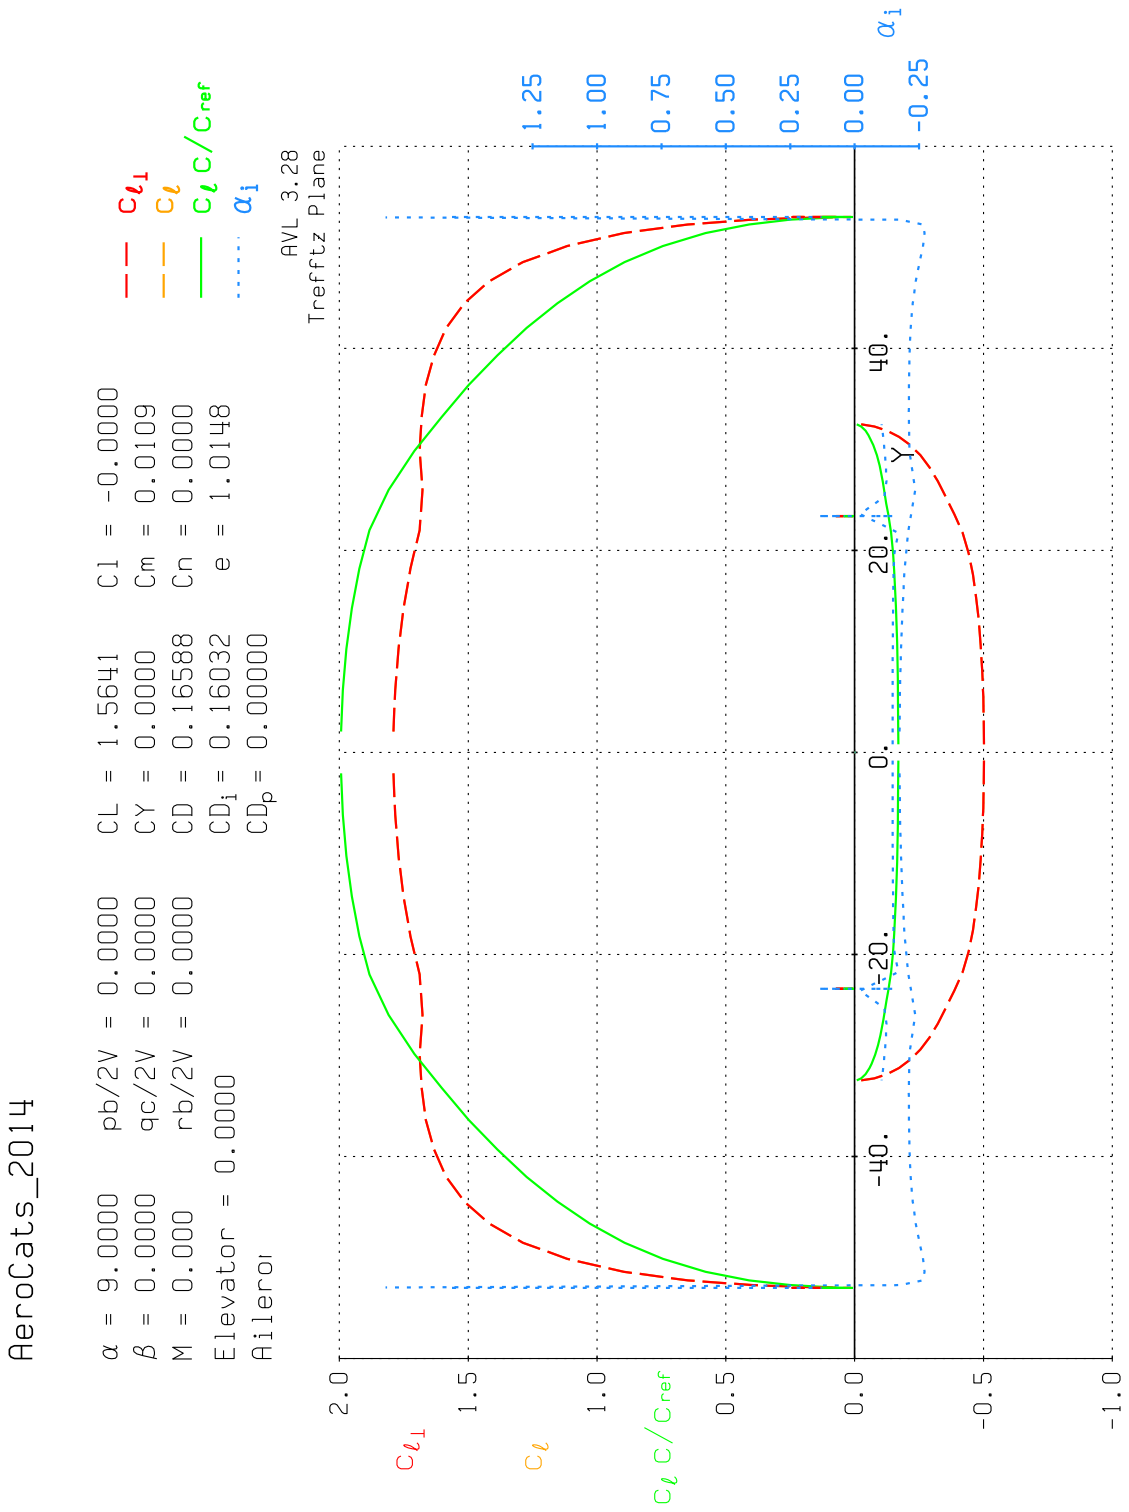
[picture p218: page 1]
