Aerothon-2020/Reg2015Aircraft_Aerocats/TradeStudies/Winglet_Study/Winglets_AC_Plot.pdf

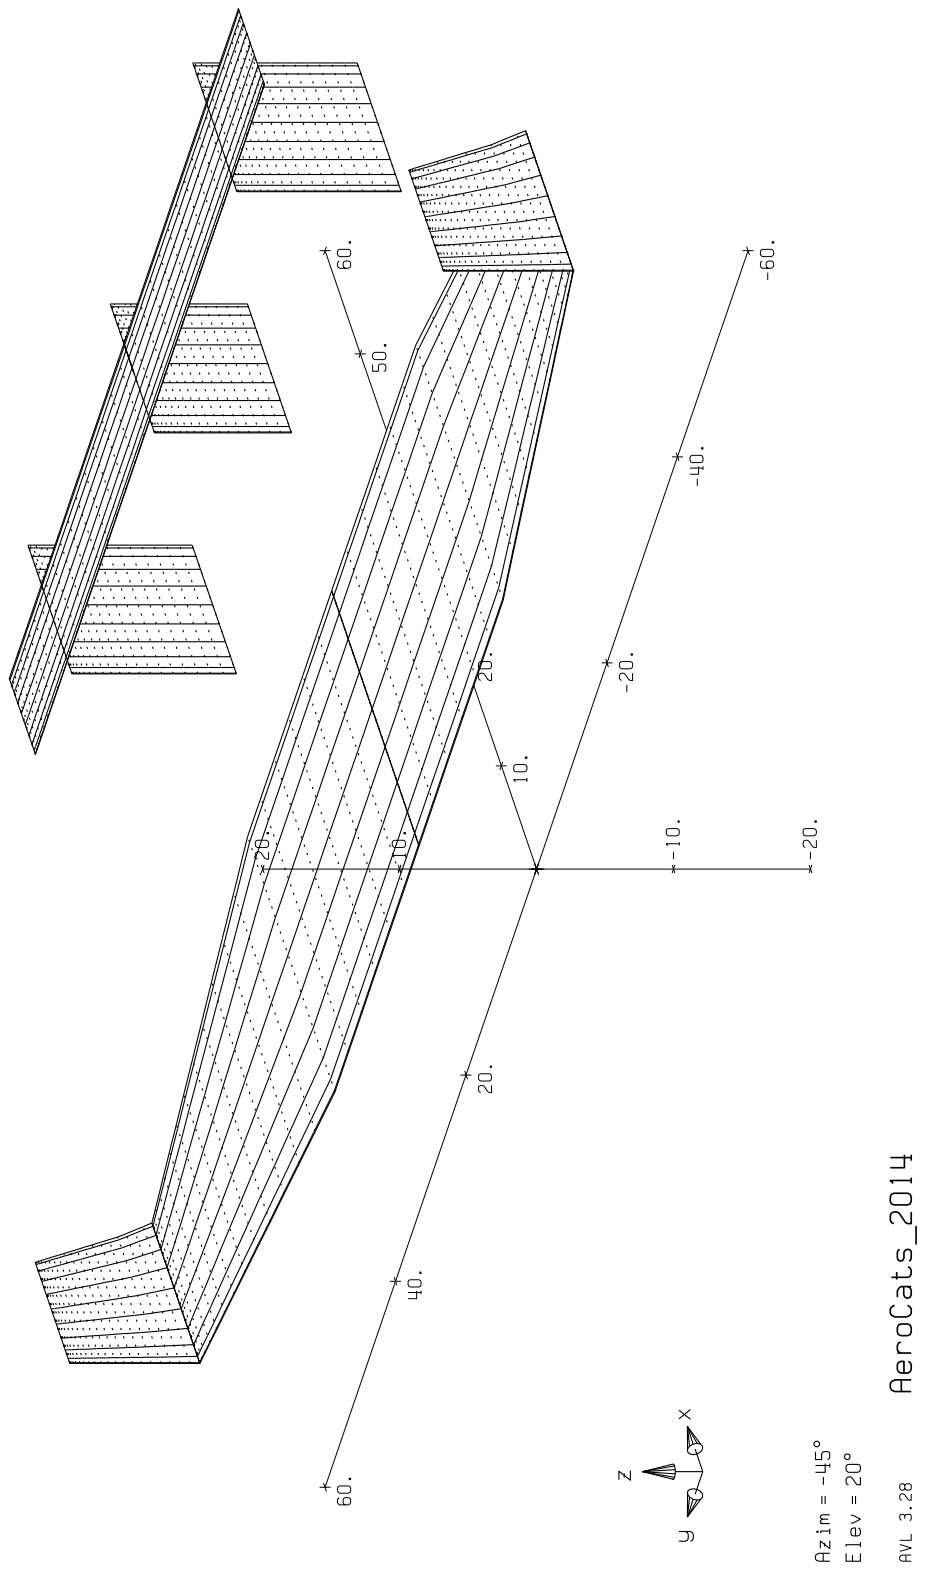
[picture p219: page 1]

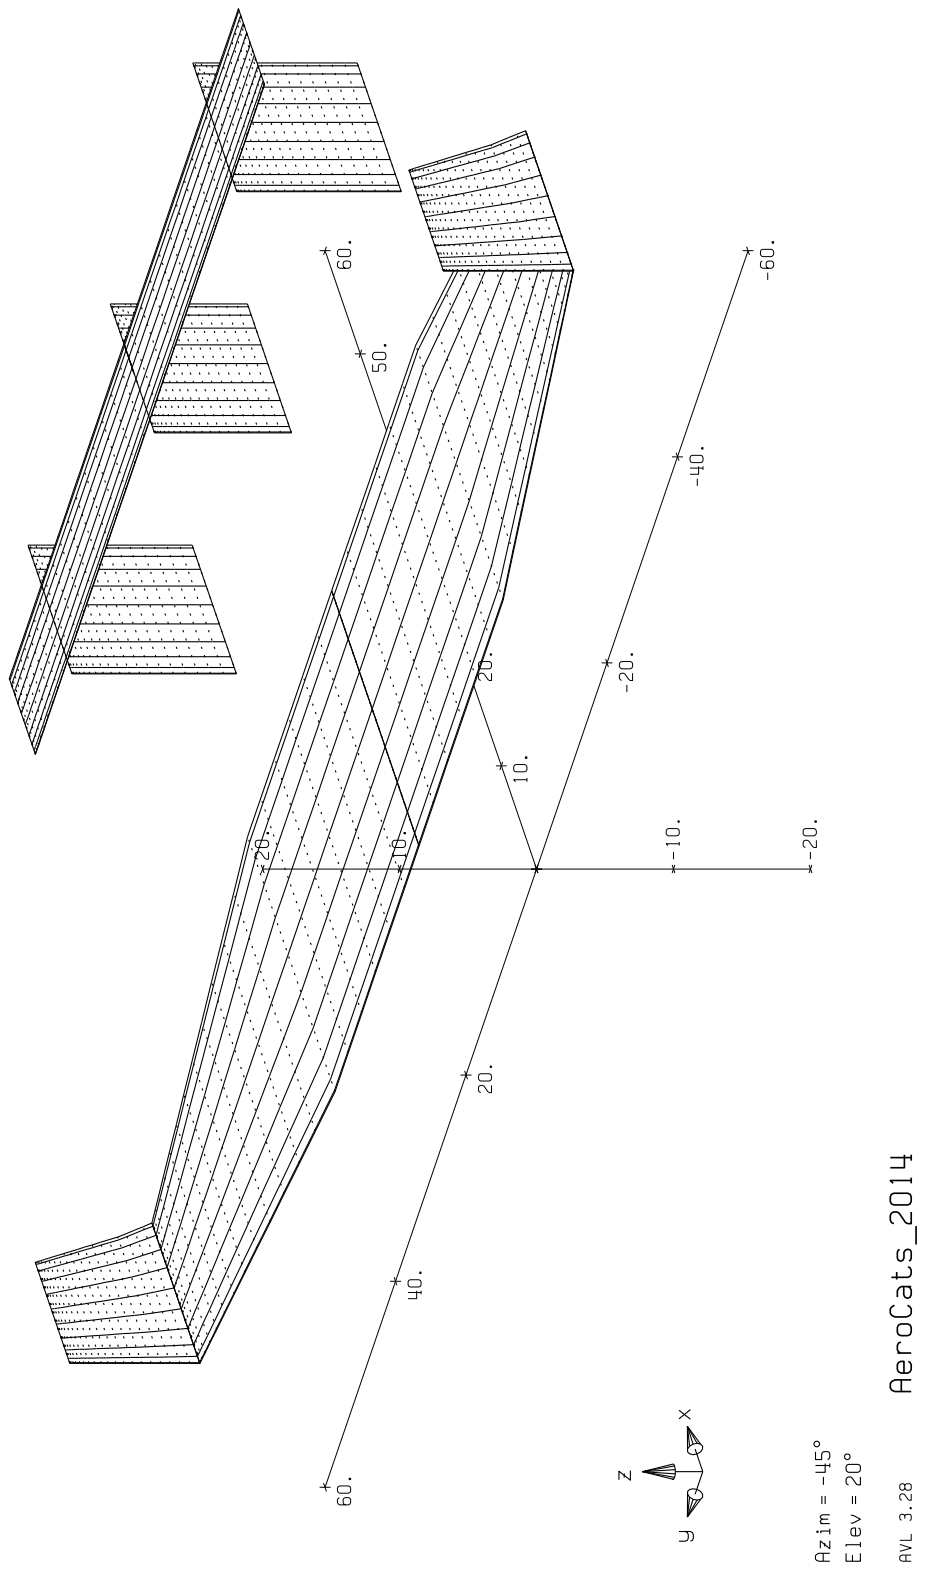
[picture p220: page 2]
